mark69163/prodigy/Meetings/img/CarSensors-Art.webp

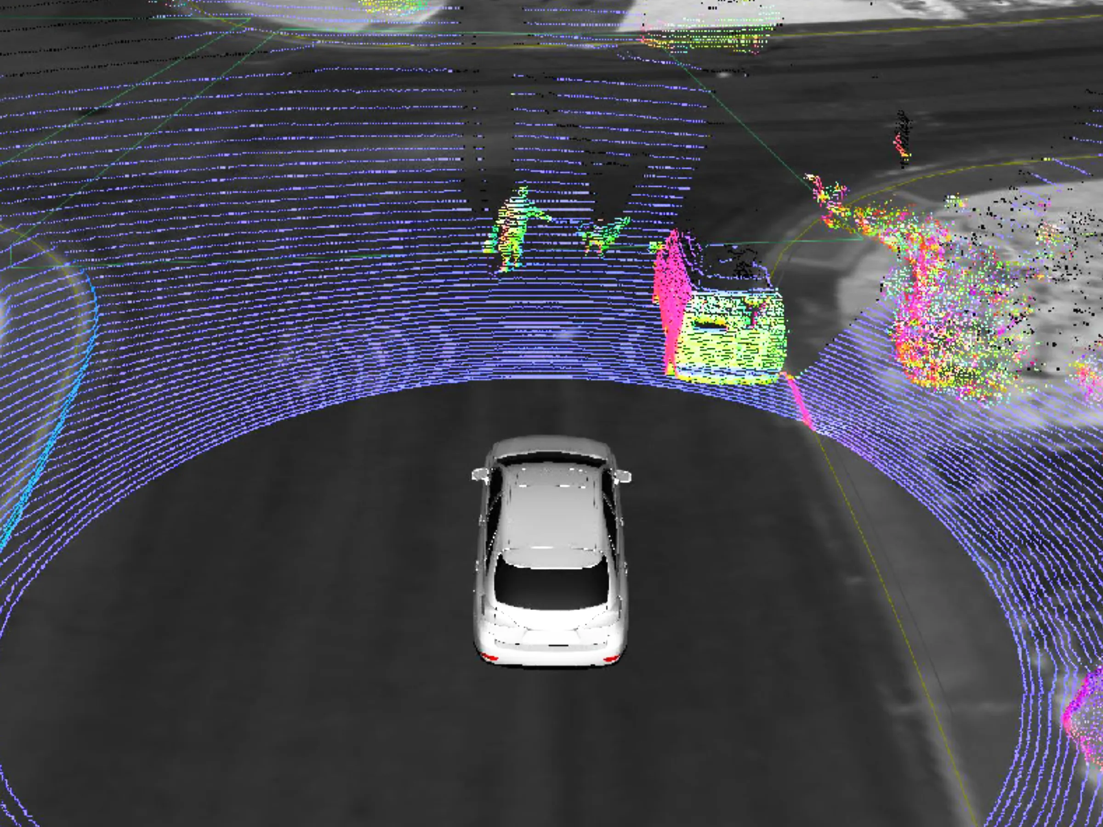
Meetings/img/CarSensors-Art.webp
