mark69163/prodigy/Meetings/img/expe_04.jpg

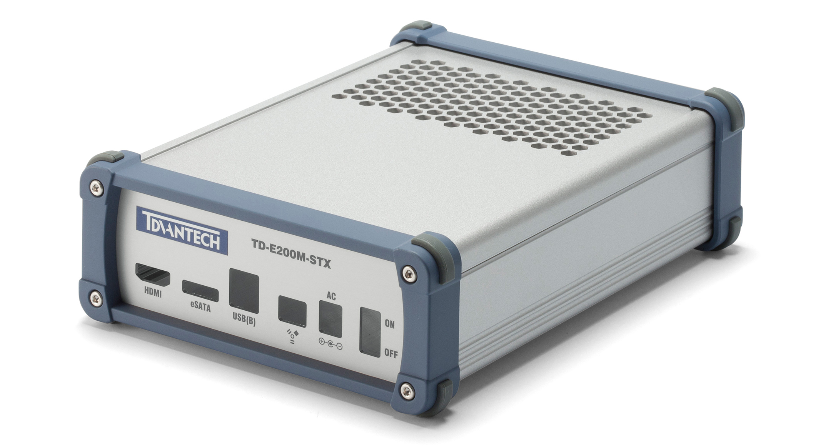
Meetings/img/expe_04.jpg
