mark69163/prodigy/Meetings/konzultacio_1.pptx

- Hardware látványterv és komponens szelekció

- PRODIGY oktatói panel
- 1. Konzultáció

Kovács Márk - Mérnökinformatikus

## 0. Agenda

1. Célkitűzés
2. Blokk diagram
3. Tervezési alapelvek
4. Komponens pozíciók
5. Időterv
6. Költségterv
7. Gyártás/rendelési info
8. Megjegyzések

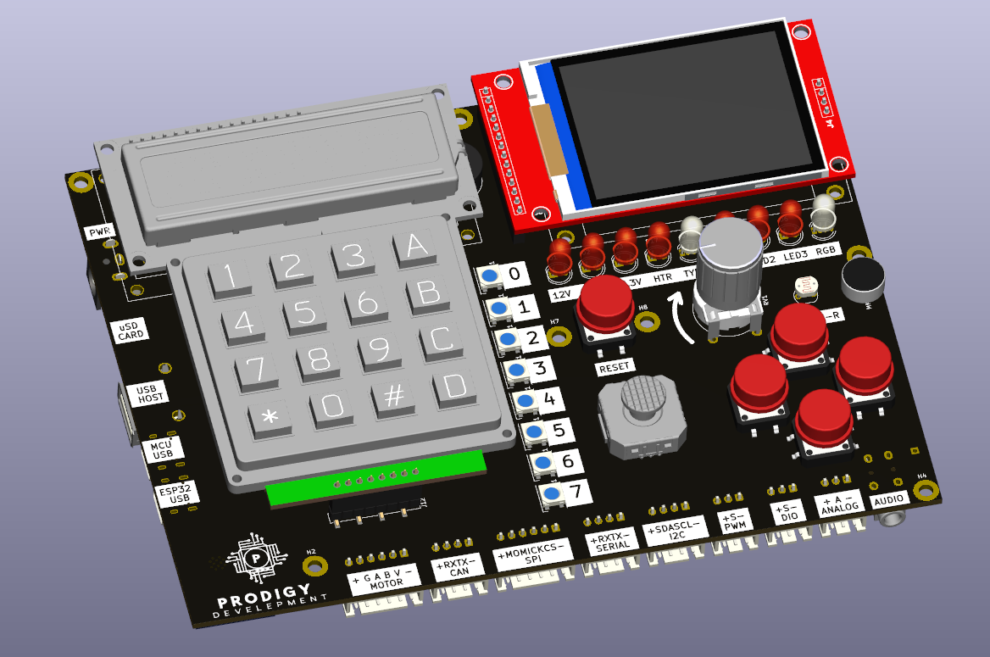
[picture p3: figure]

## 1. Célkitűzés

- Moduláris beágyazott rendszer fejlesztői platform
- Megbízhatóság, hallgató-barát kezelhetőség és biztonság
- B.sC. Szinten szükséges perifériák, interfészek, protokollok tesztelhetősége
- Új tanananyag tematika és megvalósítható projektek kidolgozása

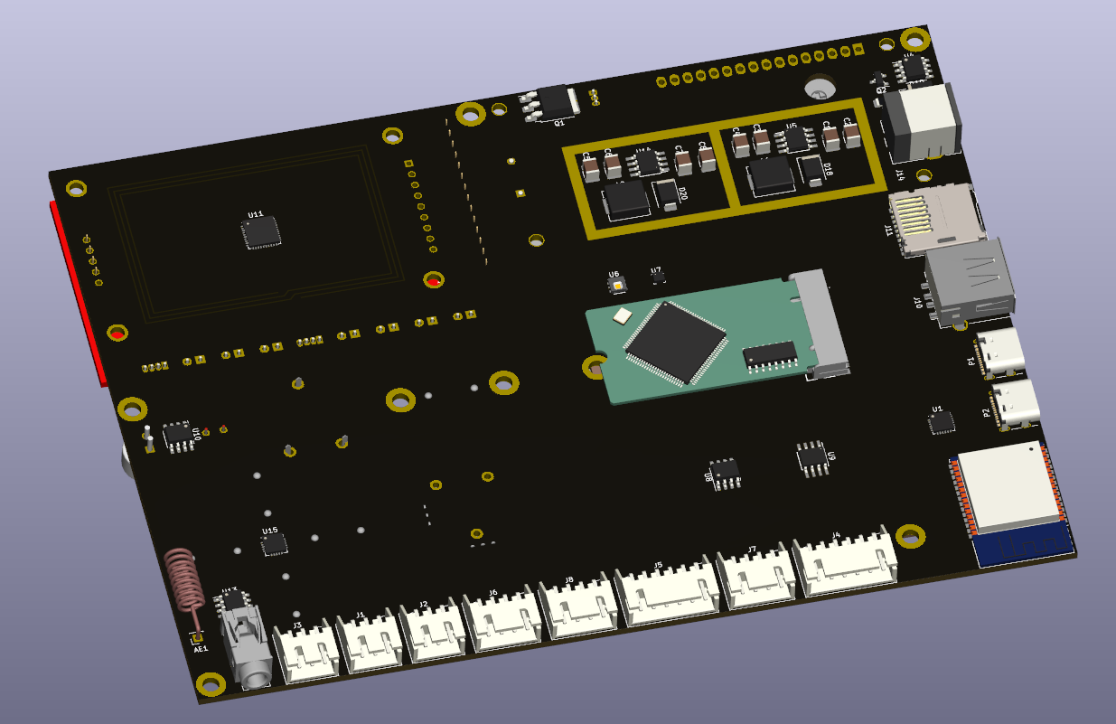
[picture p4: figure]

## 2. Blokk diagram

SPI

I²C

RADIO

TEMP.

LCD

OUTPUT

SERIAL

ESP32

USB-TTL

OUTPUT

64/52 PIN

MCU

SPECIAL

USB HOST

CAN_OUT

NEOPIXEL

MOTOR

DIGITAL

KEYPAD / BUTTON

LED

TEMP /
BUZZER

PWM / D
OUTPUT

ANALOG

POT.

LIGHT

SOUND

TEMP.
PID

OUTPUT

NFC

uSD

TFT SCREEN

ACCEL / GYRO

OUTPUT

4 PIN

2 PIN

23 PIN

5 PIN

9 PIN

9 PIN

## 4. Komponens pozíciók

BUZZER

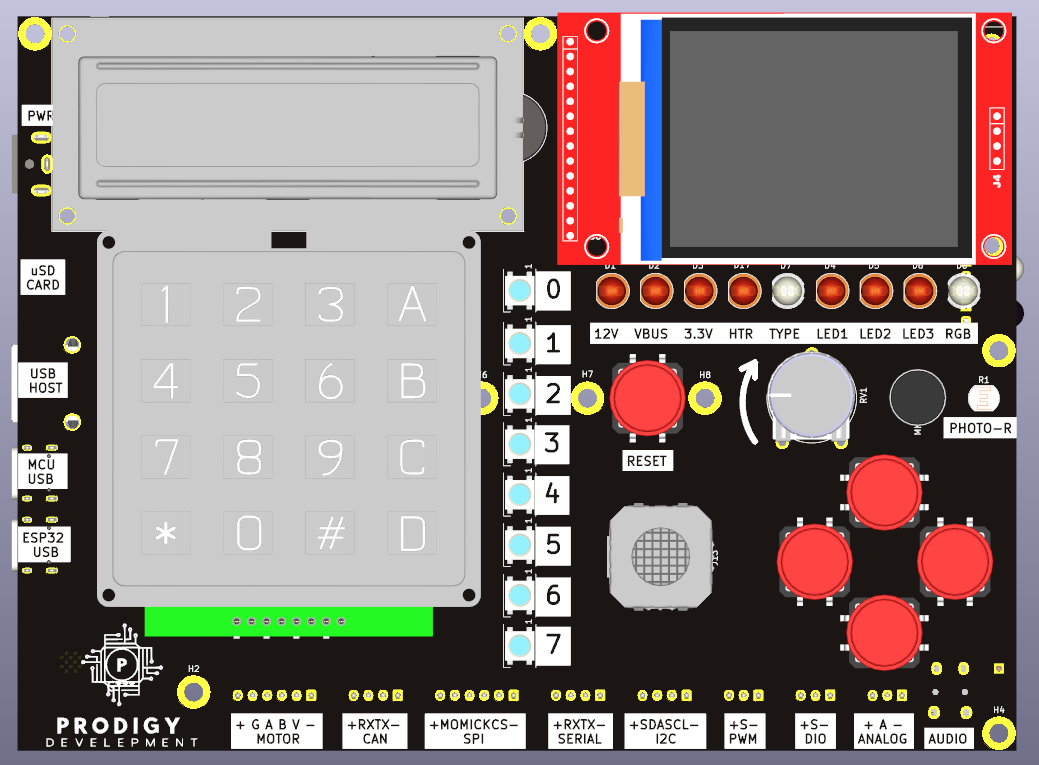
[picture p5: figure]

TFT TOUCH SCREEN

INFRARED LED

STATE / PROGRAM LEDS

MICROPHONE

I2C LCD

KEYPAD MATRIX

RESET BUTTON

POTENTIOMETER

PHOTORESISTOR

2 AXIS POT.

NEOPIXEL

GP BUTTON

## 4. Komponens pozíciók

HEATER (PWM)

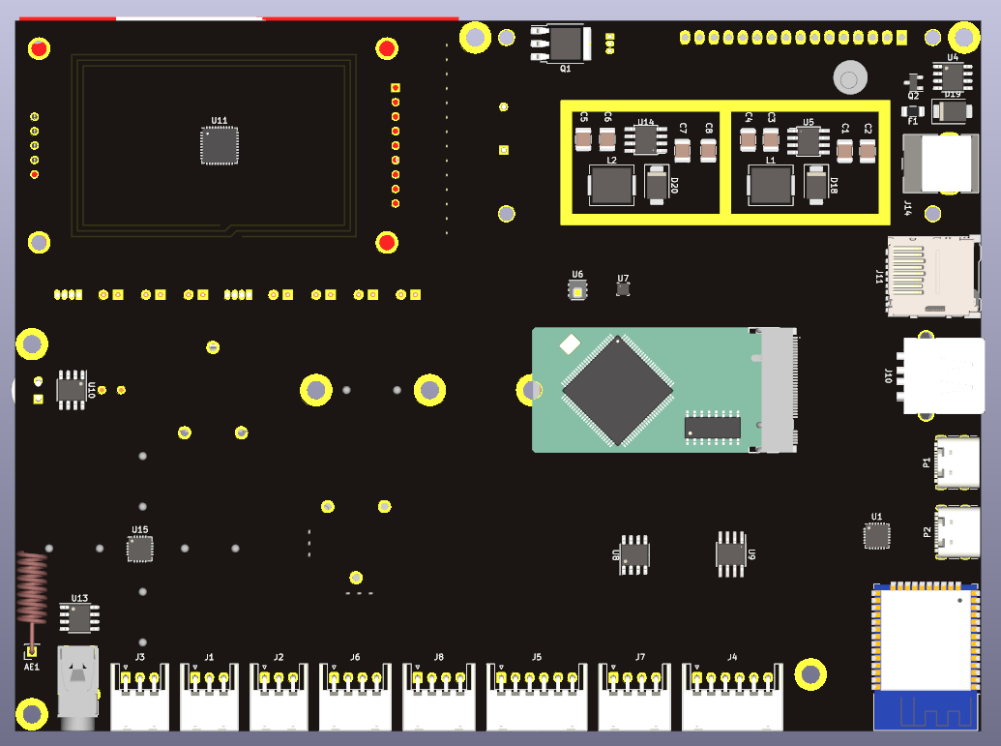
[picture p6: figure]

POWER SUPPLY

NFC

uSD CARD

ACCEL/GYRO

MCU w. BRIDGE

TEMPERATURE

UBS - HOST

AUDIO AMP.

UBS - MCU

RF-RADIO

MOTOR DRIVER

AUDIO AMP.

CAN DRIVER

ESP32
