mark69163/prodigy/Meetings/PRODIGY_Development_Platform_Concept.pdf

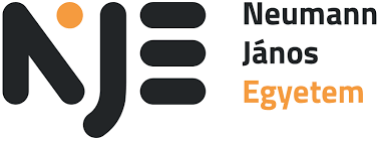
[picture p7: figure]

# A következő lépés a gyakorlat-orientált felsőoktatásban!

# PRODIGY

# - Az Univerzális Fejlesztői Platform

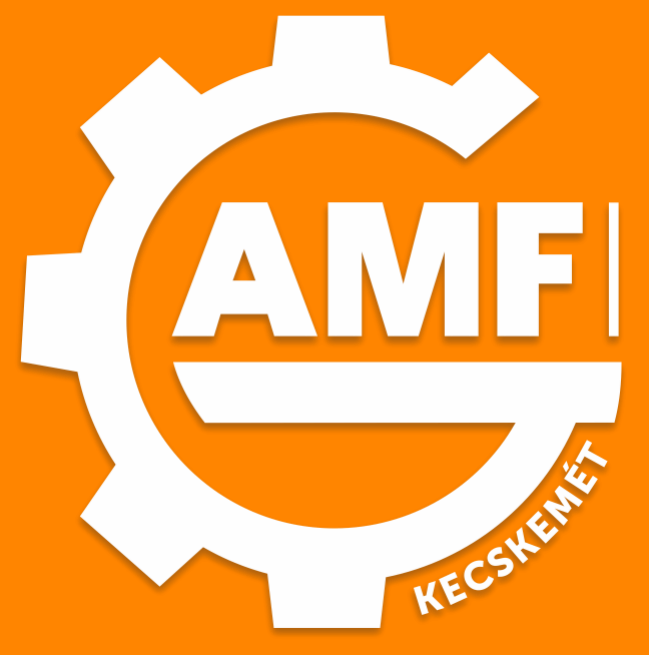
[picture p8: figure]

Kovács Márk - Mérnökinformatikus | 5/21/2024 | | 1

# Koncepció

# •Modularitás

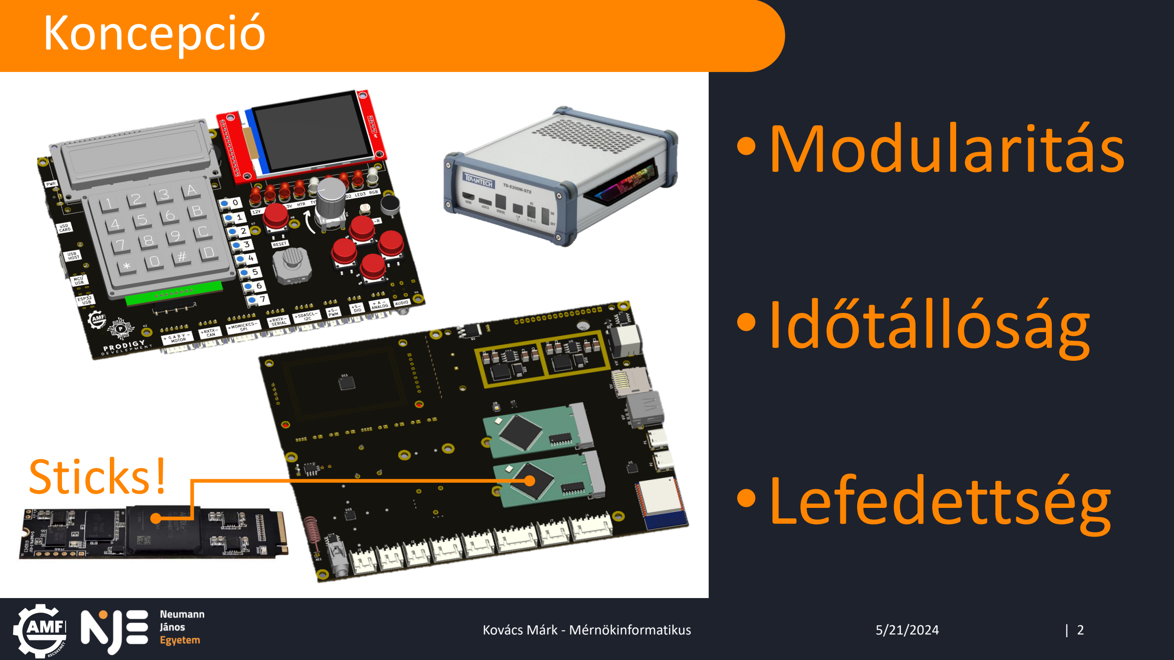
[picture p9: page 2]

# •Időtállóság

# •Lefedettség Sticks!

# Blokk diagramm

SPI | I
2C | SERIAL | SPECIAL | DIGITAL | ANALOG

## 64/64 PIN

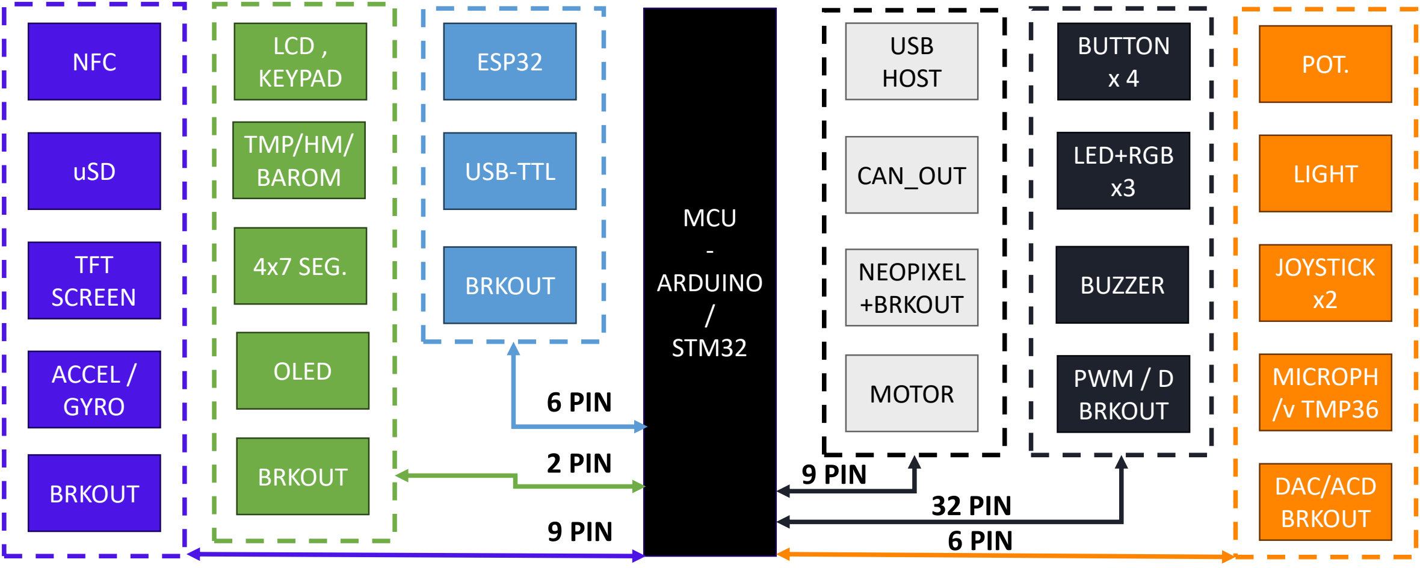
[picture p10: figure]
NFC; uSD; TFT SCREEN; BRKOUT; ACCEL / GYRO; ESP32; USB-TTL; POT.; LIGHT; JOYSTICK x2; MICROPH /v TMP36; DAC/ACD BRKOUT; BUTTON x 4; LED+RGB x3; NEOPIXEL +BRKOUT; CAN_OUT; MCU - ARDUINO / STM32; PWM / D BRKOUT; BUZZER; MOTOR; USB HOST; 9 PIN; 2 PIN; 6 PIN; 32 PIN 6 PIN; LCD , KEYPAD; OLED; TMP/HM/ BAROM; 4x7 SEG.

# Modul 0: - STM32 vagy ARDUINO

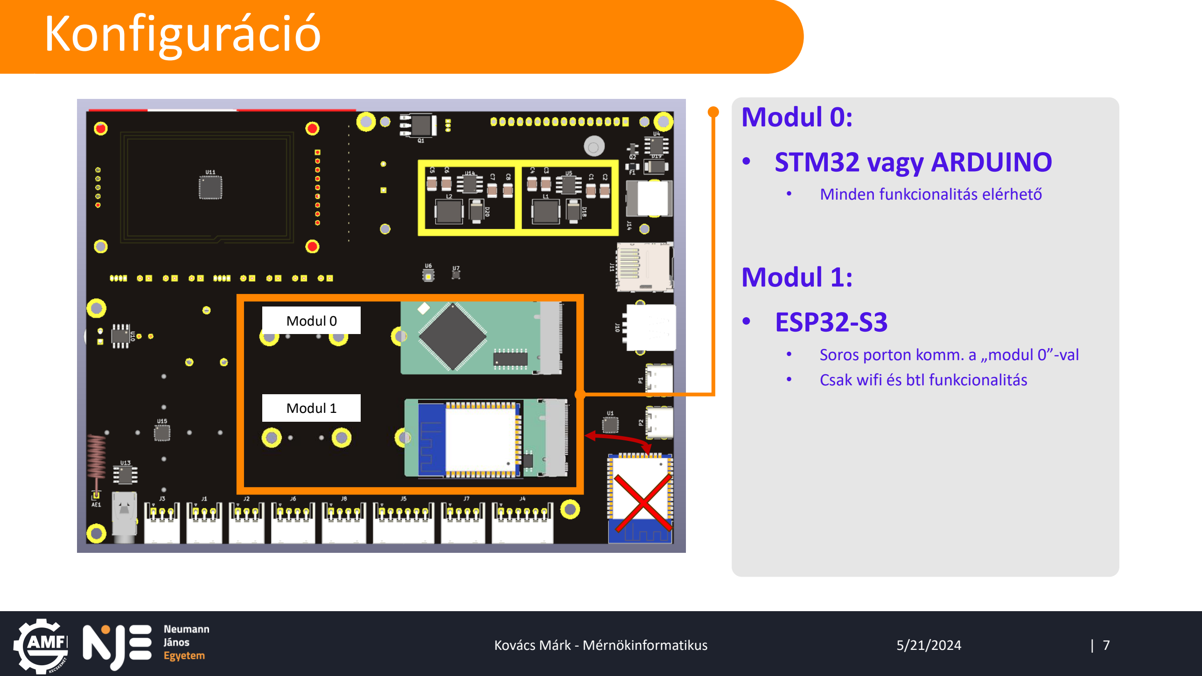
[picture p11: page 4]

- Minden funkcionalitás elérhető

# Modul 1: - ESP32-S3

- Soros porton komm. a „modul 0”-val
- Csak wifi és btl funkcionalitás

# Konfiguráció

Modul 0

Modul 1

# Komponens pozíciók

## BUZZER

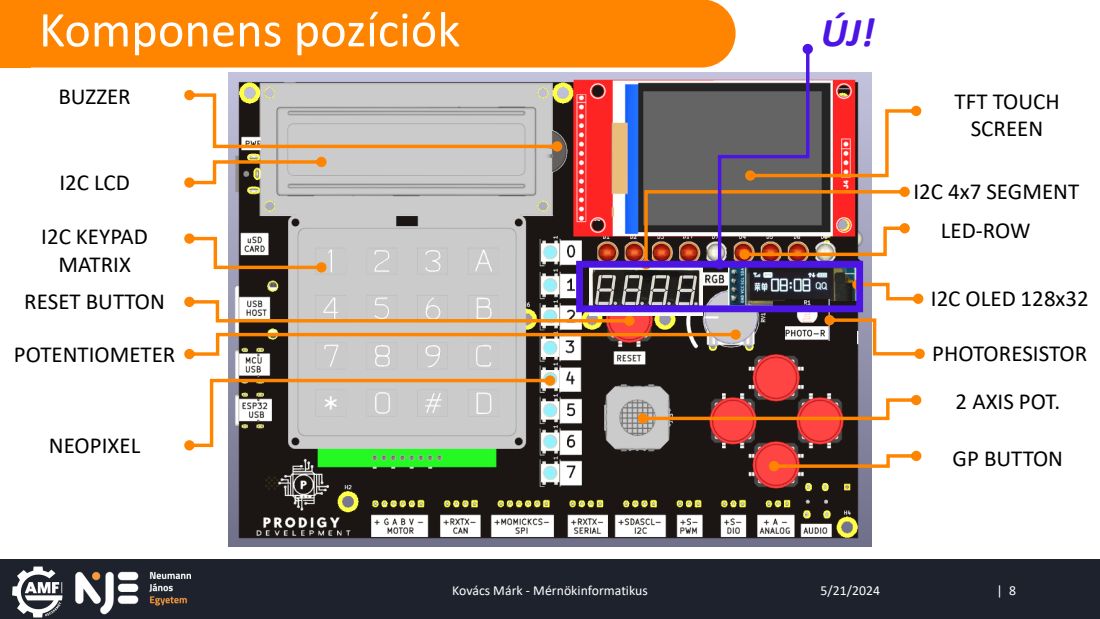
[picture p12: page 5]
I2C LCD; I2C KEYPAD MATRIX; NEOPIXEL; TFT TOUCH SCREEN; RESET BUTTON; I2C OLED 128x32; POTENTIOMETER; PHOTORESISTOR; 2 AXIS POT.; GP BUTTON; I2C 4x7 SEGMENT; LED-ROW
