mark69163/prodigy/Meetings/img/550.webp

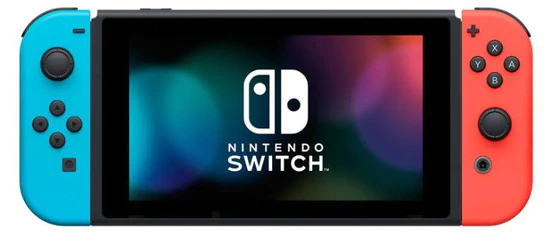
Meetings/img/550.webp
