mark69163/prodigy/Meetings/img/boston-dynamics-spot-e1634311618735.jpg

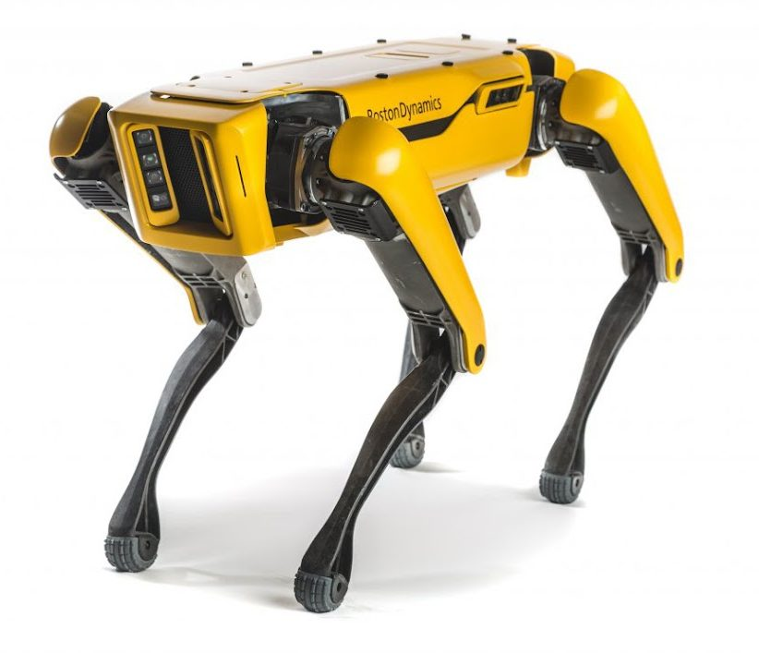
Meetings/img/boston-dynamics-spot-e1634311618735.jpg
