mark69163/prodigy/Meetings/img/breadboard_messy.webp

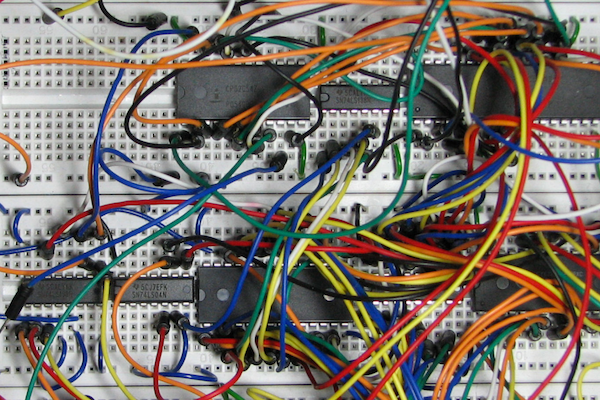
Meetings/img/breadboard_messy.webp
