mark69163/prodigy/Meetings/img/fundamental-teaching-bench-level-3-section-1__600x330.jpg

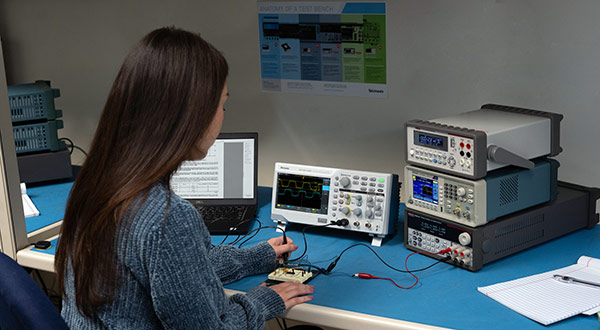
Meetings/img/fundamental-teaching-bench-level-3-section-1__600x330.jpg
