mark69163/prodigy/Meetings/img/myAVG-Jetson-Nano-robot-display-3D-depth-camera.webp

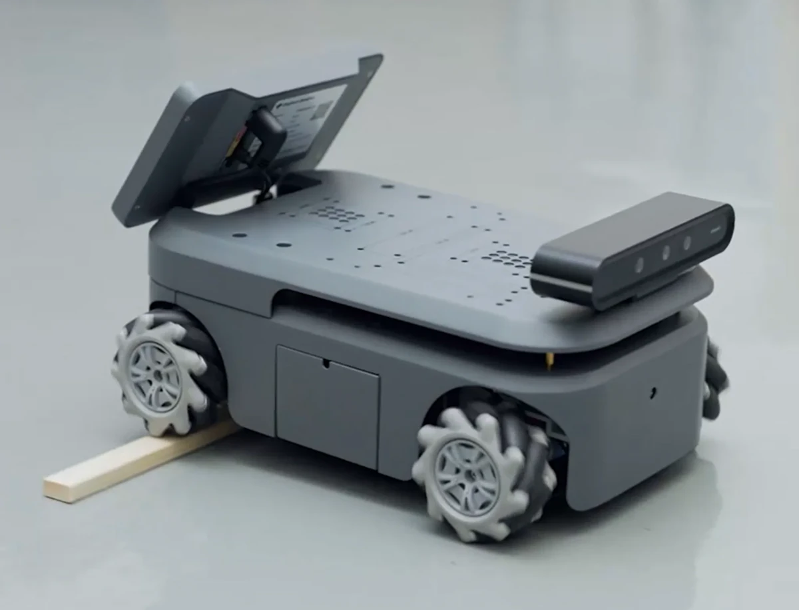
Meetings/img/myAVG-Jetson-Nano-robot-display-3D-depth-camera.webp
