mark69163/prodigy/PRODIGY-ATMEGA2560/Renderings/top-bot.png

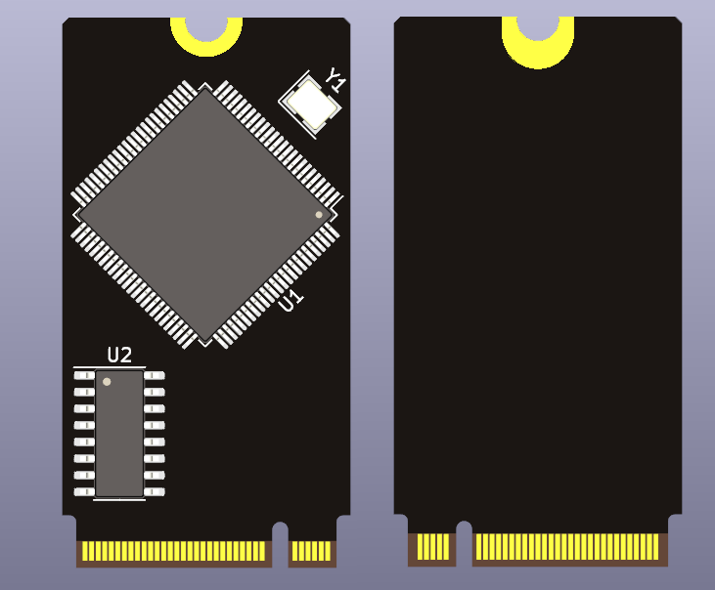
PRODIGY-ATMEGA2560/Renderings/top-bot.png
