mark69163/prodigy/PRODIGY-ESP32/Datasheets/d81e3b3904efa5ab045c113c9729518f1636dff9.png

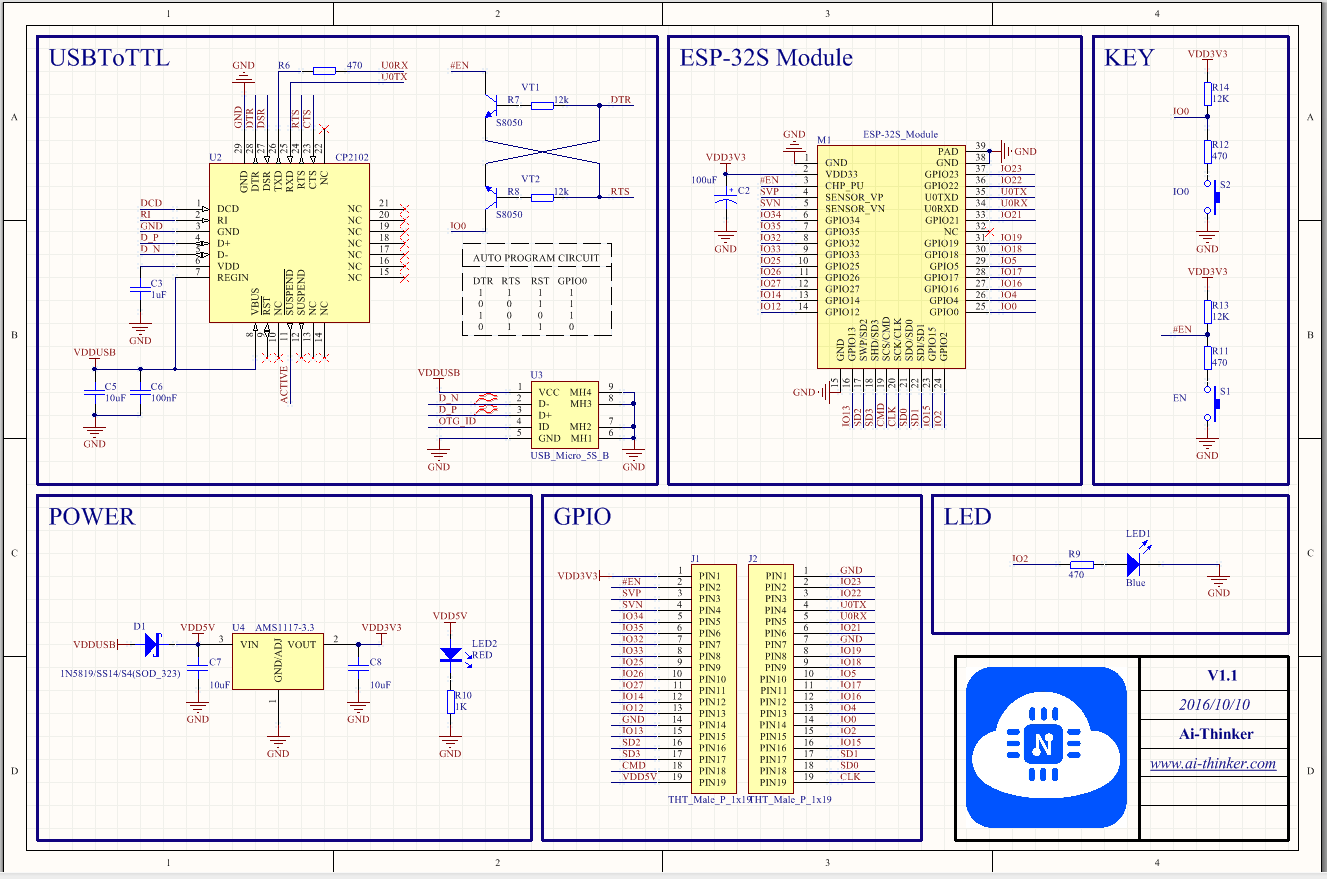
PRODIGY-ESP32/Datasheets/d81e3b3904efa5ab045c113c9729518f1636dff9.png
