mark69163/prodigy/PRODIGY-MOTHERBOARD/DATASHEETS/NFC/2-Figure2-1.png

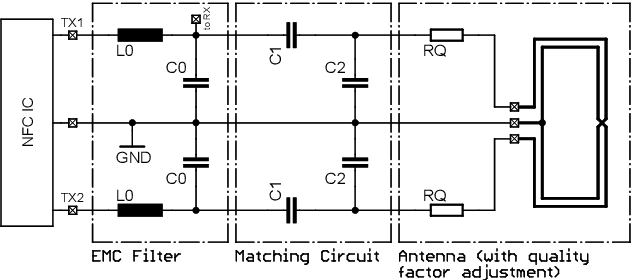
PRODIGY-MOTHERBOARD/DATASHEETS/NFC/2-Figure2-1.png
