mark69163/prodigy/PRODIGY-MOTHERBOARD/DATASHEETS/sd/sd_pinout1-300x208.png

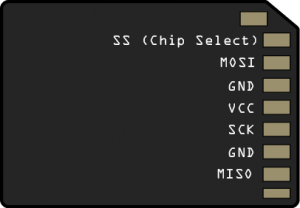
PRODIGY-MOTHERBOARD/DATASHEETS/sd/sd_pinout1-300x208.png
