mark69163/prodigy/PRODIGY-MOTHERBOARD/DATASHEETS/usb/GUID-7969514A-FFDA-4094-BF8C-E40C1A1D4E4F-low.jpg

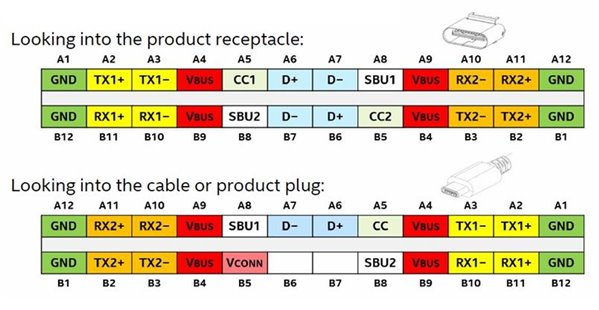
PRODIGY-MOTHERBOARD/DATASHEETS/usb/GUID-7969514A-FFDA-4094-BF8C-E40C1A1D4E4F-low.jpg
