mark69163/prodigy/PRODIGY-MOTHERBOARD/DATASHEETS/usb/NG3Em.png

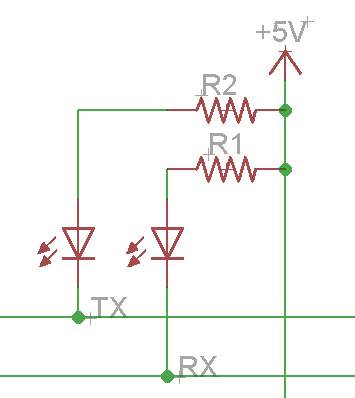
PRODIGY-MOTHERBOARD/DATASHEETS/usb/NG3Em.png
