mark69163/prodigy/PRODIGY-MOTHERBOARD/graphics/gamf.png

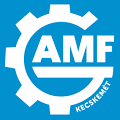
PRODIGY-MOTHERBOARD/graphics/gamf.png
