mark69163/prodigy/PRODIGY-MOTHERBOARD/RENDERINGS/bot_isometric_transparent.png

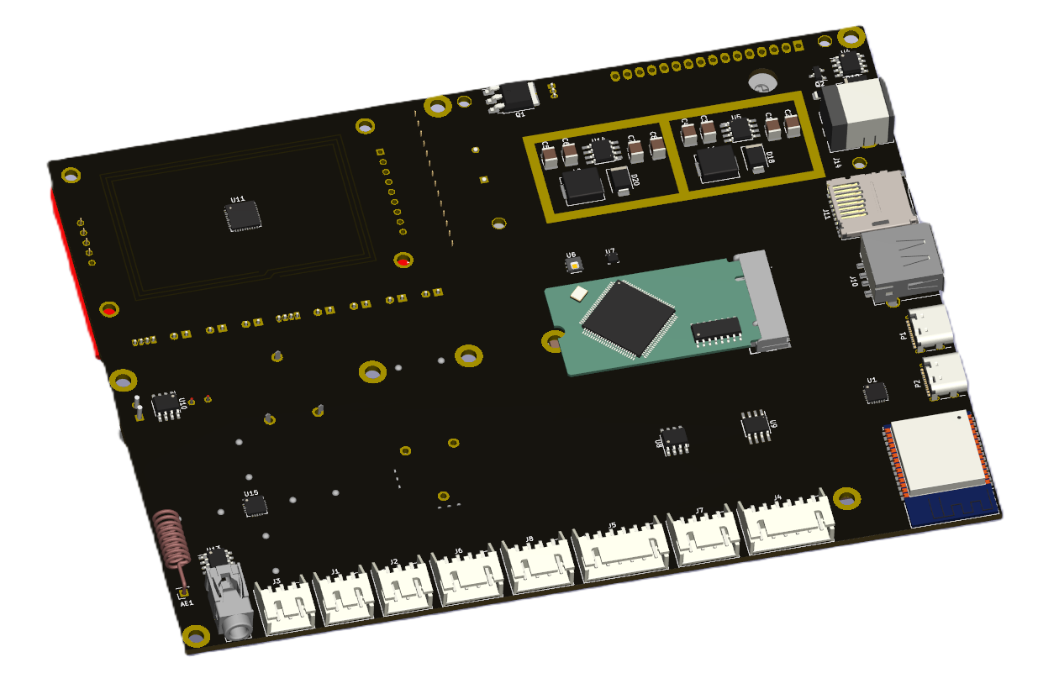
PRODIGY-MOTHERBOARD/RENDERINGS/bot_isometric_transparent.png
