mark69163/prodigy/PRODIGY-MOTHERBOARD/RENDERINGS/bot_isometric_upgrade_transparent.png

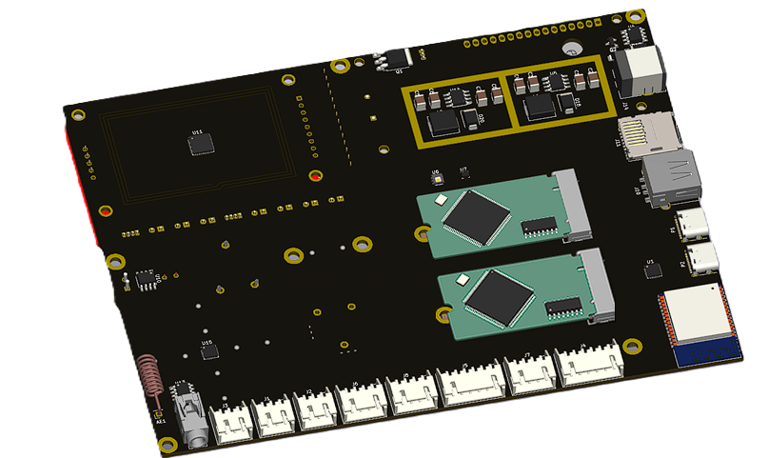
PRODIGY-MOTHERBOARD/RENDERINGS/bot_isometric_upgrade_transparent.png
