mark69163/prodigy/PRODIGY-MOTHERBOARD/RENDERINGS/Screenshot 2024-06-20 193029.png

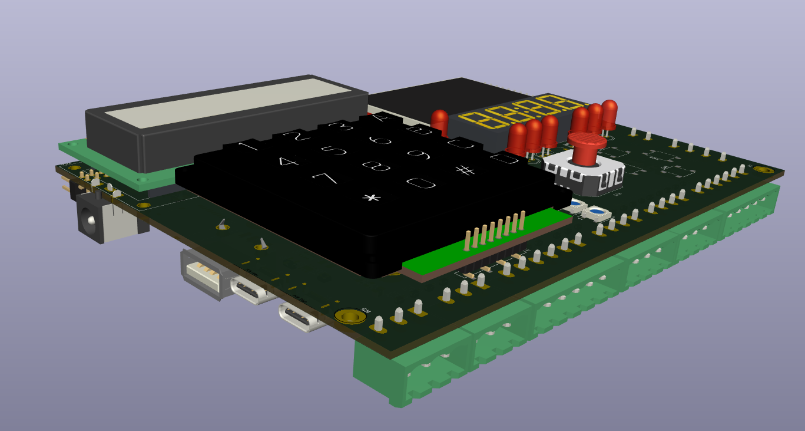
PRODIGY-MOTHERBOARD/RENDERINGS/Screenshot 2024-06-20 193029.png
