mark69163/prodigy/PRODIGY-MOTHERBOARD/RENDERINGS/Screenshot 2024-06-20 193114.png

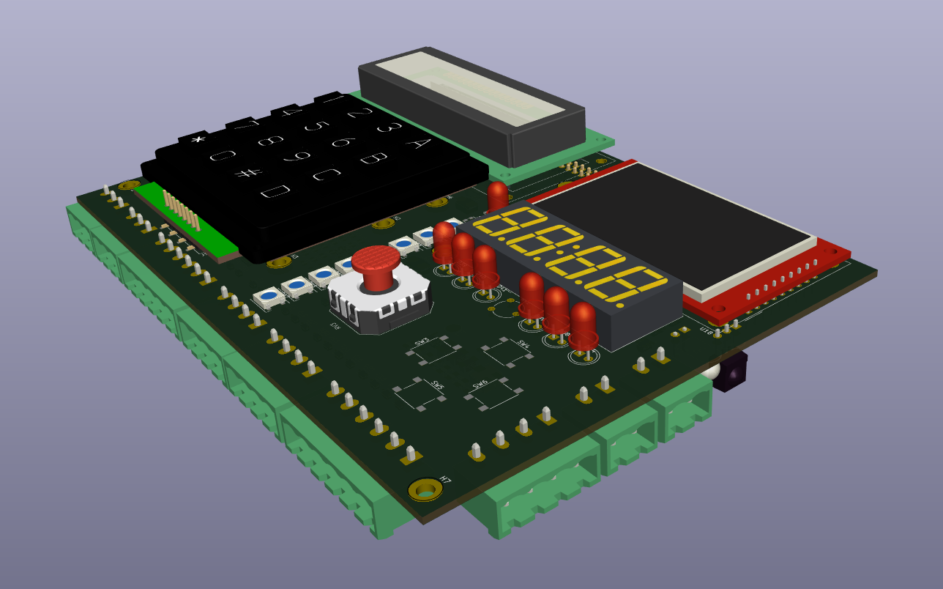
PRODIGY-MOTHERBOARD/RENDERINGS/Screenshot 2024-06-20 193114.png
