mark69163/prodigy/PRODIGY-MOTHERBOARD/RENDERINGS/Screenshot 2024-06-26 191606.png

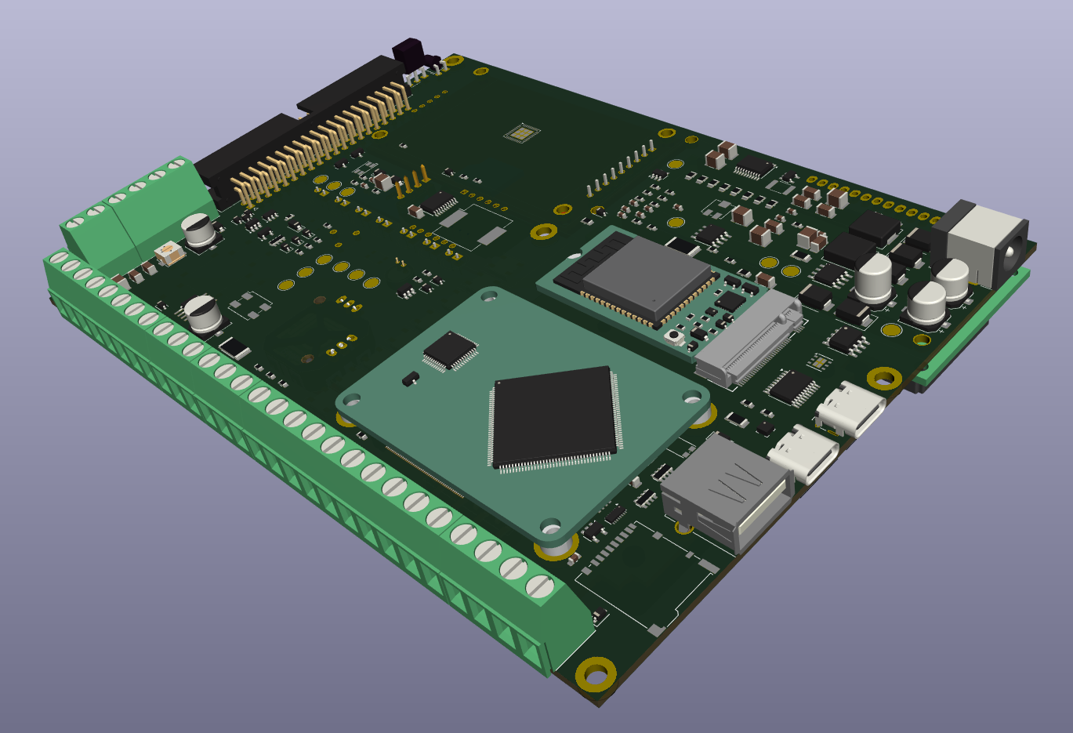
PRODIGY-MOTHERBOARD/RENDERINGS/Screenshot 2024-06-26 191606.png
