mark69163/prodigy/PRODIGY-MOTHERBOARD/RENDERINGS/Screenshot 2024-08-21 175349.png

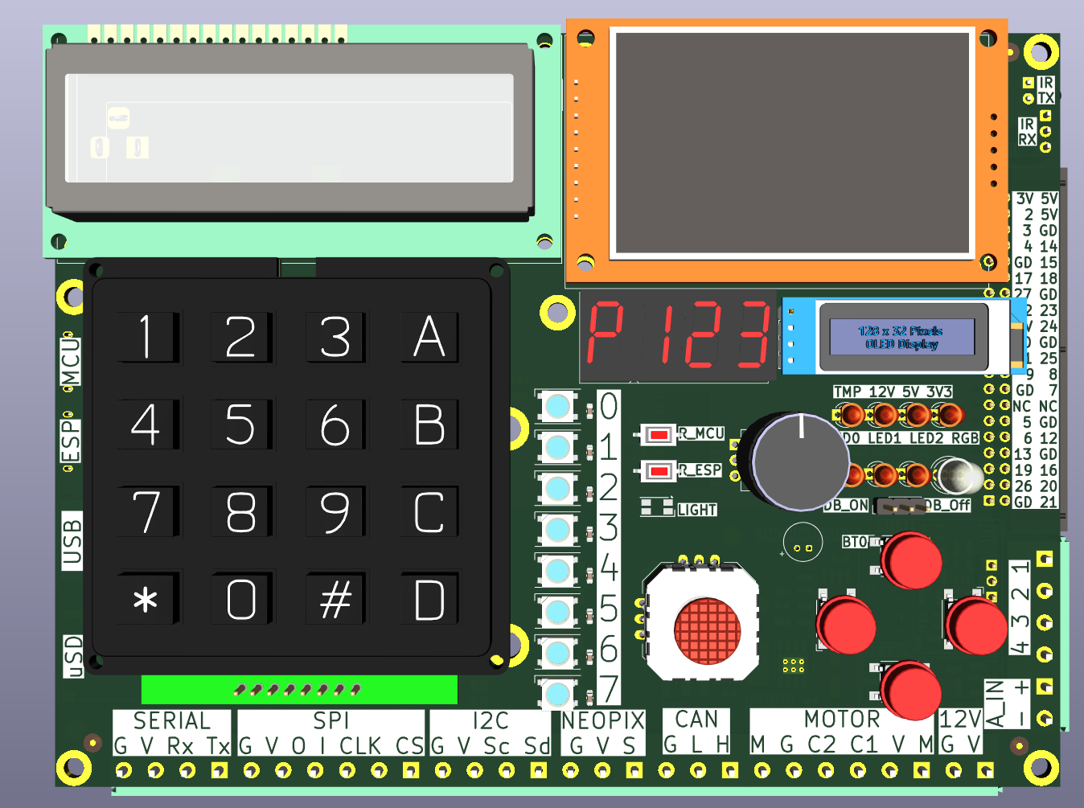
PRODIGY-MOTHERBOARD/RENDERINGS/Screenshot 2024-08-21 175349.png
