mark69163/prodigy/PRODIGY-MOTHERBOARD/RENDERINGS/Screenshot 2024-11-14 172310.png

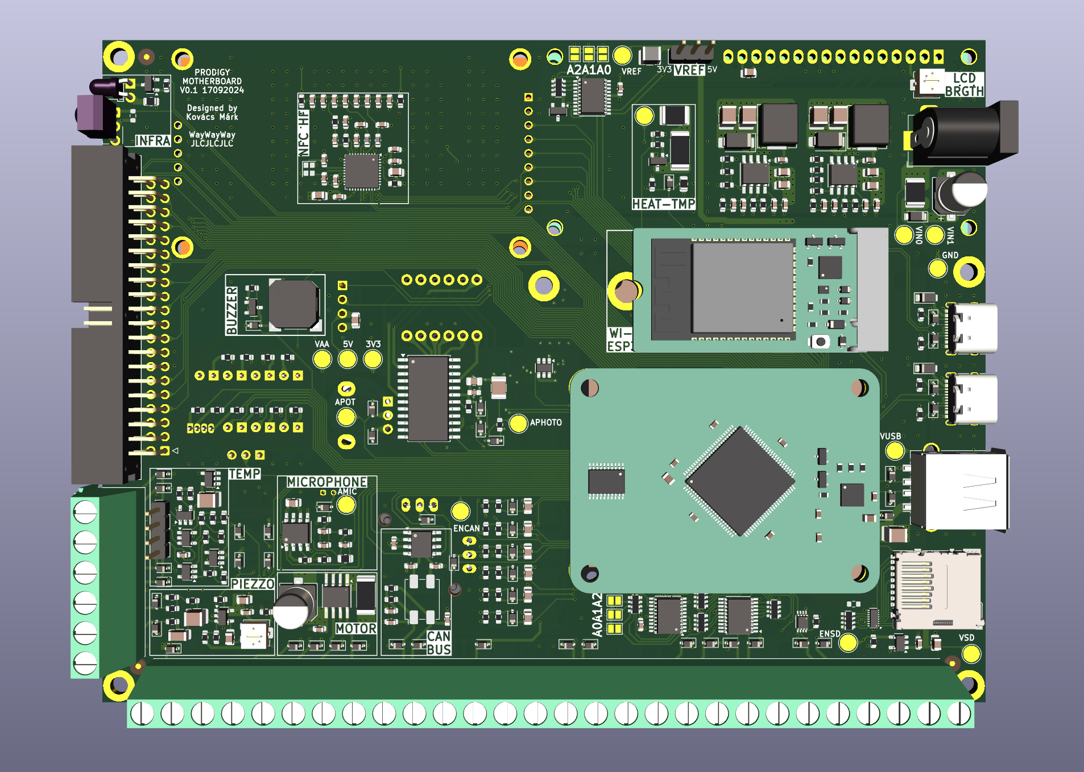
PRODIGY-MOTHERBOARD/RENDERINGS/Screenshot 2024-11-14 172310.png
