mark69163/prodigy/PRODIGY-MOTHERBOARD/RENDERINGS/Screenshot 2024-11-14 172731.png

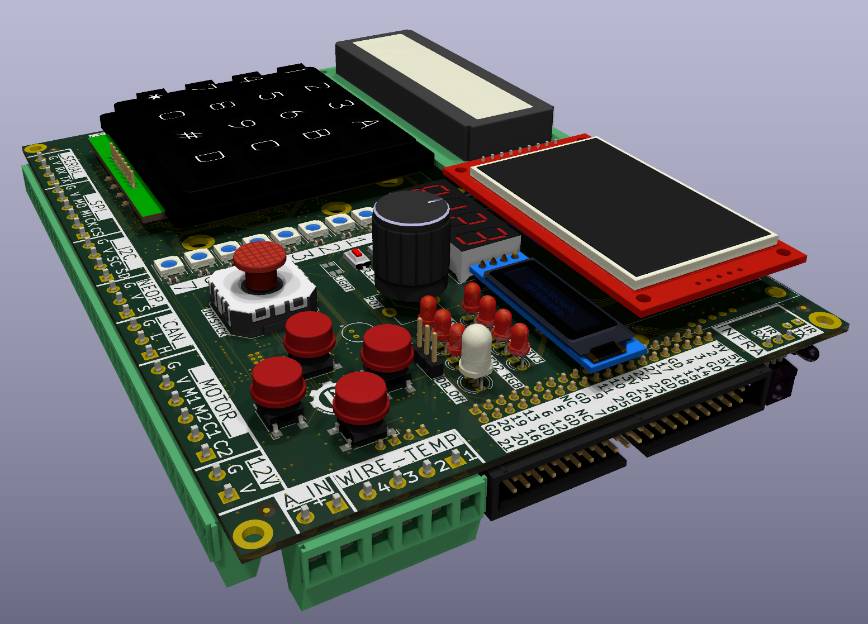
PRODIGY-MOTHERBOARD/RENDERINGS/Screenshot 2024-11-14 172731.png
