mark69163/prodigy/PRODIGY-MOTHERBOARD/RENDERINGS/Screenshot 2024-11-14 172812.png

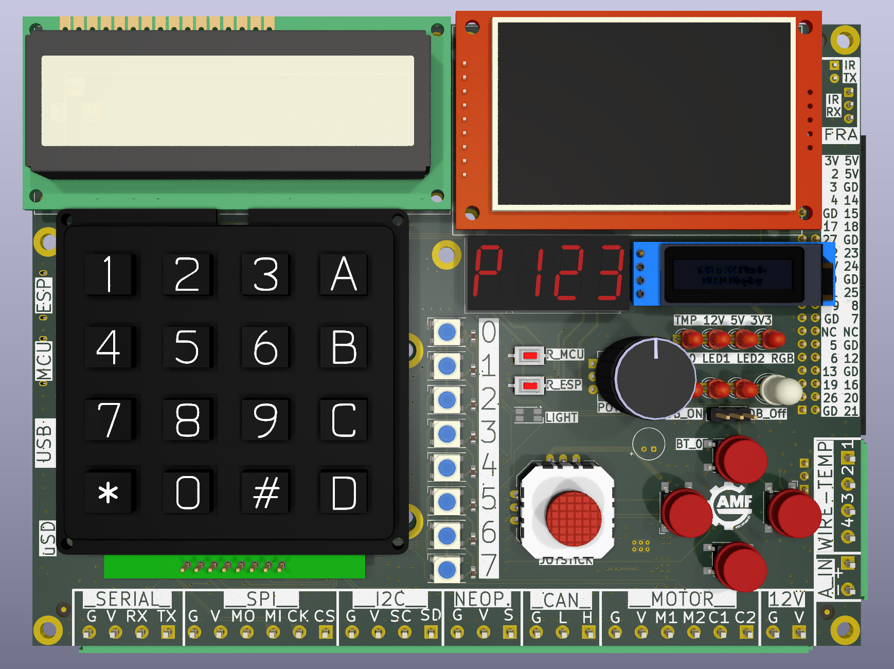
PRODIGY-MOTHERBOARD/RENDERINGS/Screenshot 2024-11-14 172812.png
