mark69163/prodigy/PRODIGY-MOTHERBOARD/RENDERINGS/top_isometric_transparent.png

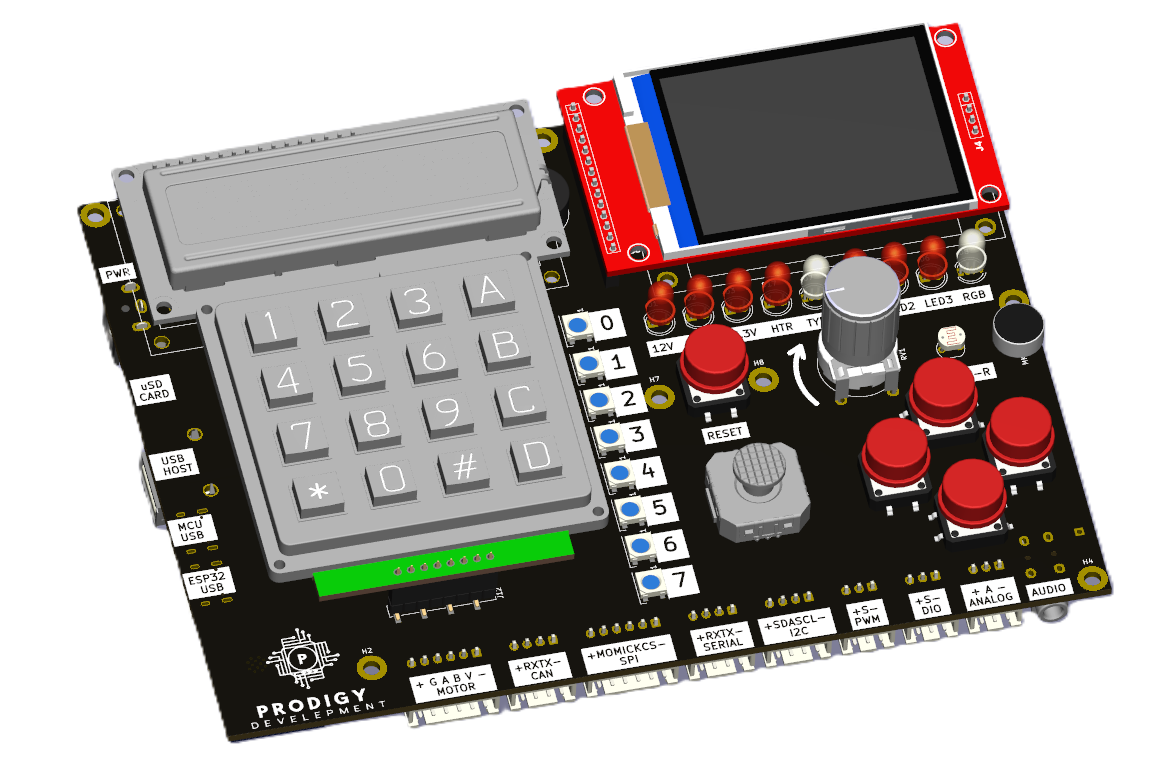
PRODIGY-MOTHERBOARD/RENDERINGS/top_isometric_transparent.png
