mark69163/prodigy/PRODIGY-STM32/Datasheets/Screenshot 2024-06-26 165652.png

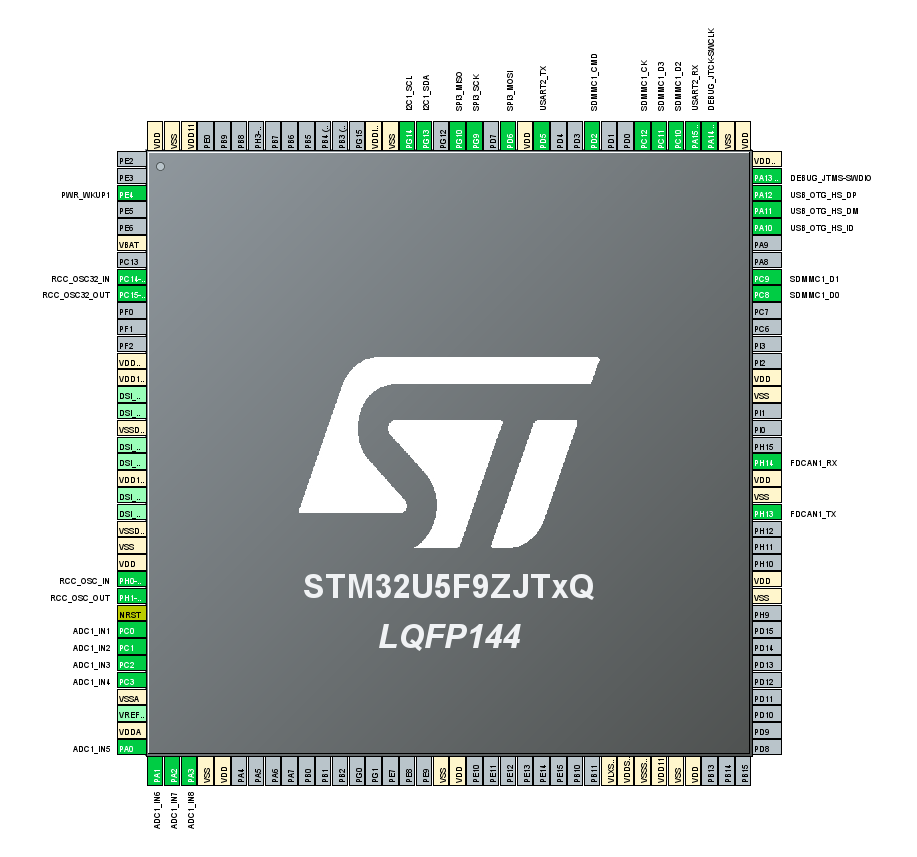
PRODIGY-STM32/Datasheets/Screenshot 2024-06-26 165652.png
