mark69163/prodigy/PRODIGY-STM32/Datasheets/st_link_v2.png

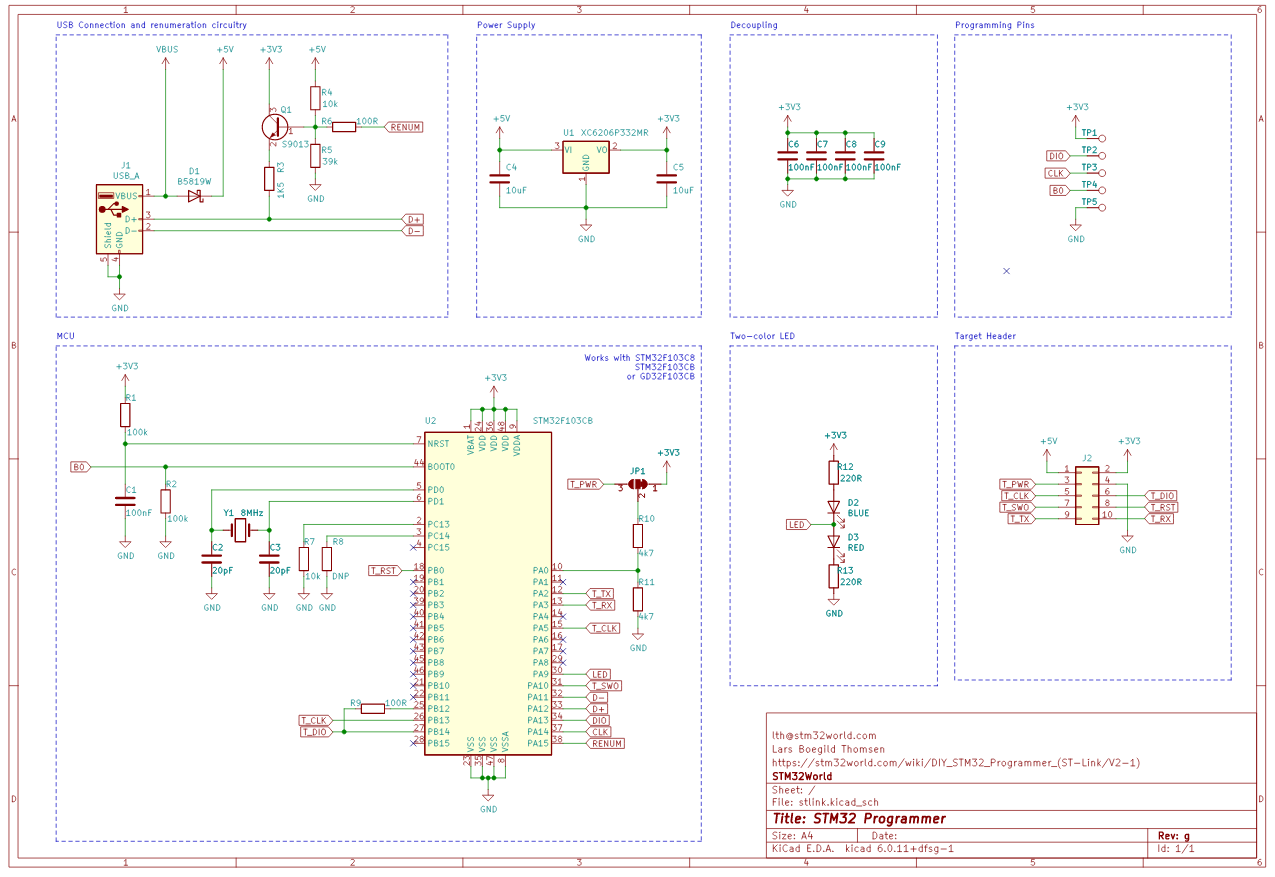
PRODIGY-STM32/Datasheets/st_link_v2.png
