mark69163/prodigy/Calculations/PRODIGY_BOM_V0.2.xlsx

Sheet: BOM
JELOLES | BESZALLITO | DARABSZAM
CL21A475KAQNNNG | TME | 24
GRM32ER61C476KE15L | TME | 16
EEEFPV101XAP | TME | 4
CL10B104KB8NNNC | TME | 106
06035C103JAT2A | TME | 4
0603B102K500CT | TME | 4
06031C472KAT2A | TME | 4
06035A470JAT2A | TME | 2
06035A390JAT2A | TME | 2
0603N101J500CT | TME | 12
CL21A106KOQNNNE | TME | 30
0603N220J500CT | TME | 8
CL10C221JB8NNNC | TME | 4
CC0603BRNPO9BN4R7 | TME | 16
CL21A226MPQNNNE | TME | 2
GCM188R71E474KA64D | TME | 4
0603N100J500CT | TME | 10
GRM31C5C1H104JA01L | TME | 2
SD05.TCT | TME | 88
1N4148WSTR-SMC | TME | 14
PMEG4030ER.115 | TME | 6
B340A-E3/61T | TME | 4
L-934LGD | TME | 8
WS2812B-V5 | TME | 16
LL-304PDD2E | TME | 2
L-934ID | TME | 6
LL-509RGBC2E-004 | TME | 2
RC1602B-BIW-ESV | TME | 2
0ZCF0200AF2C | TME | 2
0ZCG0075FF2C | TME | 2
DF40C-100DS-0.4V51 | TME | 4
ZL231-40KG | TME | 2
FC68148 | TME | 2
123A-58B00 | TME | 2
DG308-2.54-02P | TME | 18
M20-8770842 | TME | 2
ZL262-4SG | TME | 2
DM3BT-DSF-PEJS/C | TME | 2
ZL211-40KG | TME | 2
JUMPER-H/R | TME | 2
JUMPER-H/B | TME | 4
NLCV32T-101K-EF | TME | 2
HPI0630-6R8 | TME | 4
ACM7060-701-2PL-TL | TME | 2
MLF1608DR56JT | TME | 4
BC850B-DIO | TME | 16
BSS316NH6327XTSA1 | TME | 2
KPS-3227SP1C | TME | 2
WR06X1002FTL | TME | 76
AC0603FR-075K1L | TME | 8
ERJ3EKF3303V | TME | 4
ERJ3EKF6802V | TME | 6
ERJ3EKF3302V | TME | 4
AR0603-50K-0.1% | TME | 2
AC0603FR-072K2L | TME | 2
RC0603JR-071K | TME | 38
ERJ3EKF6800V | TME | 2
ERJ3EKF2200V | TME | 2
ERA3AEB59R0V | TME | 4
SWR2512-2R-5% | TME | 2
ERJ3EKF2203V | TME | 10
CRCW06034K70FKTABC | TME | 14
ERA3AEB272V | TME | 2
WF06P-3R3-5% | TME | 4
SMD0603-100R | TME | 10
AR0805-39R-0.1% | TME | 2
CRCW251222R0FKTHBC | TME | 2
ERJ3GEYJ473V | TME | 2
ERA6AEB105V | TME | 2
WR06X1501FTL | TME | 4
ERA3AEB332V | TME | 2
DR1206-10K-4/8 | TME | 10
3314J-1-103E | TME | 2
R9011-1-1K | TME | 2
3314J-1-202E | TME | 2
KMR231GLFS | TME | 6
B3FS-1050 | TME | 8
NTCS0805E3103JHT | TME | 2
TPS54331DR | TME | 4
TJA1051T/E.118 | TME | 2
DRV8870DDAR | TME | 2
PCA9306DCTR | TME | 4
SN74LVC1T45DBVR | TME | 4
PCF8574TS/3.118 | TME | 4
TXS0108EPWR | TME | 4
MAX7219CWG+ | TME | 2
FYQ-3641AUHR-21 | TME | 2
TSOP4836 | TME | 2
NE5532ADR | TME | 2
MCP6021RT-E/OT | TME | 2
XRCGB27M120F3M00R0 | TME | 2
SMD0603-0R | TME | 8
ESP32S3-WRM1-16R8 | TME | 2
FT231XQ-R | TME | 4
DF40C-100DP-04V-51 | TME | 8
ATMEGA2560V-8AU | TME | 2
8.00M-CFPX104 | TME | 6
32.768K-CFPX217 | TME | 2
M24C32-WMN6TP | TME | 2
STM32F407VGT6 | TME | 2
STM32F103C8T6 | TME | 2
AP2112K-3.3TRG1 | TME | 2
CRCW0603100KJNTABC | TME | 4
0603N2R7C500CT | TME | 4
CL21B225KOFNNNE | TME | 4
OF-SMD2012B | TME | 2
E2412W2E | TME | 2
OF-SMD2012R | TME | 2
490-CMT-9504-87SMTTR | MOUSER | 2
523-GSB1C411111DS1HR | MOUSER | 4
649-87583-0010RHLF | MOUSER | 2
497-MO093803-1 | MOUSER | 2
485-2765 | MOUSER | 2
835-RT9742AGJ5F | MOUSER | 4
595-HDC1080DMBR | MOUSER | 2
511-LIS2DH12TR | MOUSER | 2
771-PN5321A3HNC10 | MOUSER | 2
926-LMP2011MFX/NOPB | MOUSER | 8
926-LM4125IM525NOPB | MOUSER | 2
771-IP4252CZ168TTL1 | MOUSER | 2
595-S3USB221AQRSERQ1 | MOUSER | 2

Sheet: KELLEKEK
JELOLES | BESZALLITO | DARABSZAM | MEGJEGYZES | LINK
12V68RPM | ALIEXPRESS | 2 | single shaft / axis | link (https://www.aliexpress.com/item/1005005127362108.html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)
0.91 Inch OLED Module | ALIEXPRESS | 2 | WHITE | link (https://www.aliexpress.com/item/32798439084.html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)
320X240 ILI9341 | ALIEXPRESS | 2 | 2.2 inch SPI LCD | link (https://www.aliexpress.com/item/1005006092135856.html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)
4*4 Matrix Switch | ALIEXPRESS | 2 | 4x4 | link (https://www.aliexpress.com/item/4000873237364.html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)
