mark69163/prodigy/Calculations/PRODIGY_v0_BOM.xlsx

Sheet: v2
Megnevezés | db | Összes db | Leírás | Egységár (nettó) | Nettó összár | LINK | db: | 40 | sum | 1122878 Ft
LCD1602 + I2C | 1 | 40 |  | 800 Ft | 32000 Ft | https://www.aliexpress.com/item/32763867041.html?curPageLogUid=mEYzrvCAzbyJ
2.4" SPI TFT LCD touch screen ILI9488 | 1 | 40 |  | 2300 Ft | 92000 Ft | https://www.aliexpress.com/item/33015586094.html?scm_id=1007.40000.327270.0&scm-url=1007.40000.327270.0
4*4 Matrix Switch Keyboard Keypad Array Module ABS Plastic Keys | 1 | 40 | 4x4 | 900 Ft | 36000 Ft | https://www.aliexpress.com/item/1005002804089482.html?curPageLogUid=u6p1vElqdttM
ESP32 S3 wroom 1 N16R2 | 1 | 40 | 3-WROOM-1-N16R8 | 1400 Ft | 56000 Ft | https://www.aliexpress.com/item/1005004815894336.html?curPageLogUid=gnOhPkFfR4eW
HDC1080DMBR | 1 | 40 |  | 235 Ft | 9400 Ft | HDC1080DMBR | Texas Instruments | Temperature And Humidity Sensor | JLCPCB (https://jlcpcb.com/partdetail/TexasInstruments-HDC1080DMBR/C82227)
SR PASSIVES NTCC-10K | 1 | 40 | NTC termisztor; 10kΩ; THT | 75 Ft | 3000 Ft
TOKEN PGM5516-MP | 1 | 40 | Fotoellenállás; 90mW; 5÷10kΩ; 540nm; | 163 Ft | 6520 Ft
12x12mm SPST Tactile Switch | 5 | 200 | TS-1003ST-26 | 18.11 Ft | 3622 Ft | https://jlcpcb.com/partdetail/Xunpu-TS_1003ST26/C455234
5mm green led | 3 | 120 |  | 25.4 Ft | 3048 Ft
5mm red led | 3 | 120 |  | 25 Ft | 3000 Ft | L-53ID KINGBRIGHT ELECTRONIC - LED | 5mm; piros; 12,5÷80mcd; 60°; Front: domború; 2÷2,5V | TME Hungary Kft. - Elektronikai alkatrészek (https://www.tme.eu/hu/details/l-53id/led-tht-kerek-diodak/kingbright-electronic/)
MEGA 2560 PRO Embed CH340G/ATMEGA2560-16AU Chip with male pinheaders Compatible for Arduino Mega2560 for arduino | 1 | 40 | CH340 vagy 16u2???? | 5000 Ft | 200000 Ft
DM3BT-DSF-PEJS | 1 | 40 | microSD | 571 Ft | 22840 Ft | DM3BT-DSF-PEJS | HRS(Hirose) | SD Card Connectors | JLCPCB (https://jlcpcb.com/partdetail/hrs_hirose-DM3BT_DSFPEJS/C597972)
Poti trimmer 100k | 1 | 40 |  | 80.2 Ft | 3208 Ft | PT15NV02104A2020S PIHER - Potenciométer: beépíthető | egyfordulatú,fekvő; 100kΩ; 250mW; ±20%; PT15NV-100K | TME Hungary Kft. - Elektronikai alkatrészek (https://www.tme.eu/hu/details/pt15nv-100k/egyfordulatu-tht-trimmerek/piher/pt15nv02104a2020s/)
poti tengely | 1 | 40 |  | 138 Ft | 5520 Ft | 5214 PIHER - Gombok | szabályzó henger; fekete; Ø6x19mm; PT15N; B: 9mm; PT15GW-19 | TME Hungary Kft. - Elektronikai alkatrészek (https://www.tme.eu/hu/details/pt15gw-19/trimmer-gombok/piher/5214/)
FM Receiver Module Silicon SI4702 Chip | 1 | 40 |  | 1000 Ft | 40000 Ft | SI4702-C19-GMR | SILICON LABS | RF Transceiver ICs | JLCPCB (https://jlcpcb.com/partdetail/SiliconLabs-SI4702_C19GMR/C2155666)
PN532 Near Field Communication Reader Module | 1 | 40 |  | 2400 Ft | 96000 Ft | PN5321A3HN/C106,55 | NXP Semicon | RF Chips | JLCPCB (https://jlcpcb.com/partdetail/NxpSemicon-PN5321A3HN_C10655/C28925)
Egyéb alkatrészek | 1 | 40 | ???? | 1000 Ft | 40000 Ft
PCB (4 layer, enig) | 1 | 40 |  | 1000 Ft | 40000 Ft
NeoPixel | 8 | 320 |  | 20 Ft | 6400 Ft | WS2812B-B/T | Worldsemi | Light Emitting Diodes (LED) | JLCPCB (https://jlcpcb.com/partdetail/Worldsemi-WS2812B_BT/C2761795)
CAN IC - SN65HVD232DR | 1 | 40 | CAN IC: interfész; transceiver; 1Mbps; 3÷3,6VDC; SO8; -40÷85°C | 245 Ft | 9800 Ft | SN65HVD232DR | Texas Instruments | CAN ICs | JLCPCB (https://jlcpcb.com/partdetail/TexasInstruments-SN65HVD232DR/C30530)
ESPE E2412W2E-2155 | 1 | 40 | Tápegység: impulzusos; dugós; 12VDC; 2A; 24W; Dugvilla: EU; 87% | 2300 Ft | 92000 Ft
LUMBERG 1503 03 | 1 | 40 |  | 66 Ft | 2640 Ft | JLCPCB SMT Parts Library & Component Sourcing (https://jlcpcb.com/parts/componentSearch?searchTxt=stereo%20jack%203.5)
motor driver DRV8220DSGR | 1 | 40 |  | 210 Ft | 8400 Ft | DRV8220DSGR | Texas Instruments | Motor Driver ICs | JLCPCB (https://jlcpcb.com/partdetail/TexasInstruments-DRV8220DSGR/C3681269)
Gyorsulásmérő LIS2DH12TR | 1 | 40 |  | 105 Ft | 4200 Ft | LIS2DH12TR | STMicroelectronics | Attitude Sensor/Gyroscope | JLCPCB (https://jlcpcb.com/partdetail/Stmicroelectronics-LIS2DH12TR/C110926)
M.2 csati | 1 | 40 |  | 115 Ft | 4600 Ft | APCI0107-P001A | Lian Xin Technology | Card Edge Connectors | JLCPCB (https://jlcpcb.com/partdetail/Lian_XinTechnology-APCI0107P001A/C7498140)
passzivok | 1 | 40 |  | 5000 Ft | 200000 Ft
kimeneti csatlakozok: jst S3B-EH | 8 | 320 |  | 100 Ft | 32000 Ft | S3B-EH(LF)(SN) | JST | Wire To Board / Wire To Wire Connector | JLCPCB (https://jlcpcb.com/partdetail/Jst-S3B_EH_LF_SN/C263754)
usb c | 2 | 80 |  | 35 Ft | 2800 Ft | USB Connectors | Connectors | JLCPCB Assembly Parts Library (https://jlcpcb.com/parts/2nd/Connectors/USB_Connectors_3859?searchTxt=usb%20c%20)
usb a | 1 | 40 |  | 26 Ft | 1040 Ft | 10.0 QCHTZB6.3-BD | SHOU HAN | USB Connectors | JLCPCB (https://jlcpcb.com/partdetail/ShouHan-10_0_QCHTZB6_3BD/C2681561)
esp32 usb-ttl ic CP2102 | 1 | 40 |  | 520 Ft | 20800 Ft | CP2102-GMR | SILICON LABS | USB ICs | JLCPCB (https://jlcpcb.com/partdetail/SiliconLabs-CP2102GMR/C6568)
mcu lin. volt. reg. ams1117 | 1 | 40 |  | 35 Ft | 1400 Ft | AMS1117-3.3 | Advanced Monolithic Systems | Linear Voltage Regulators (LDO) | JLCPCB (https://jlcpcb.com/partdetail/Advanced_MonolithicSystems-AMS1117_33/C6186)
dc-dc step-down converter ST1S14PHR | 1 | 40 |  | 263 Ft | 10520 Ft | DC-DC Converters | Power Supply Chip | JLCPCB Assembly Parts Library (https://jlcpcb.com/parts/2nd/Power_Supply_Chip/DC-DC_Converters_154)
dc power jack | 1 | 40 |  | 230 Ft | 9200 Ft | PJ-202AH CUI Devices | Mouser Europa (https://eu.mouser.com/ProductDetail/CUI-Devices/PJ-202AH?qs=WyjlAZoYn52pjAZoaa7Syg%3D%3D)
pcb rocker switch | 1 | 40 |  | 600 Ft | 24000 Ft | R1966ABLKBLKGR E-SWITCH - ROCKER | SPST; poz: 2; ON-OFF; 15A/125VAC; fekete; -30÷65°C; 1000MΩ | TME Hungary Kft. - Elektronikai alkatrészek (https://www.tme.eu/hu/details/r1966ablkblkgr/rocker-kapcsolok/e-switch/)
smd olvado biztositek 2A | 1 | 40 |  | 23 Ft | 920 Ft | 0466002.NRHF | Littelfuse | Fuses | JLCPCB (https://jlcpcb.com/partdetail/Littelfuse-0466002NRHF/C3105)

Sheet: Overview
Production | SUM/PCS
PCB | €9.50 | Total production / unit: | €111.50 | proto:
THT | €13.00
SMD | €76.00 |  | 45000 Ft
EXTRA | €13.00 |  | 1 Motherboard | 1 Motherboard
 |  |  | 1 ESP32 Card | 1 ESP32 Card
 |  |  | 1 STM32 Board | 1 STM32 Board | x5 = | 225000 Ft
 |  |  | 1 ATMEGA Board | 1 ATMEGA Board
 |  |  | 1 Geared dc Motor w encoder | 1 Geared dc Motor w encoder
 |  |  | 1 power adaptor | 1 power adaptor
 |  |  | 1784000 Ft

Sheet: PCB
PCB | Layers | size | color | extra | stage | QTY | Price | Price/Pcs | Source | Comment
Motherboard | 4 | 130x170 | black | ENIG | prototype | 5 | €40.00 | €8.00 | JLCPCB | Cheap and fast
Motherboard | 4 | 130x170 | matte-black | ENIG finish, impedance controlled traces | production | 40 | €152.00 | €3.80 | JLCPCB | High quality
ESP32 | 4 | 22x42 | green | ENIG finish, Edge connector, | prototype | 5 | €16.00 | €3.20 | JLCPCB | m.2 card connector
ESP32 | 4 | 22x42 | matte-black | ENIG finish, Edge connector, 30deg | production | 40 | €112.00 | €2.80 | JLCPCB | Many options for edge connector
STM32 | 4 | 55x40 | green |  | prototype | 5 | €7.00 | €1.40 | JLCPCB
STM32 | 4 | 55x40 | black | ENIG | production | 50 | €72.00 | €1.44 | JLCPCB
ATMEGA | 4 | 55x40 | green |  | prototype | 5 | €7.00 | €1.40 | JLCPCB
ATMEGA | 4 | 55x40 | black | ENIG | production | 50 | €72.00 | €1.44 | JLCPCB

Sheet: THT
name | stage | QTY | Price | Price/Pcs | Source | Comment
LCD1602 + I2C |  | 40 | 32000 Ft | 800 Ft
2.4" SPI TFT LCD touch screen ILI9488 |  | 40 | 92000 Ft | 2300 Ft
4*4 Matrix Switch Keyboard Keypad Array Module ABS Plastic Keys |  | 40 | 36000 Ft | 900 Ft
5mm green led |  | 120 | 3048 Ft | 25.4 Ft
5mm red led |  | 120 | 3000 Ft | 25 Ft
5mm RGB |  | 80 | 7040 Ft | 88 Ft
Poti trimmer 100k |  | 40 | 3208 Ft | 80.2 Ft
poti tengely |  | 40 | 5520 Ft | 138 Ft
LUMBERG 1503 03 |  | 40 | 2640 Ft | 66 Ft
m2 smt mounting standoff 2mm height M3 |  | 120 | 19560 Ft | 163 Ft
kimeneti csatlakozok: jst S3B-EH |  | 320 | 32000 Ft | 100 Ft
dc power jack |  | 40 | 9200 Ft | 230 Ft

Sheet: SMD
Name | stage | QTY | Price | Price/Pcs | Source | Comment
ESP32 S3 wroom 1 N16R2 | 1 | 40 | 56000 Ft | 1400 Ft
HDC1080DMBR | 1 | 40 | 9400 Ft | 235 Ft
TOKEN PGM5516-MP | 1 | 40 | 6520 Ft | 163 Ft
12x12mm SPST Tactile Switch | 5 | 200 | 3622 Ft | 18.11 Ft
FM Receiver Module Silicon SI4702 Chip | 1 | 40 | 40000 Ft | 1000 Ft
PN532 Near Field Communication Reader Module | 1 | 40 | 96000 Ft | 2400 Ft
NeoPixel | 8 | 320 | 6400 Ft | 20 Ft
CAN IC - SN65HVD232DR | 1 | 40 | 9800 Ft | 245 Ft
motor driver DRV8870ddar | 1 | 40 | 4720 Ft | 118 Ft
Gyorsulásmérő LIS2DH12TR | 1 | 40 | 4200 Ft | 105 Ft
M.2 csati | 1 | 40 | 4600 Ft | 115 Ft
passzivok | 1 | 40 | 200000 Ft | 5000 Ft
usb c | 2 | 80 | 2800 Ft | 35 Ft
usb a | 1 | 40 | 1040 Ft | 26 Ft
dc-dc step-down converter ST1S14PHR vagy TPS40322RHBR | 1 | 40 | 10520 Ft | 263 Ft
smd olvado biztositek 2A | 1 | 40 | 920 Ft | 23 Ft
LM358D opamp tapegyseg switch | 1 | 40 | 920 Ft | 23 Ft
betap kondi 100uF electrolit | 1 | 40 | 1520 Ft | 38 Ft
stm32 dsicovery |  | 40 | 400000 Ft | 10000 Ft
ATMEGA2560 |  | 40 | 400000 Ft | 10000 Ft

Sheet: EXTRAS
Name | stage | QTY | Price | Price/Pcs | Source | Comment
motor with encoder 90deg shaft 12V68RPM |  | 40 |  | 3028 Ft | 121120 Ft
ESPE E2412W2E-2155 |  | 40 | Tápegység: impulzusos; dugós; 12VDC; 2A; 24W; Dugvilla: EU; 87% | 2300 Ft | 92000 Ft

Sheet: accessories
Megnevezés | db | Összes db | Leírás | Egységár (nettó) | Nettó összár | Honnan | LINK | db | 40
motor with encoder 90deg shaft 12V68RPM | 1 | 40 |  | 3028 Ft | 121120 Ft | Aliexpress | https://www.aliexpress.com/item/1005005127362108.html?curPageLogUid=HUAbHG26qmqc | sum | 213120
ESPE E2412W2E-2155 | 1 | 40 | Tápegység: impulzusos; dugós; 12VDC; 2A; 24W; Dugvilla: EU; 87% | 2300 Ft | 92000 Ft | TME | https://www.tme.eu/hu/details/e2412w2e/dugvillas-tapegysegek/espe/e2412w2e-2155/

Sheet: motherboard
Megnevezés | db | Összes db | Leírás | Egységár (nettó) | Nettó összár | Honnan | LINK | db | 40
LCD1602 + I2C | 1 | 40 |  | 800 Ft | 32000 Ft | Aliexpress | https://www.aliexpress.com/item/32763867041.html?curPageLogUid=mEYzrvCAzbyJ | sum: | 789238 Ft
2.4" SPI TFT LCD touch screen ILI9488 | 1 | 40 |  | 2300 Ft | 92000 Ft | Aliexpress | https://www.aliexpress.com/item/33015586094.html?scm_id=1007.40000.327270.0&scm-url=1007.40000.327270.0
4*4 Matrix Switch Keyboard Keypad Array Module ABS Plastic Keys | 1 | 40 | 4x4 | 900 Ft | 36000 Ft | Aliexpress | https://www.aliexpress.com/item/1005002804089482.html?curPageLogUid=u6p1vElqdttM
ESP32 S3 wroom 1 N16R2 | 1 | 40 | 3-WROOM-1-N16R8 | 1400 Ft | 56000 Ft | Aliexpress | https://www.aliexpress.com/item/1005004815894336.html?curPageLogUid=gnOhPkFfR4eW
HDC1080DMBR | 1 | 40 |  | 235 Ft | 9400 Ft | JLC | HDC1080DMBR | Texas Instruments | Temperature And Humidity Sensor | JLCPCB (https://jlcpcb.com/partdetail/TexasInstruments-HDC1080DMBR/C82227)
TOKEN PGM5516-MP | 1 | 40 | Fotoellenállás; 90mW; 5÷10kΩ; 540nm; | 163 Ft | 6520 Ft | TME | PGM5516-MP Token - Fotoellenállás | 90mW; 5÷10kΩ; 540nm; THT; 100VDC; ØLED: 5,5mm | TME Hungary Kft. - Elektronikai alkatrészek (https://www.tme.eu/hu/details/pgm5516-mp/fotoellenallasok/token/)
12x12mm SPST Tactile Switch | 5 | 200 | TS-1003ST-26 | 18.11 Ft | 3622 Ft | JLC | https://jlcpcb.com/partdetail/Xunpu-TS_1003ST26/C455234
5mm green led | 3 | 120 |  | 25.4 Ft | 3048 Ft | TME | L-53GD KINGBRIGHT ELECTRONIC - LED | 5mm; zöld; 5÷32mcd; 60°; Front: domború; 2,2÷2,5V; kiv.száma: 2 | TME Hungary Kft. - Elektronikai alkatrészek (https://www.tme.eu/hu/details/l-53gd/led-tht-kerek-diodak/kingbright-electronic/)
5mm red led | 3 | 120 |  | 25 Ft | 3000 Ft | TME | L-53ID KINGBRIGHT ELECTRONIC - LED | 5mm; piros; 12,5÷80mcd; 60°; Front: domború; 2÷2,5V | TME Hungary Kft. - Elektronikai alkatrészek (https://www.tme.eu/hu/details/l-53id/led-tht-kerek-diodak/kingbright-electronic/)
5mm RGB | 2 | 80 |  | 88 Ft | 7040 Ft | TME | LL-509RGBC2E-004 LUCKYLIGHT - LED | 5mm; RGB; 25°; Front: domború; 1,6÷2,6/2,8÷3,8/2,8÷3,8V | TME Hungary Kft. - Elektronikai alkatrészek (https://www.tme.eu/hu/details/ll-509rgbc2e-004/led-tht-kerek-diodak/luckylight/)
DM3BT-DSF-PEJS | 1 | 40 | microSD | 571 Ft | 22840 Ft | JLC | DM3BT-DSF-PEJS | HRS(Hirose) | SD Card Connectors | JLCPCB (https://jlcpcb.com/partdetail/hrs_hirose-DM3BT_DSFPEJS/C597972)
Poti trimmer 100k | 1 | 40 |  | 80.2 Ft | 3208 Ft | TME | PT15NV02104A2020S PIHER - Potenciométer: beépíthető | egyfordulatú,fekvő; 100kΩ; 250mW; ±20%; PT15NV-100K | TME Hungary Kft. - Elektronikai alkatrészek (https://www.tme.eu/hu/details/pt15nv-100k/egyfordulatu-tht-trimmerek/piher/pt15nv02104a2020s/)
poti tengely | 1 | 40 |  | 138 Ft | 5520 Ft | TME | 5214 PIHER - Gombok | szabályzó henger; fekete; Ø6x19mm; PT15N; B: 9mm; PT15GW-19 | TME Hungary Kft. - Elektronikai alkatrészek (https://www.tme.eu/hu/details/pt15gw-19/trimmer-gombok/piher/5214/)
FM Receiver Module Silicon SI4702 Chip | 1 | 40 |  | 1000 Ft | 40000 Ft | JLC | SI4702-C19-GMR | SILICON LABS | RF Transceiver ICs | JLCPCB (https://jlcpcb.com/partdetail/SiliconLabs-SI4702_C19GMR/C2155666)
PN532 Near Field Communication Reader Module | 1 | 40 |  | 2400 Ft | 96000 Ft | JLC | PN5321A3HN/C106,55 | NXP Semicon | RF Chips | JLCPCB (https://jlcpcb.com/partdetail/NxpSemicon-PN5321A3HN_C10655/C28925)
PCB (4 layer, enig) | 1 | 40 |  | 1000 Ft | 40000 Ft | JLC
NeoPixel | 8 | 320 |  | 20 Ft | 6400 Ft | JLC | WS2812B-B/T | Worldsemi | Light Emitting Diodes (LED) | JLCPCB (https://jlcpcb.com/partdetail/Worldsemi-WS2812B_BT/C2761795)
CAN IC - SN65HVD232DR | 1 | 40 | CAN IC: interfész; transceiver; 1Mbps; 3÷3,6VDC; SO8; -40÷85°C | 245 Ft | 9800 Ft | JLC | SN65HVD232DR | Texas Instruments | CAN ICs | JLCPCB (https://jlcpcb.com/partdetail/TexasInstruments-SN65HVD232DR/C30530)
LUMBERG 1503 03 | 1 | 40 |  | 66 Ft | 2640 Ft | JLC | JLCPCB SMT Parts Library & Component Sourcing (https://jlcpcb.com/parts/componentSearch?searchTxt=stereo%20jack%203.5)
motor driver DRV8870ddar | 1 | 40 |  | 118 Ft | 4720 Ft | JLC | https://jlcpcb.com/partdetail/TexasInstruments-DRV8870DDAR/C86590
Gyorsulásmérő LIS2DH12TR | 1 | 40 |  | 105 Ft | 4200 Ft | JLC | LIS2DH12TR | STMicroelectronics | Attitude Sensor/Gyroscope | JLCPCB (https://jlcpcb.com/partdetail/Stmicroelectronics-LIS2DH12TR/C110926)
M.2 csati | 1 | 40 |  | 115 Ft | 4600 Ft | JLC | APCI0107-P001A | Lian Xin Technology | Card Edge Connectors | JLCPCB (https://jlcpcb.com/partdetail/Lian_XinTechnology-APCI0107P001A/C7498140)
m2 smt mounting standoff 2mm height M3 | 3 | 120 |  | 163 Ft | 19560 Ft | MOUSER | https://hu.mouser.com/ProductDetail/Keystone-Electronics/24881?qs=u16ybLDytRZRpz%252BqY%2FJM%2FA%3D%3D
passzivok | 1 | 40 |  | 5000 Ft | 200000 Ft | JLC
kimeneti csatlakozok: jst S3B-EH | 8 | 320 |  | 100 Ft | 32000 Ft | JLC | S3B-EH(LF)(SN) | JST | Wire To Board / Wire To Wire Connector | JLCPCB (https://jlcpcb.com/partdetail/Jst-S3B_EH_LF_SN/C263754)
usb c | 2 | 80 |  | 35 Ft | 2800 Ft | JLC | USB Connectors | Connectors | JLCPCB Assembly Parts Library (https://jlcpcb.com/parts/2nd/Connectors/USB_Connectors_3859?searchTxt=usb%20c%20)
usb a | 1 | 40 |  | 26 Ft | 1040 Ft | JLC | 10.0 QCHTZB6.3-BD | SHOU HAN | USB Connectors | JLCPCB (https://jlcpcb.com/partdetail/ShouHan-10_0_QCHTZB6_3BD/C2681561)
esp32 usb-ttl ic CP2102 | 1 | 40 |  | 520 Ft | 20800 Ft | JLC | CP2102-GMR | SILICON LABS | USB ICs | JLCPCB (https://jlcpcb.com/partdetail/SiliconLabs-CP2102GMR/C6568)
mcu lin. volt. reg. ams1117 | 1 | 40 |  | 35 Ft | 1400 Ft | JLC | AMS1117-3.3 | Advanced Monolithic Systems | Linear Voltage Regulators (LDO) | JLCPCB (https://jlcpcb.com/partdetail/Advanced_MonolithicSystems-AMS1117_33/C6186)
dc-dc step-down converter ST1S14PHR vagy TPS40322RHBR | 1 | 40 |  | 263 Ft | 10520 Ft | JLC | https://jlcpcb.com/partdetail/TexasInstruments-TPS54331DR/C9865
dc power jack | 1 | 40 |  | 230 Ft | 9200 Ft | MOUSER | PJ-202AH CUI Devices | Mouser Europa (https://eu.mouser.com/ProductDetail/CUI-Devices/PJ-202AH?qs=WyjlAZoYn52pjAZoaa7Syg%3D%3D)
smd olvado biztositek 2A | 1 | 40 |  | 23 Ft | 920 Ft | JLC | 0466002.NRHF | Littelfuse | Fuses | JLCPCB (https://jlcpcb.com/partdetail/Littelfuse-0466002NRHF/C3105)
LM358D opamp tapegyseg switch | 1 | 40 |  | 23 Ft | 920 Ft | JLC | LM358DT | STMicroelectronics | Operational Amplifier | JLCPCB (https://jlcpcb.com/partdetail/Stmicroelectronics-LM358DT/C9418)
betap kondi 100uF electrolit | 1 | 40 |  | 38 Ft | 1520 Ft | JLC | https://jlcpcb.com/partdetail/Rubycon-25TZV100M63X8/C88837
power load switch |  |  |  |  |  |  | https://jlcpcb.com/partdetail/TexasInstruments-TPS22810DBVR/C205990
