mark69163/prodigy/PRODIGY-ESP32/3D/PRODIGY-ESP32.step

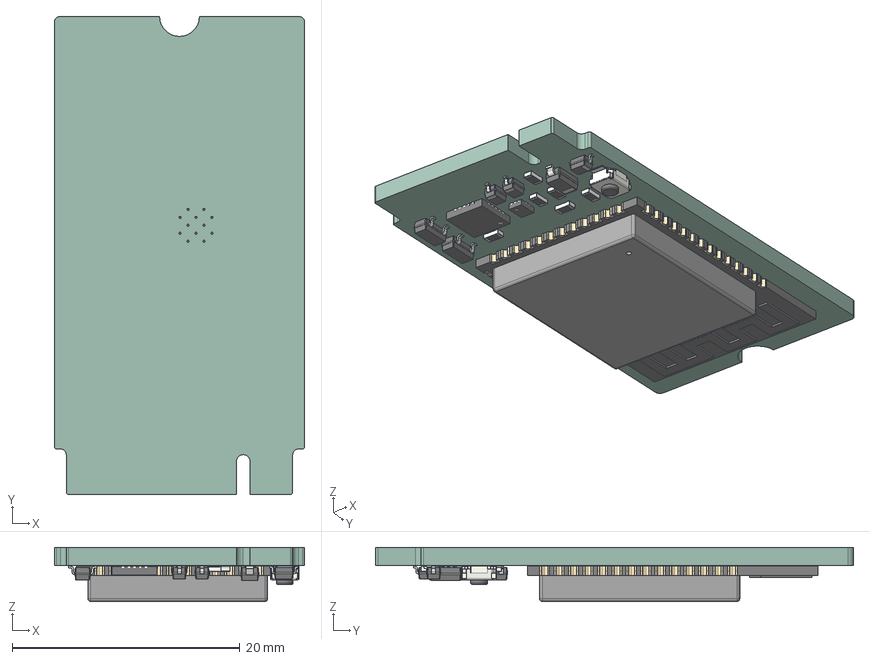
[picture p49: CAD file, 2024-06-25]
PRODIGY-ESP32/3D/PRODIGY-ESP32.step
22.0 x 42.0 x 4.75 mm
SOT_23 x 2
R_0603_1608Metric x 6
ESP32-S3-WROOM-1
SW_SPST_B3U-1000P-B
D_SOD_323 x 3
D_SOD_123
UQFN-10_1.4x1.8mm_Pitch0.4mm
QFN-20-1EP_4x4mm_Pitch0.5mm
PRODIGY-ESP32_PCB
