mark69163/prodigy/PRODIGY-MOTHERBOARD/3D/DF40C-100DP.stp

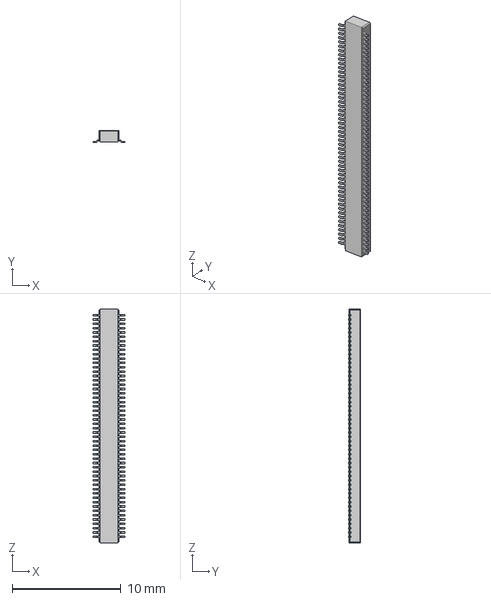
[picture p50: CAD file, 2024-07-06]
PRODIGY-MOTHERBOARD/3D/DF40C-100DP.stp
2.97 x 1.14 x 21.5 mm
