mark69163/prodigy/PRODIGY-MOTHERBOARD/3D/7 segment1.STEP

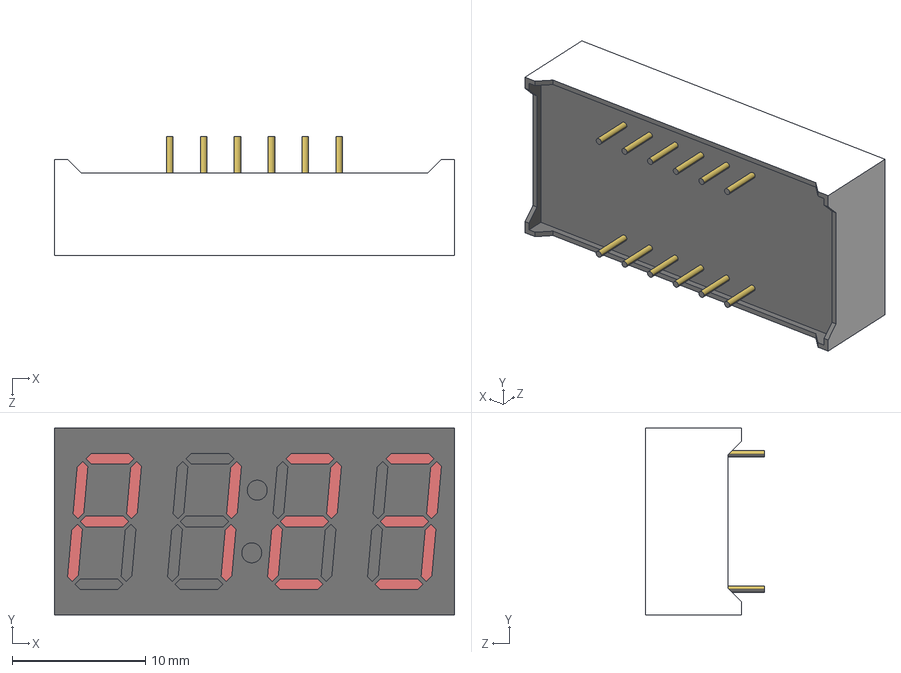
[picture p51: CAD file, 2024-06-22]
PRODIGY-MOTHERBOARD/3D/7 segment1.STEP
30.0 x 14.0 x 8.93 mm
