mark69163/prodigy/PRODIGY-MOTHERBOARD/3D/CMA-4544.step

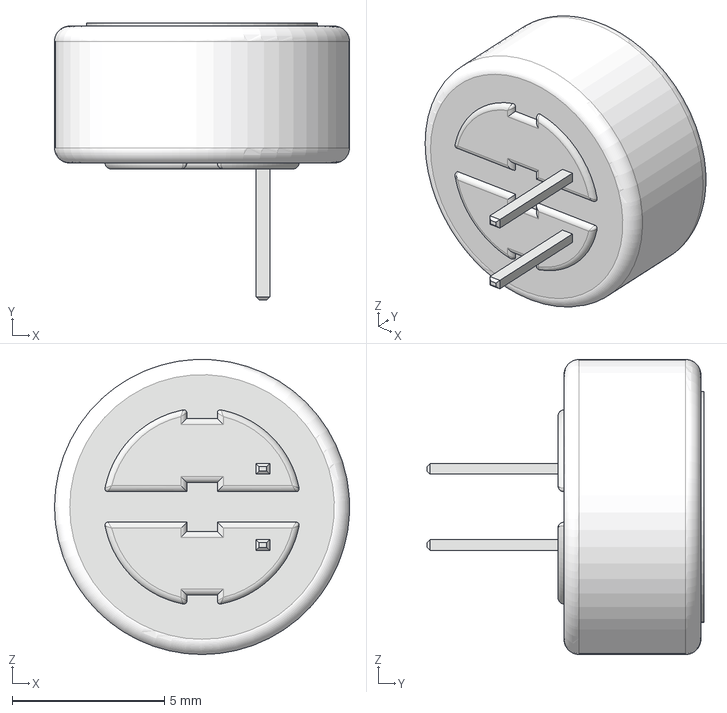
[picture p52: CAD file, 2024-05-29]
PRODIGY-MOTHERBOARD/3D/CMA-4544.step
9.70 x 9.10 x 9.70 mm
