mark69163/prodigy/PRODIGY-MOTHERBOARD/3D/SW_PUSH_SMD-12mm.STEP

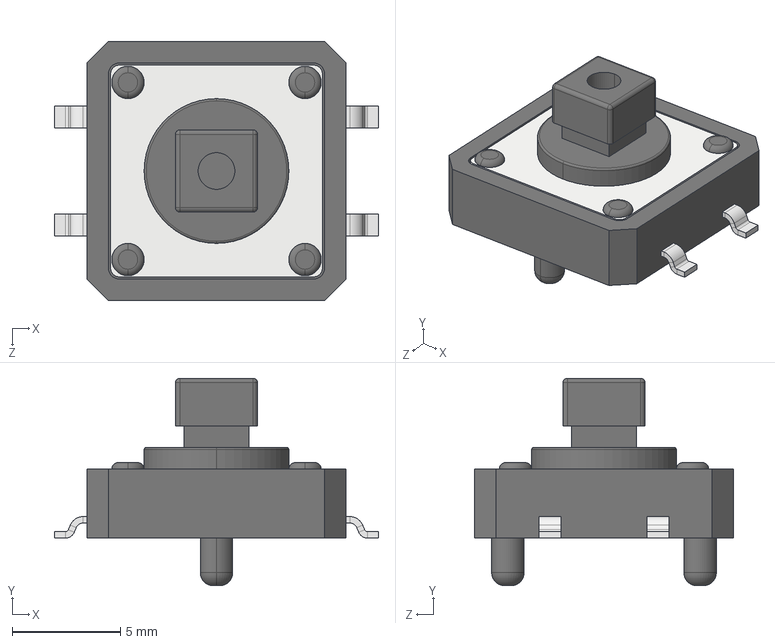
[picture p53: CAD file, 2024-05-20]
PRODIGY-MOTHERBOARD/3D/SW_PUSH_SMD-12mm.STEP
15.0 x 9.60 x 12.0 mm
