mark69163/prodigy/PRODIGY-MOTHERBOARD/3D/12mm Push Button Cap.STEP

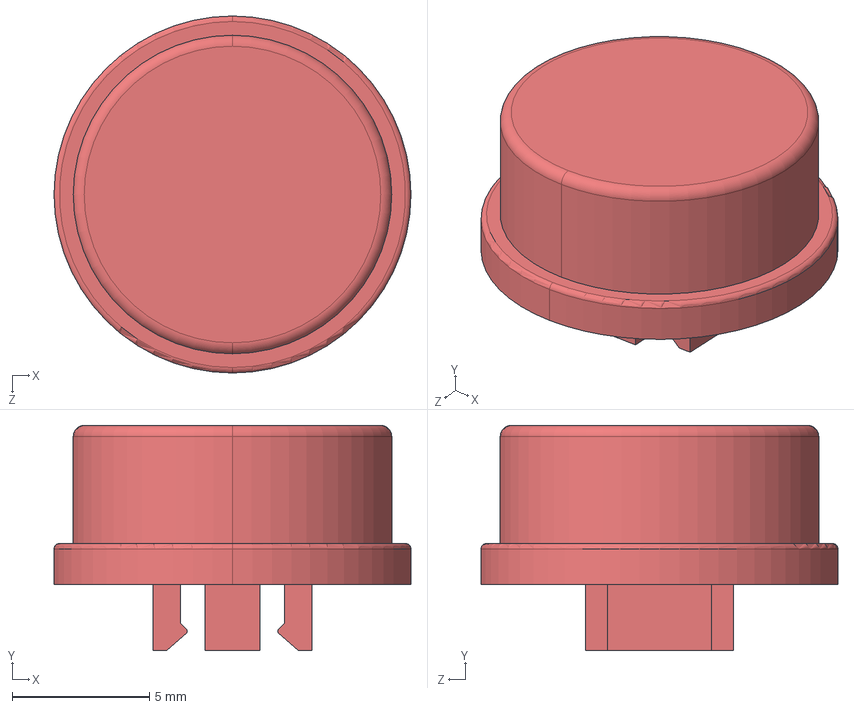
[picture p54: CAD file, 2024-05-20]
PRODIGY-MOTHERBOARD/3D/12mm Push Button Cap.STEP
13.0 x 8.20 x 13.0 mm
