mark69163/prodigy/PRODIGY-MOTHERBOARD/3D/Potentiometer knob_A15x17-PK-AB-K-I.stp

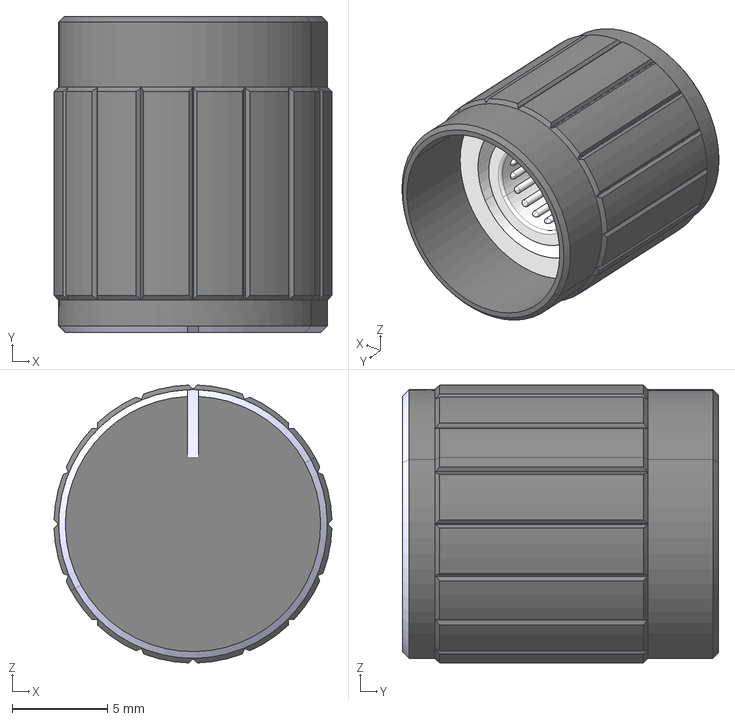
[picture p55: CAD file, 2024-05-20]
PRODIGY-MOTHERBOARD/3D/Potentiometer knob_A15x17-PK-AB-K-I.stp
14.6 x 16.6 x 14.6 mm
