mark69163/prodigy/PRODIGY-MOTHERBOARD/3D/Trimmer_Piher_PT-15.step

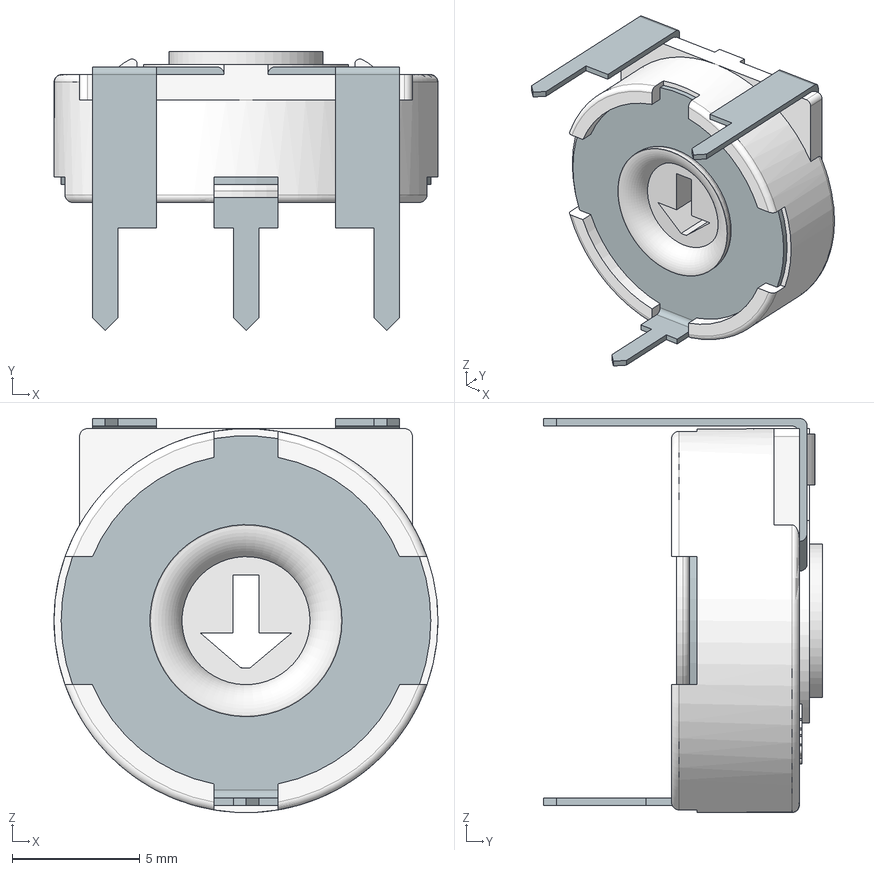
[picture p56: CAD file, 2024-05-20]
PRODIGY-MOTHERBOARD/3D/Trimmer_Piher_PT-15.step
15.0 x 10.9 x 15.4 mm
Corps_PT-15
Axe
Broche 1
