mark69163/prodigy/PRODIGY-MOTHERBOARD/3D/2 Axis Thumbstick v3.step

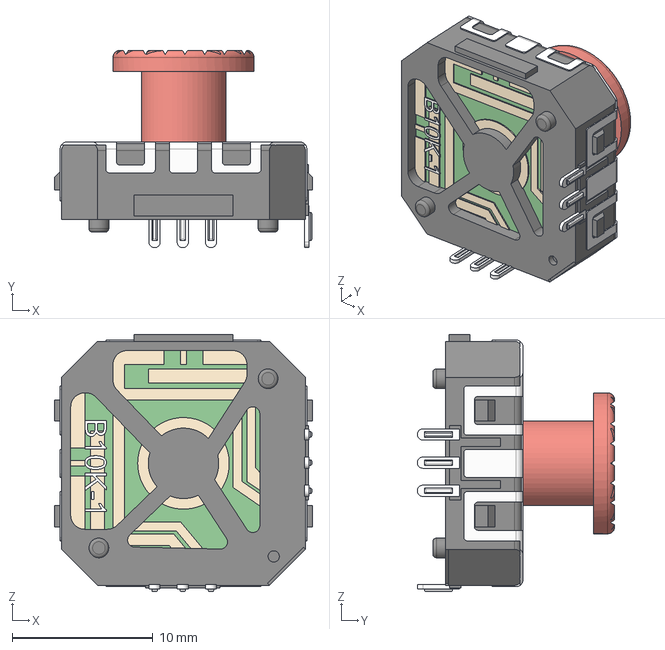
[picture p57: CAD file, 2024-05-20]
PRODIGY-MOTHERBOARD/3D/2 Axis Thumbstick v3.step
18.3 x 14.0 x 18.2 mm
