mark69163/prodigy/PRODIGY-MOTHERBOARD/3D/SW868-TH13.STEP

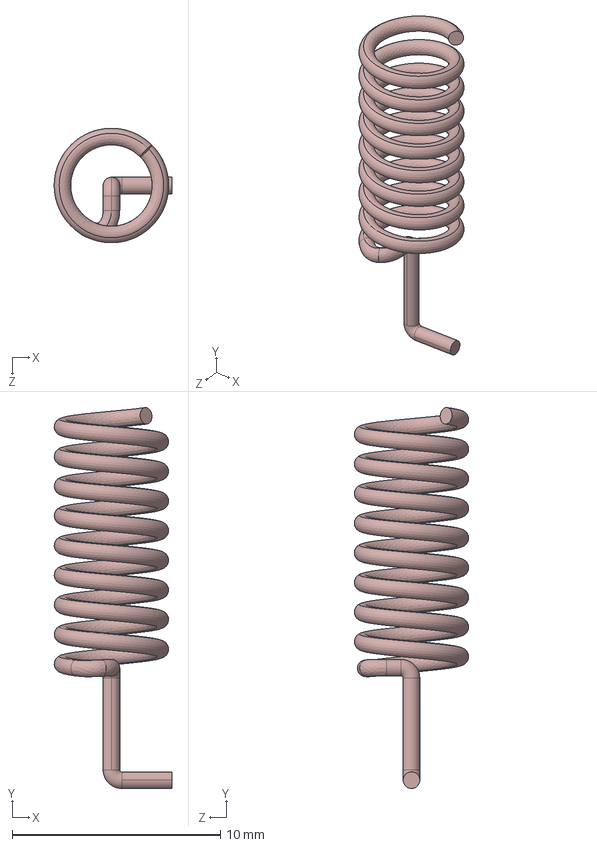
[picture p58: CAD file, 2024-05-20]
PRODIGY-MOTHERBOARD/3D/SW868-TH13.STEP
5.65 x 18.3 x 5.50 mm
