mark69163/prodigy/PRODIGY-MOTHERBOARD/3D/Thumb-Button.step

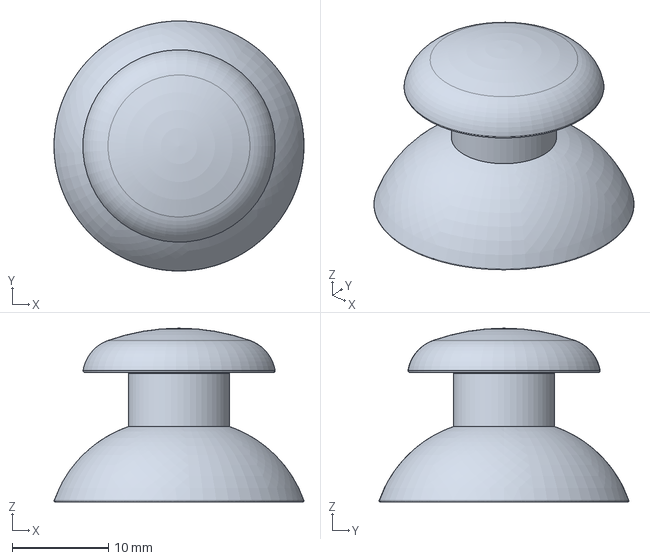
[picture p59: CAD file, 2024-05-20]
PRODIGY-MOTHERBOARD/3D/Thumb-Button.step
25.9 x 25.9 x 18.0 mm
