mark69163/prodigy/PRODIGY-MOTHERBOARD/3D/1-2199230-4.stp

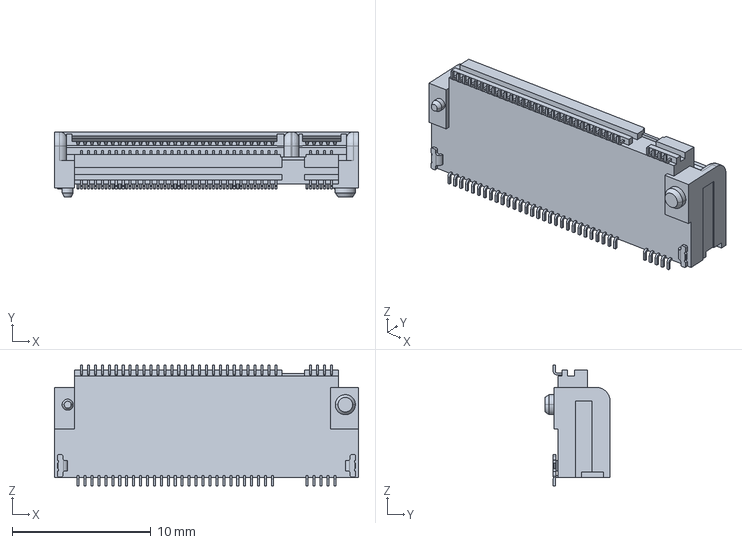
[picture p60: CAD file, 2024-05-20]
PRODIGY-MOTHERBOARD/3D/1-2199230-4.stp
21.9 x 4.70 x 8.70 mm
