mark69163/prodigy/PRODIGY-MOTHERBOARD/3D/Audio Jack 3.5mm, female, stereo.STEP

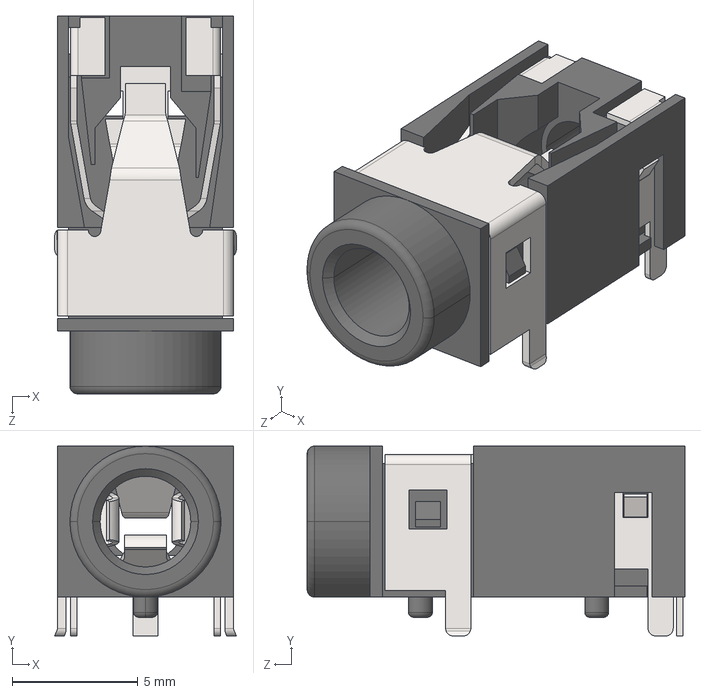
[picture p61: CAD file, 2024-05-20]
PRODIGY-MOTHERBOARD/3D/Audio Jack 3.5mm, female, stereo.STEP
7.23 x 7.54 x 15.0 mm
