mark69163/prodigy/PRODIGY-MOTHERBOARD/3D/HDC1080.STEP

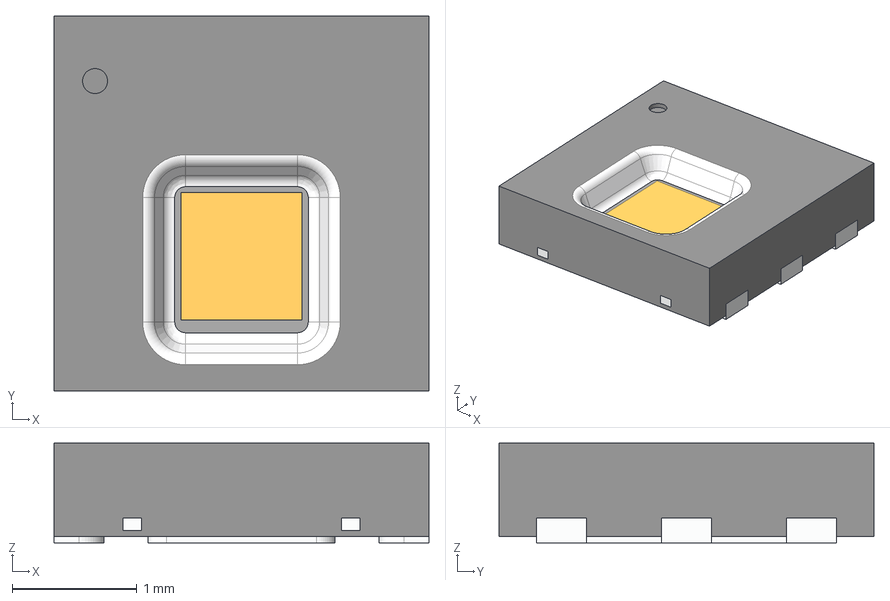
[picture p62: CAD file, 2024-05-20]
PRODIGY-MOTHERBOARD/3D/HDC1080.STEP
3.00 x 3.00 x 0.8 mm
BODY-SON_118_1
FRAME-DMB0006A_77_1_1
FRAME-DMB0006A_77_2_1
FRAME-DMB0006A_77_3_1
FRAME-DMB0006A_77_4_1
FRAME-DMB0006A_77_5_1
FRAME-DMB0006A_77_6_1
FRAME-DMB0006A_77_7_1
DIE_1_1
