mark69163/prodigy/PRODIGY-MOTHERBOARD/3D/WA-SMST-9774020951.stp

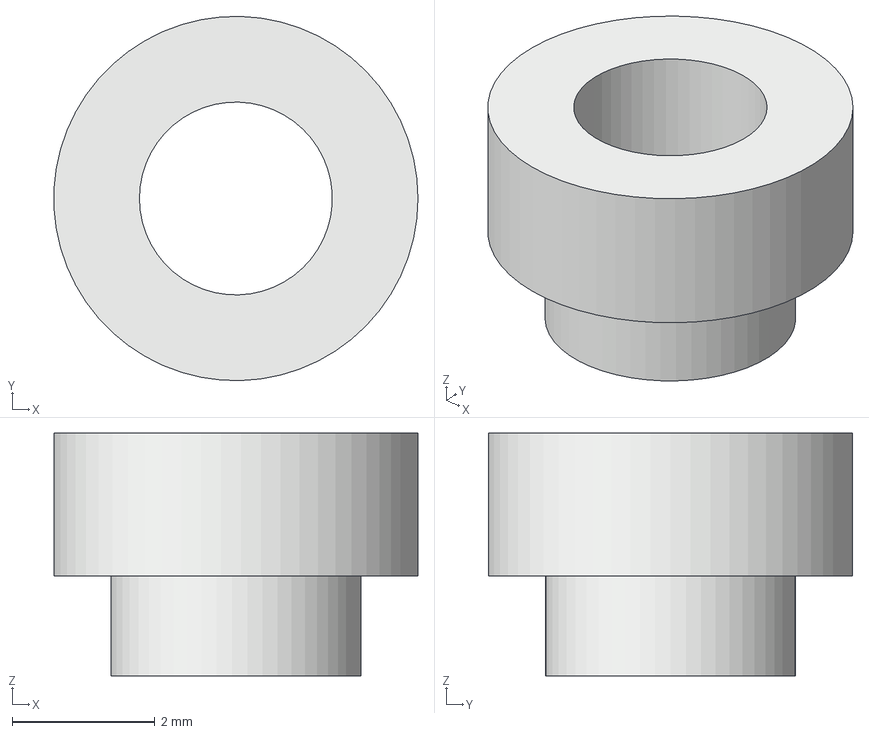
[picture p63: CAD file, 2024-05-20]
PRODIGY-MOTHERBOARD/3D/WA-SMST-9774020951.stp
5.10 x 5.10 x 3.40 mm
