mark69163/prodigy/PRODIGY-MOTHERBOARD/3D/A8L-21-13N1-2 v11.step

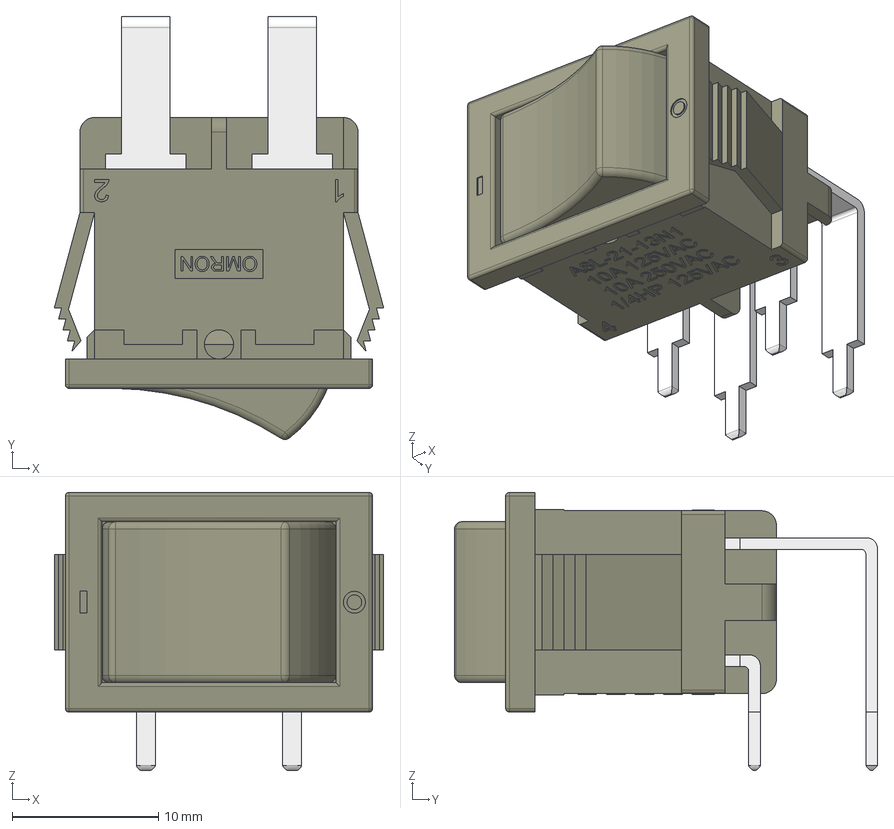
[picture p64: CAD file, 2024-05-20]
PRODIGY-MOTHERBOARD/3D/A8L-21-13N1-2 v11.step
22.5 x 28.9 x 19.0 mm
Rocker
Pins
Pivot
