mark69163/prodigy/PRODIGY-MOTHERBOARD/3D/2D-Analog-Thumb-Joystick.step

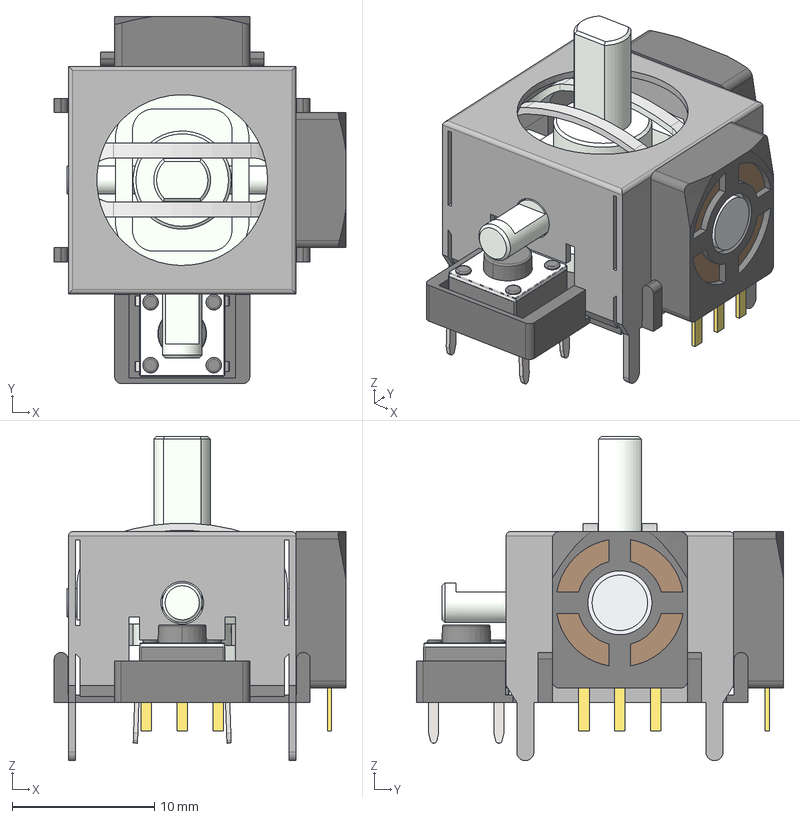
[picture p65: CAD file, 2024-05-20]
PRODIGY-MOTHERBOARD/3D/2D-Analog-Thumb-Joystick.step
20.5 x 25.8 x 22.8 mm
Baseplate
Case001
Rotator-Unit
Potentiometer_01
Potentiometer_02
Tactile-Switch
