mark69163/prodigy/PRODIGY-MOTHERBOARD/3D/microElectrelet.step

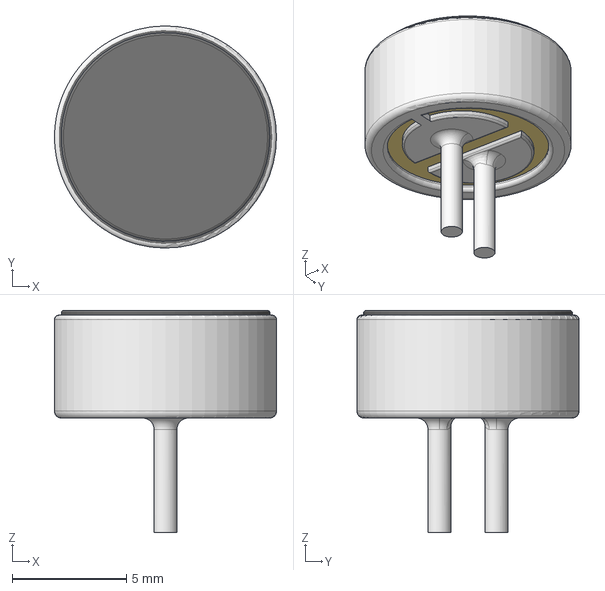
[picture p66: CAD file, 2024-05-20]
PRODIGY-MOTHERBOARD/3D/microElectrelet.step
9.70 x 9.70 x 9.70 mm
