mark69163/prodigy/PRODIGY-MOTHERBOARD/motherboard_schematic_v0.2.pdf

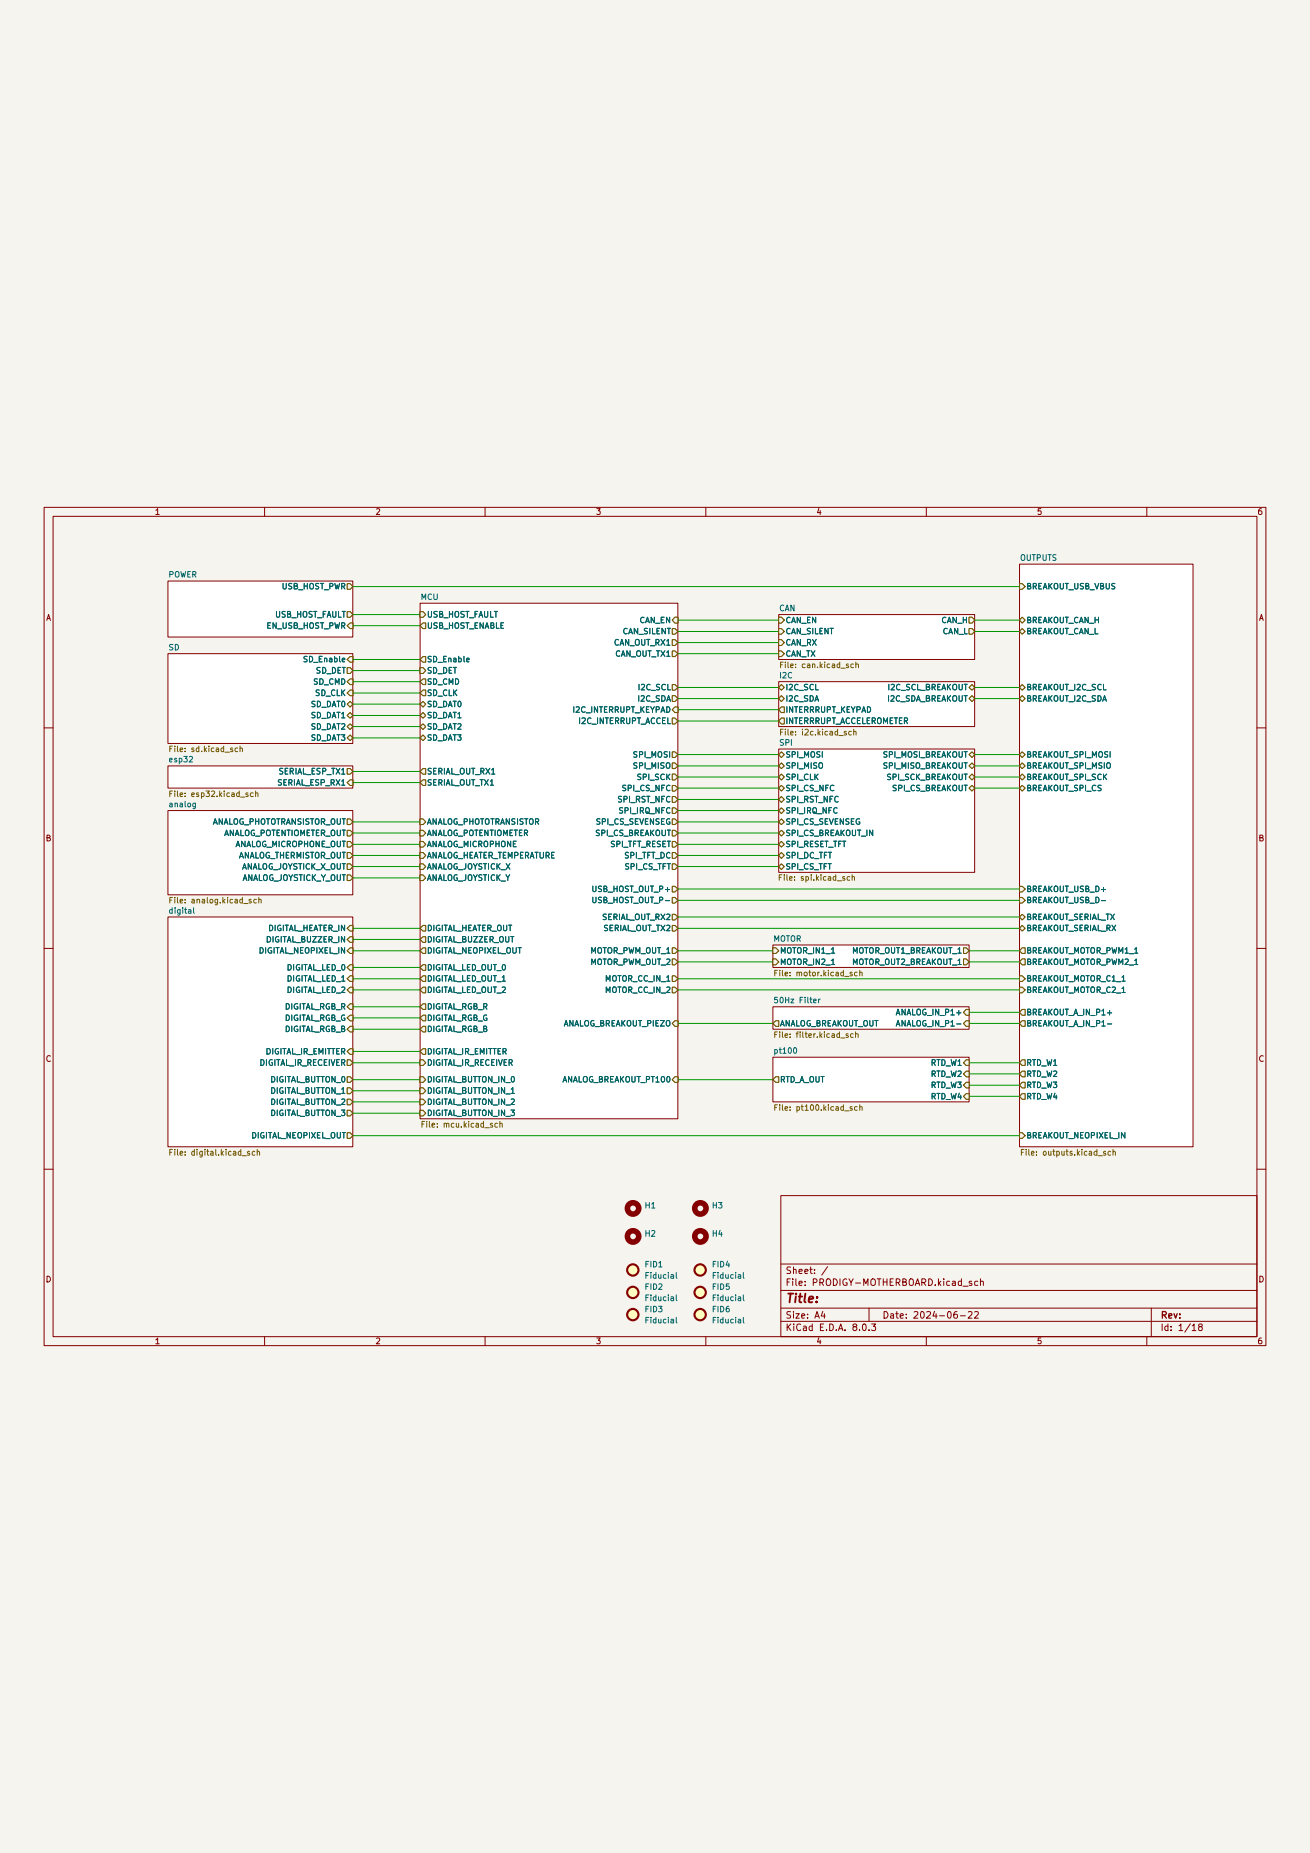
[picture p67: page 1]

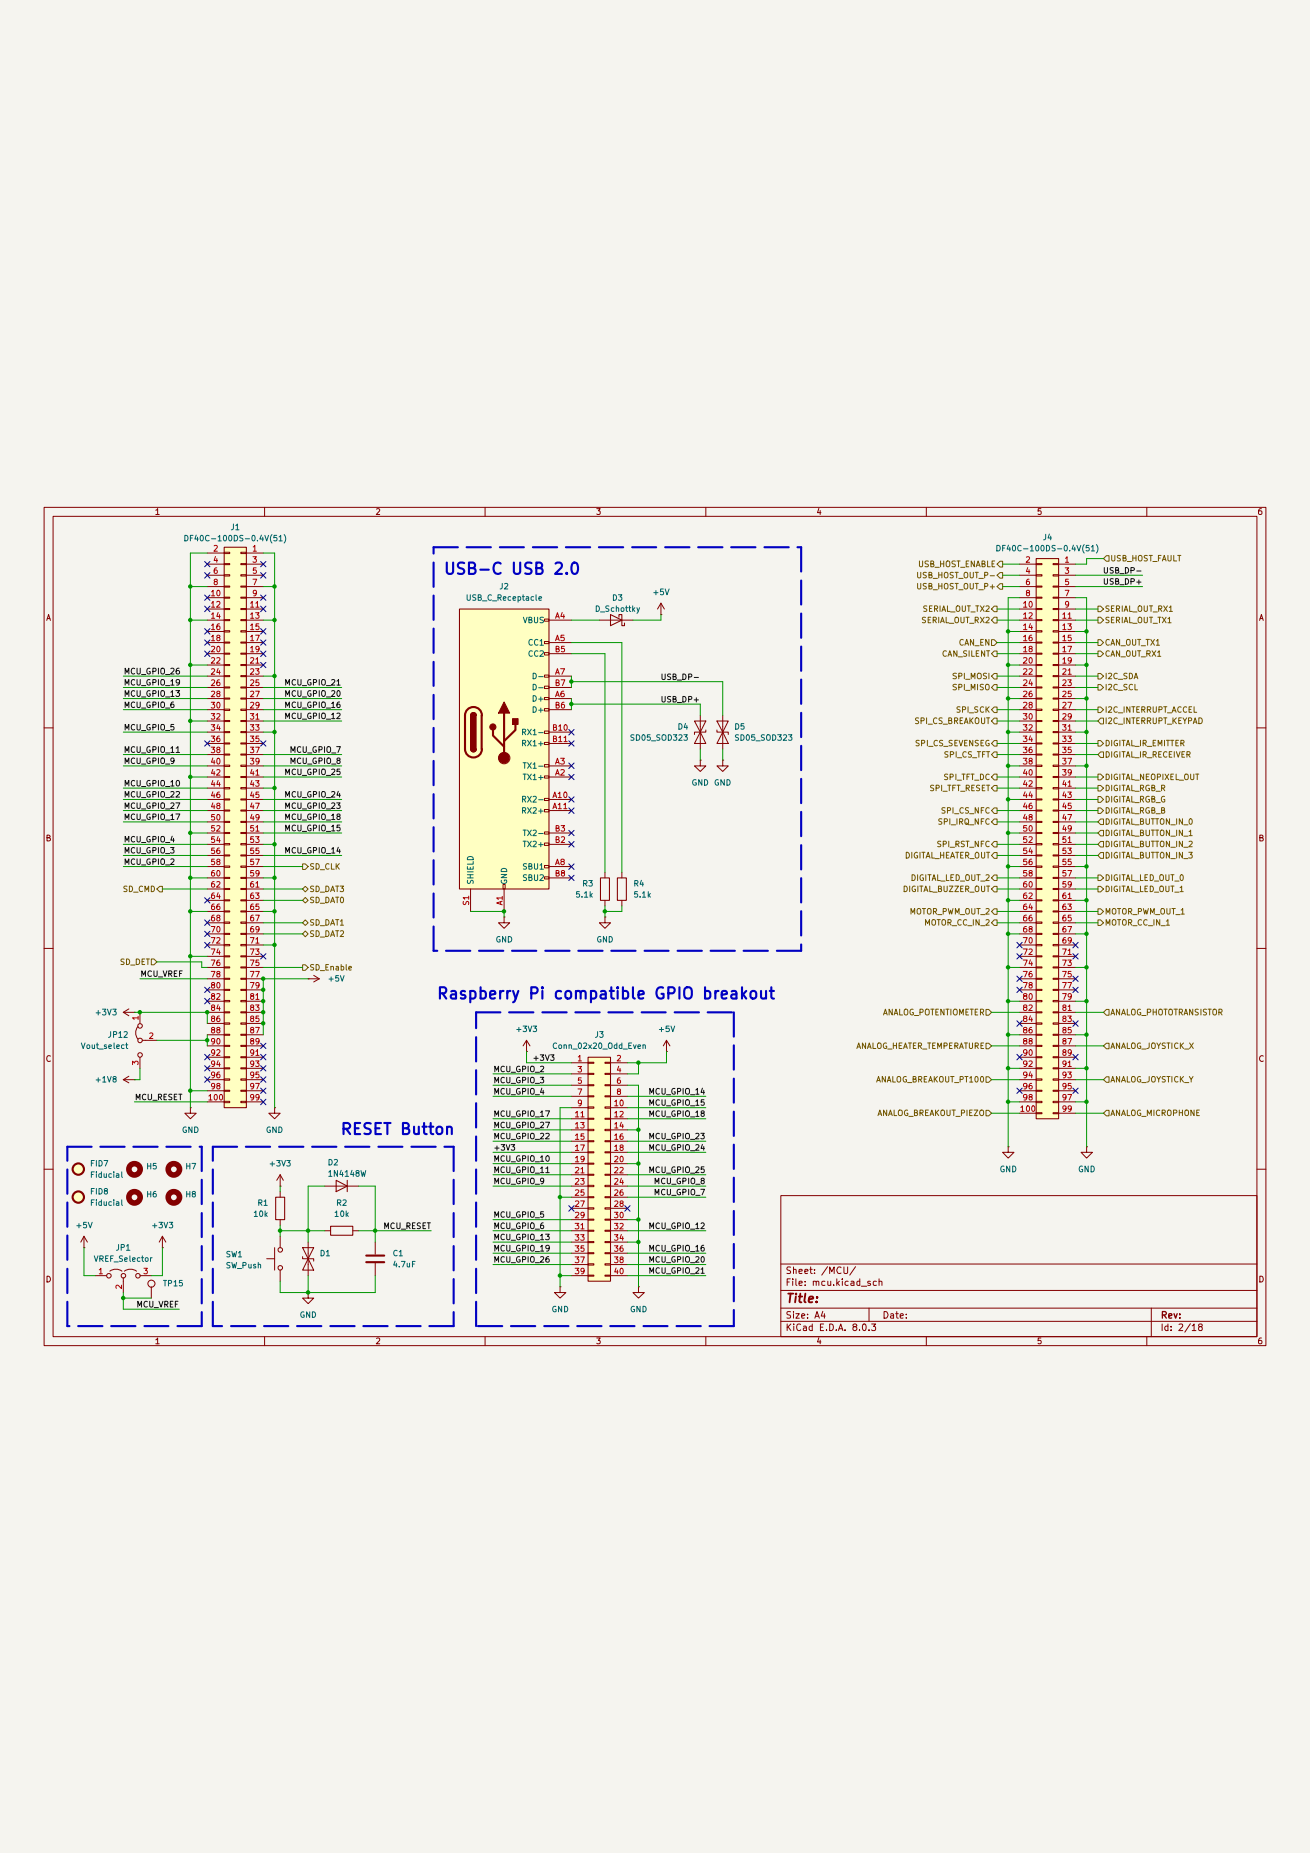
[picture p68: page 2]

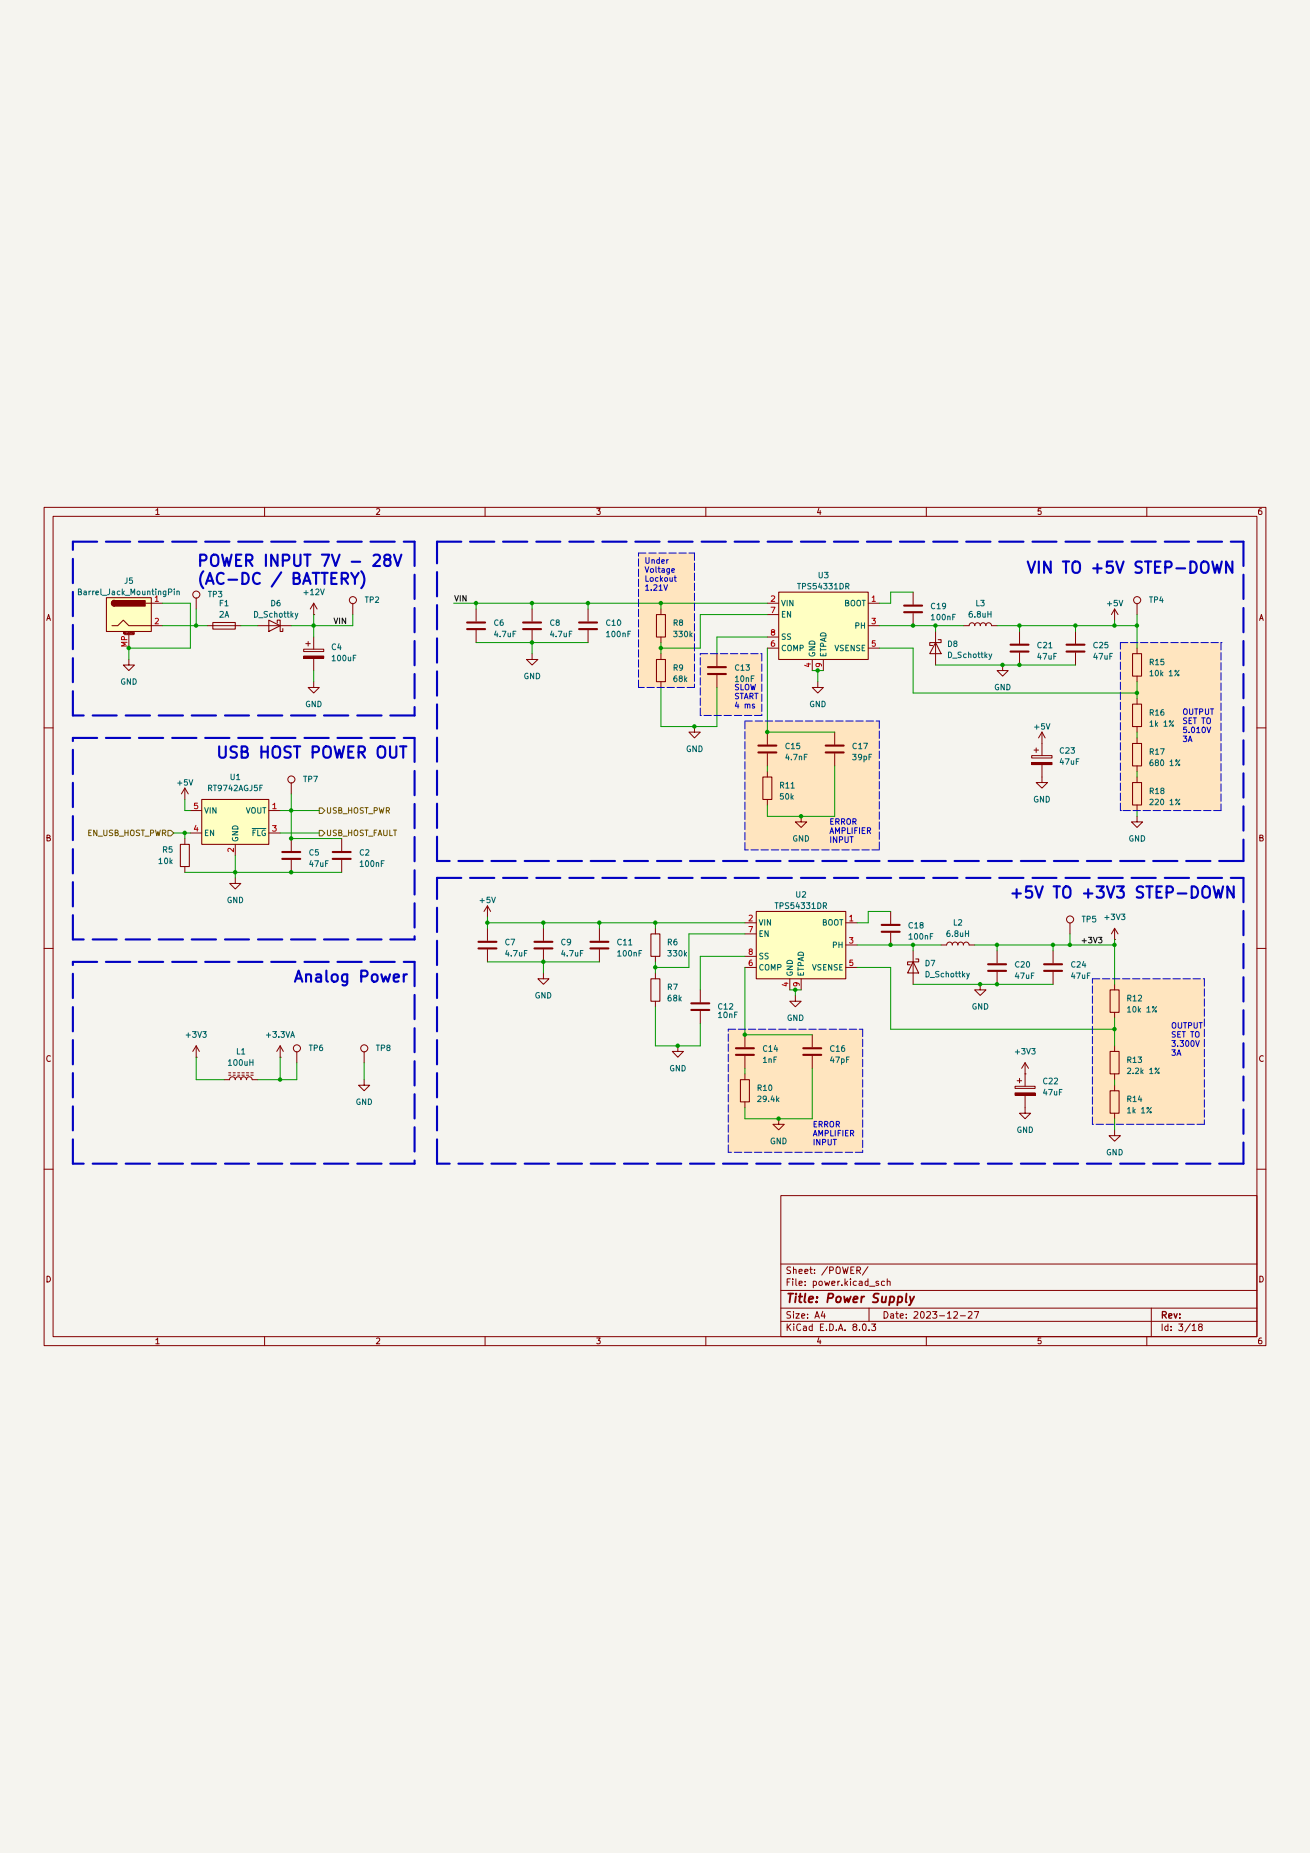
[picture p69: page 3]

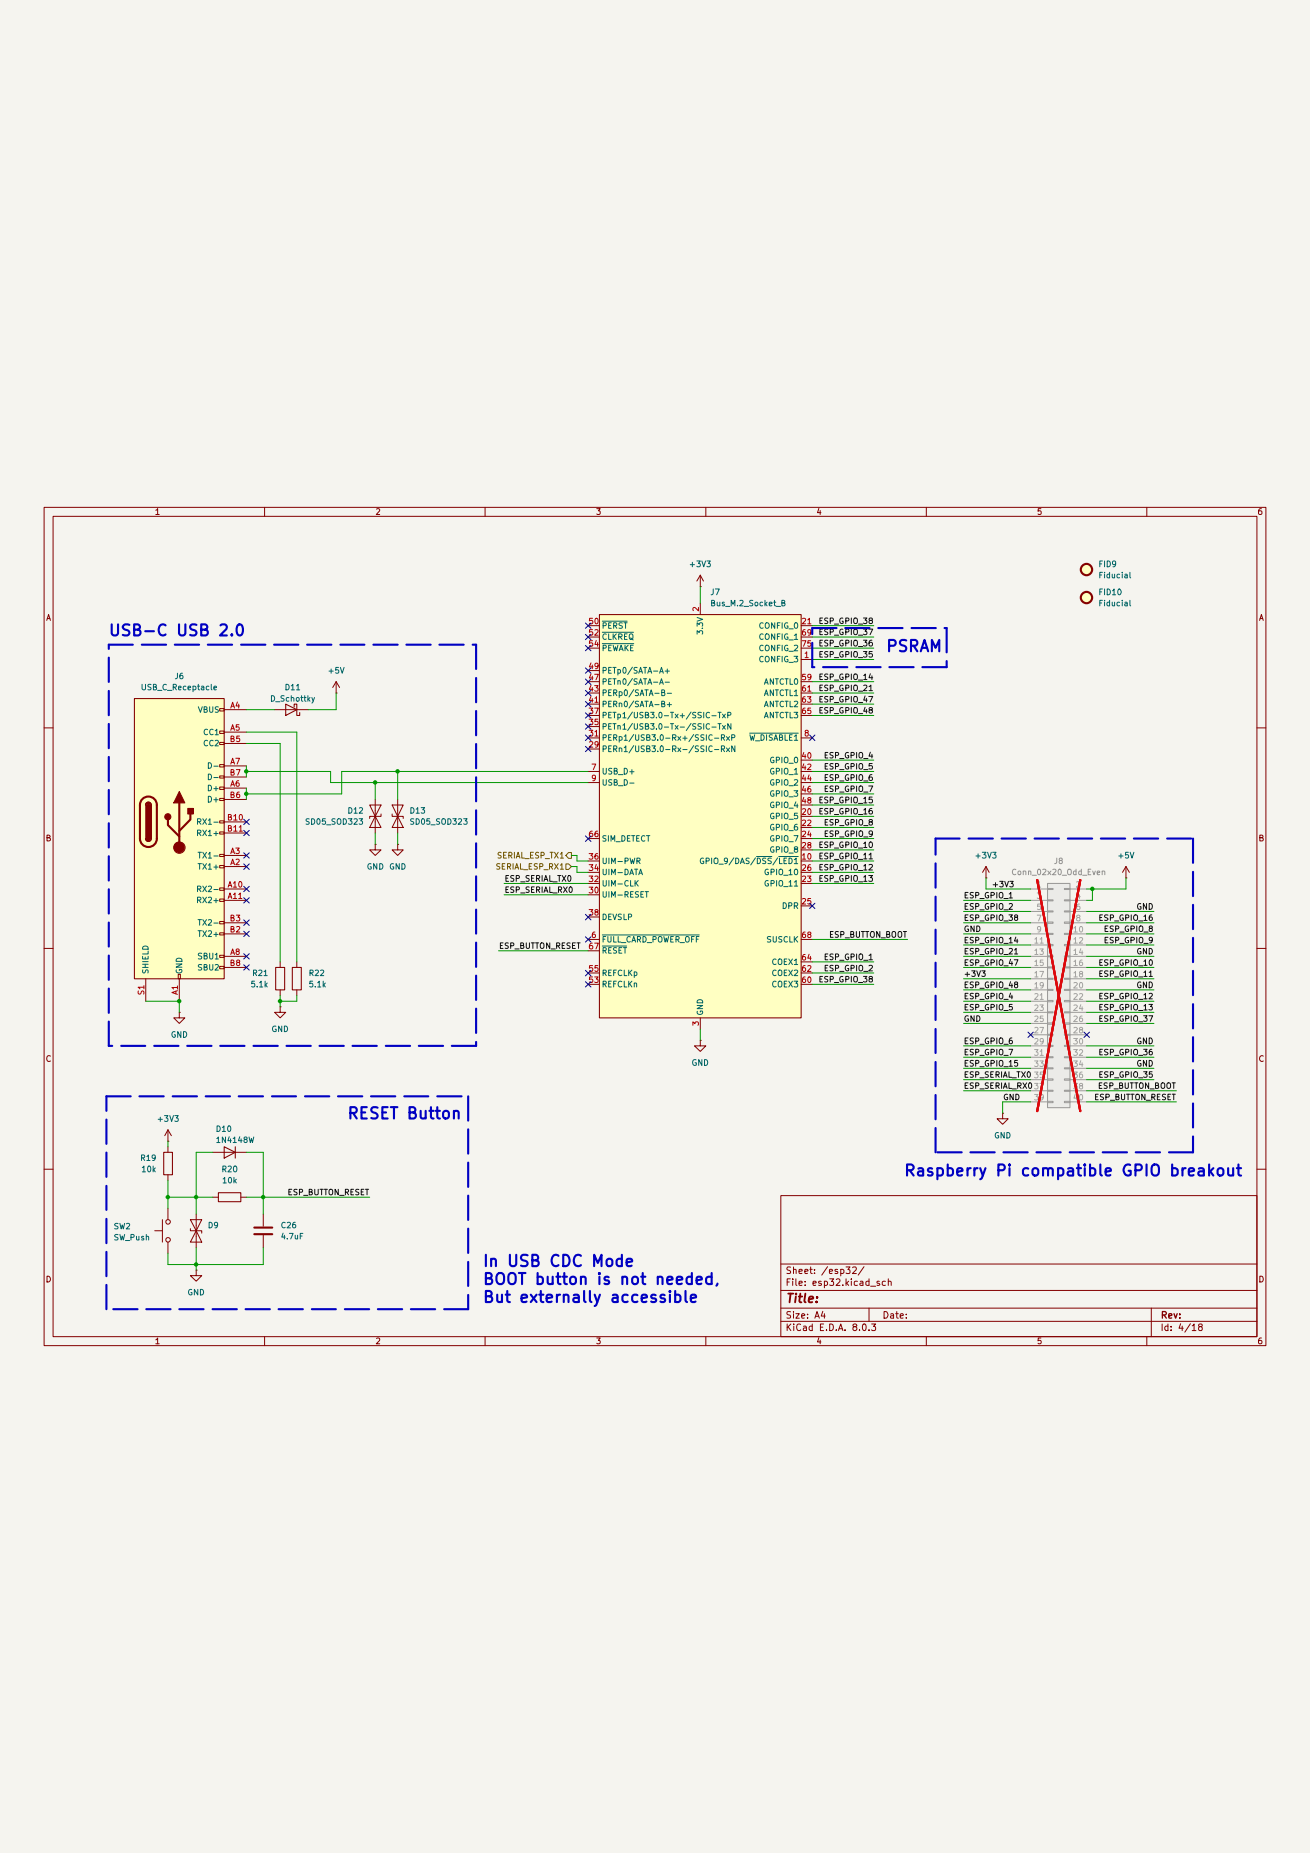
[picture p70: page 4]

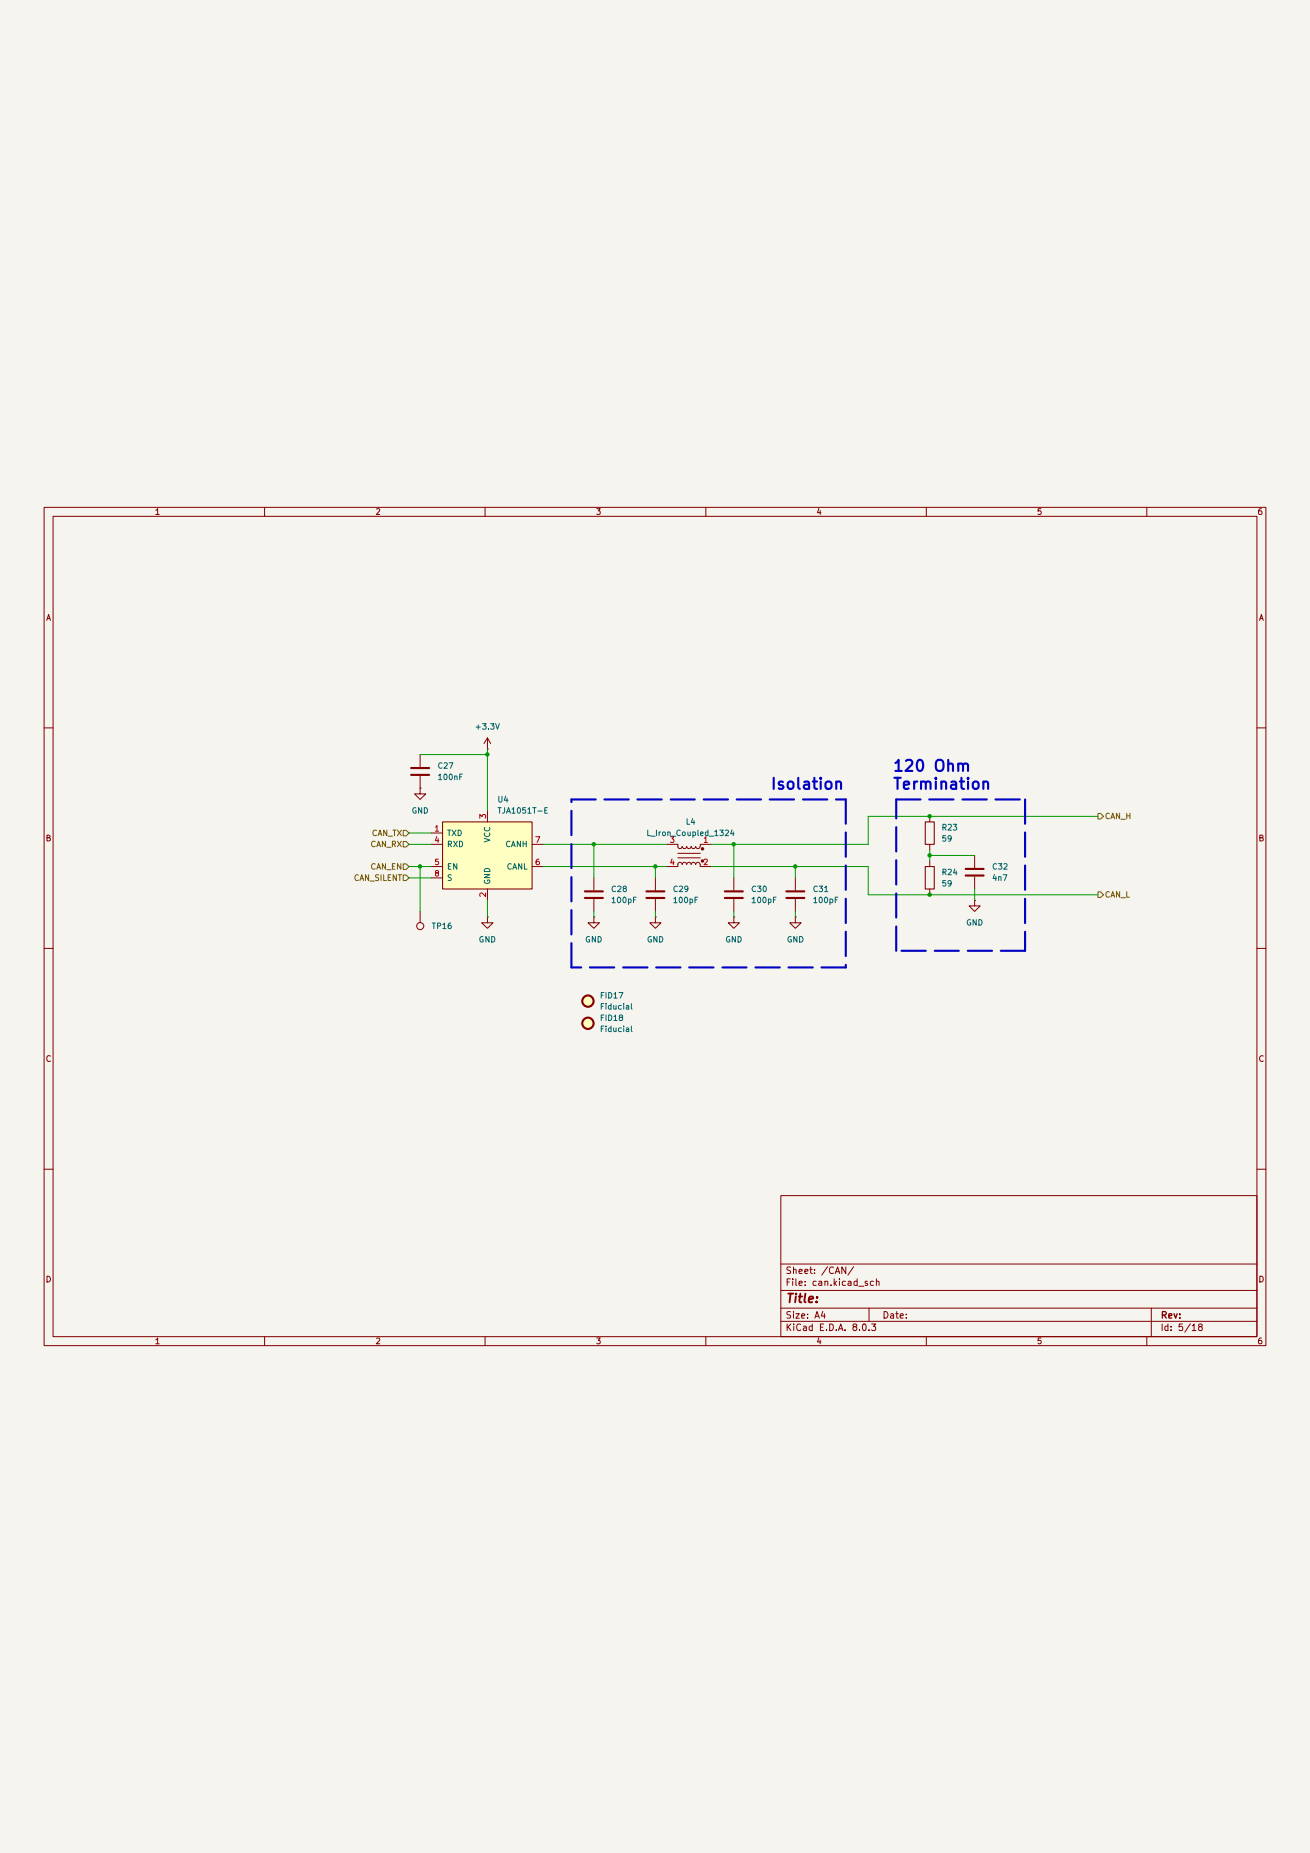
[picture p71: page 5]

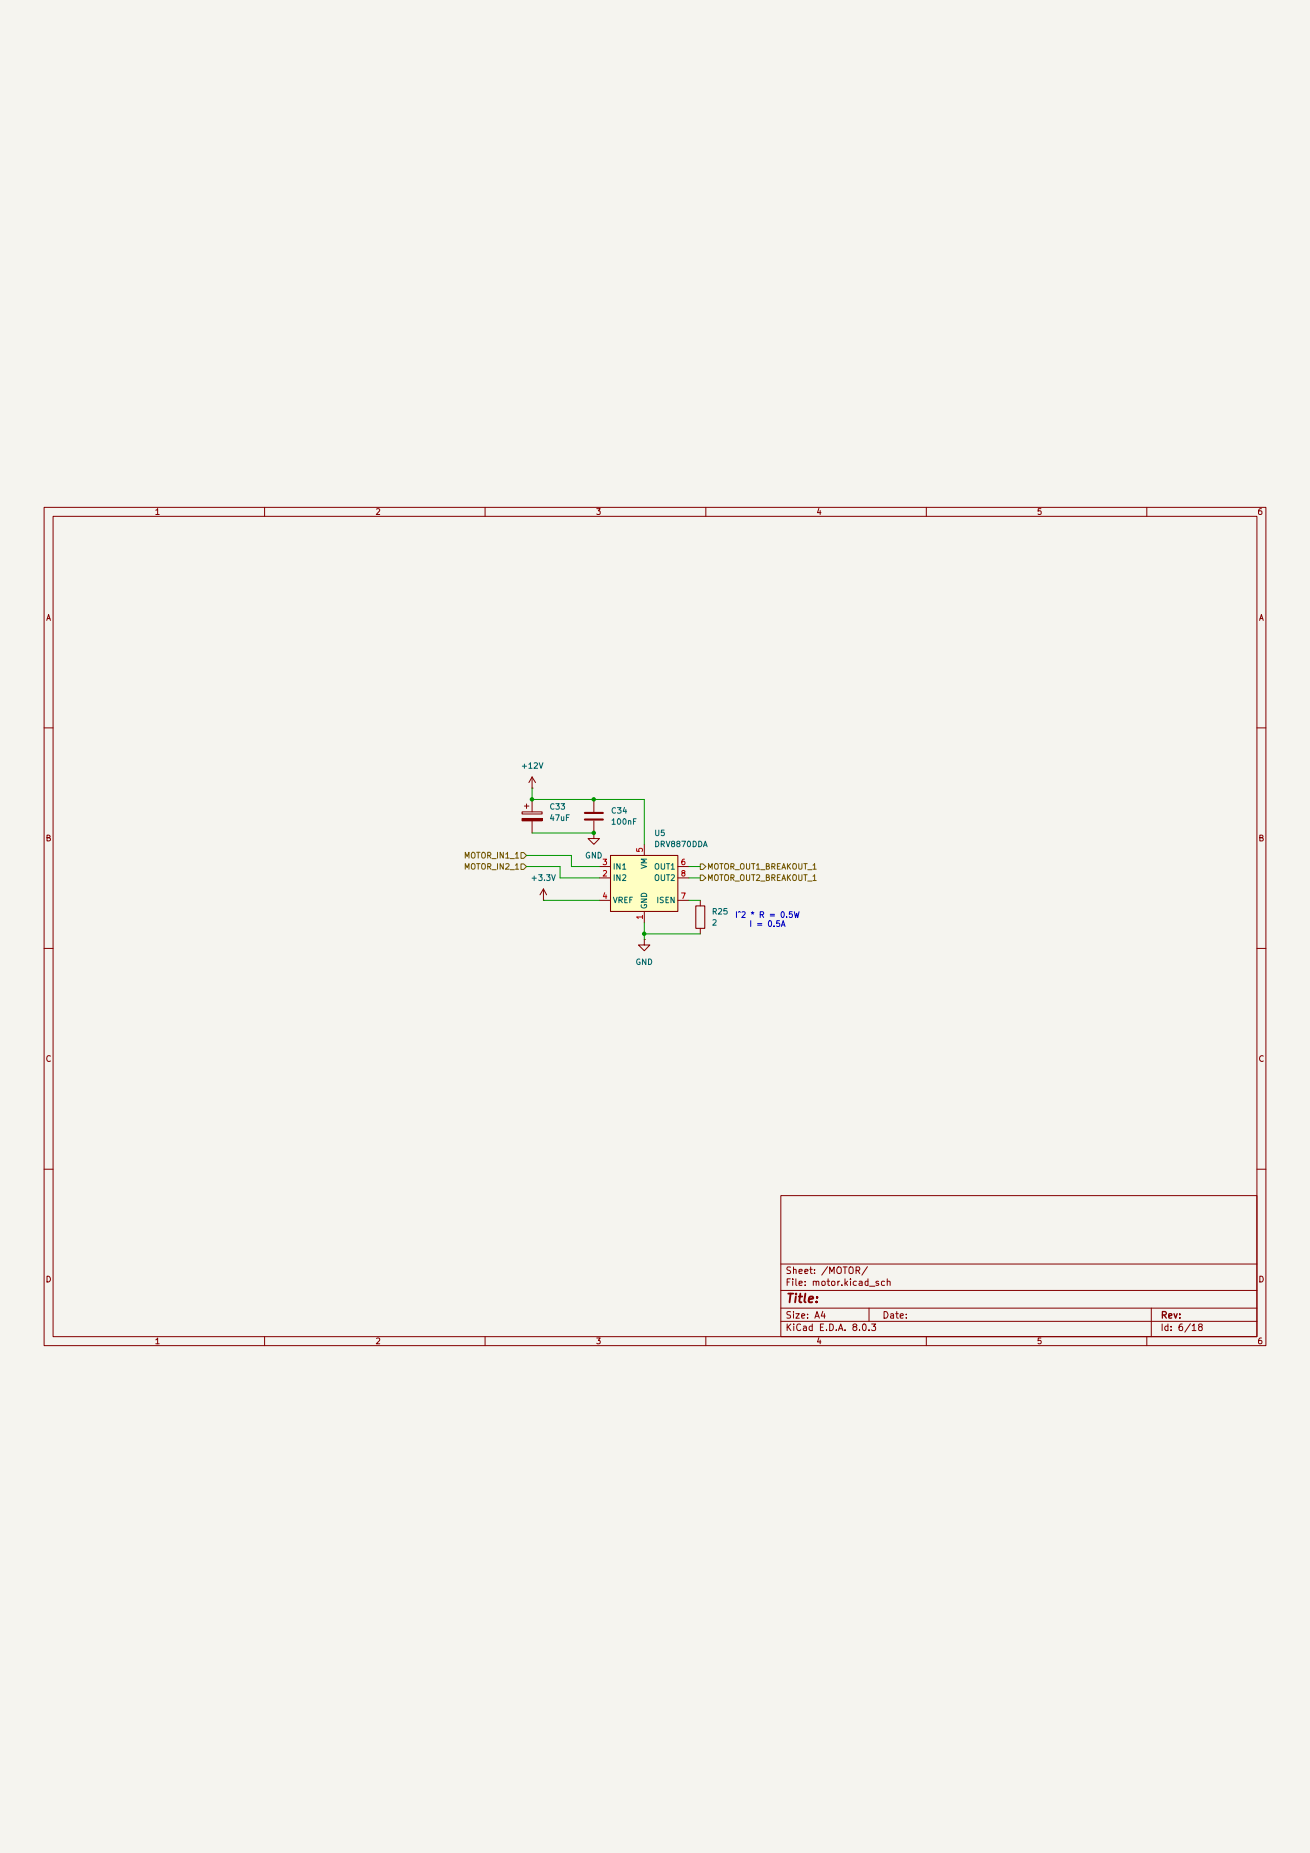
[picture p72: page 6]

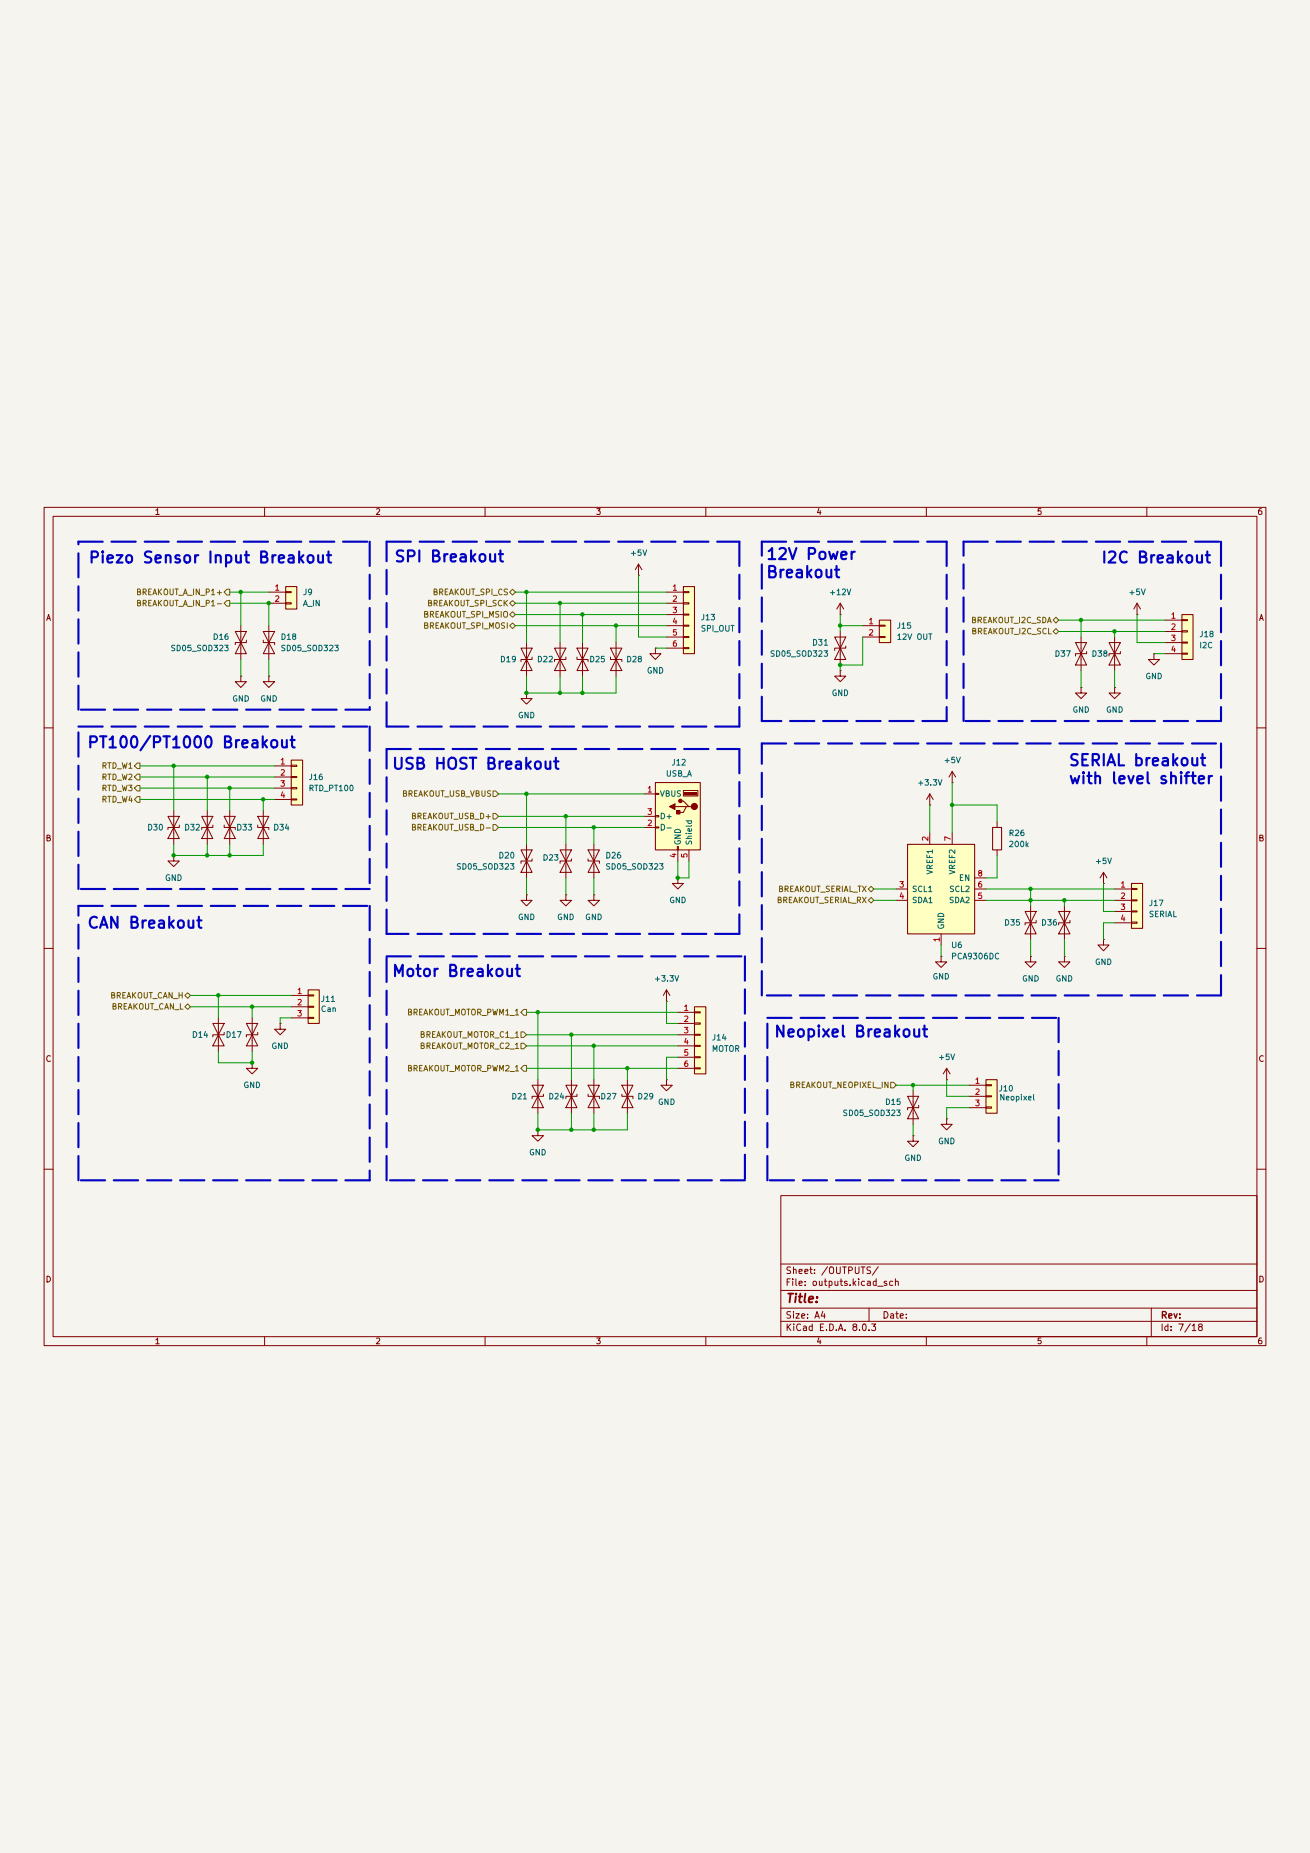
[picture p73: page 7]

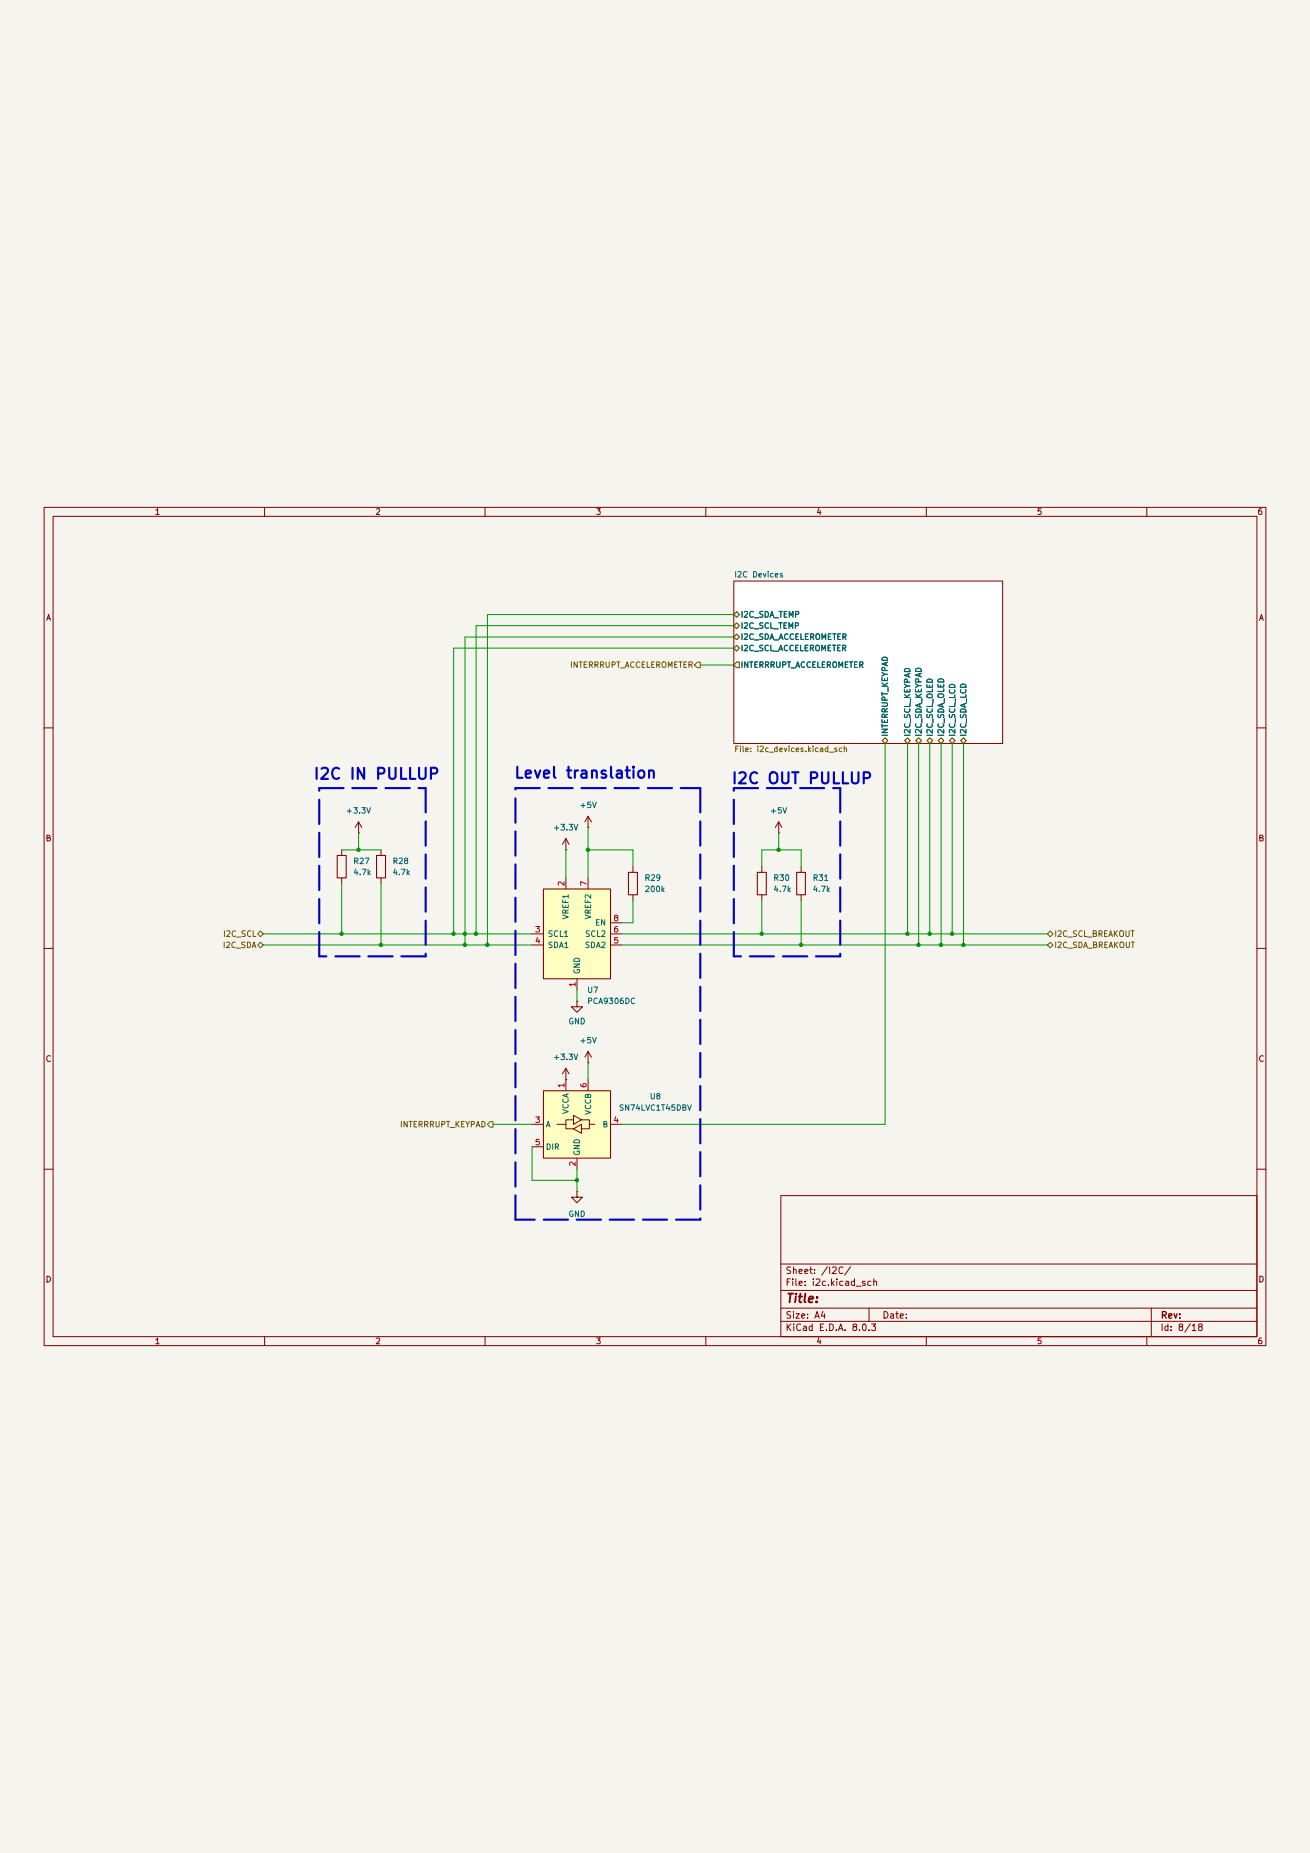
[picture p74: page 8]

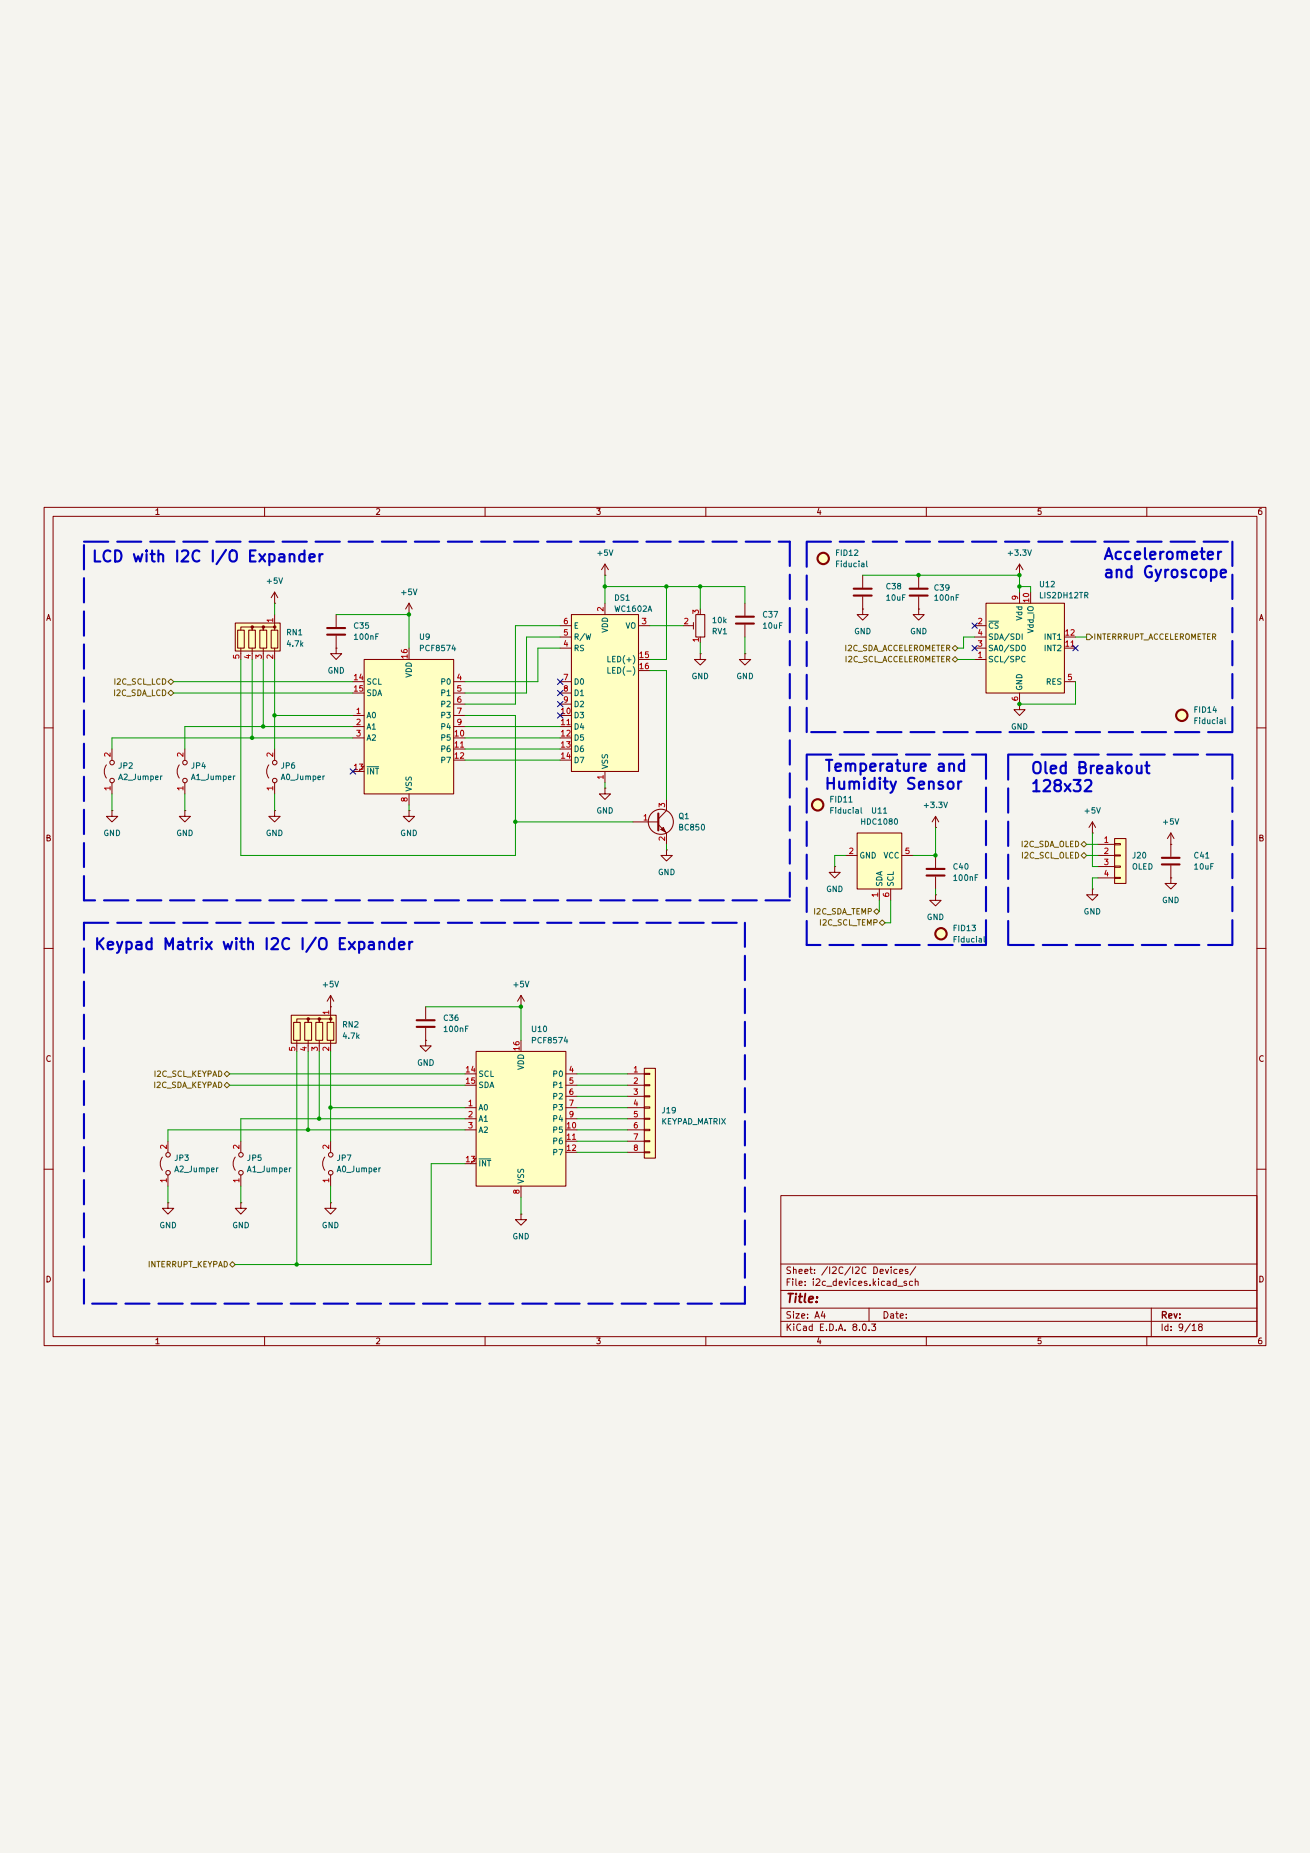
[picture p75: page 9]

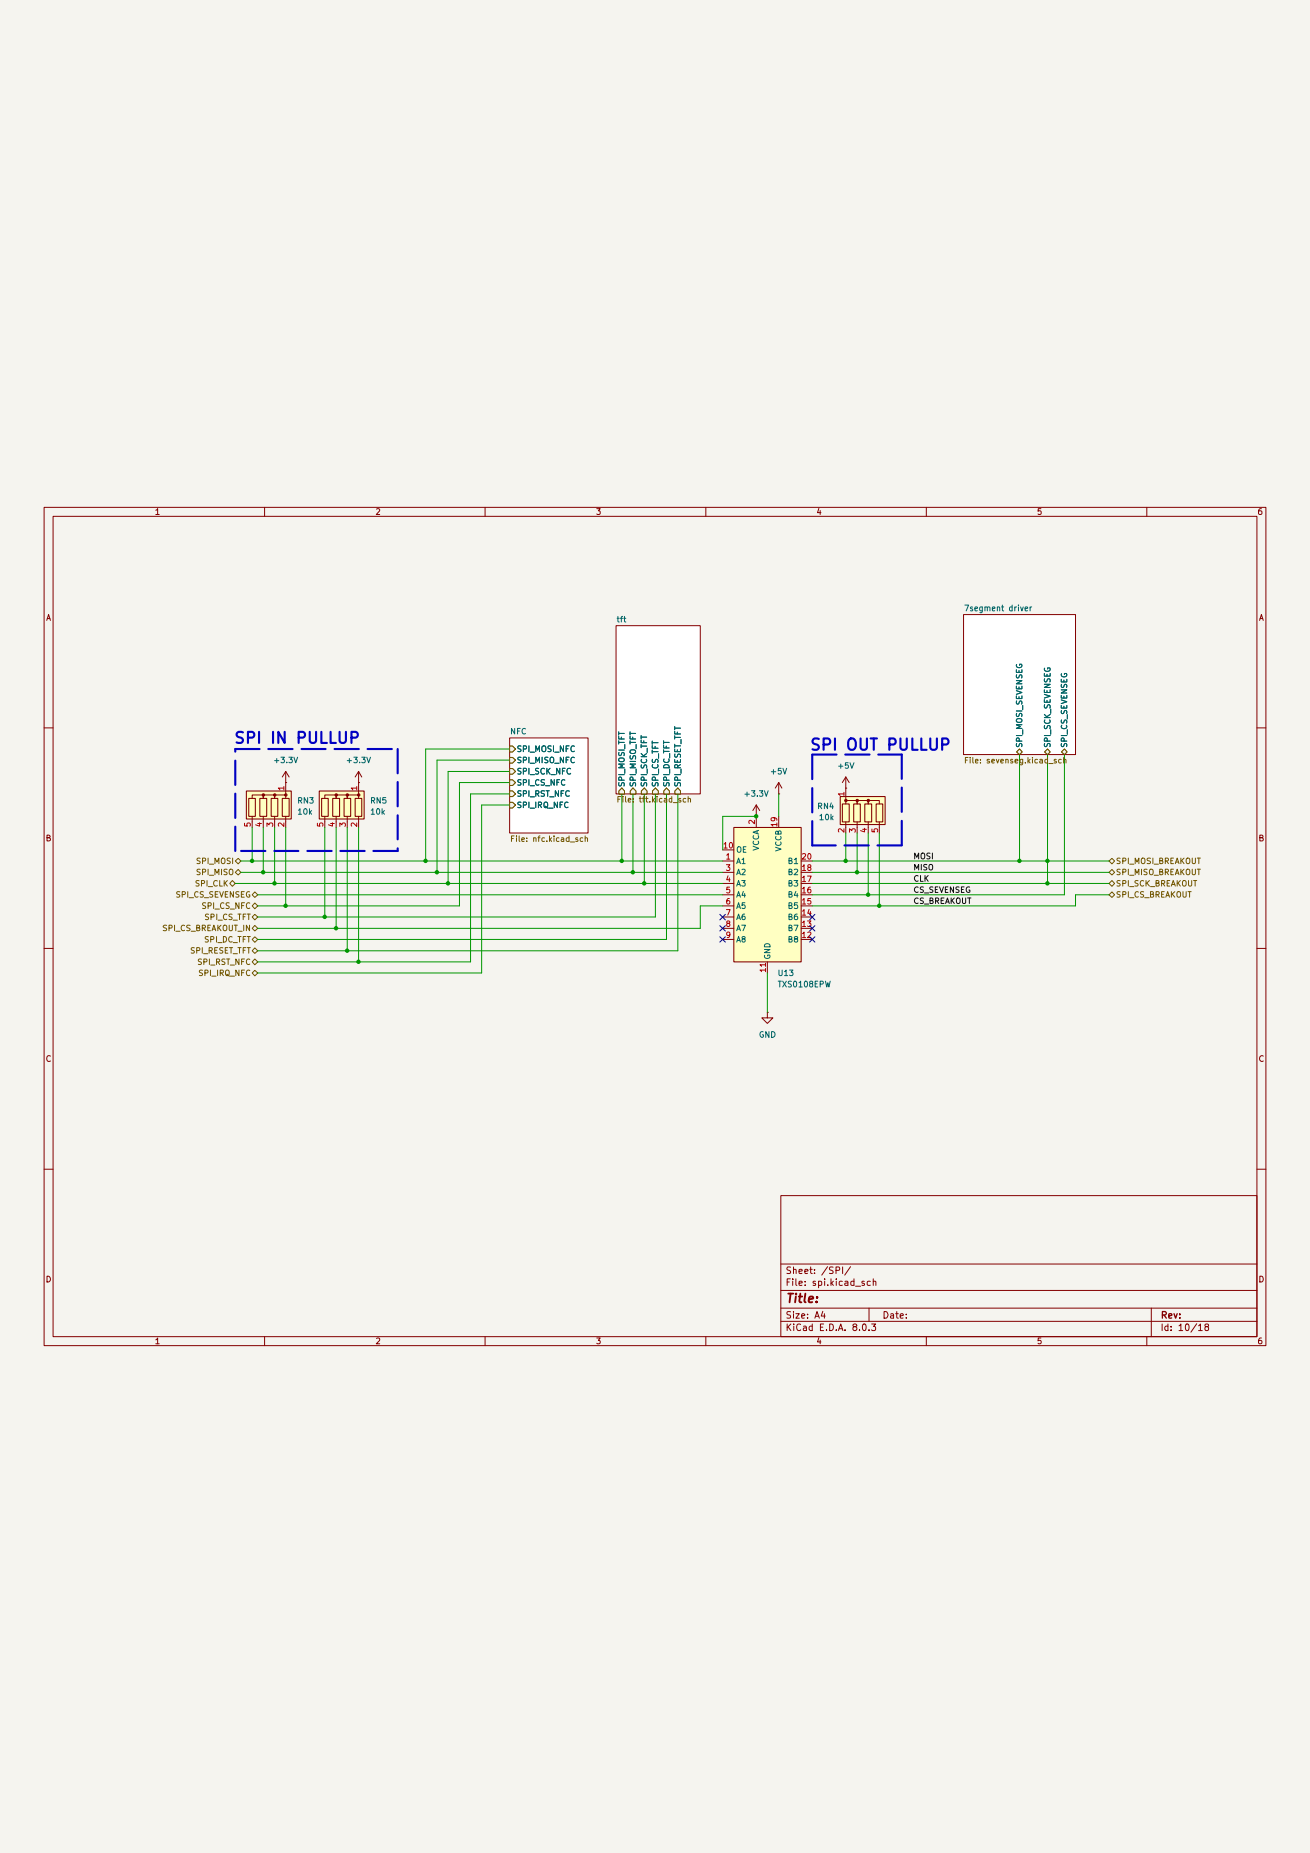
[picture p76: page 10]

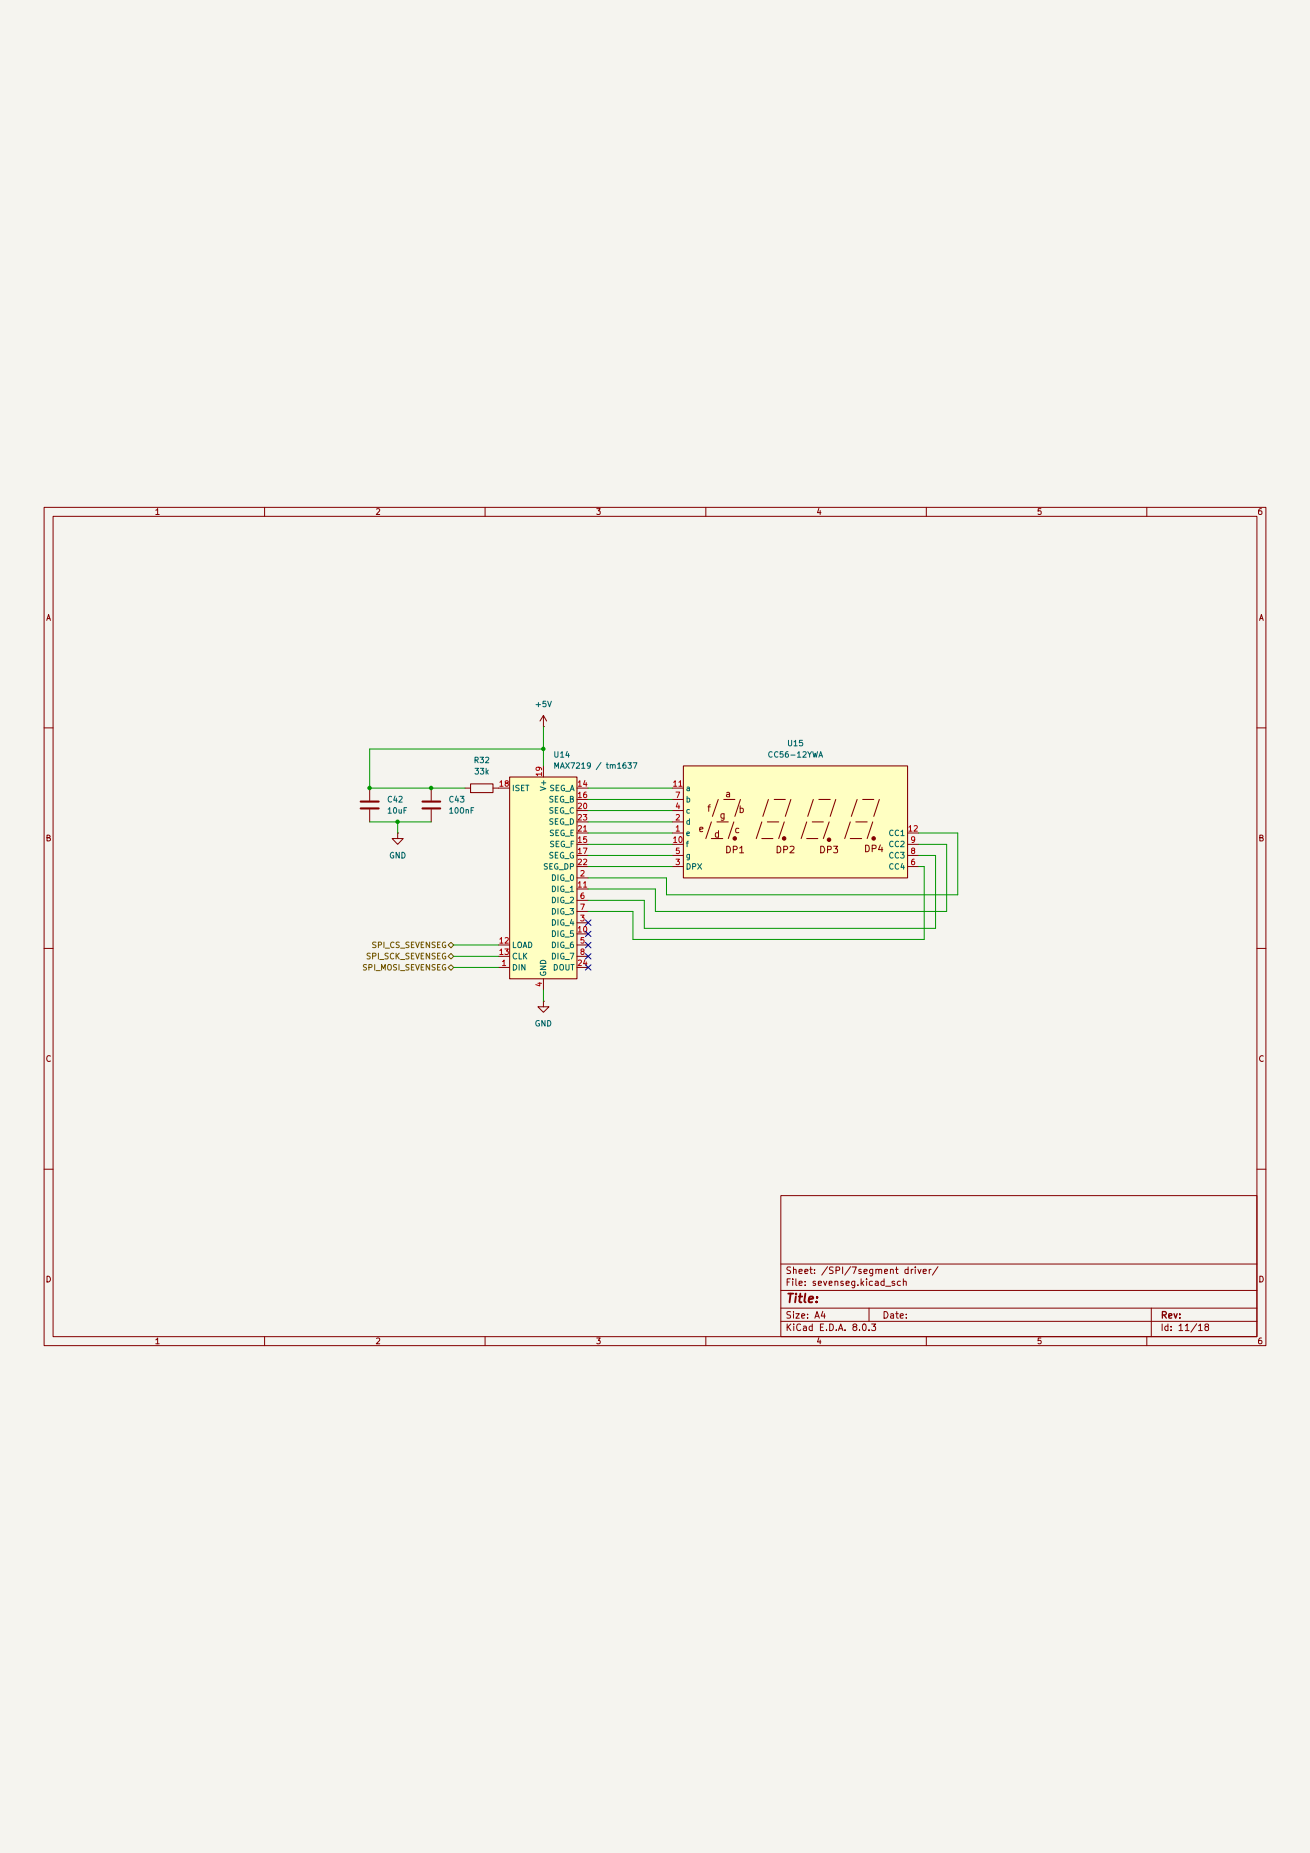
[picture p77: page 11]

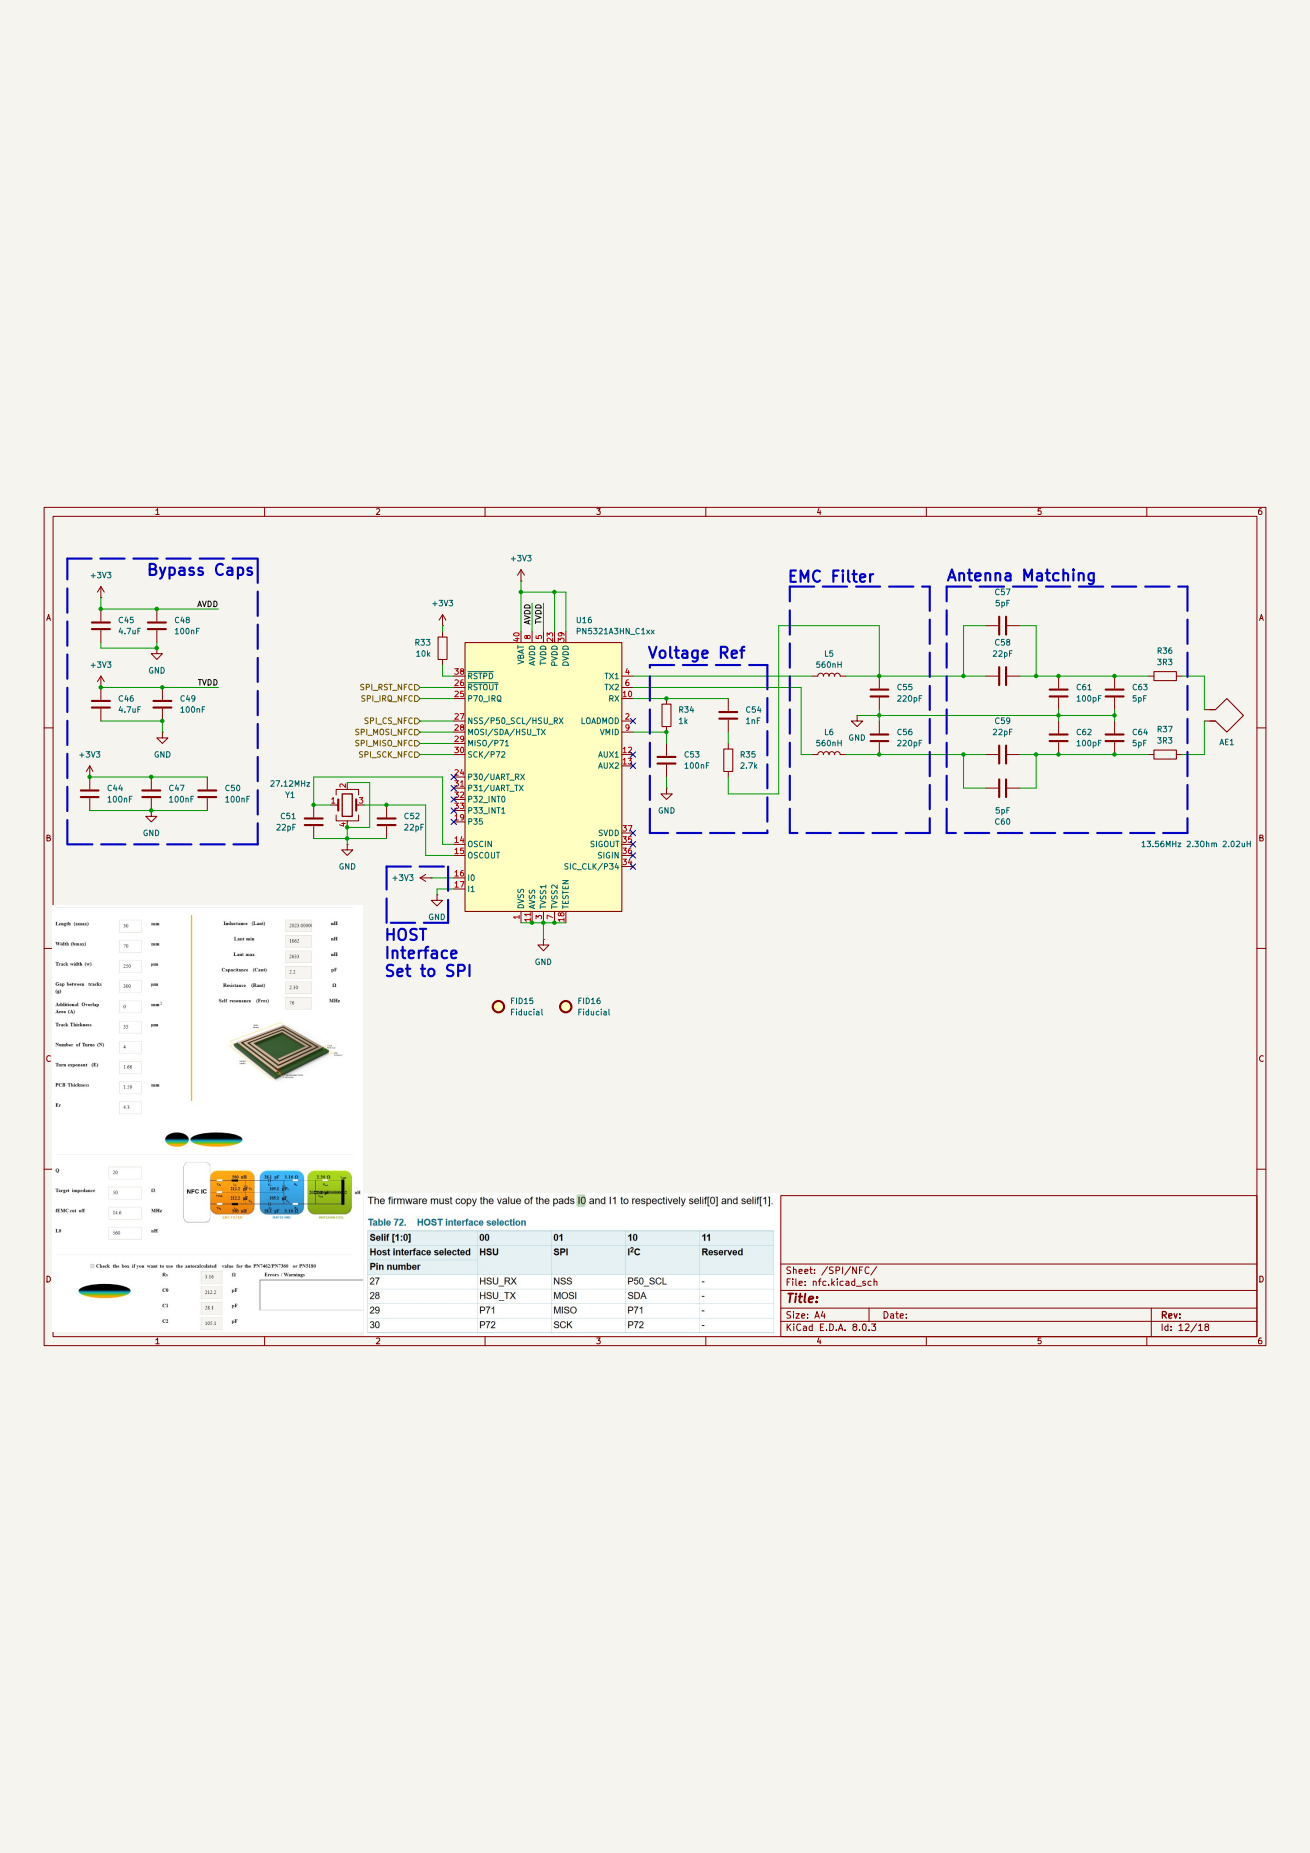
[picture p78: page 12]

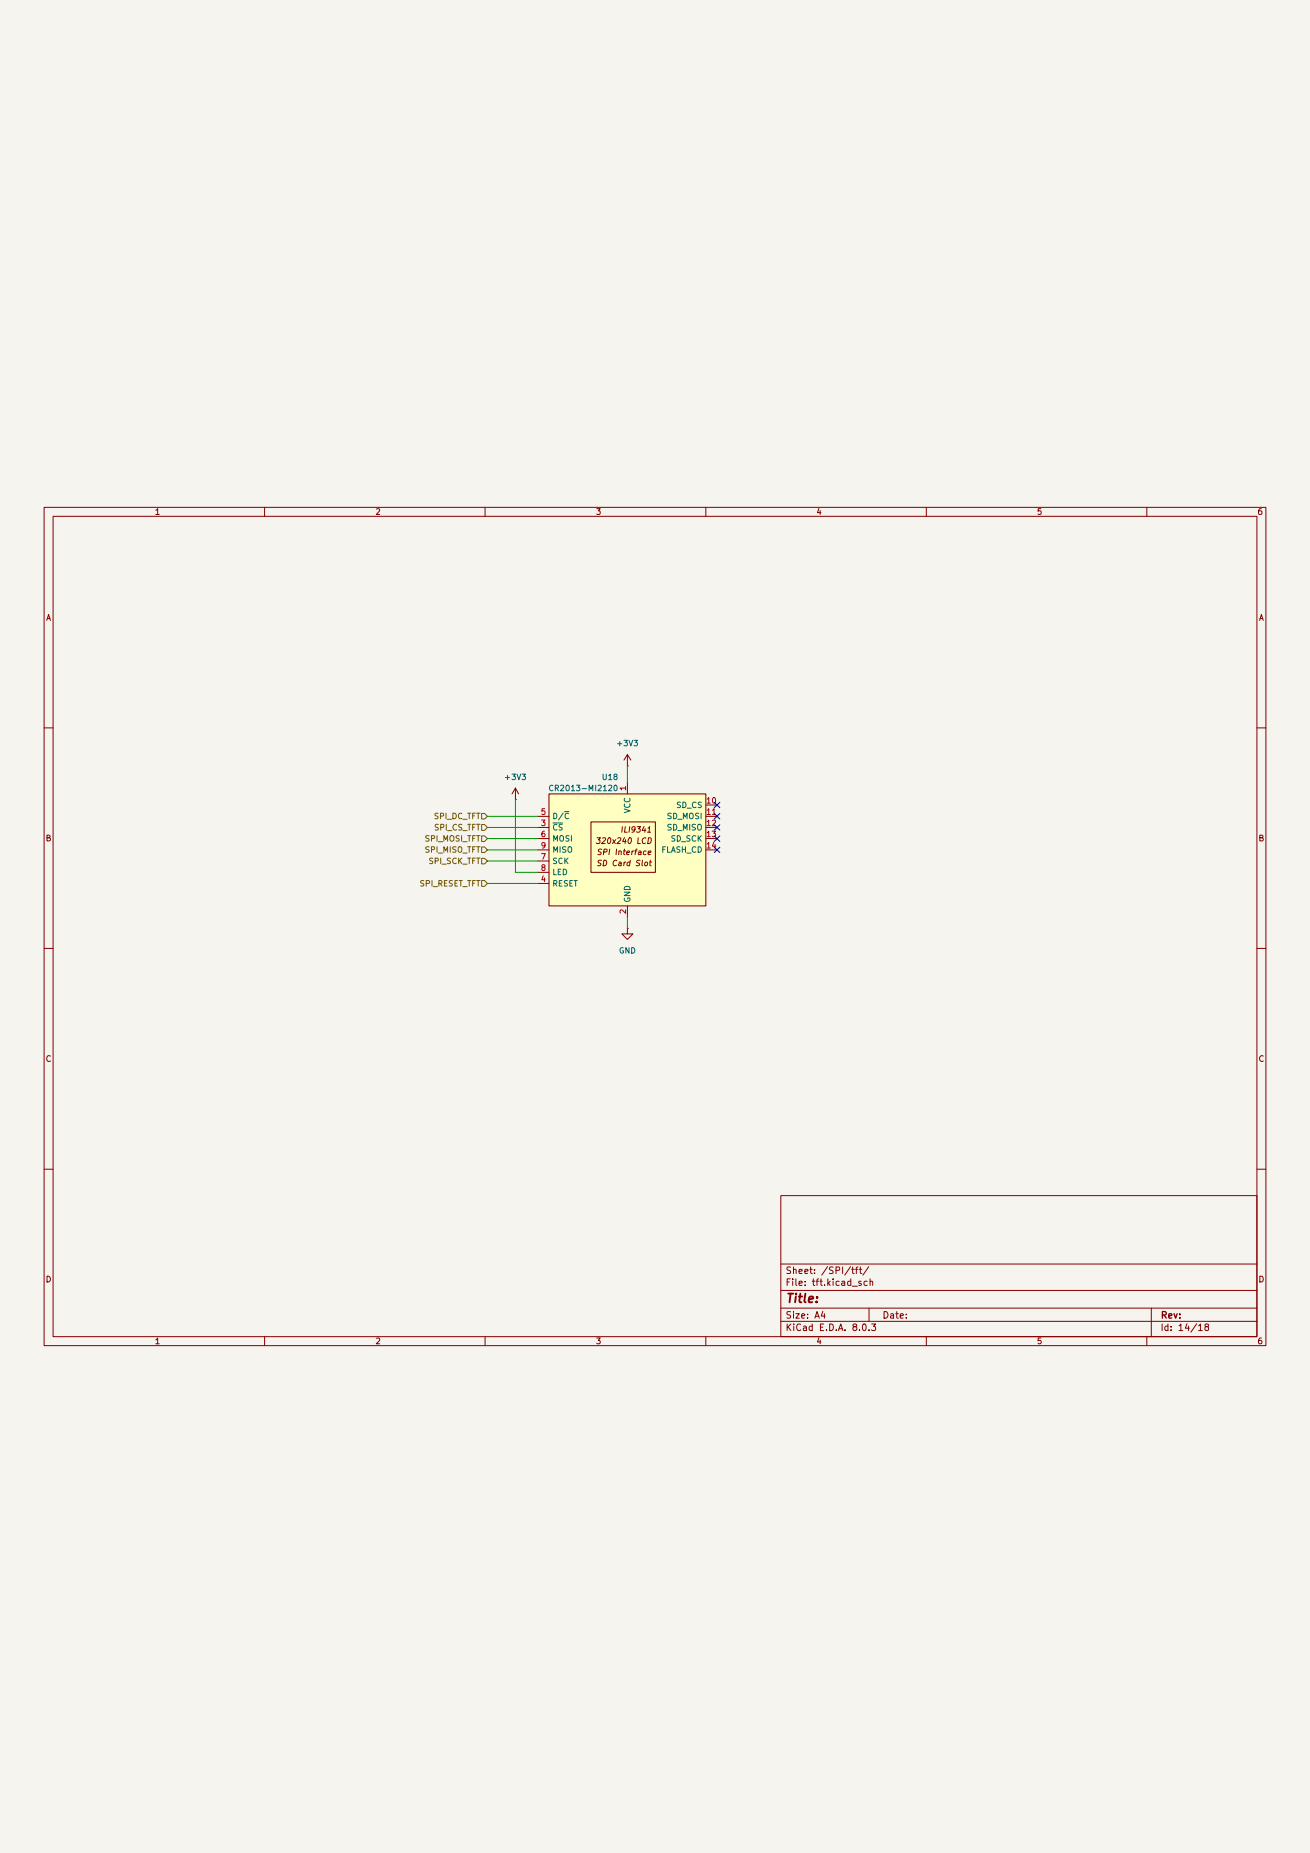
[picture p79: page 13]

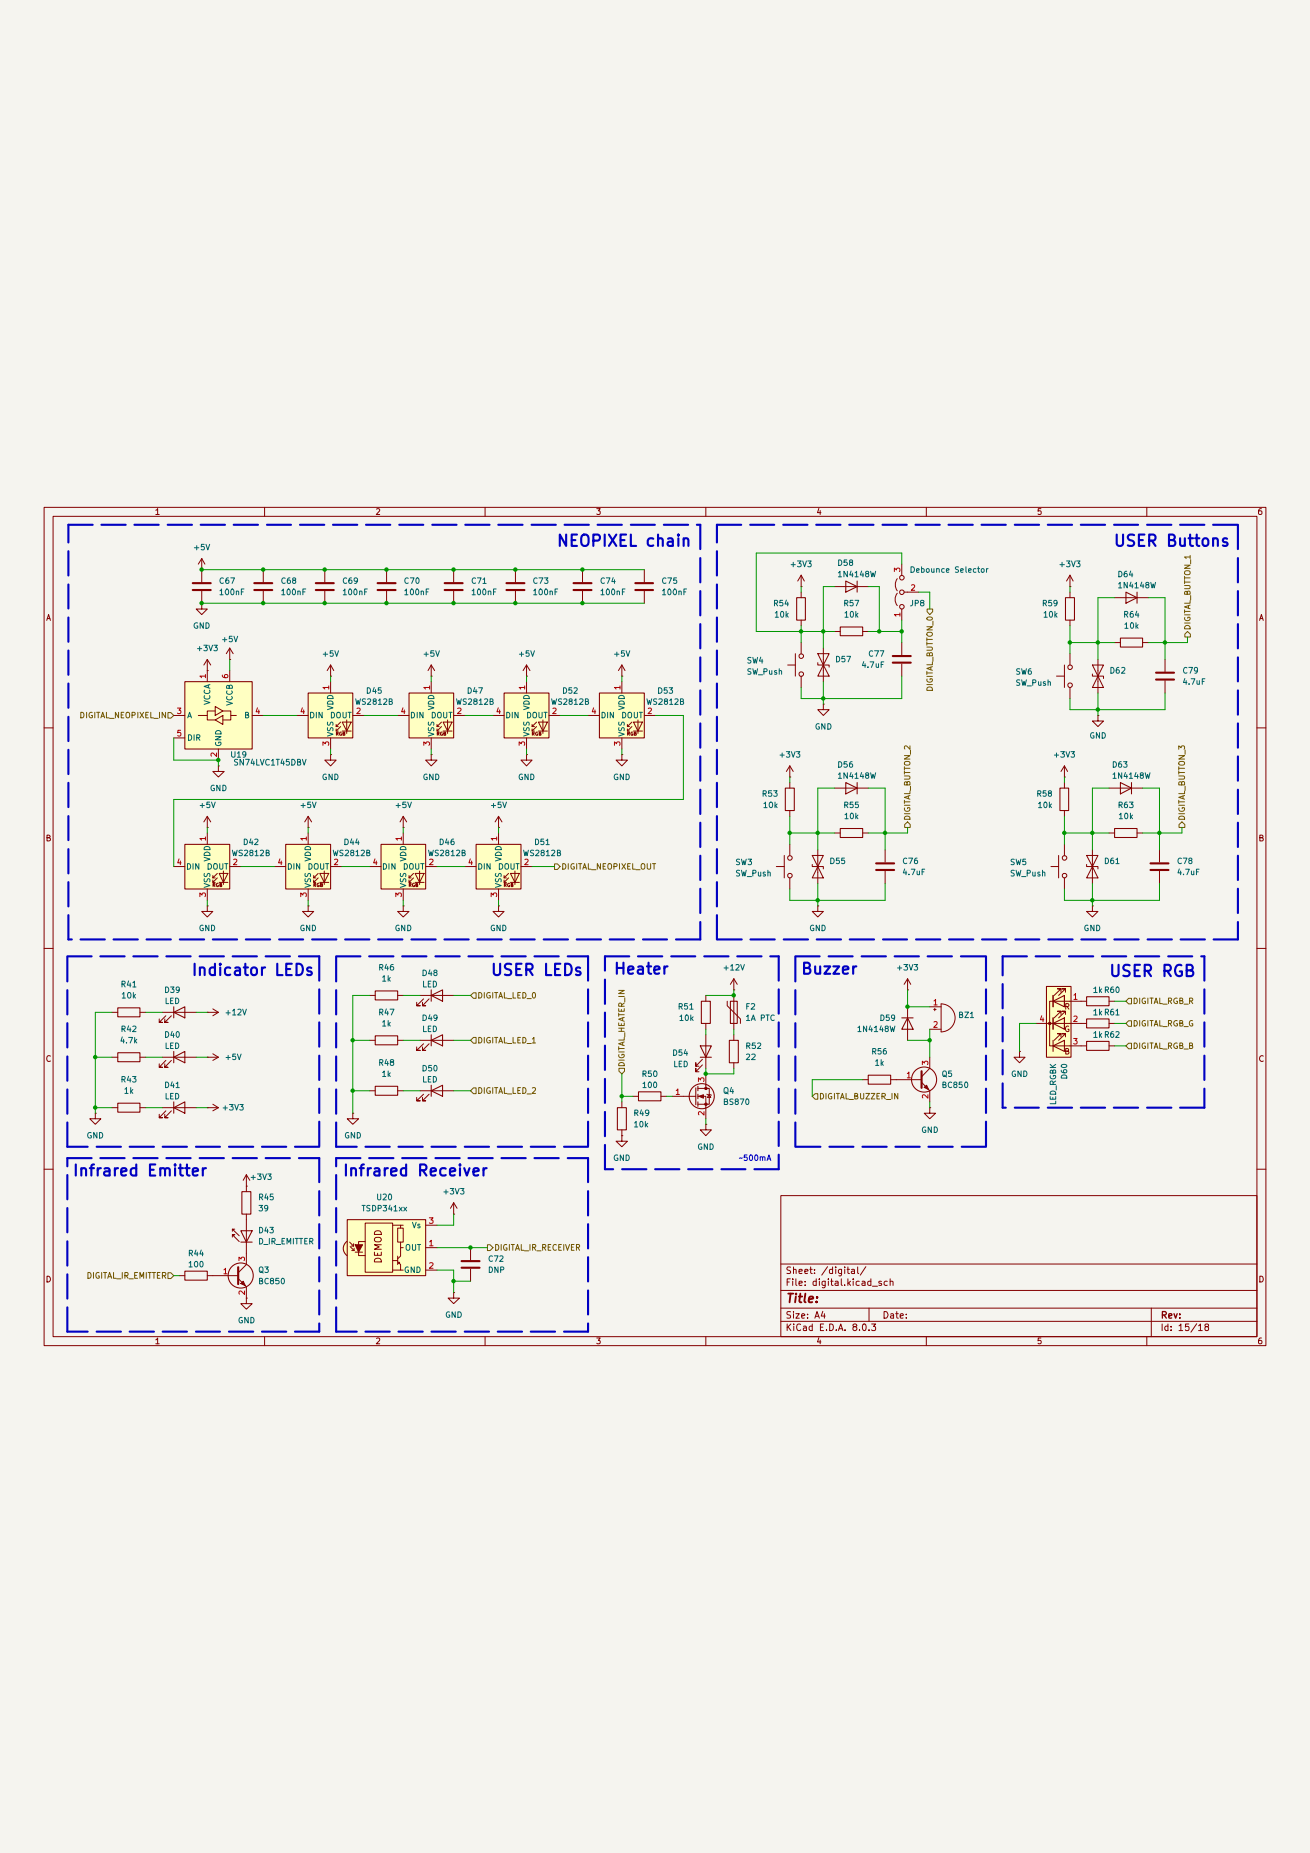
[picture p80: page 14]

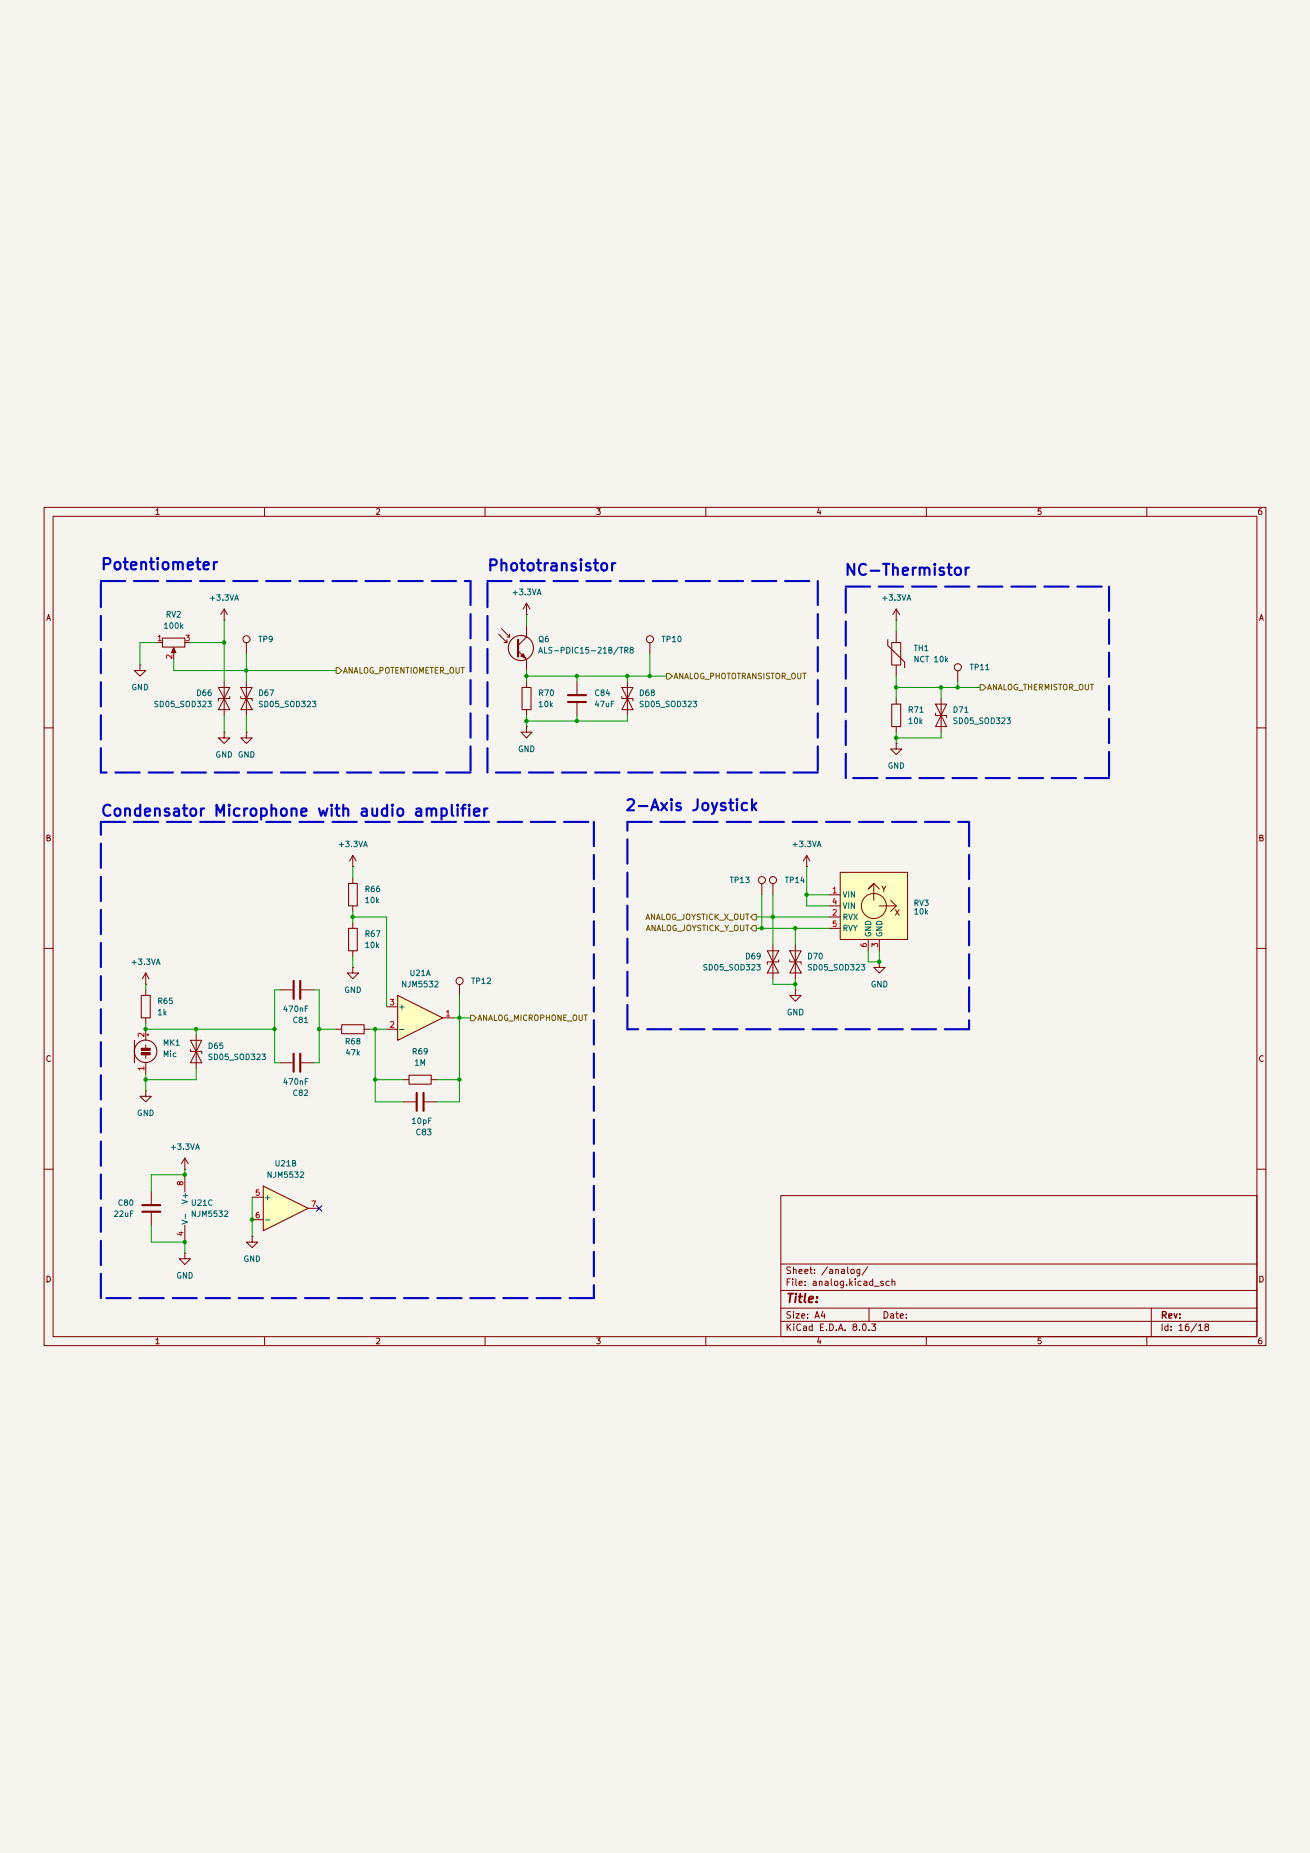
[picture p81: page 15]

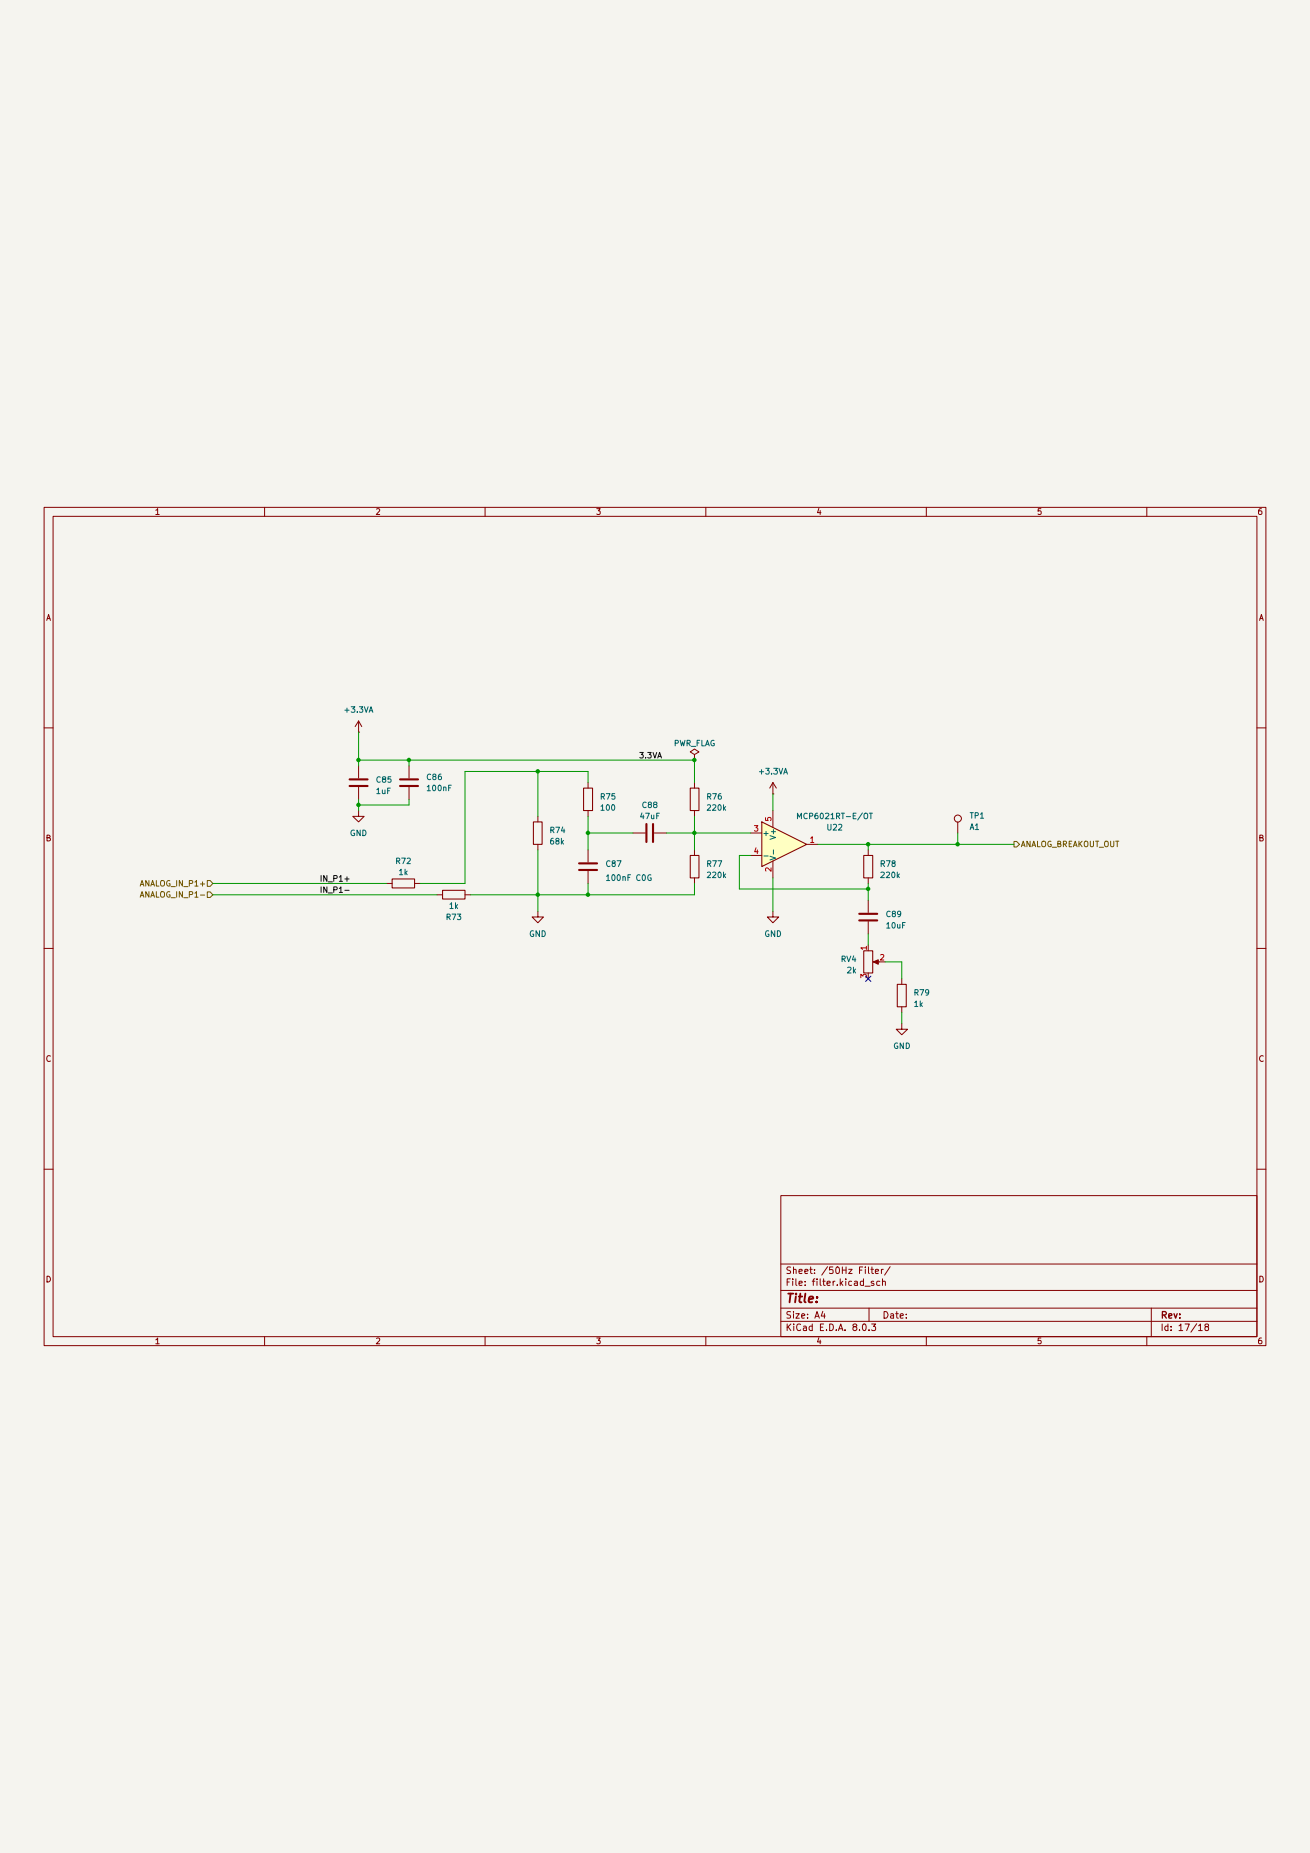
[picture p82: page 16]

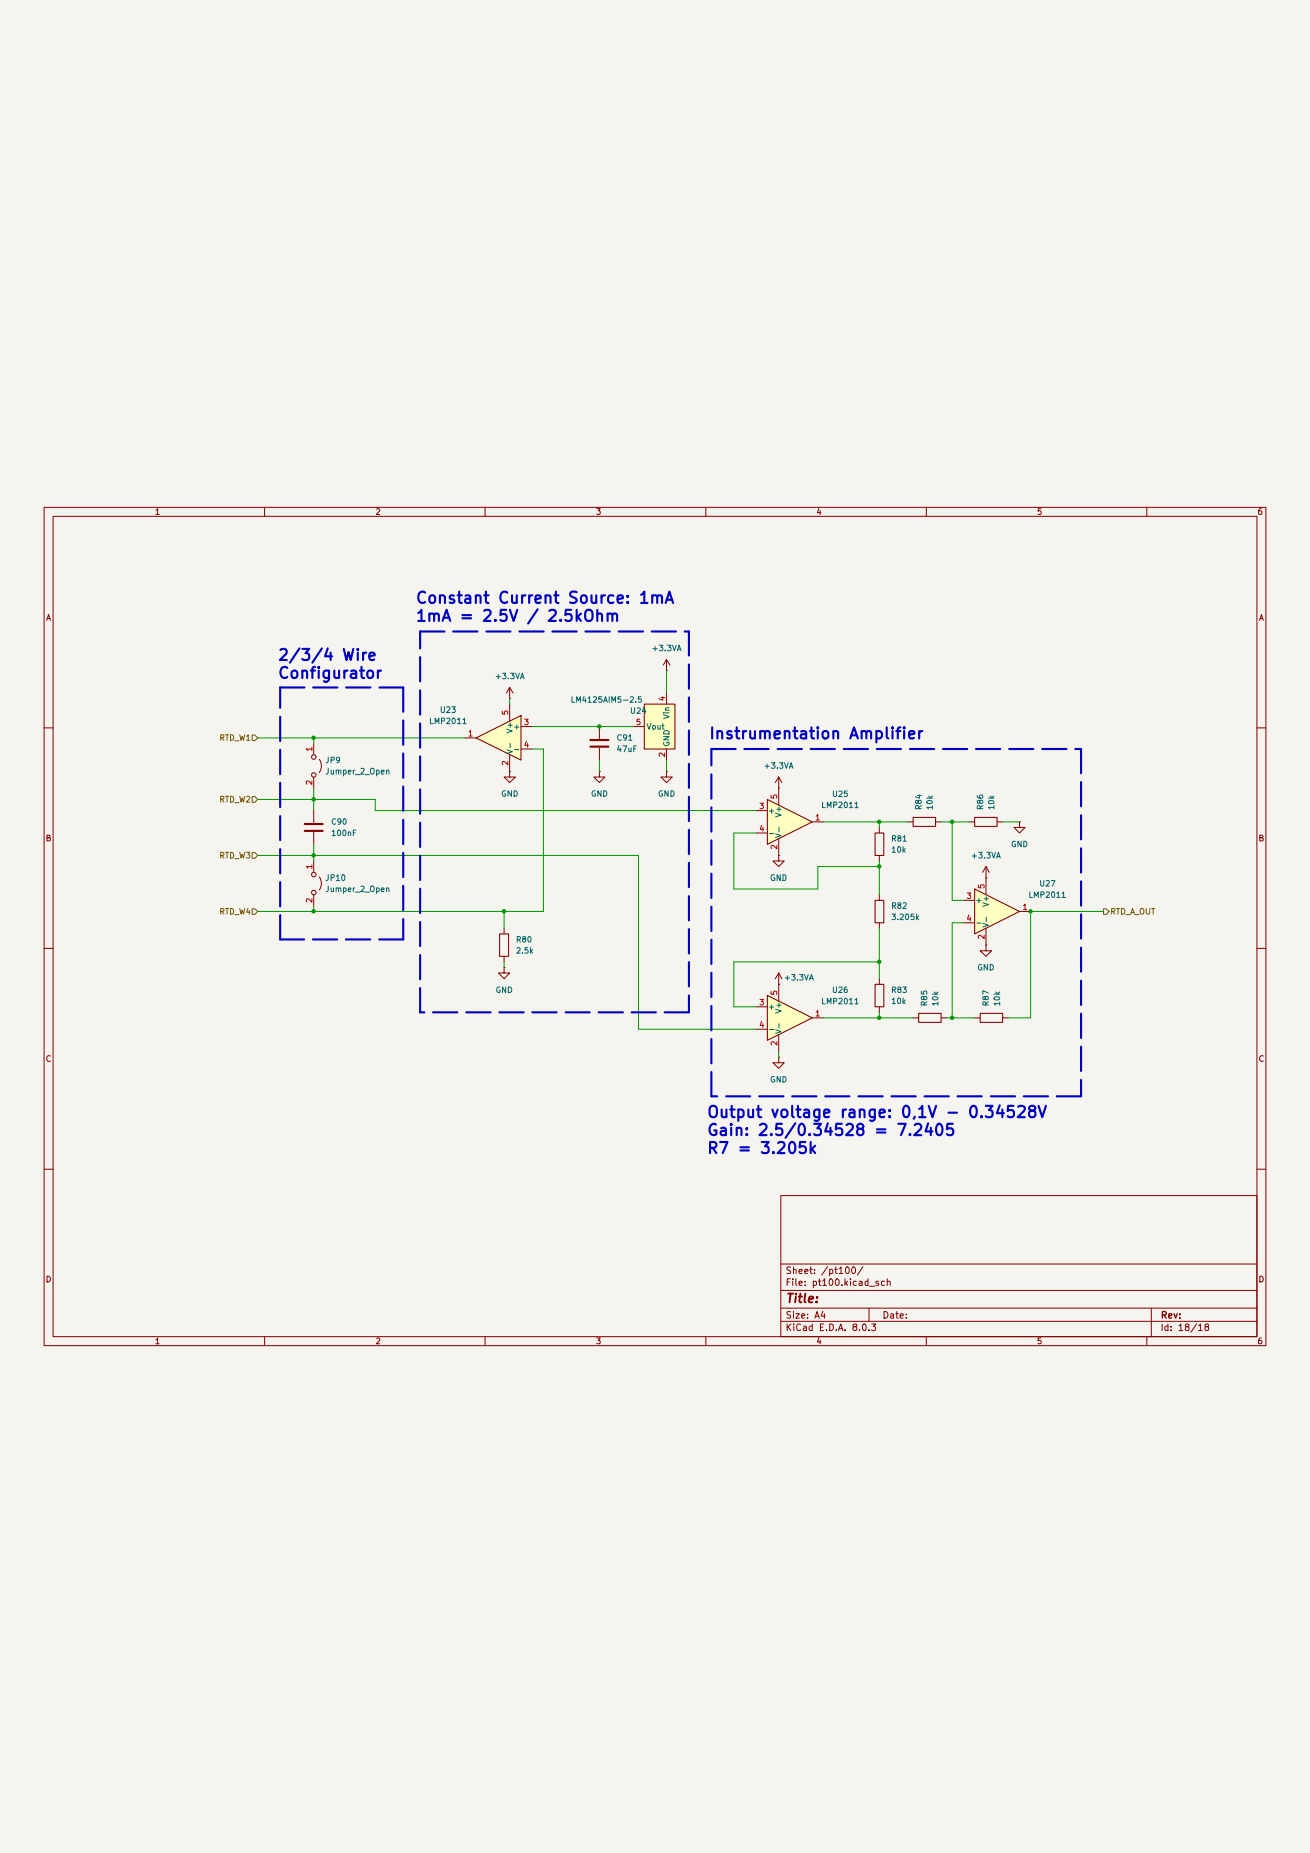
[picture p83: page 17]

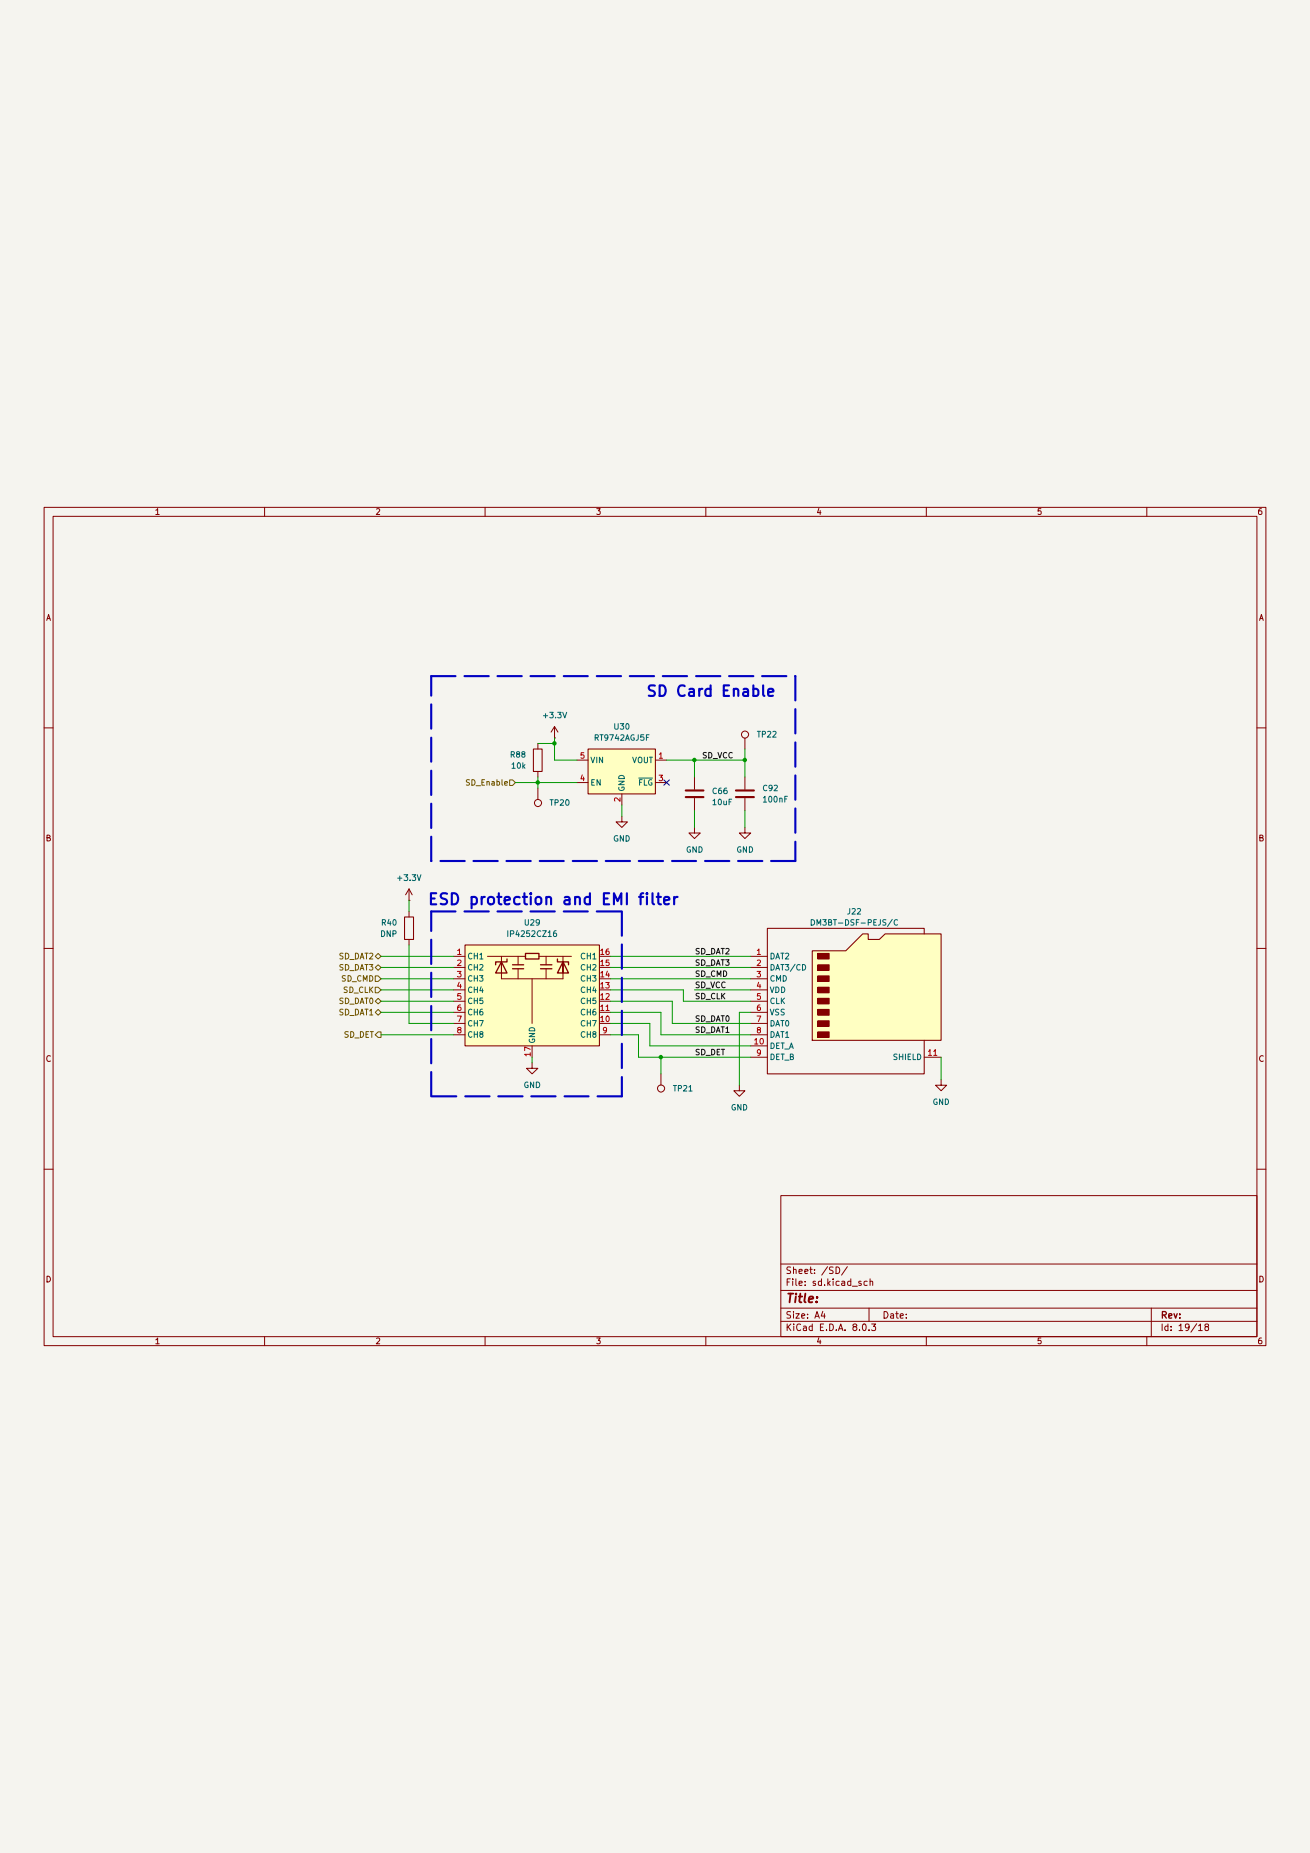
[picture p84: page 18]
