mark69163/prodigy/PRODIGY-MOTHERBOARD/Archive/motherboard_schematic.pdf

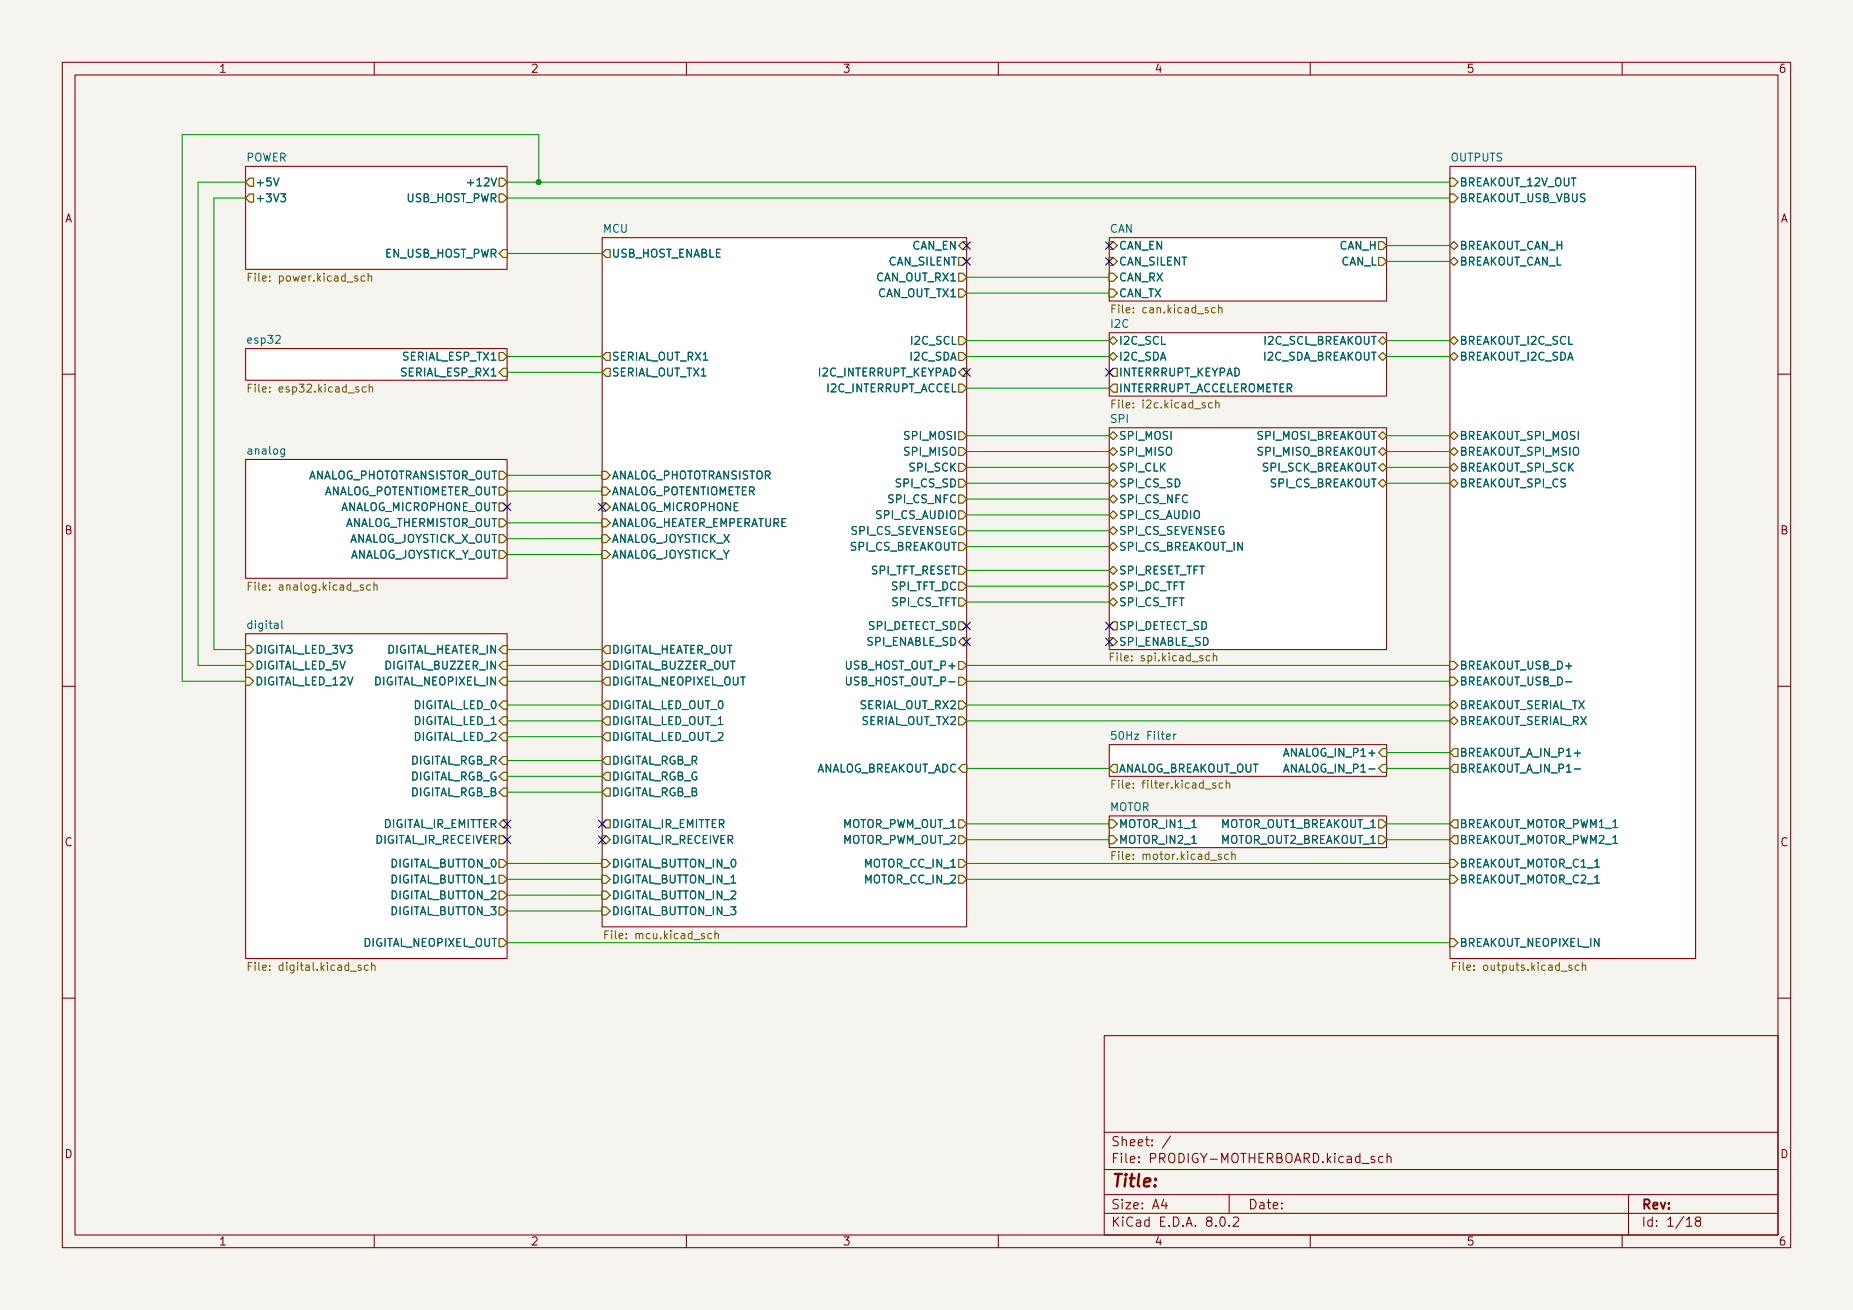
[picture p85: page 1]

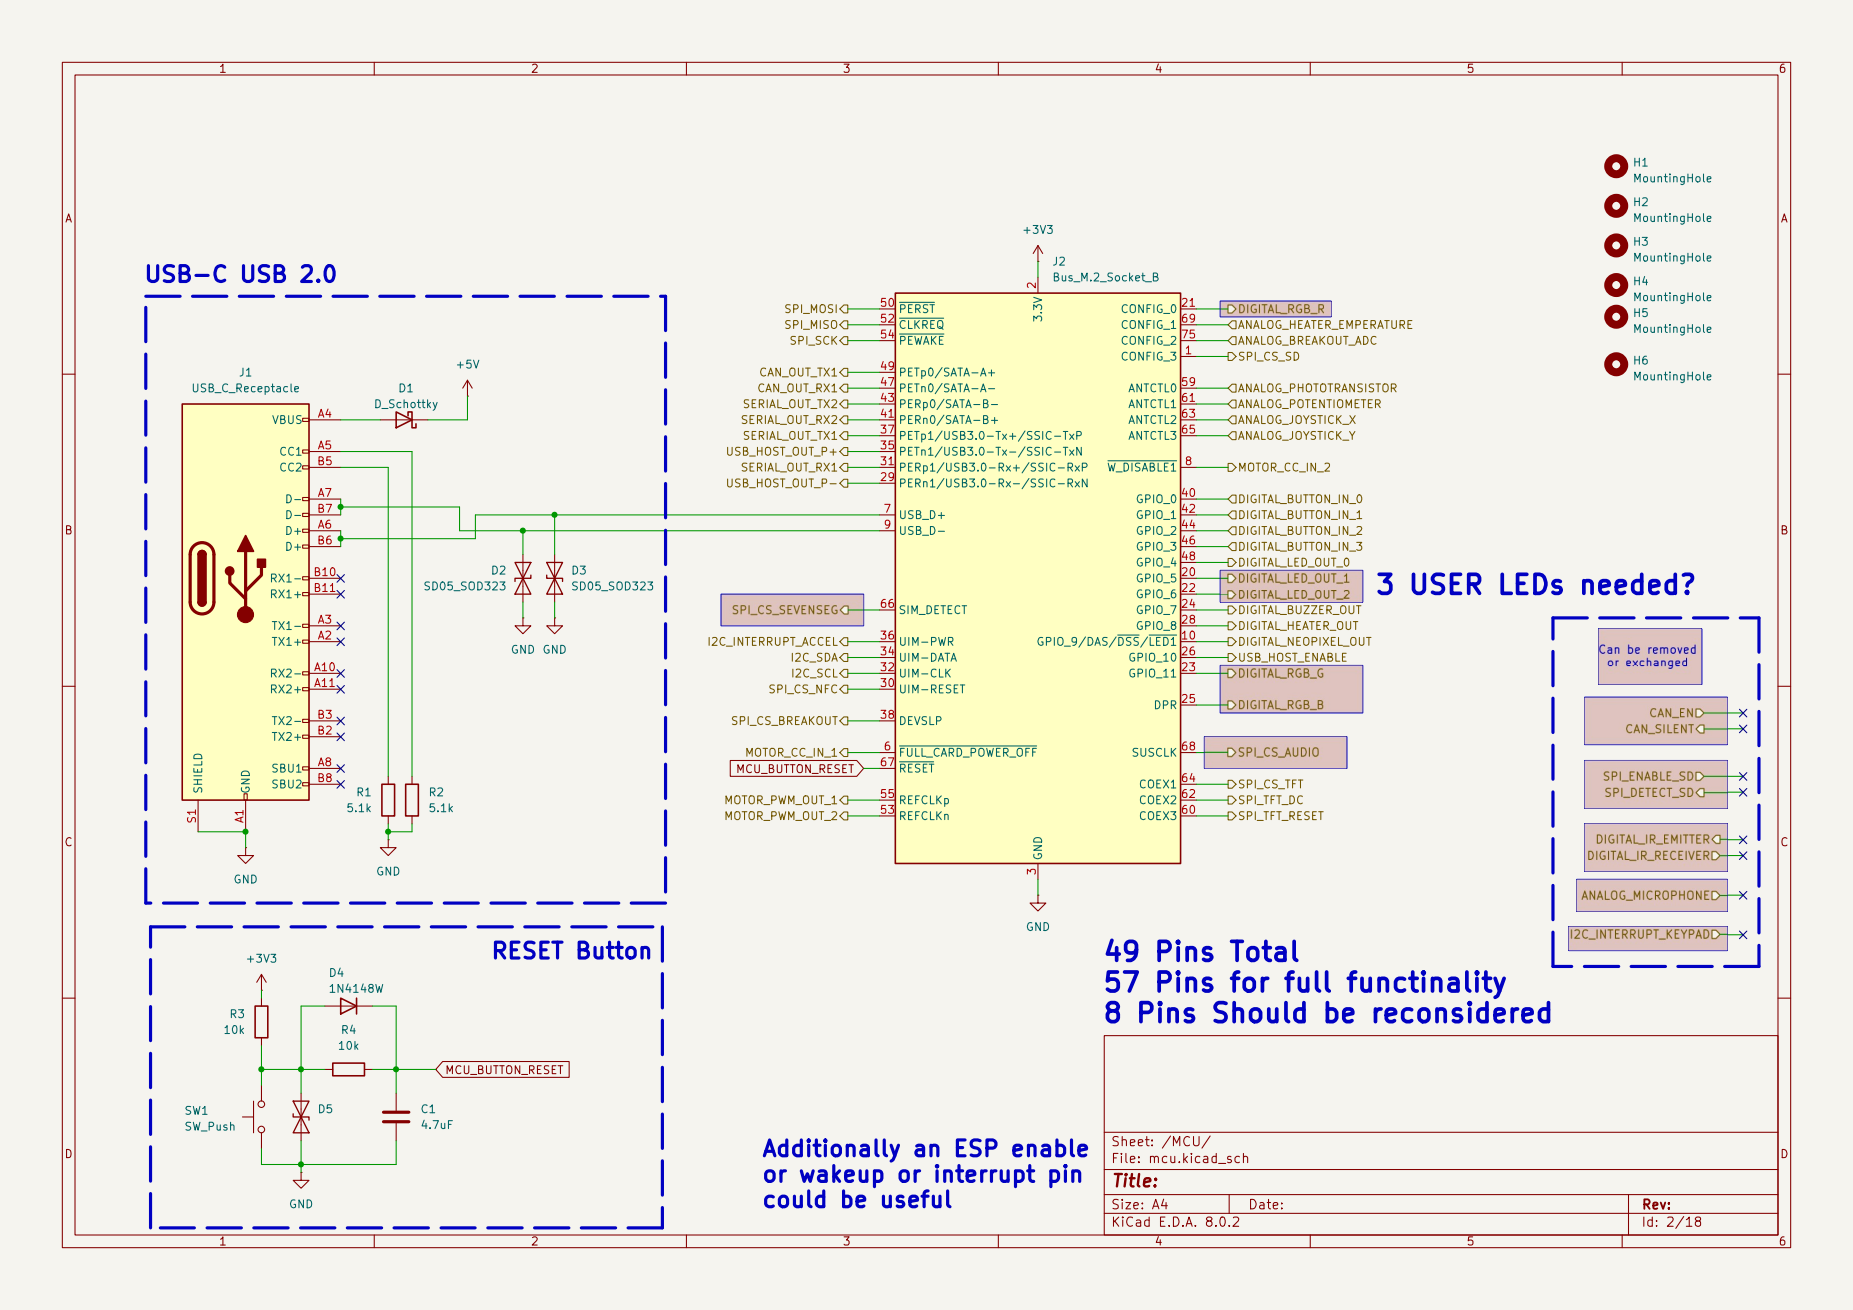
[picture p86: page 2]

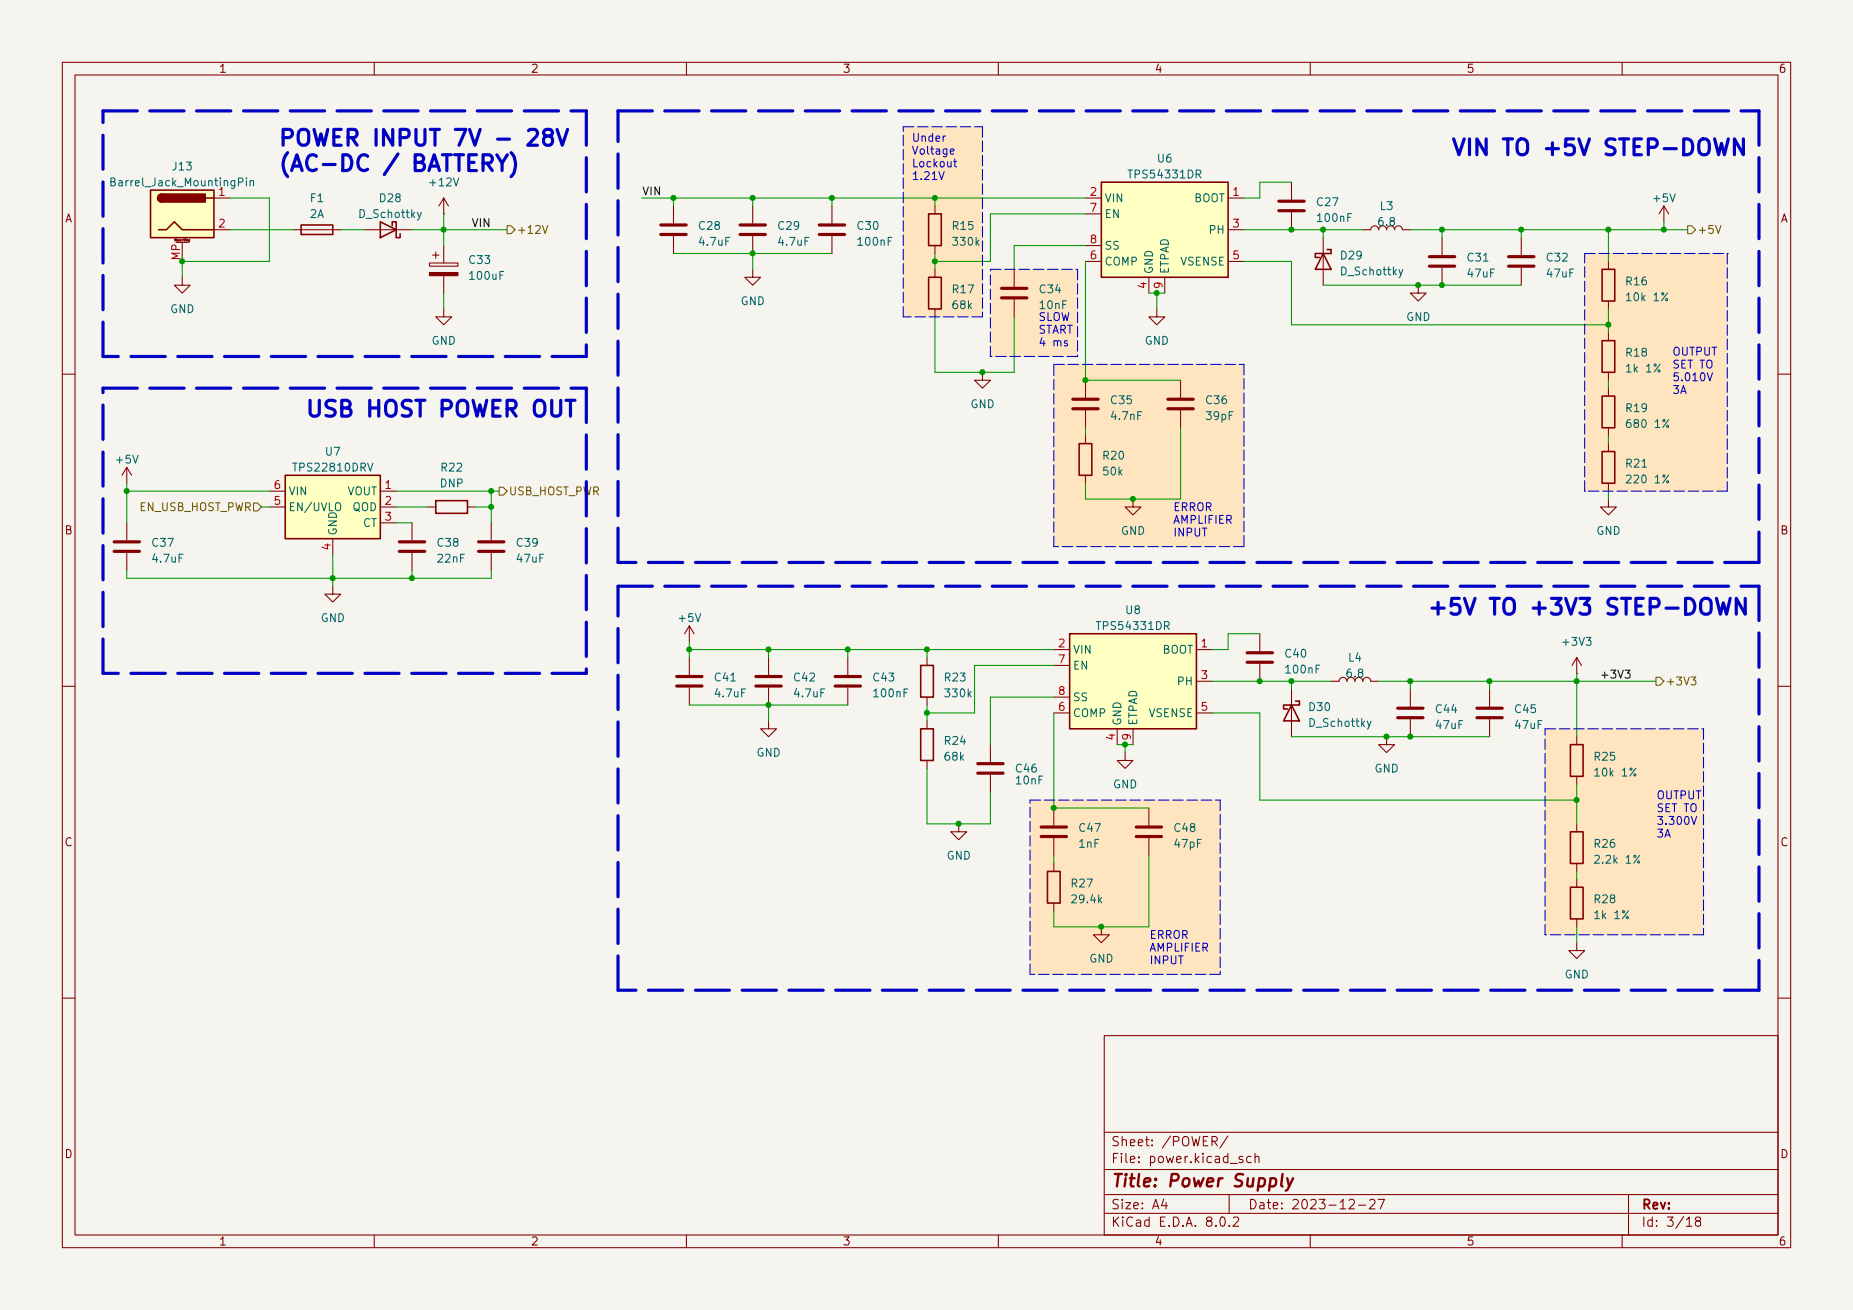
[picture p87: page 3]

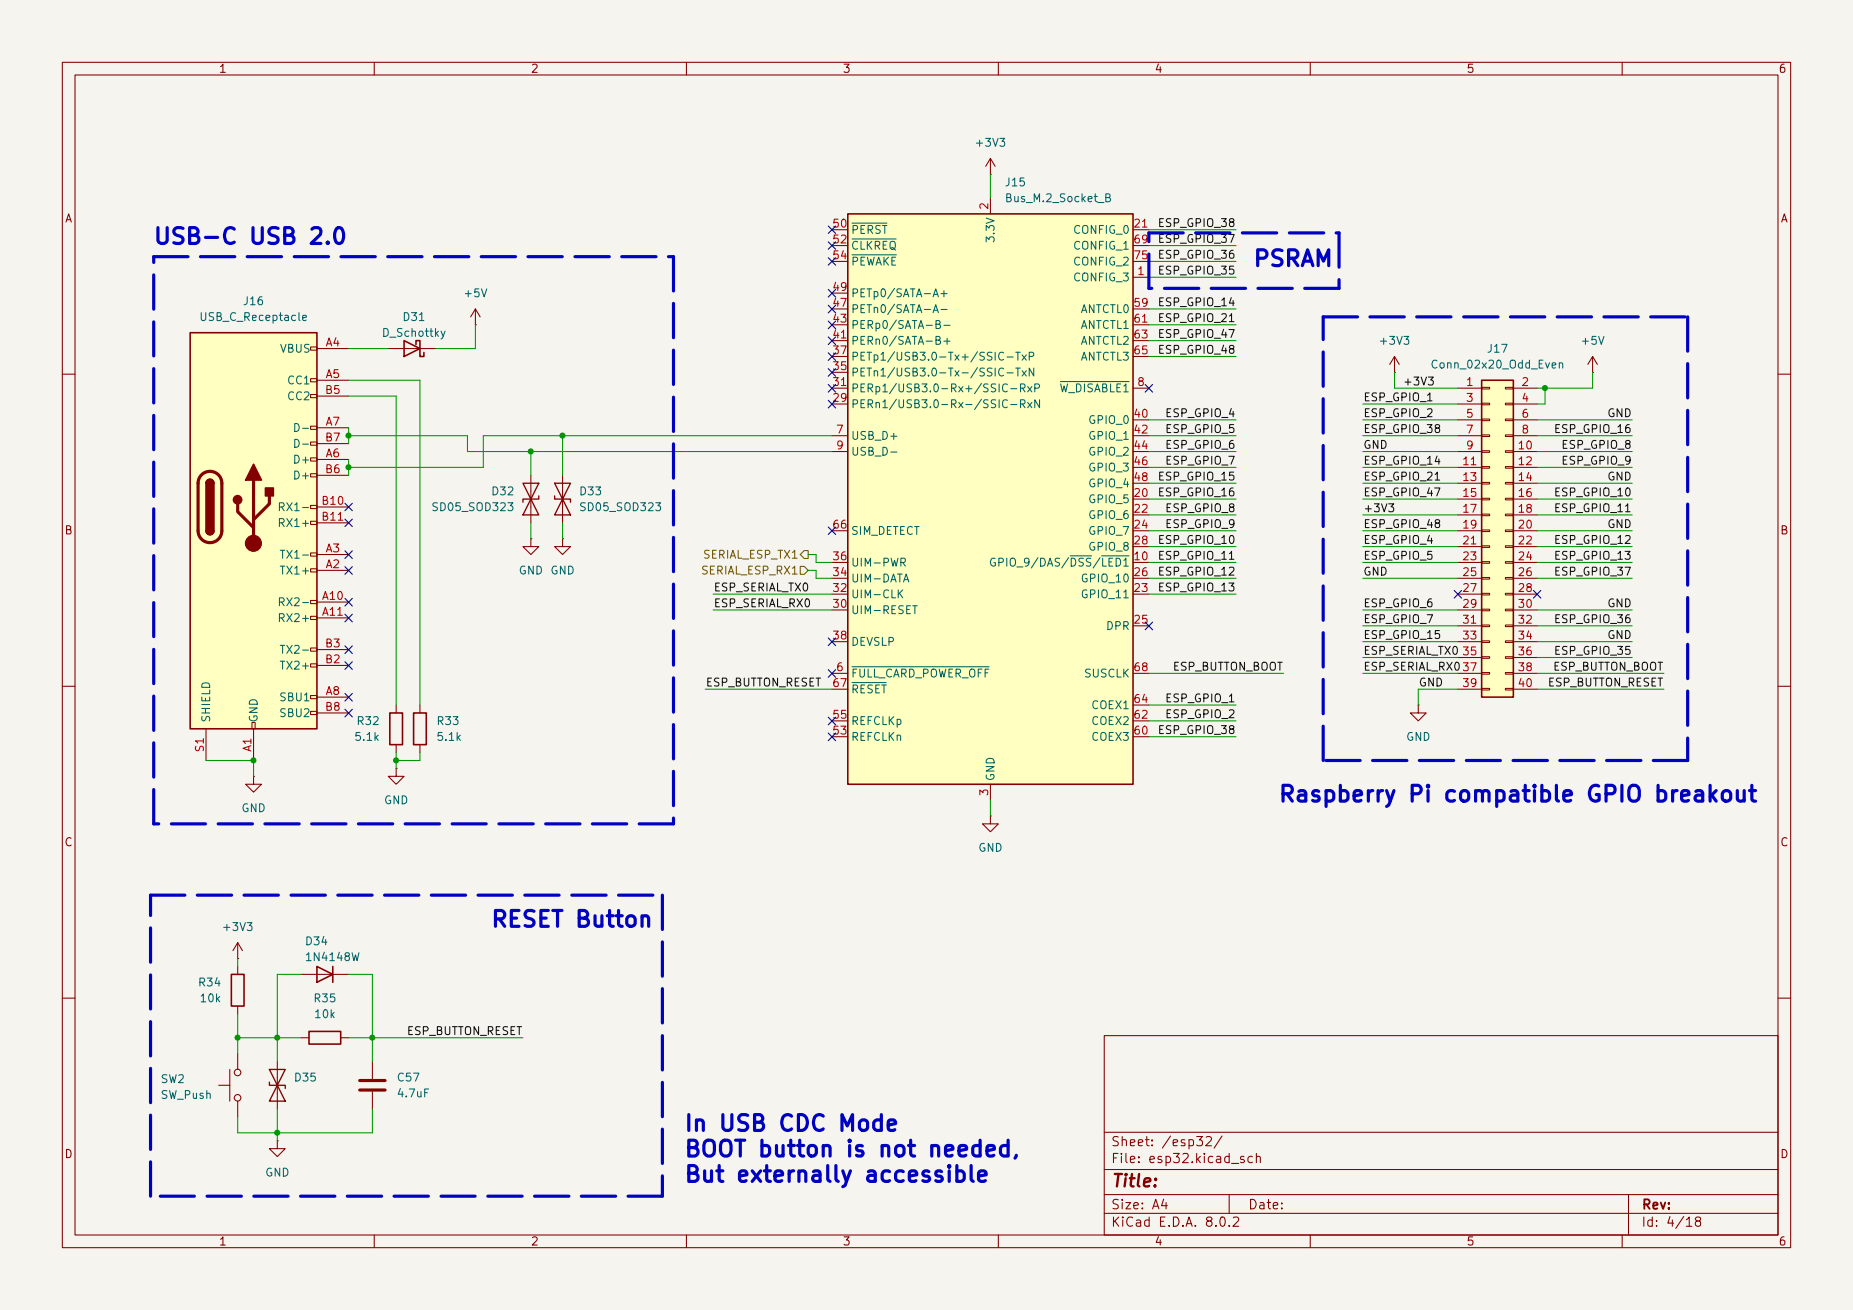
[picture p88: page 4]

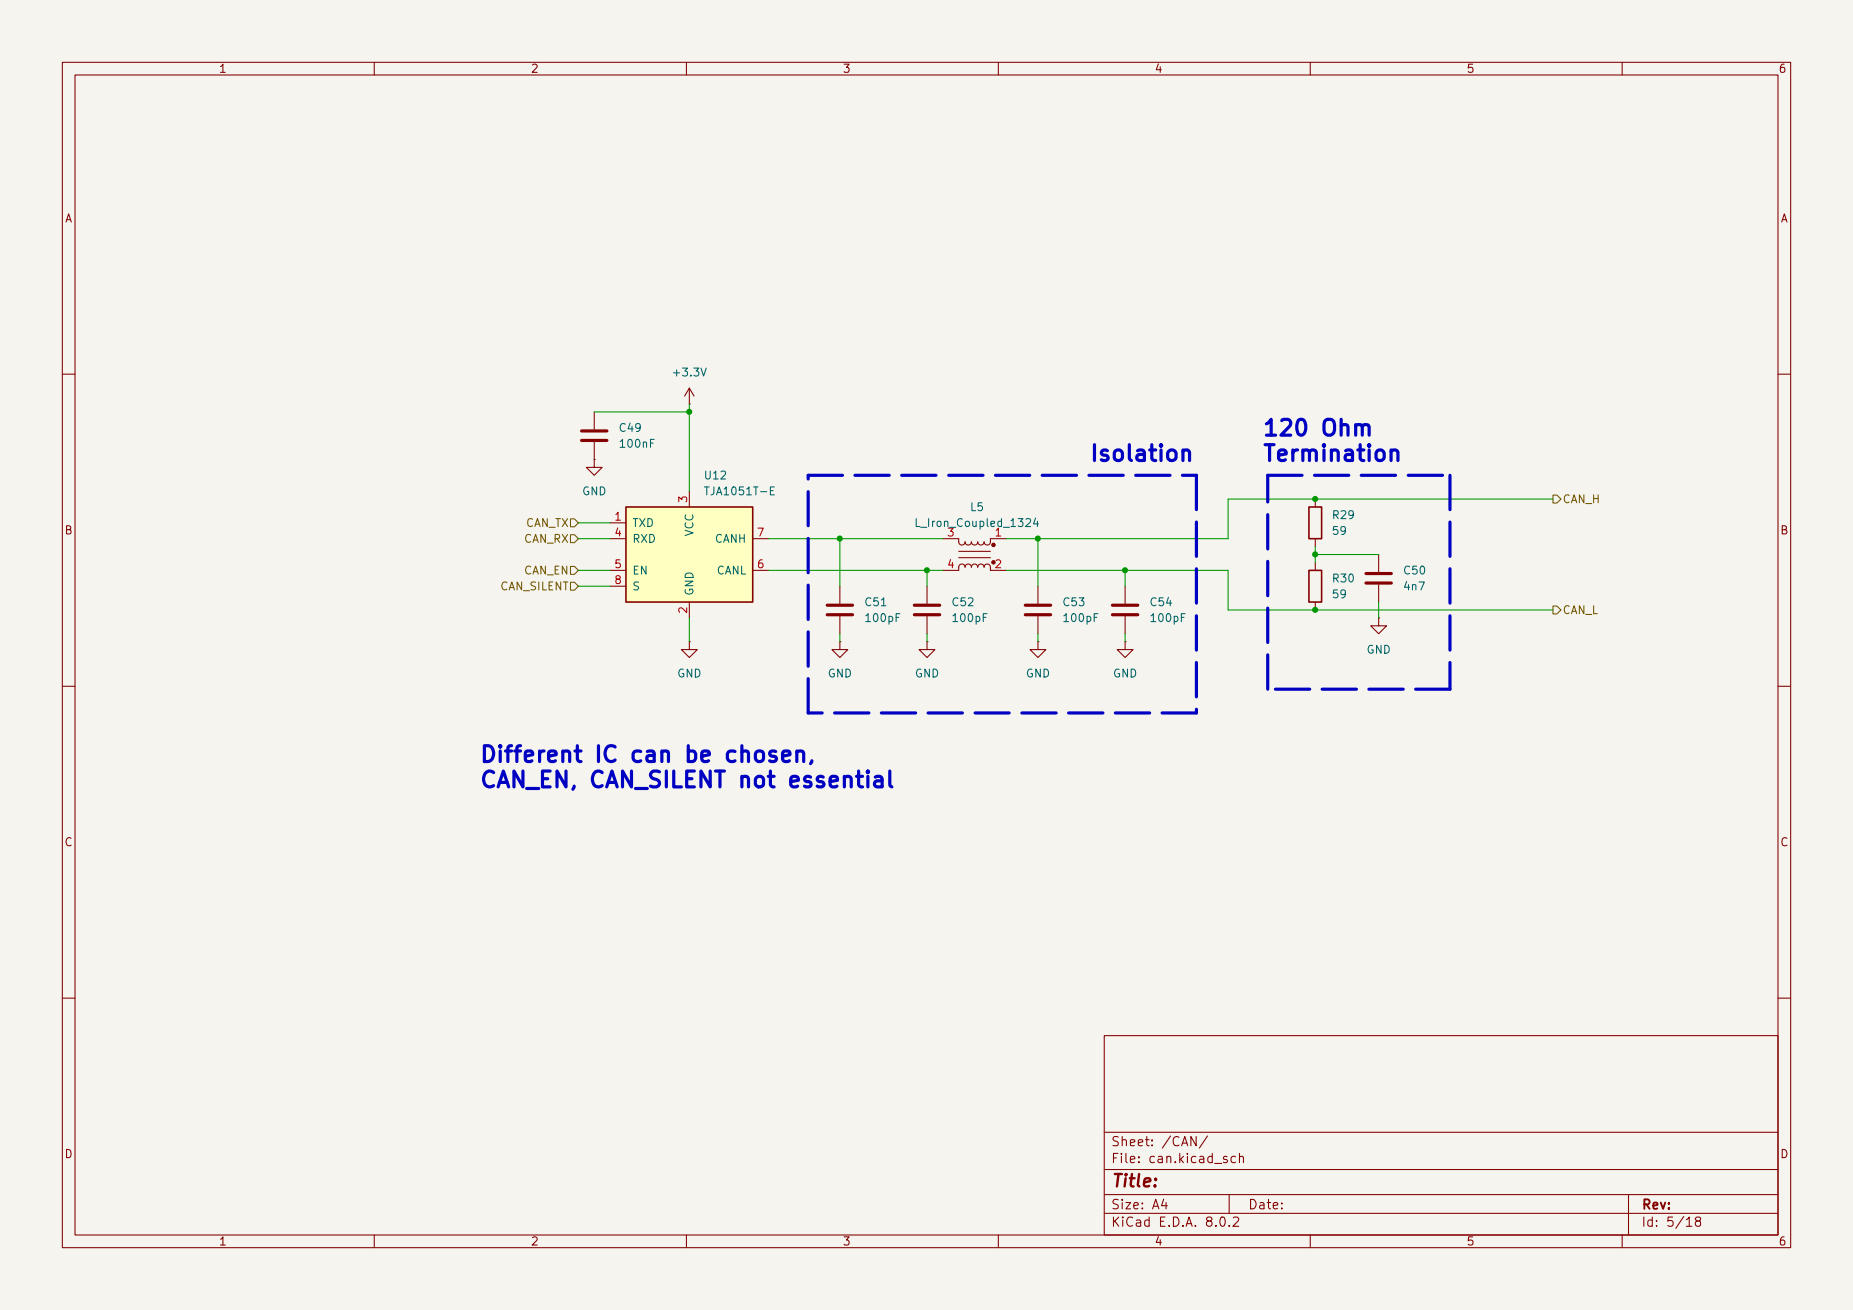
[picture p89: page 5]

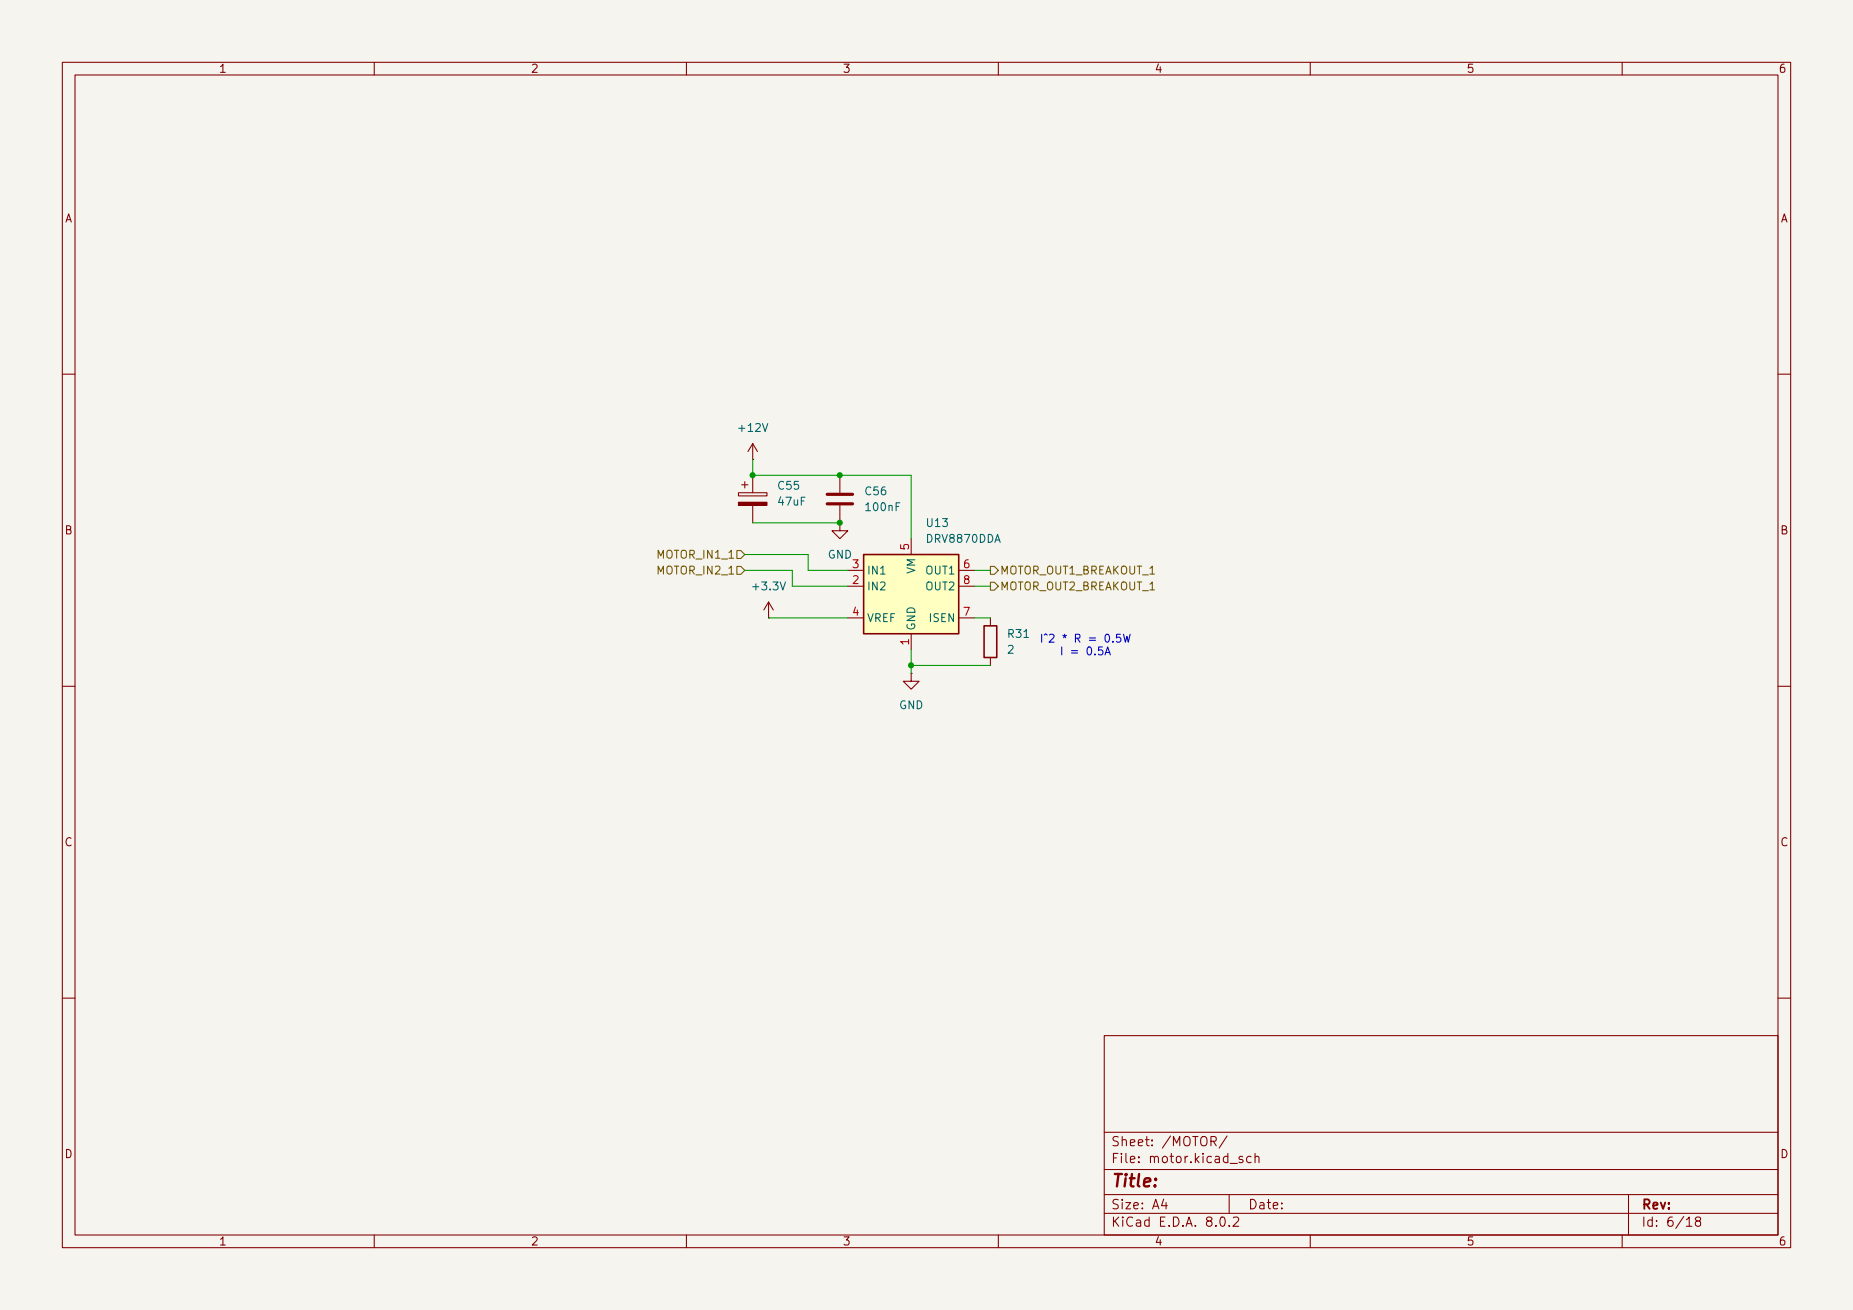
[picture p90: page 6]

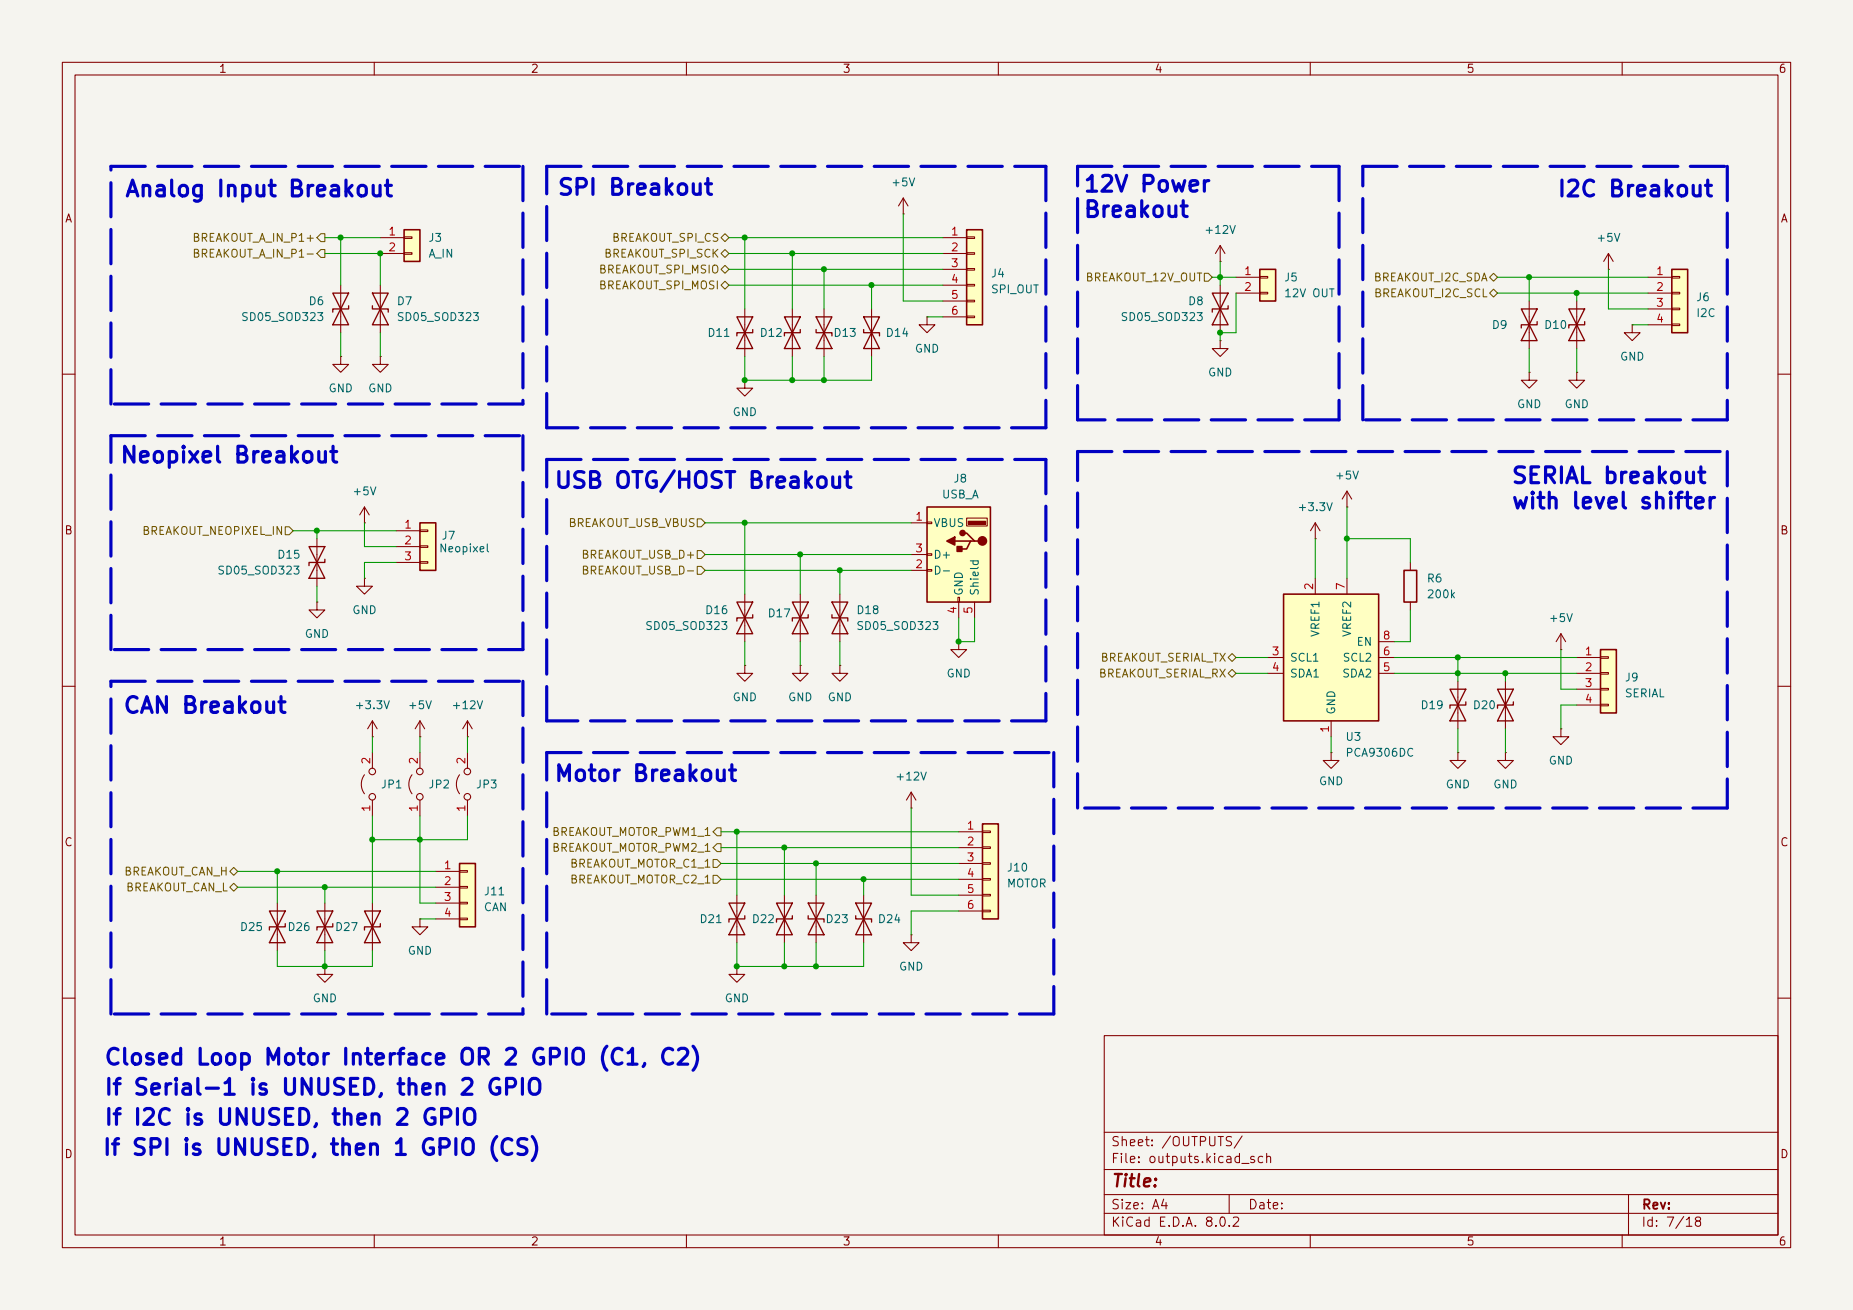
[picture p91: page 7]

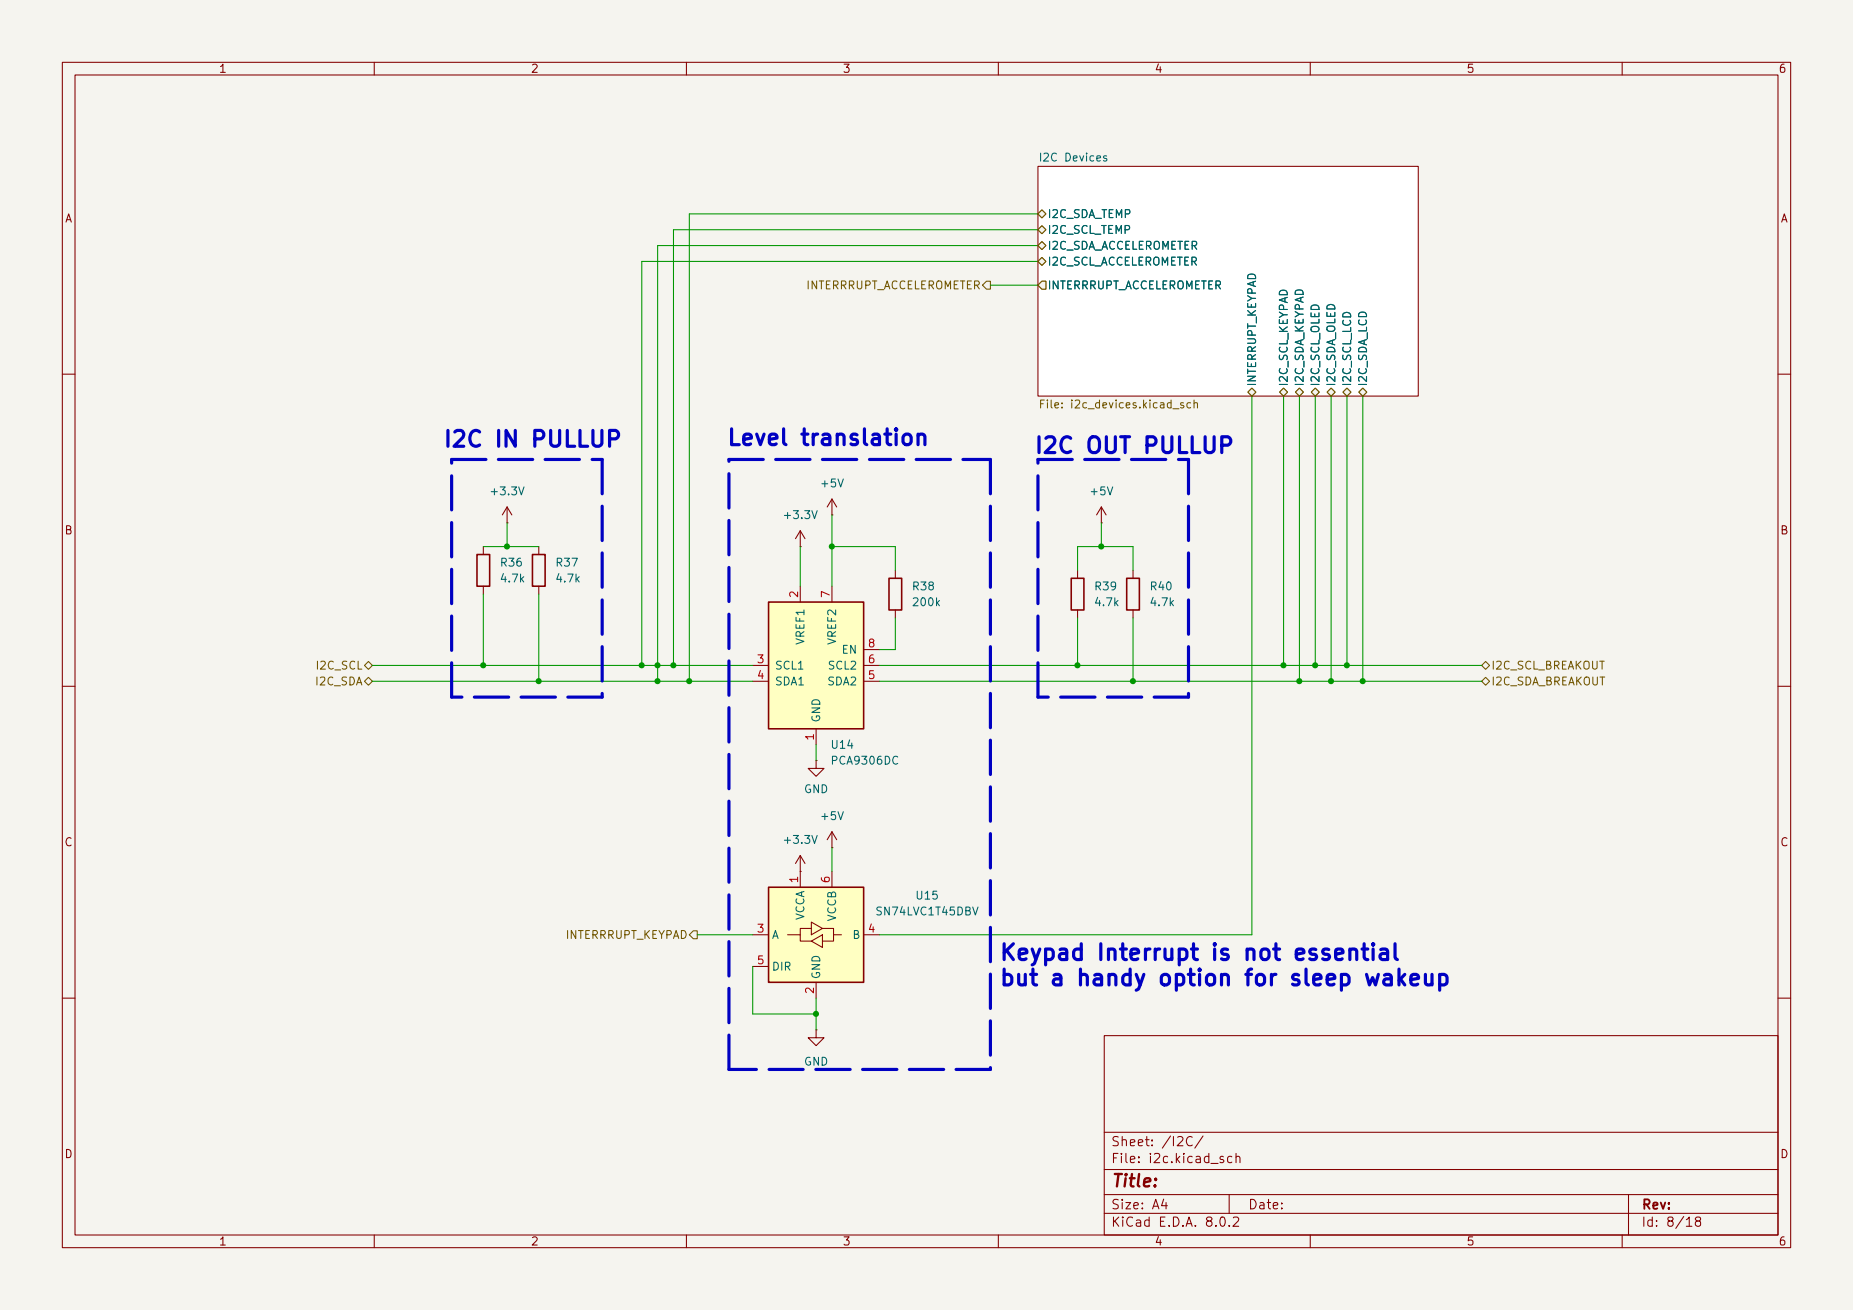
[picture p92: page 8]

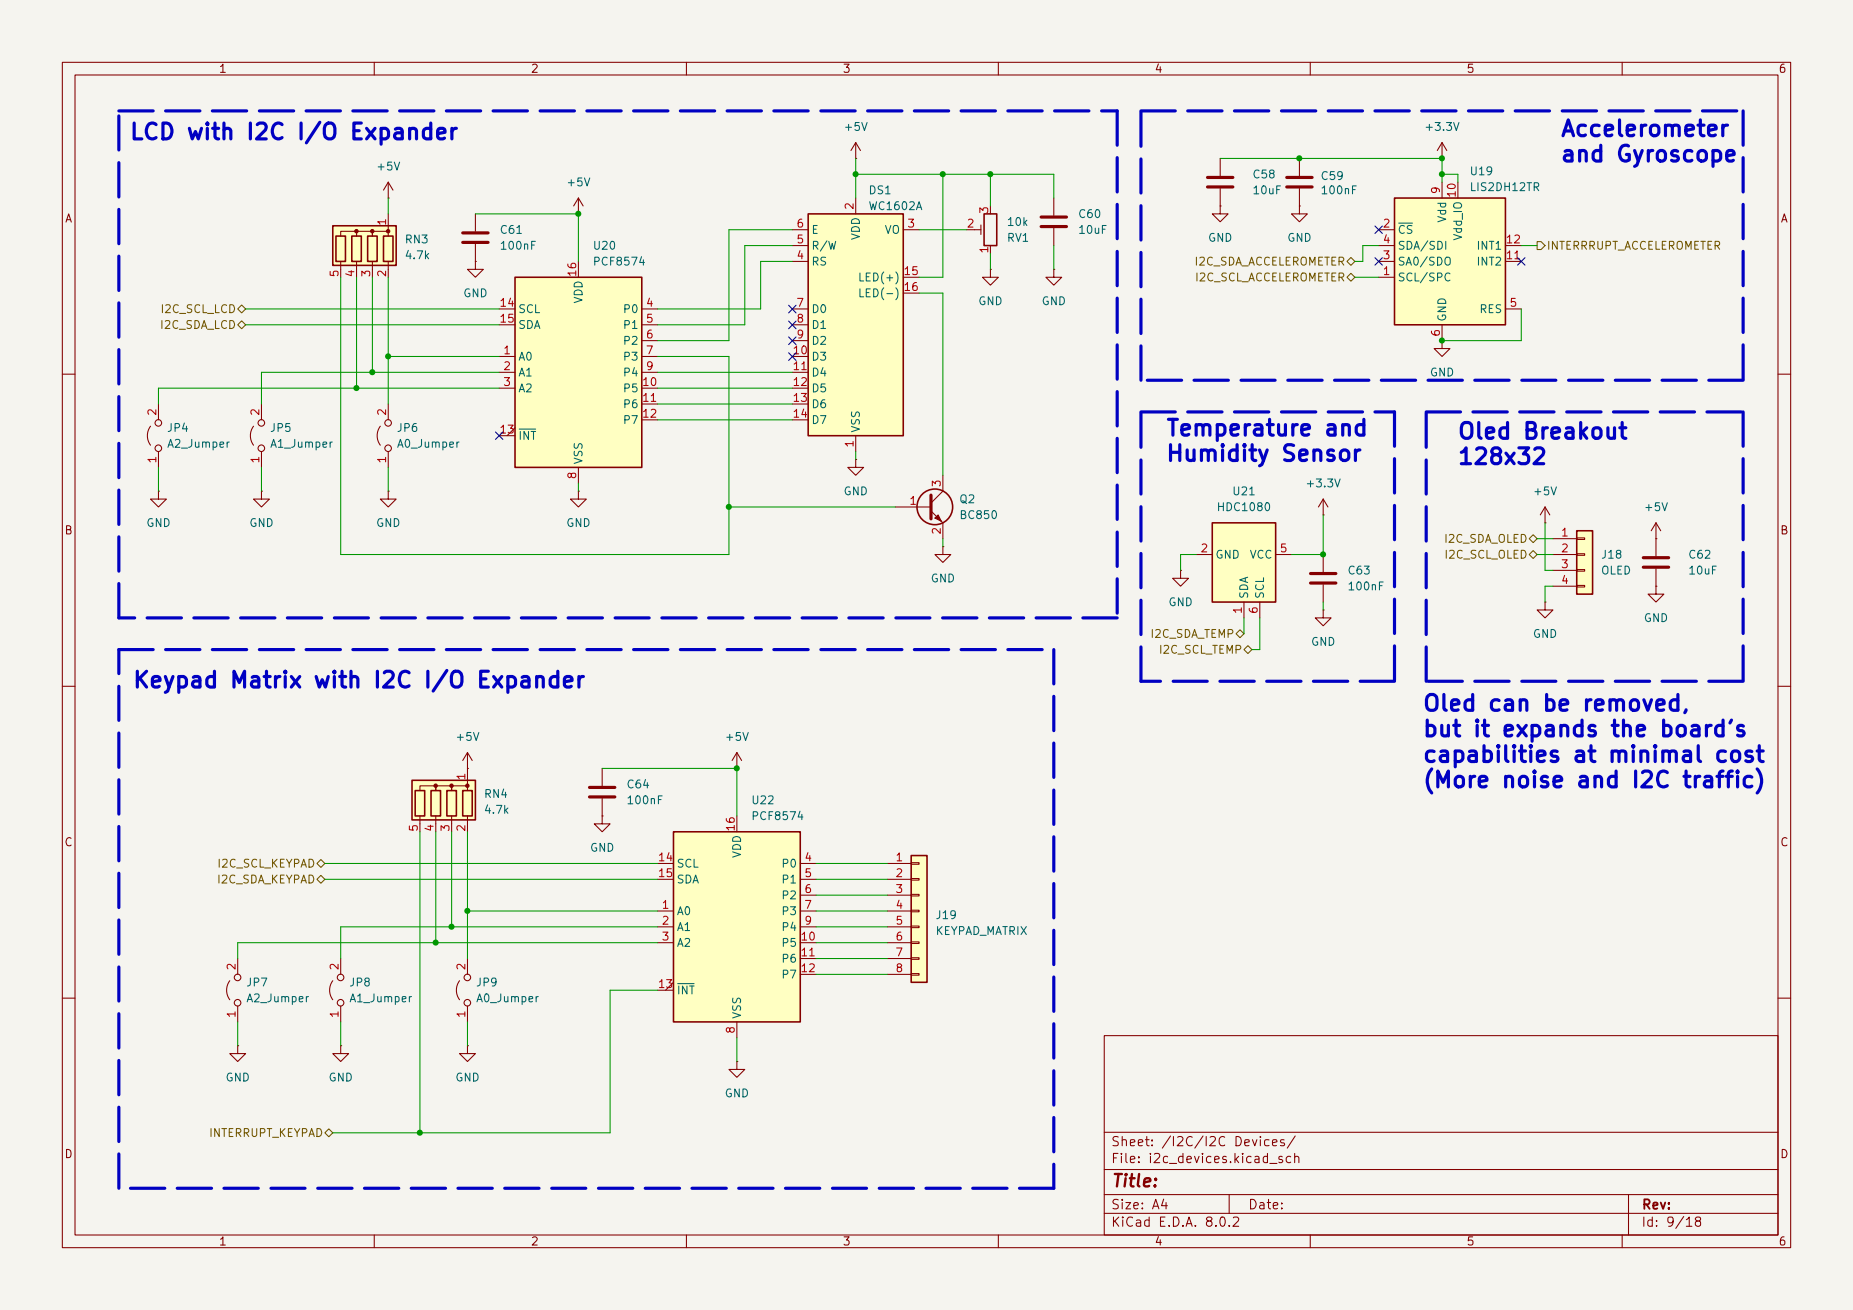
[picture p93: page 9]

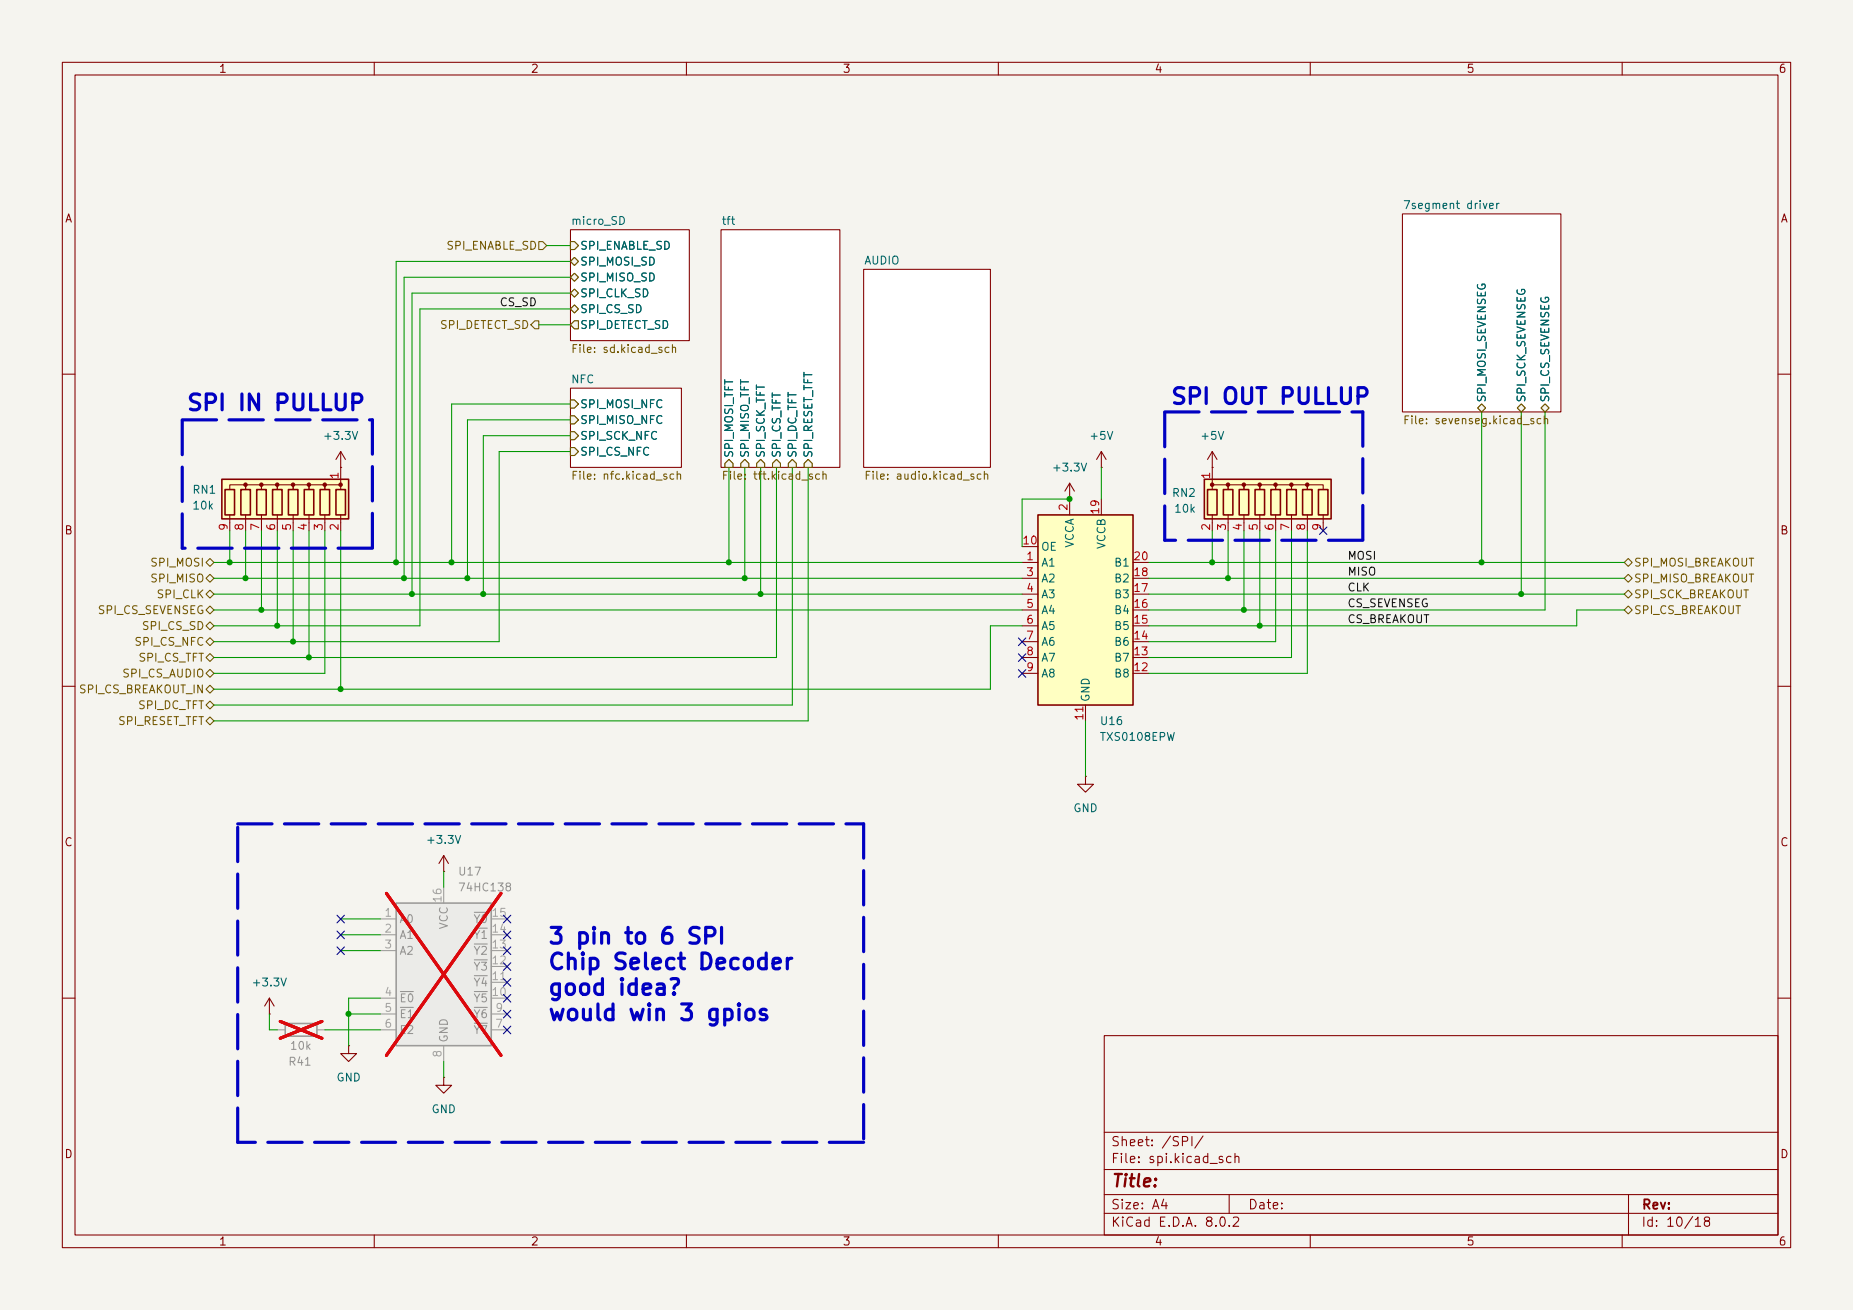
[picture p94: page 10]

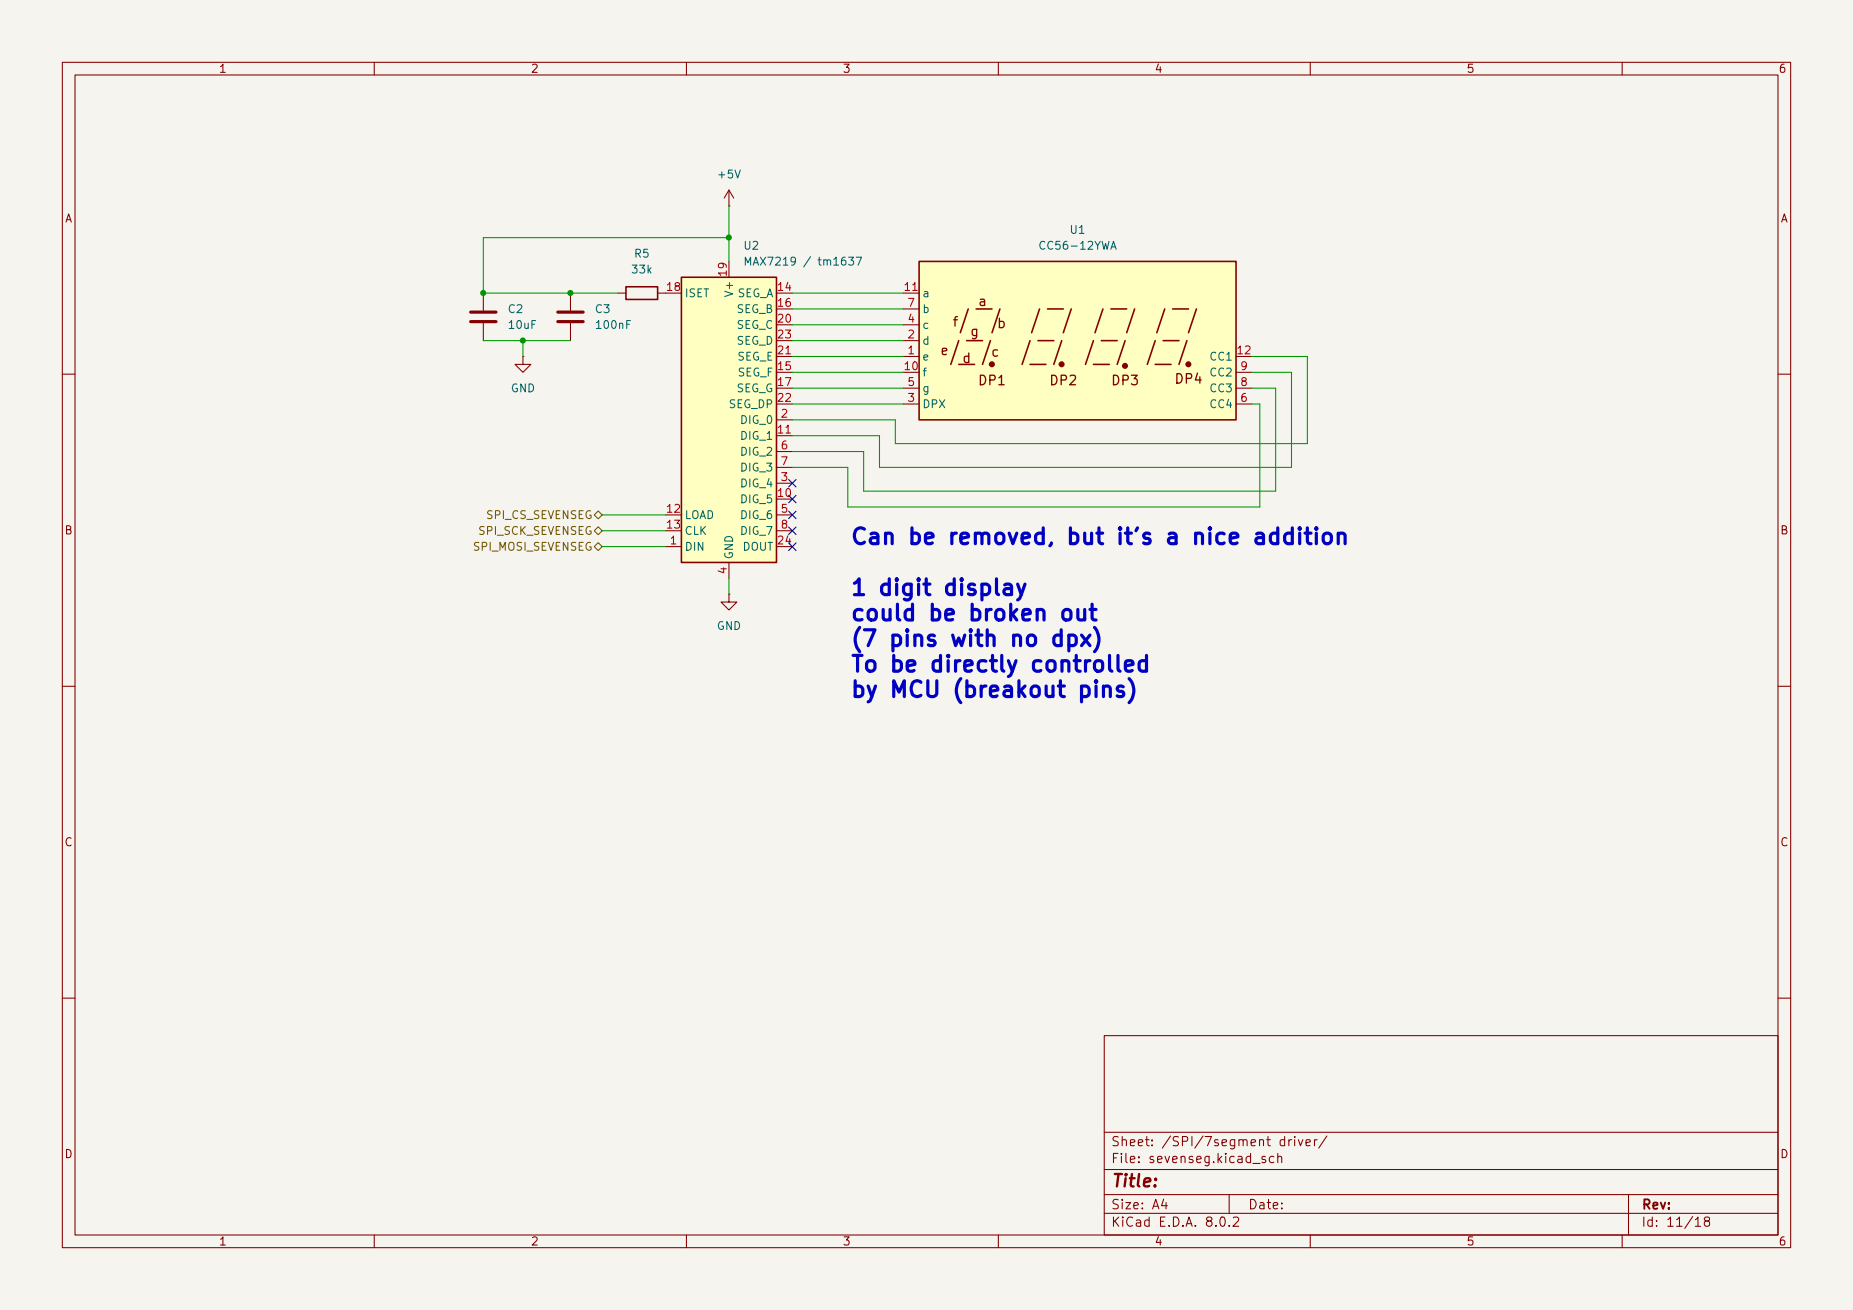
[picture p95: page 11]

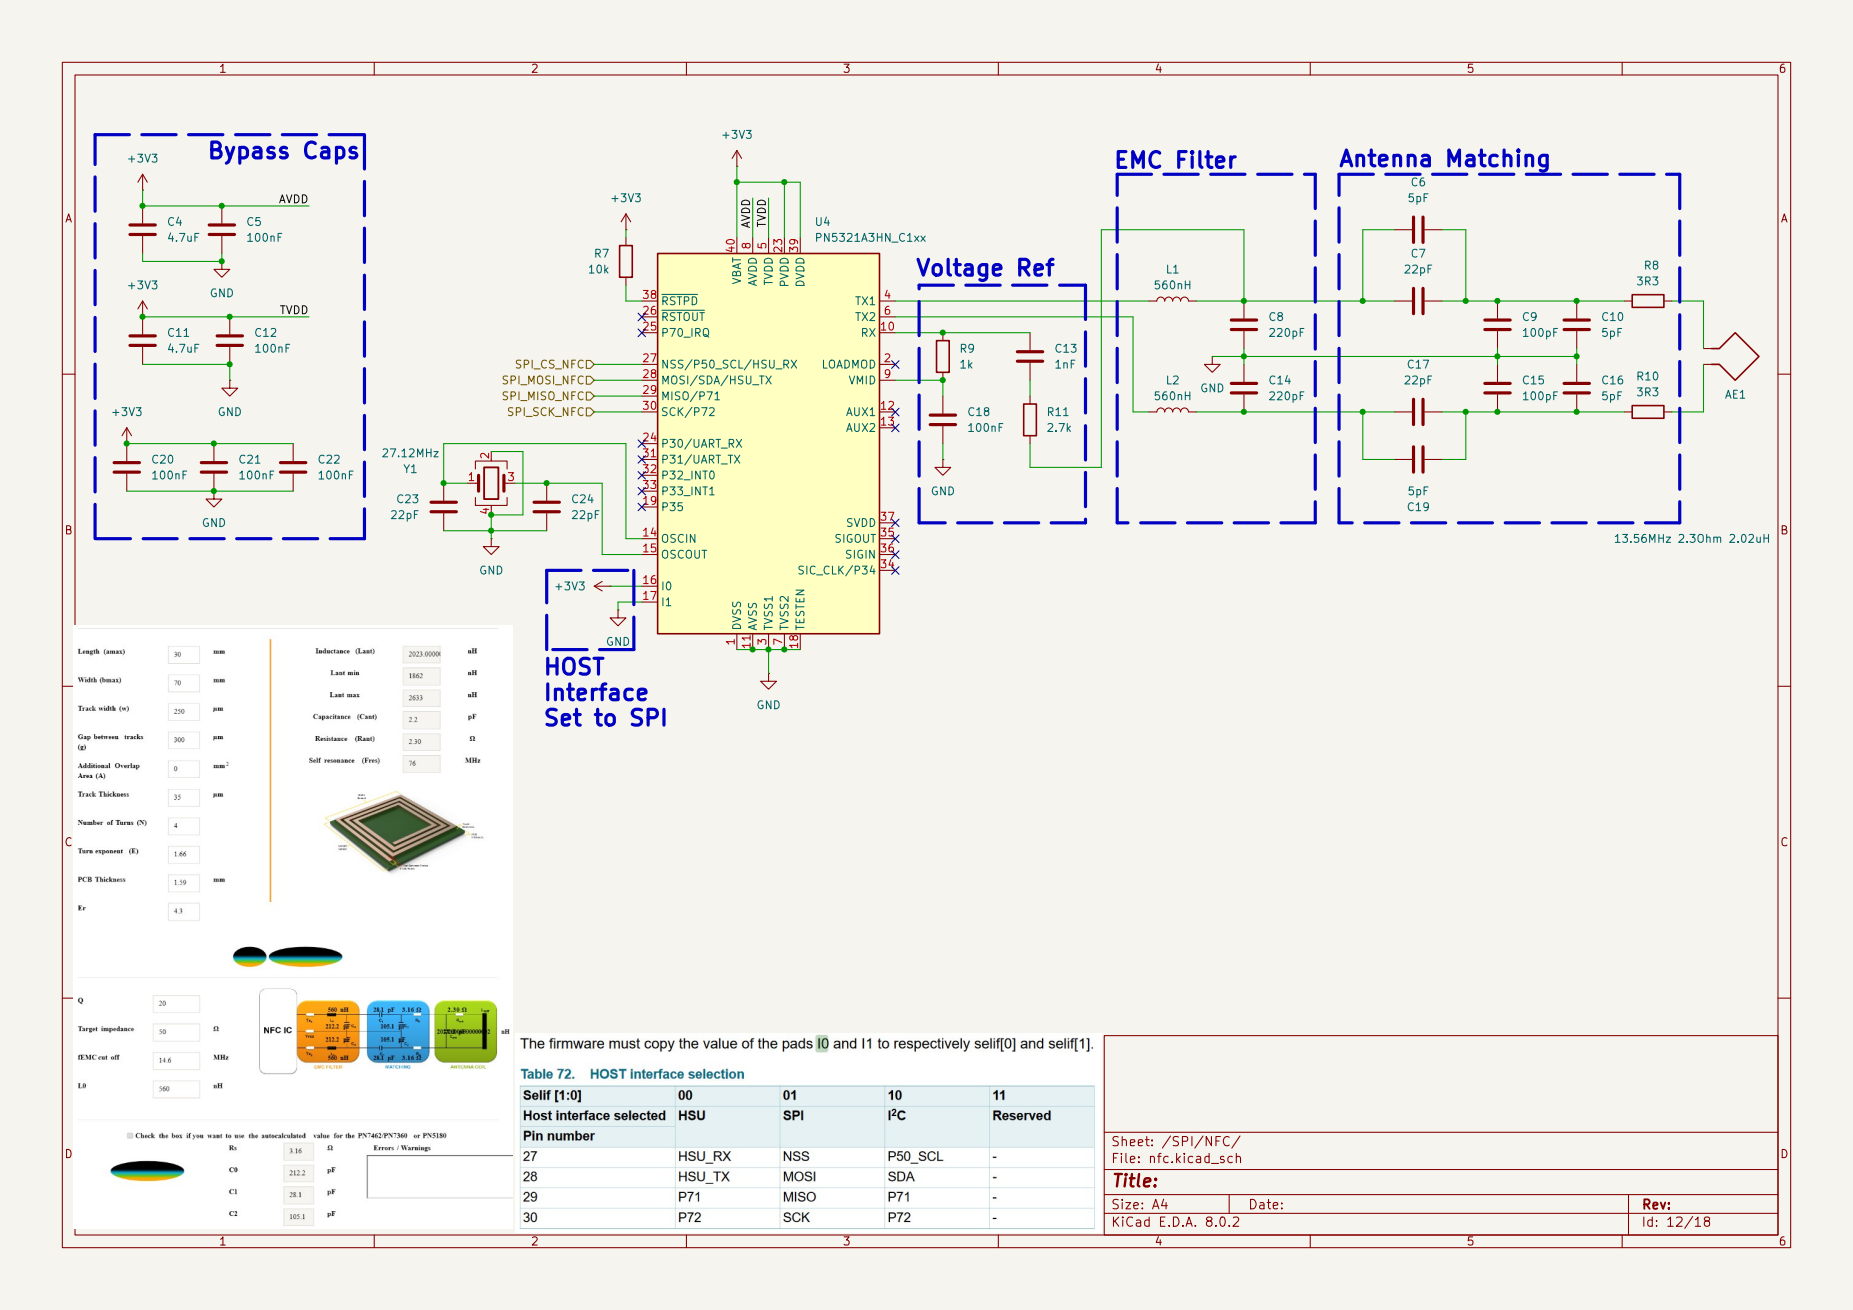
[picture p96: page 12]

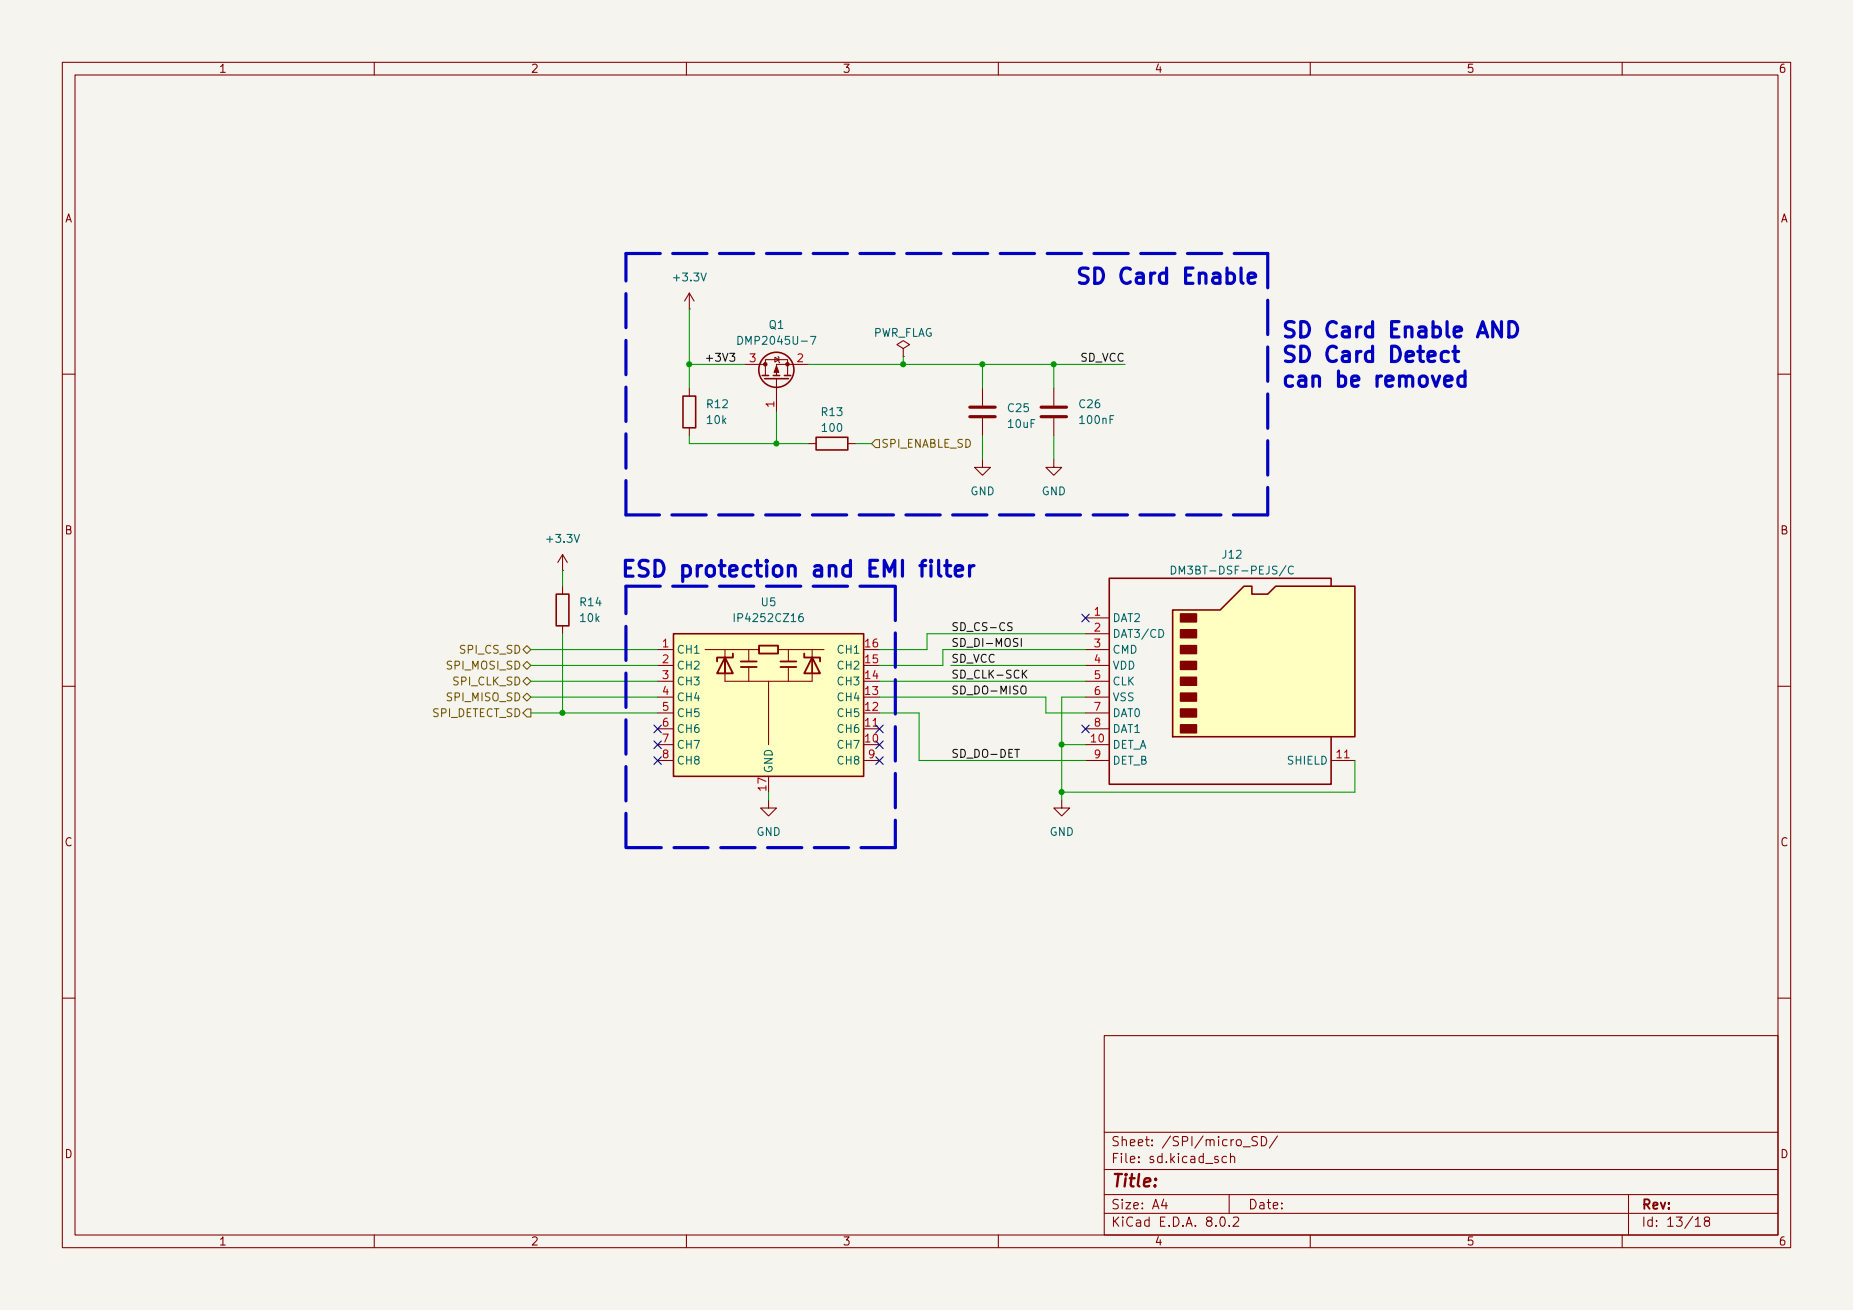
[picture p97: page 13]

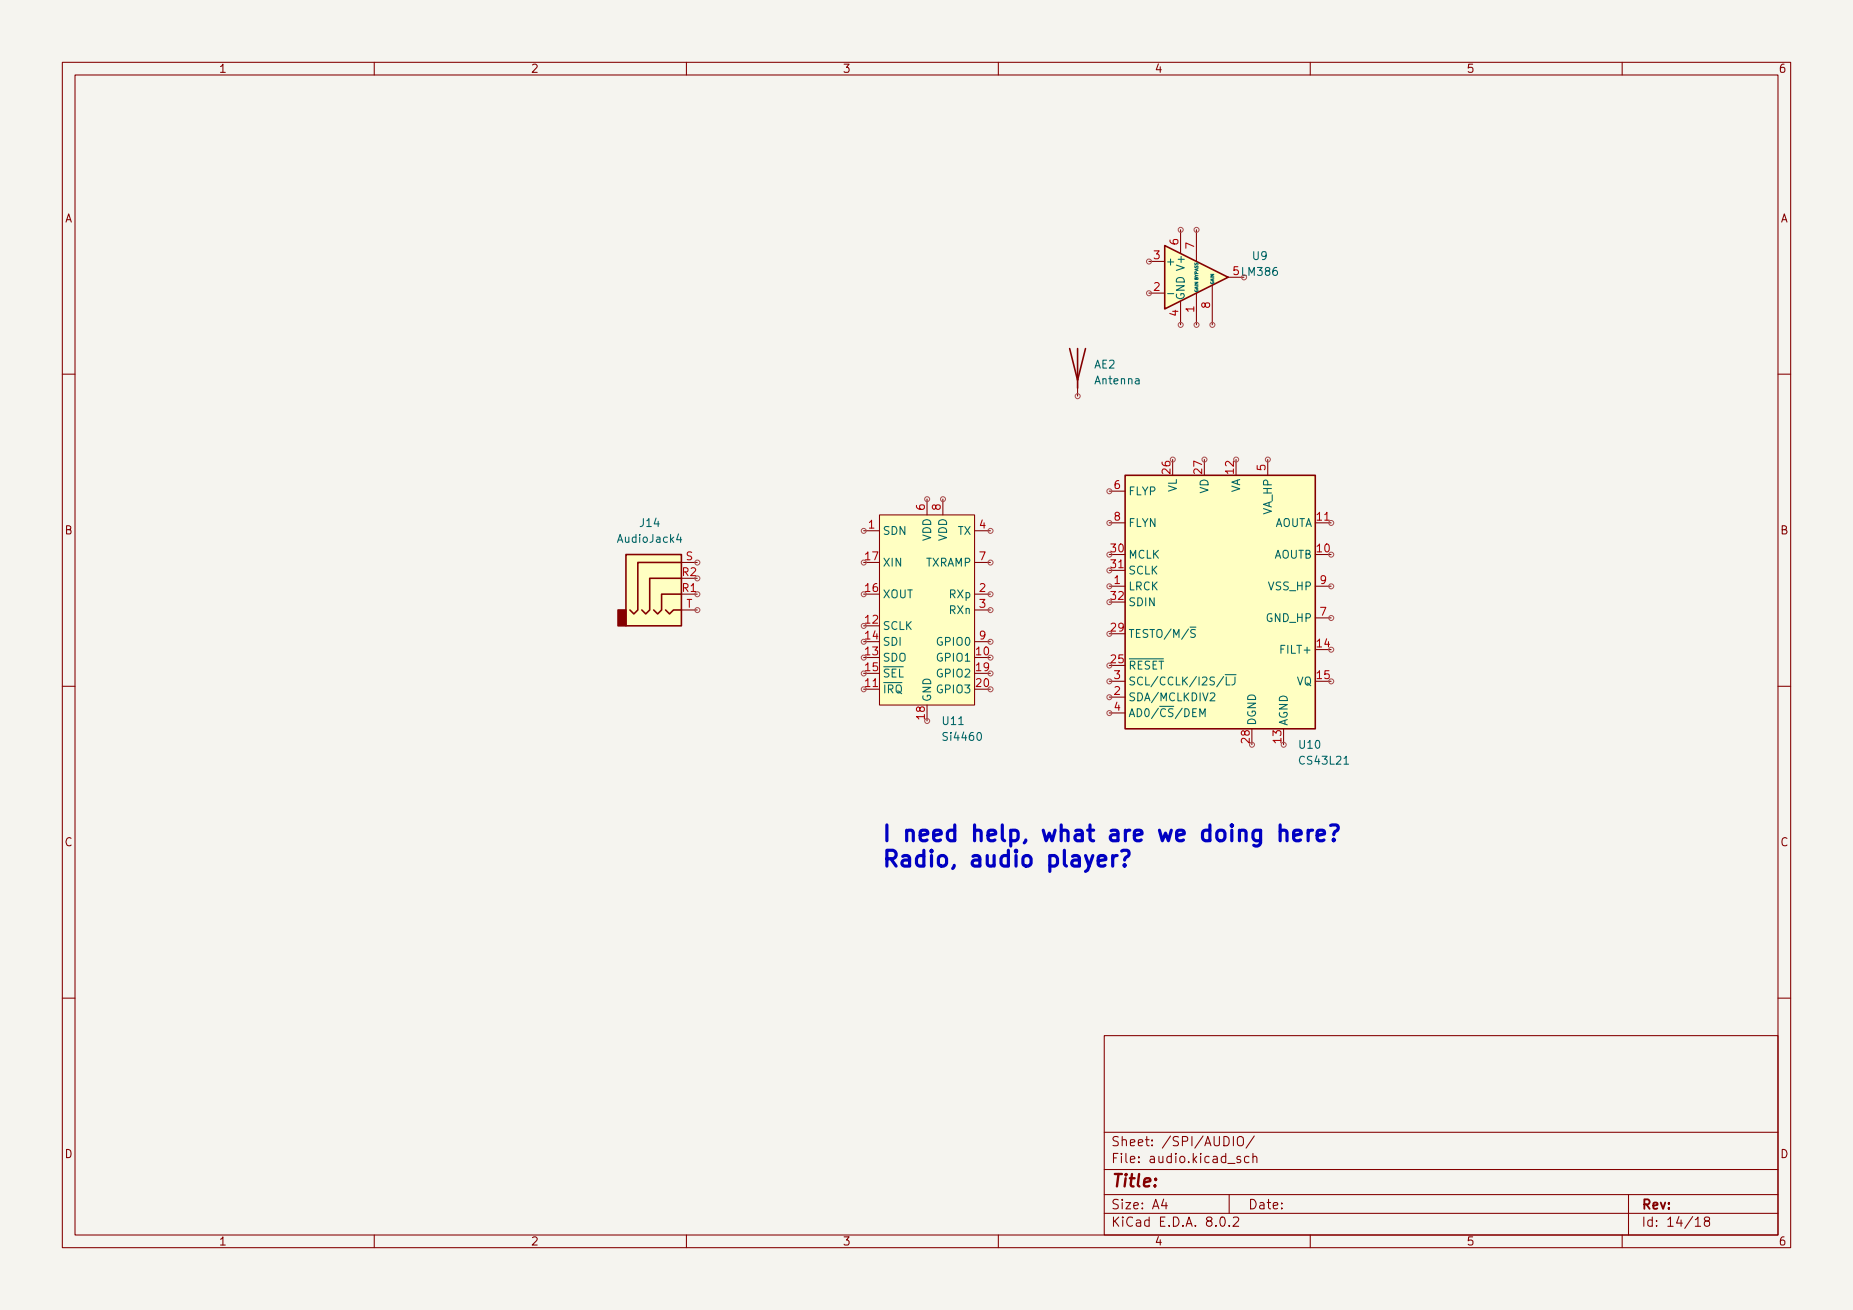
[picture p98: page 14]

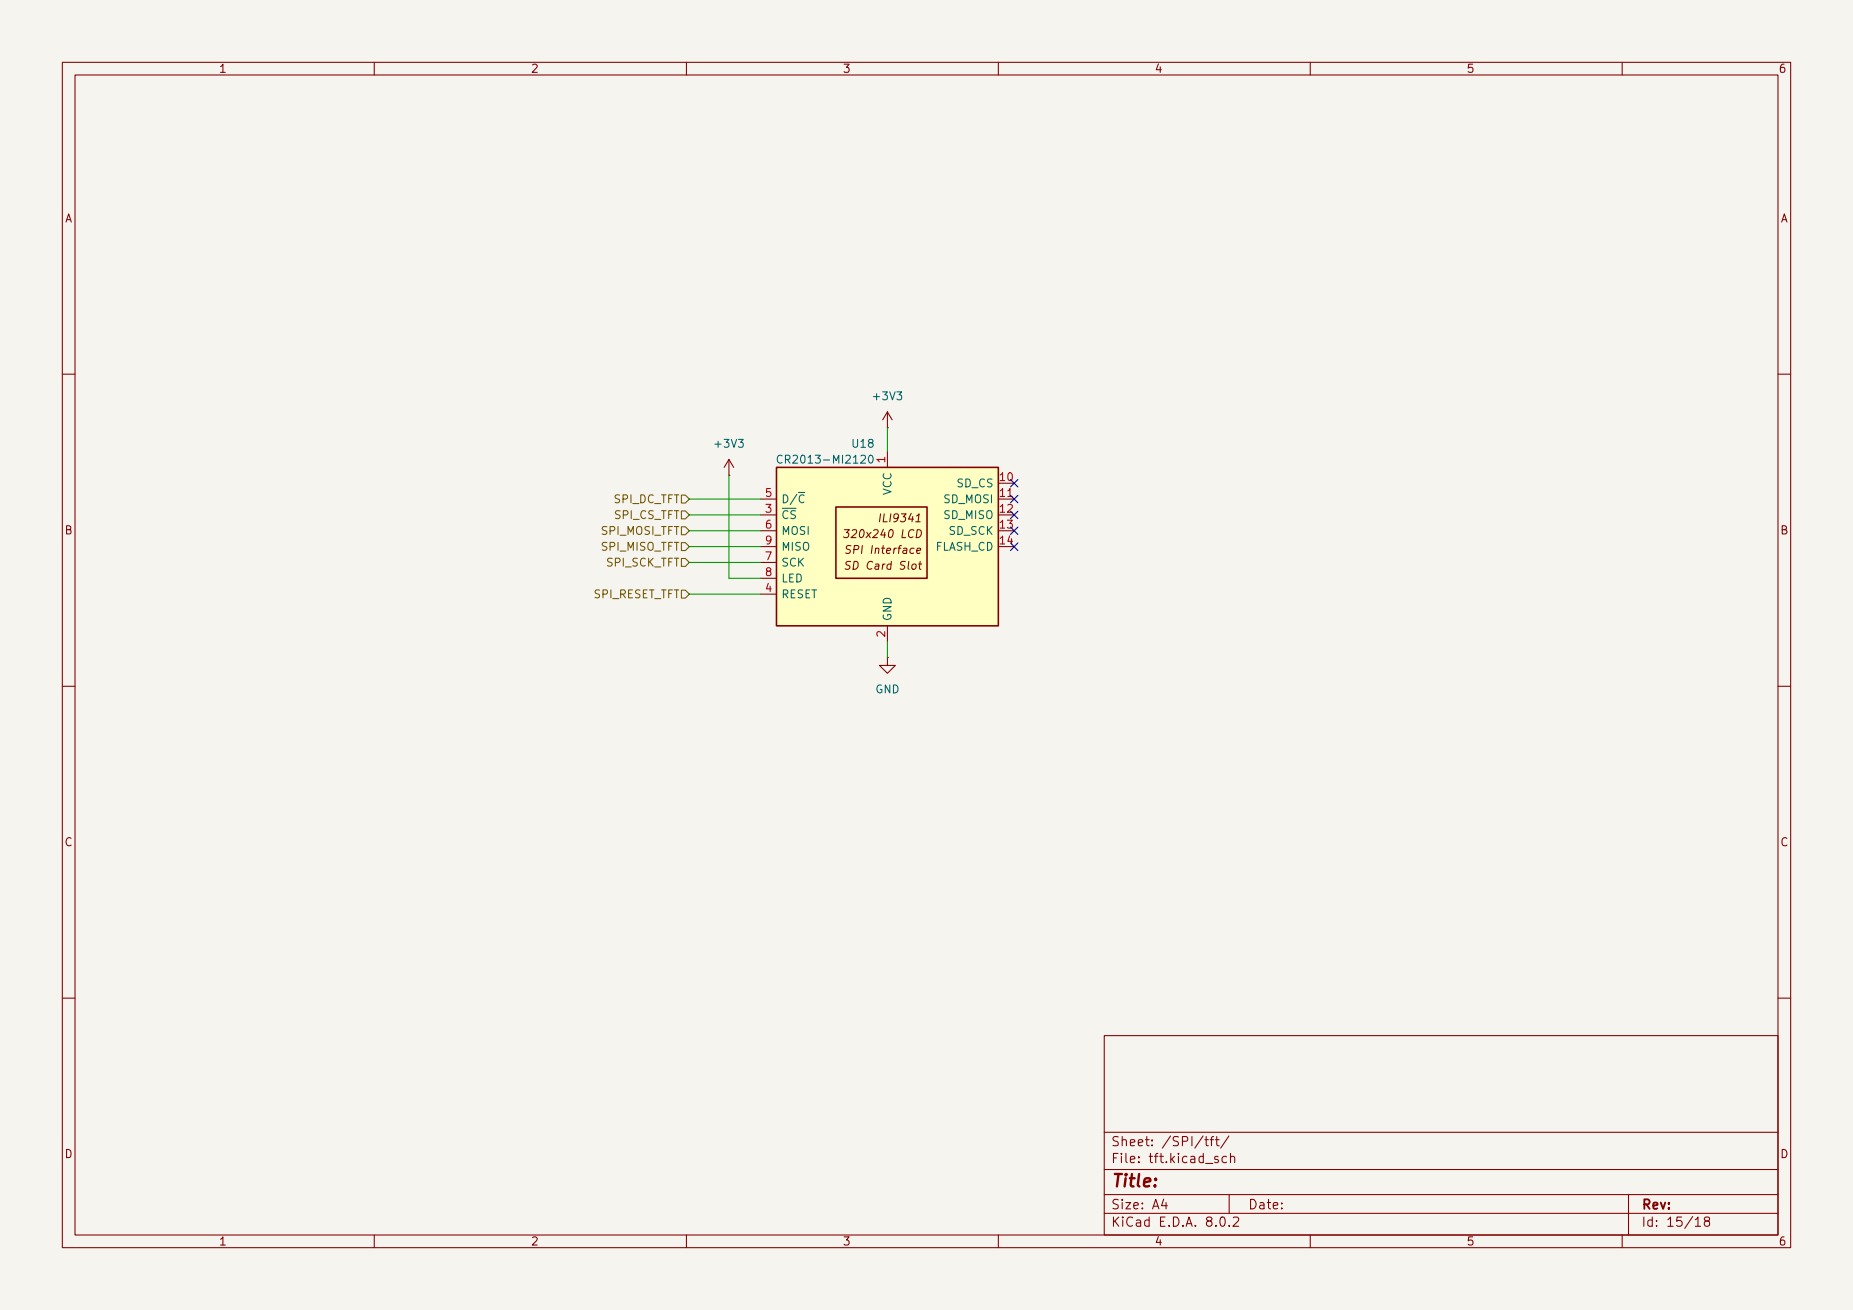
[picture p99: page 15]

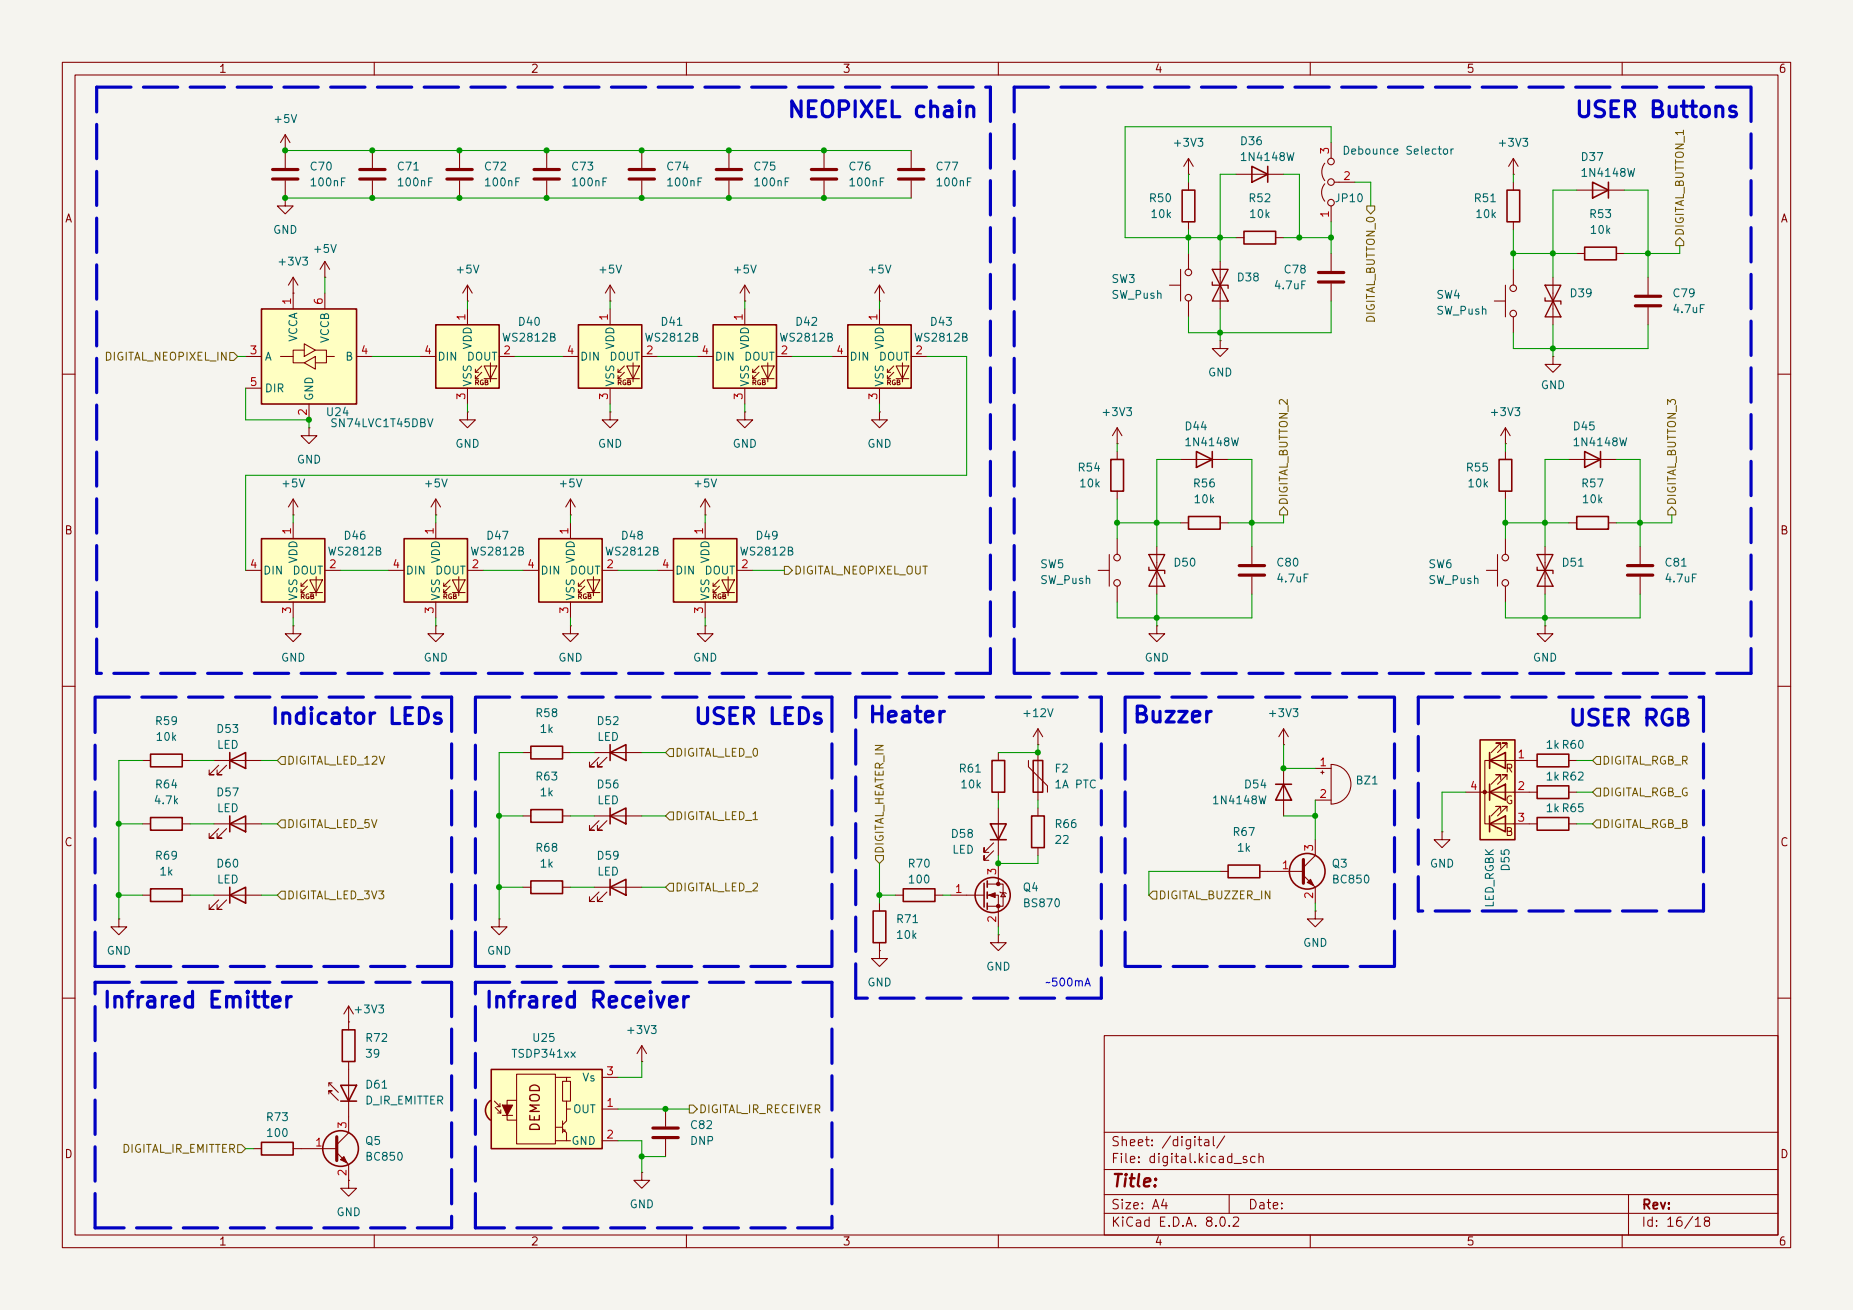
[picture p100: page 16]

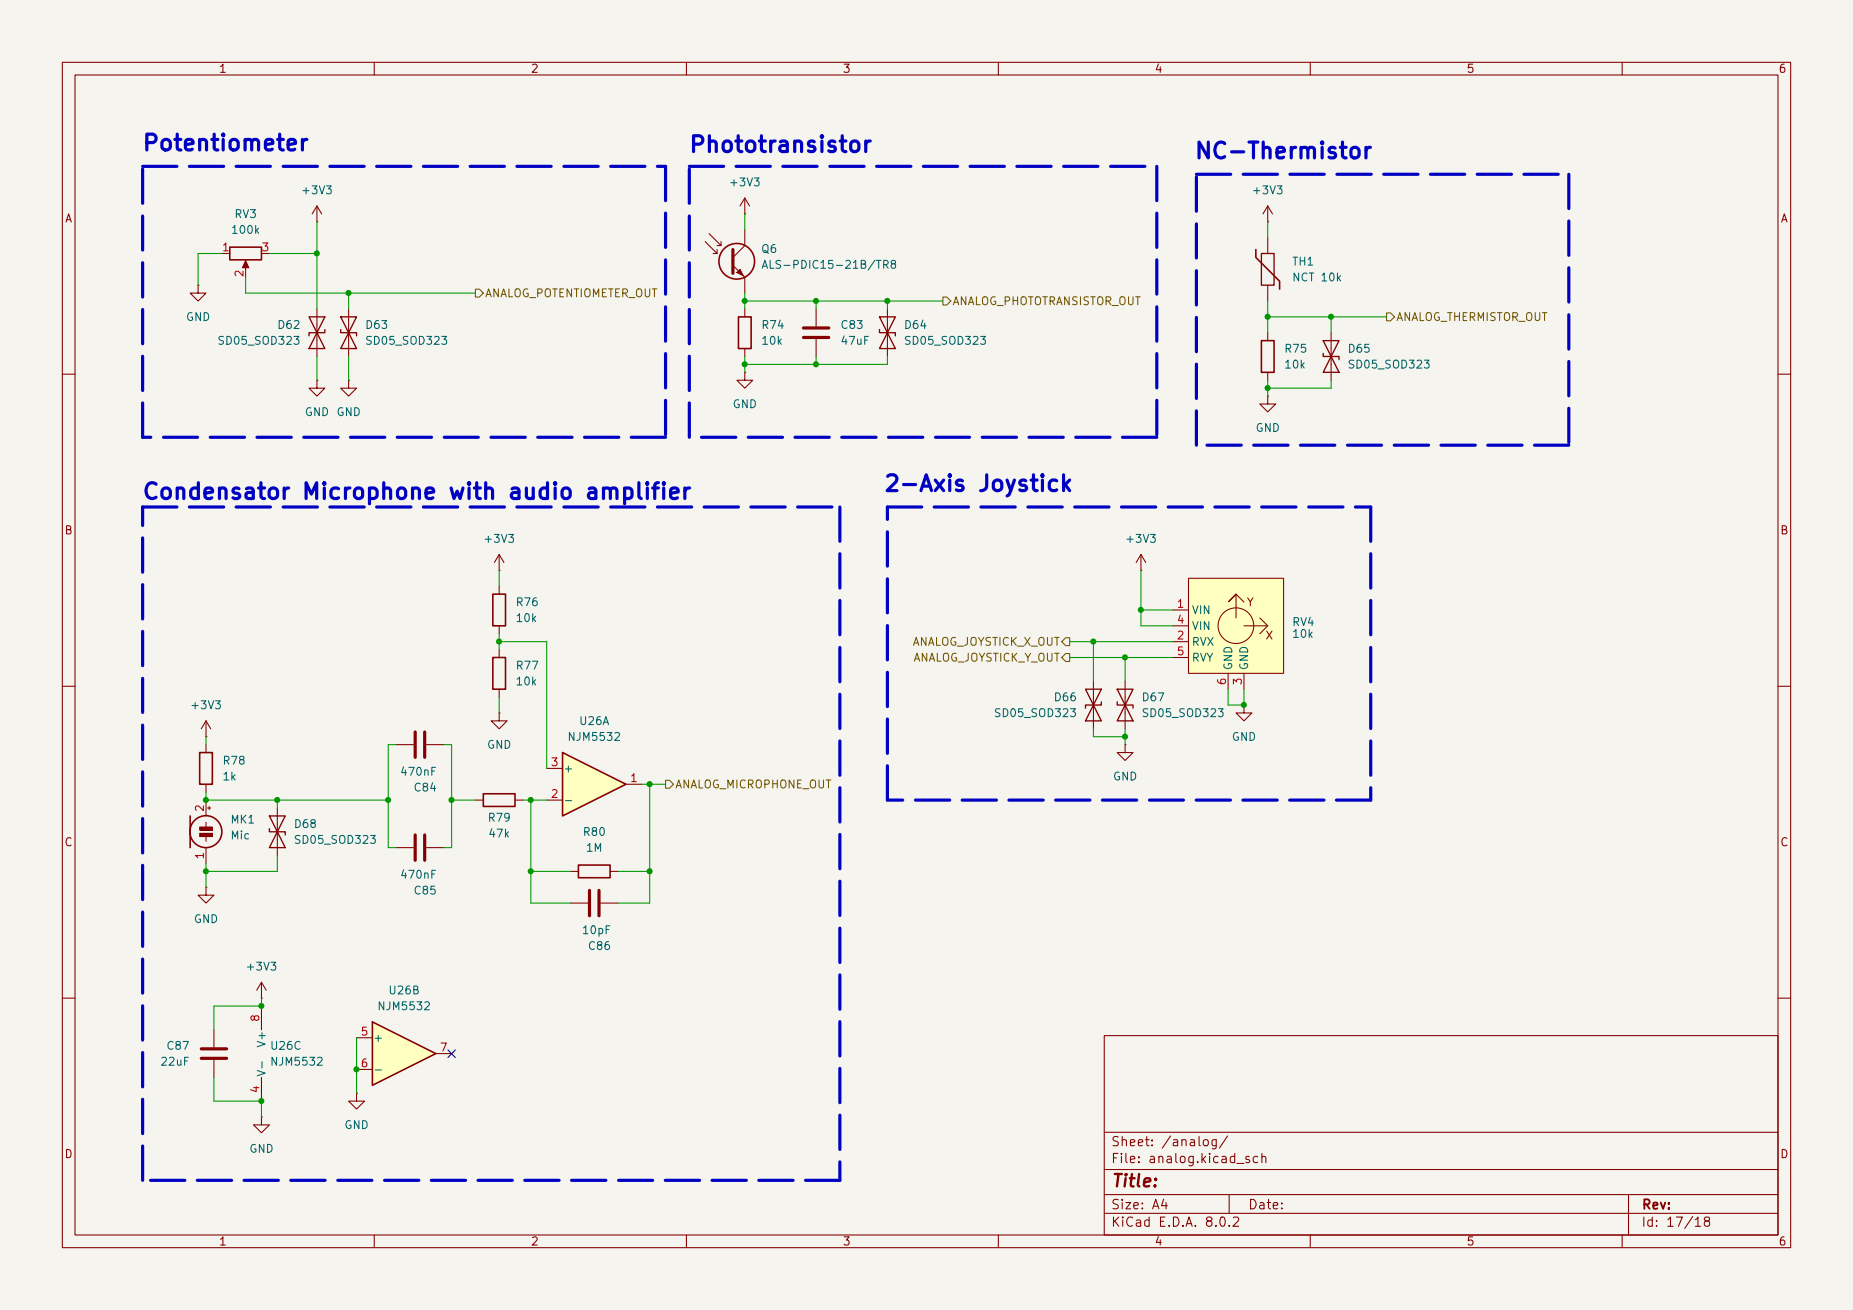
[picture p101: page 17]

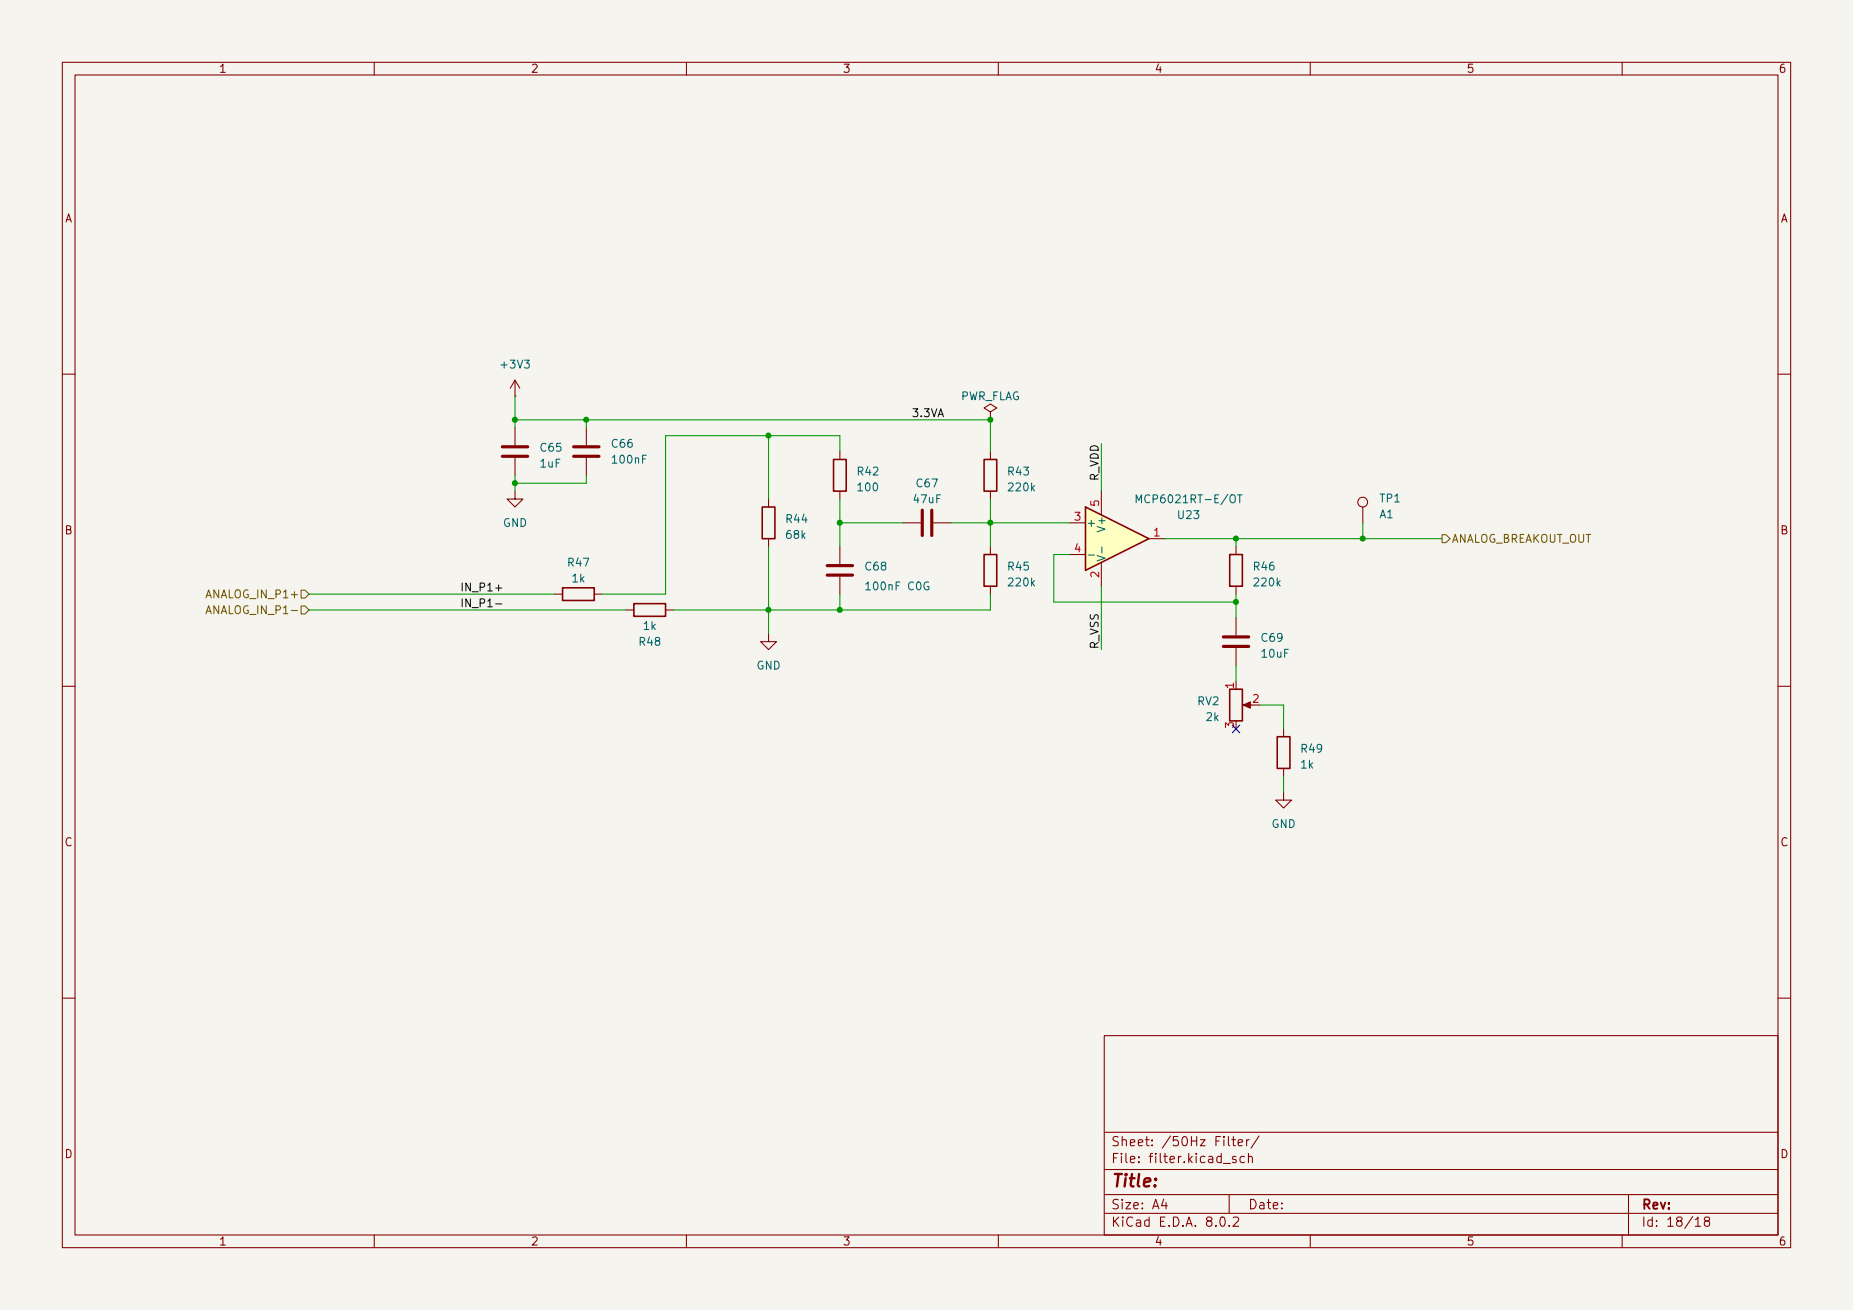
[picture p102: page 18]
