mark69163/prodigy/PRODIGY-STM32/PRODIGY-STM32/PRODIGY-STM32.kicad_pcb

## KiCad design PRODIGY-STM32/PRODIGY-STM32/PRODIGY-STM32.kicad_pcb (2024-10-14)

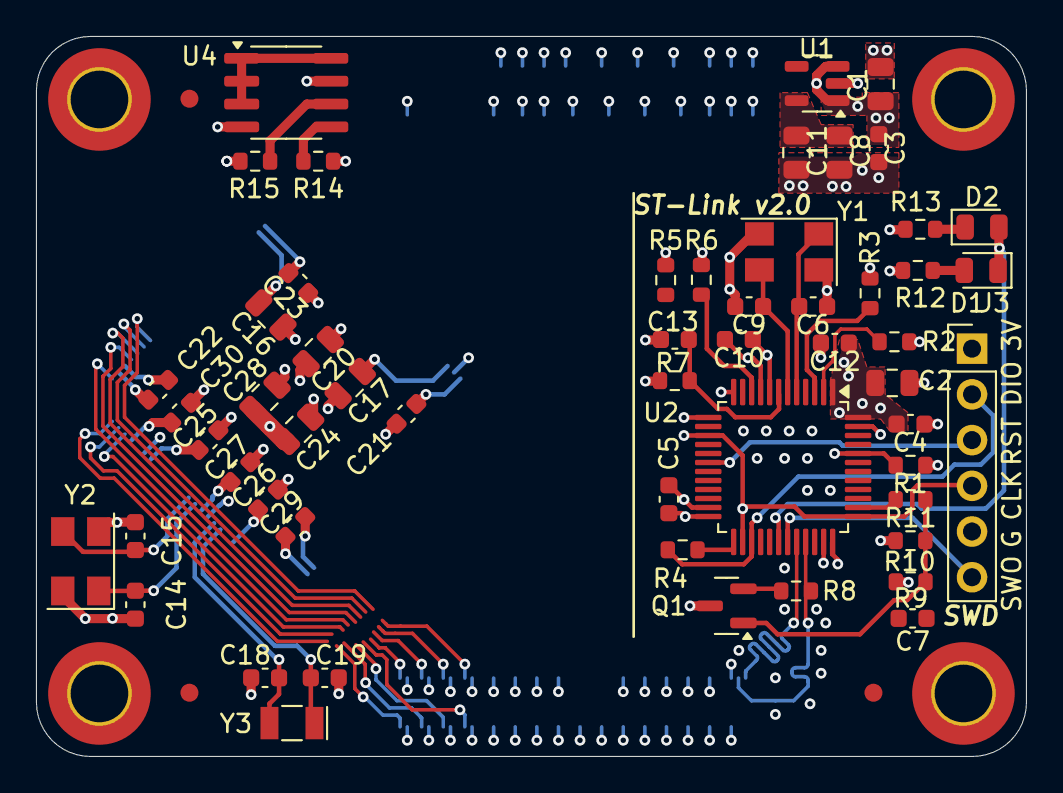
[picture p121: board PRODIGY-STM32.kicad_pcb from above]

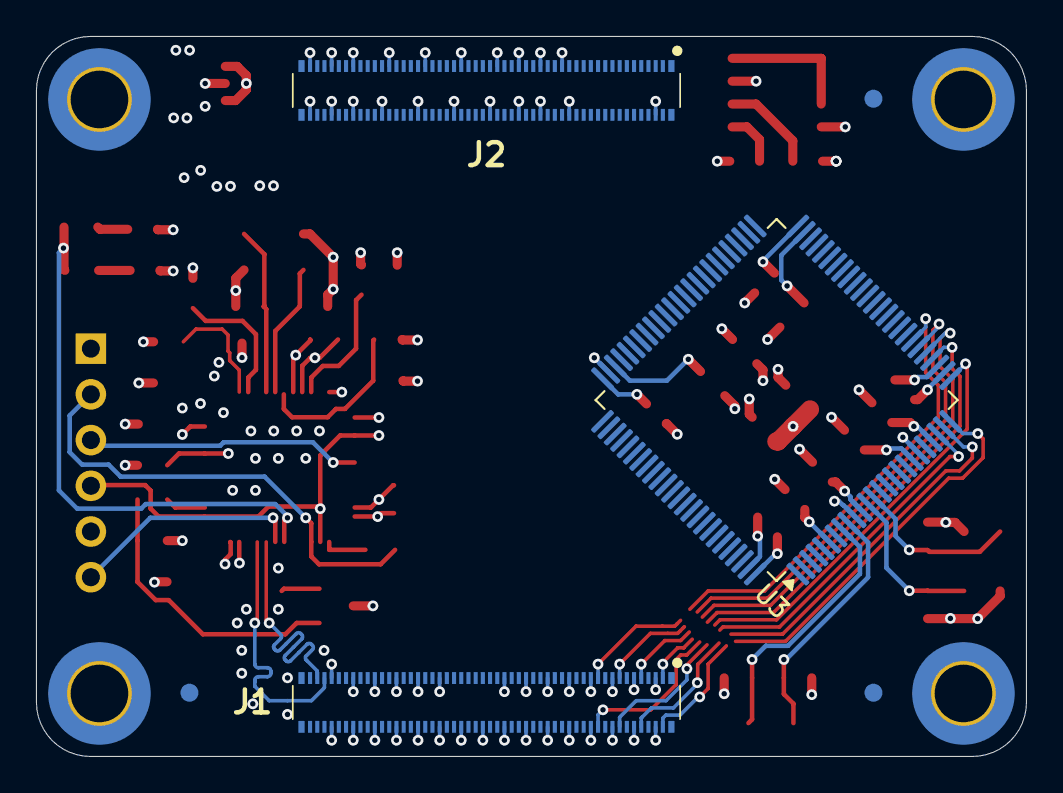
[picture p122: board PRODIGY-STM32.kicad_pcb from below]

Board: 4 copper layers, 55.0 x 40.0 mm, 68 parts (6 on the bottom side), 106 nets.

Parts:
C1, C2, C8, C11, C20, C24, C28: 10uF; C_0805_2012Metric
C3, C4, C5, C7, C10, C12, C13, C21, C22, C23, C25, C26, C27, C29, C30: 100nF; C_0603_1608Metric
C6, C9: 10pF; C_0603_1608Metric
C14, C15: 4.7pF; C_0603_1608Metric
C16, C17: 2.2uF; C_0805_2012Metric
C18, C19: 2.7pF; C_0603_1608Metric
D1, D2: LED; LED_0805_2012Metric
FID1, FID2, FID3, FID4, FID5, FID6: Fiducial; Fiducial_1mm_Mask3mm
H1, H2, H3, H4: MountingHole; MountingHole_3.2mm_M3_ISO7380_Pad_TopBottom
J1, J2: DF40C-100DP-04V-51; DF40C100DP04V51
J3: Conn_ARM_SWD_TagConnect_TC2030; PinHeader_1x06_P2.54mm_Vertical
Q1: BC850; SOT-23
R1, R7: 100k; R_0603_1608Metric
R2, R9, R10: 10k; R_0603_1608Metric
R3, R14, R15: DNP; R_0603_1608Metric
R4, R11: 100; R_0603_1608Metric
R5, R6: 4k7; R_0603_1608Metric
R8: 1k5; R_0603_1608Metric
R12, R13: 1k; R_0603_1608Metric
U1: AP2112K-3.3; SOT-23-5
U2: STM32F103C8Tx; LQFP-48_7x7mm_P0.5mm
U3: STM32F407VGTx; LQFP-100_14x14mm_P0.5mm
U4: M24C32-WMN6TP; SOIC-8_3.9x4.9mm_P1.27mm
Y1, Y2: 8MHz; Crystal_SMD_5032-4Pin_5.0x3.2mm
Y3: 32.768kHz; Crystal_SMD_MicroCrystal_CC7V-T1A-2Pin_3.2x1.5mm

Connections:
+3V3: C20.1, C21.1, C22.1, C23.1, C24.1, C25.1, C26.1, C27.1, C28.1, C29.1, C30.1, J2.12, J2.14, J2.16, J2.18, R14.1, R15.1, U3.6 (VBAT), U3.11 (VDD), U3.19 (VDD), U3.22 (VDDA), U3.28 (VDD), U3.50 (VDD), U3.75 (VDD), U3.100 (VDD), U4.1 (E0), U4.2 (E1), U4.3 (E2), U4.8 (VCC)
+5V: C1.1, C3.1, J2.13, J2.15, J2.17, J2.19, J2.21, J2.23, U1.1 (VIN), U1.3 (EN)
/Connector-1/ANALOG_BREAKOUT_PIEZO: J1.2, U3.31 (PA6)
/Connector-1/ANALOG_BREAKOUT_PT100: J1.8, U3.32 (PA7)
/Connector-1/ANALOG_HEATER_TEMPERATURE: J1.14, U3.30 (PA5)
/Connector-1/ANALOG_JOYSTICK_X: J1.13, U3.25 (PA2)
/Connector-1/ANALOG_JOYSTICK_Y: J1.7, U3.26 (PA3)
/Connector-1/ANALOG_MICROPHONE: J1.1, U3.29 (PA4)
/Connector-1/ANALOG_PHOTOTRANSISTOR: J1.19, U3.24 (PA1)
/Connector-1/ANALOG_POTENTIOMETER: J1.20, U3.23 (PA0)
/Connector-1/CAN_EN: J1.86, U3.84 (PD3)
/Connector-1/CAN_OUT_RX1: J1.83, U3.81 (PD0)
/Connector-1/CAN_OUT_TX1: J1.85, U3.82 (PD1)
/Connector-1/CAN_SILENT: J1.84, U3.85 (PD4)
/Connector-1/DIGITAL_BUTTON_IN_0: J1.53, U3.57 (PD10)
/Connector-1/DIGITAL_BUTTON_IN_1: J1.51, U3.58 (PD11)
/Connector-1/DIGITAL_BUTTON_IN_2: J1.49, U3.59 (PD12)
/Connector-1/DIGITAL_BUTTON_IN_3: J1.47, U3.60 (PD13)
/Connector-1/DIGITAL_BUZZER_OUT: J1.42, U3.36 (PB1)
/Connector-1/DIGITAL_HEATER_OUT: J1.48, U3.37 (PB2)
/Connector-1/DIGITAL_IR_EMITTER: J1.67, U3.33 (PC4)
/Connector-1/DIGITAL_IR_RECEIVER: J1.65, U3.34 (PC5)
/Connector-1/DIGITAL_LED_OUT_0: J1.43, U3.88 (PD7)
/Connector-1/DIGITAL_LED_OUT_1: J1.41, U3.61 (PD14)
/Connector-1/DIGITAL_LED_OUT_2: J1.44, U3.62 (PD15)
/Connector-1/DIGITAL_NEOPIXEL_OUT: J1.61, U3.35 (PB0)
/Connector-1/DIGITAL_RGB_B: J1.55, U3.4 (PE5)
/Connector-1/DIGITAL_RGB_G: J1.57, U3.3 (PE4)
/Connector-1/DIGITAL_RGB_R: J1.59, U3.5 (PE6)
/Connector-1/I2C_INTERRUPT_ACCEL: J1.73, U3.91 (PB5)
/Connector-1/I2C_INTERRUPT_KEYPAD: J1.71, U3.95 (PB8)
/Connector-1/MOTOR_CC_IN_1: J1.35, U3.97 (PE0)
/Connector-1/MOTOR_CC_IN_2: J1.36, U3.98 (PE1)
/Connector-1/MOTOR_PWM_OUT_1: J1.37, U3.1 (PE2)
/Connector-1/MOTOR_PWM_OUT_2: J1.38, U3.2 (PE3)
/Connector-1/SERIAL_OUT_RX1: J1.91, U3.68 (PA9)
/Connector-1/SERIAL_OUT_RX2: J1.90, U3.87 (PD6)
/Connector-1/SERIAL_OUT_TX1: J1.89, U3.69 (PA10)
/Connector-1/SERIAL_OUT_TX2: J1.92, U3.86 (PD5)
/Connector-1/SPI_CS_BREAKOUT: J1.72, U3.96 (PB9)
/Connector-1/SPI_CS_NFC: J1.56, U3.54 (PB15)
/Connector-1/SPI_CS_SEVENSEG: J1.68, U3.48 (PB11)
/Connector-1/SPI_CS_TFT: J1.66, U3.51 (PB12)
/Connector-1/SPI_IRQ_NFC: J1.54, U3.15 (PC0)
/Connector-1/SPI_MISO: J1.78, U3.17 (PC2)
/Connector-1/SPI_MOSI: J1.80, U3.18 (PC3)
/Connector-1/SPI_RST_NFC: J1.50, U3.16 (PC1)
/Connector-1/SPI_SCK: J1.74, U3.47 (PB10)
/Connector-1/SPI_TFT_DC: J1.62, U3.52 (PB13)
/Connector-1/SPI_TFT_RESET: J1.60, U3.53 (PB14)
/Connector-1/USB_DP-: J1.97, U2.32 (PA11)
/Connector-1/USB_HOST_ENABLE: J1.100, U3.77 (PA15)
/Connector-1/USB_HOST_FAULT: J1.99, U3.67 (PA8)
/Connector-1/USB_HOST_OUT_P+: J1.96, U3.71 (PA12)
/Connector-1/USB_HOST_OUT_P-: J1.98, U3.70 (PA11)
/Connector-2/MCU_GPIO_6: J2.72, U3.7 (PC13)
/Connector-2/MCU_GPIO_7: J2.63, U3.38 (PE7)
/Connector-2/MCU_GPIO_8: J2.61, U3.39 (PE8)
/Connector-2/MCU_GPIO_9: J2.62, U3.40 (PE9)
/Connector-2/MCU_GPIO_10: J2.58, U3.41 (PE10)
/Connector-2/MCU_GPIO_11: J2.64, U3.42 (PE11)
/Connector-2/MCU_GPIO_12: J2.69, U3.43 (PE12)
/Connector-2/MCU_GPIO_13: J2.74, U3.44 (PE13)
/Connector-2/MCU_GPIO_14: J2.45, U3.45 (PE14)
/Connector-2/MCU_GPIO_15: J2.49, U3.46 (PE15)
/Connector-2/MCU_RESET: J2.2, U3.14 (NRST)
/Connector-2/MCU_VREF: J2.24, U3.21 (VREF+)
/Connector-2/SD_CLK: J2.43, U3.80 (PC12)
/Connector-2/SD_CMD: J2.40, U3.83 (PD2)
/Connector-2/SD_DAT0: J2.37, U3.65 (PC8)
/Connector-2/SD_DAT1: J2.33, U3.66 (PC9)
/Connector-2/SD_DAT2: J2.31, U3.78 (PC10)
/Connector-2/SD_DAT3: J2.39, U3.79 (PC11)
/Connector-2/SD_DET: J2.26, U3.63 (PC6)
/Connector-2/SD_Enable: J2.25, U3.64 (PC7)
/mcu/BOOT: R1.1, U2.44 (BOOT0), U3.94 (BOOT0)
/mcu/SCL: J1.77, R15.2, U3.92 (PB6), U4.6 (SCL)
/mcu/SDA: J1.79, R14.2, U3.93 (PB7), U4.5 (SDA)
/mcu/T_RX: U2.13 (PA3), U3.56 (PD9)
/mcu/T_TX: U2.12 (PA2), U3.55 (PD8)
/st-link-v2/+3V3_STLINK: C2.1, C4.1, C5.1, C7.1, C8.1, C10.1, C11.1, C12.1, J3.1 (VCC), Q1.3 (C), R5.1, R7.1, R9.1, R12.1, U1.5 (VOUT), U2.1 (VBAT), U2.9 (VDDA), U2.24 (VDD), U2.36 (VDD), U2.48 (VDD)
/st-link-v2/CLK: J3.4 (SWCLK), U2.15 (PA5), U2.26 (PB13), U2.37 (PA14), U3.76 (PA14)
/st-link-v2/LED: D1.1 (K), D2.2 (A), U2.30 (PA9)
/st-link-v2/RENUM: R11.2, U2.38 (PA15)
/st-link-v2/RESET: C13.1, R7.2, U2.7 (NRST)
/st-link-v2/T_DIO: J3.2 (SWDIO), R4.1, U2.27 (PB14), U3.72 (PA13)
/st-link-v2/T_RST: J3.3 (~RESET), U2.18 (PB0), U3.90 (PB4)
/st-link-v2/T_SWO: J3.6 (SWO), U2.31 (PA10), U3.89 (PB3)
/st-link-v2/USB_D+: J1.95, R8.2, U2.33 (PA12)
GND: C1.2, C2.2, C3.2, C4.2, C5.2, C6.2, C7.2, C8.2, C9.2, C10.2, C11.2, C12.2, C13.2, C14.2, C15.2, C16.2, C17.2, C18.2, C19.2, C20.2, C21.2, C22.2, C23.2, C24.2, C25.2, C26.2, C27.2, C28.2, C29.2, C30.2, J1.3, J1.4, J1.9, J1.10, J1.15, J1.16, J1.21, J1.22, J1.27, J1.28, J1.33, J1.34, J1.39, J1.40, J1.45, J1.46, J1.52, J1.58, J1.63, J1.64, J1.69, J1.70, J1.75, J1.76, J1.81, J1.82, J1.87, J1.88, J1.93, J1.94, J2.4, J2.28, J2.29, J2.35, J2.36, J2.41, J2.42, J2.47, J2.50, J2.57, J2.60, J2.67, J2.70, J2.77, J2.80, J2.87, J2.88, J2.93, J2.94, J2.99, J2.100, J3.5 (GND), R1.2, R2.2, R3.2, R6.2, R10.2, R13.2, U1.2 (GND), U2.8 (VSSA), U2.23 (VSS), U2.35 (VSS), U2.47 (VSS), U3.10 (VSS), U3.20 (VSSA), U3.27 (VSS), U3.74 (VSS), U3.99 (VSS), U4.4 (VSS), U4.7 (~WC), Y1.2, Y1.4, Y2.2, Y2.4
unnamed: D1.2 (A), R12.2
unnamed: D2.1 (K), R13.1
unnamed: Q1.1 (B), R9.2, R10.1, R11.1
unnamed: Q1.2 (E), R8.1
unnamed: R5.2, R6.1, U2.10 (PA0)
unnamed: R4.2, U2.25 (PB12)
unnamed: R2.1, U2.2 (PC13)
unnamed: R3.1, U2.3 (PC14)
unnamed: C6.1, U2.5 (PD0), Y1.1
unnamed: C9.1, U2.6 (PD1), Y1.3
unnamed: C19.1, U3.8 (PC14), Y3.1
unnamed: C18.1, U3.9 (PC15), Y3.2
unnamed: C14.1, U3.12 (PH0), Y2.1
unnamed: C15.1, U3.13 (PH1), Y2.3
unnamed: C16.1, U3.49 (VCAP_1)
unnamed: C17.1, U3.73 (VCAP_2)
