mark69163/prodigy/PRODIGY-ATMEGA2560/PRODIGY-ATMEGA2560.kicad_pcb

## KiCad design PRODIGY-ATMEGA2560/PRODIGY-ATMEGA2560.kicad_pcb (2024-09-30)

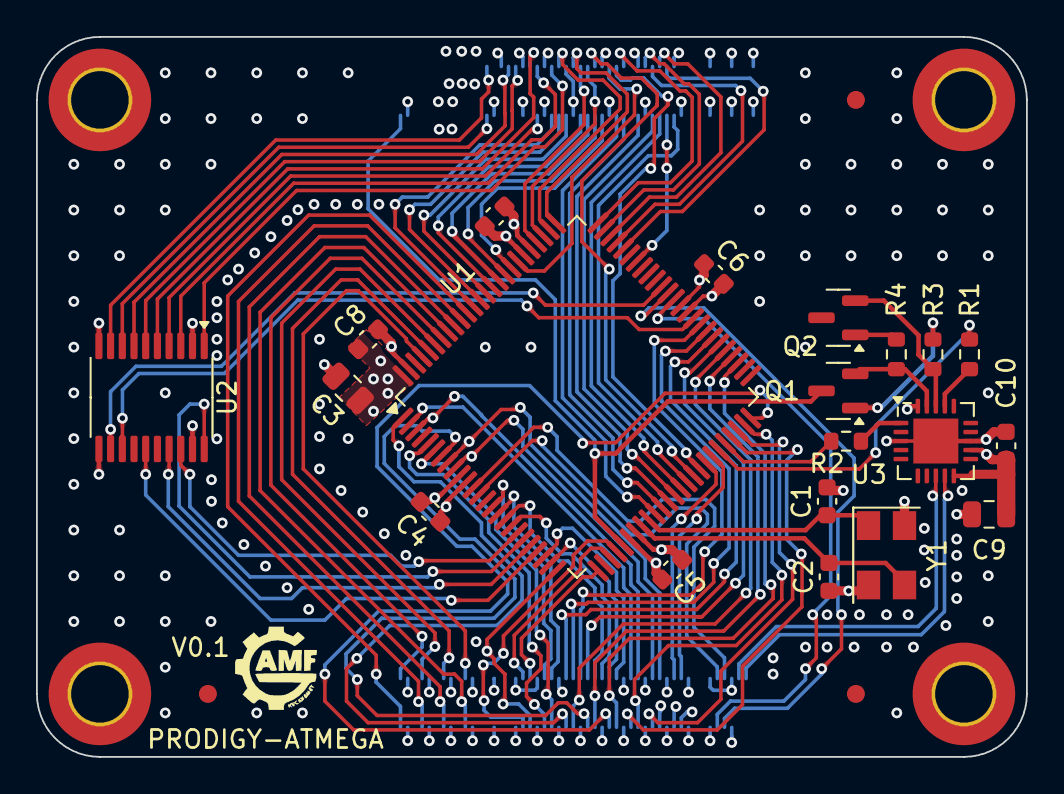
[picture p123: board PRODIGY-ATMEGA2560.kicad_pcb from above]

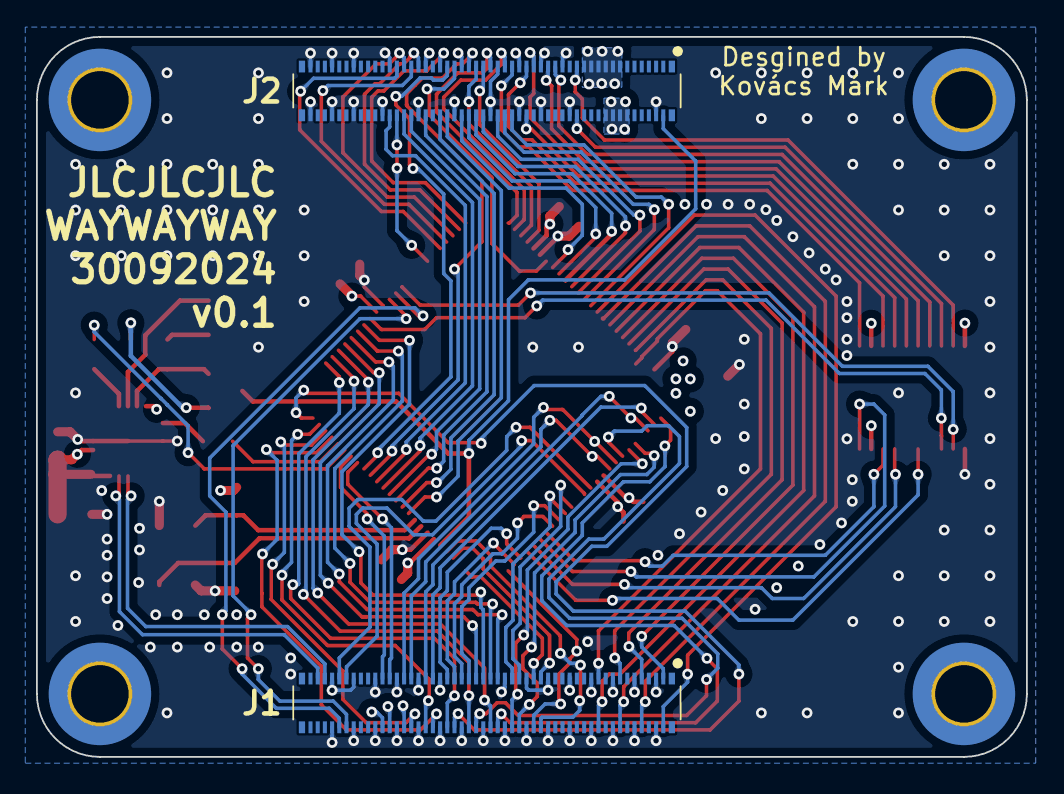
[picture p124: board PRODIGY-ATMEGA2560.kicad_pcb from below]

Board: 4 copper layers, 55.0 x 40.0 mm, 29 parts (2 on the bottom side), 99 nets.

Parts:
C1, C2: 4.7pF; C_0603_1608Metric
C3, C9: 10uF; C_0805_2012Metric
C4, C5, C6, C7, C8, C10: 100nF; C_0603_1608Metric
FID1, FID2, FID3: Fiducial; Fiducial_1mm_Mask3mm
H1, H2, H3, H4: MountingHole; MountingHole_3.2mm_M3_ISO7380_Pad_TopBottom
J1, J2: DF40C-100DP-04V-51; DF40C100DP04V51
Q1, Q2: BC850; SOT-23
R1, R2: 0R; R_0603_1608Metric
R3, R4: 10k; R_0603_1608Metric
U1: ATmega2560-8A; TQFP-100_14x14mm_P0.5mm
U2: TXS0108EPW; TSSOP-20_4.4x6.5mm_P0.65mm
U3: FT231XQ; QFN-20-1EP_4x4mm_P0.5mm_EP2.5x2.5mm
Y1: 8MHz; Crystal_SMD_5032-4Pin_5.0x3.2mm

Connections:
+3V3: J2.12, J2.14, J2.16, J2.18, U2.2 (VCCA), U2.10 (OE)
+5V: C3.1, C4.1, C5.1, C6.1, C7.1, C8.1, C9.1, C10.1, J2.13, J2.15, J2.17, J2.19, J2.21, J2.23, U1.10 (VCC), U1.31 (VCC), U1.61 (VCC), U1.80 (VCC), U1.100 (AVCC), U2.19 (VCCB), U3.10 (3V3OUT), U3.12 (VCC), U3.20 (VCCIO)
/atmega2560/ANALOG_BREAKOUT_PIEZO: J1.2, U1.90 (PF7)
/atmega2560/ANALOG_BREAKOUT_PT100: J1.8, U1.91 (PF6)
/atmega2560/ANALOG_HEATER_TEMPERATURE: J1.14, U1.92 (PF5)
/atmega2560/ANALOG_JOYSTICK_X: J1.13, U1.96 (PF1)
/atmega2560/ANALOG_JOYSTICK_Y: J1.7, U1.95 (PF2)
/atmega2560/ANALOG_MICROPHONE: J1.1, U1.94 (PF3)
/atmega2560/ANALOG_PHOTOTRANSISTOR: J1.19, U1.97 (PF0)
/atmega2560/ANALOG_POTENTIOMETER: J1.20, U1.93 (PF4)
/atmega2560/DIGITAL_BUTTON_IN_0: J1.53, U1.56 (PC3)
/atmega2560/DIGITAL_BUTTON_IN_1: J1.51, U1.59 (PC6)
/atmega2560/DIGITAL_BUTTON_IN_2: J1.49, U1.58 (PC5)
/atmega2560/DIGITAL_BUTTON_IN_3: J1.47, U1.57 (PC4)
/atmega2560/DIGITAL_BUZZER_OUT: J1.42, U1.5 (PE3)
/atmega2560/DIGITAL_HEATER_OUT: J1.48, U1.1 (PG5)
/atmega2560/DIGITAL_IR_EMITTER: J1.67, U1.3 (PE1)
/atmega2560/DIGITAL_IR_RECEIVER: J1.65, U1.2 (PE0)
/atmega2560/DIGITAL_LED_OUT_0: J1.43, U1.16 (PH4)
/atmega2560/DIGITAL_LED_OUT_1: J1.41, U1.15 (PH3)
/atmega2560/DIGITAL_LED_OUT_2: J1.44, U1.6 (PE4)
/atmega2560/DIGITAL_NEOPIXEL_OUT: J1.61, U1.23 (PB4)
/atmega2560/DIGITAL_RGB_B: J1.55, U1.17 (PH5)
/atmega2560/DIGITAL_RGB_G: J1.57, U1.18 (PH6)
/atmega2560/DIGITAL_RGB_R: J1.59, U1.24 (PB5)
/atmega2560/I2C_INTERRUPT_ACCEL: J1.73, U1.8 (PE6)
/atmega2560/I2C_INTERRUPT_KEYPAD: J1.71, U1.9 (PE7)
/atmega2560/I2C_SCL: J1.77, U1.43 (PD0)
/atmega2560/I2C_SDA: J1.79, U1.44 (PD1)
/atmega2560/MCU_GPIO_2: J2.44, U1.89 (PK0)
/atmega2560/MCU_GPIO_3: J2.46, U1.88 (PK1)
/atmega2560/MCU_GPIO_4: J2.48, U1.87 (PK2)
/atmega2560/MCU_GPIO_5: J2.68, U1.37 (PL2)
/atmega2560/MCU_GPIO_6: J2.72, U1.38 (PL3)
/atmega2560/MCU_GPIO_7: J2.63, U1.75 (PA3)
/atmega2560/MCU_GPIO_8: J2.61, U1.42 (PL7)
/atmega2560/MCU_GPIO_9: J2.62, U1.35 (PL0)
/atmega2560/MCU_GPIO_10: J2.58, U1.83 (PK6)
/atmega2560/MCU_GPIO_11: J2.64, U1.36 (PL1)
/atmega2560/MCU_GPIO_12: J2.69, U1.74 (PA4)
/atmega2560/MCU_GPIO_13: J2.74, U1.39 (PL4)
/atmega2560/MCU_GPIO_14: J2.45, U1.77 (PA1)
/atmega2560/MCU_GPIO_15: J2.49, U1.76 (PA2)
/atmega2560/MCU_GPIO_16: J2.71, U1.72 (PA6)
/atmega2560/MCU_GPIO_17: J2.52, U1.86 (PK3)
/atmega2560/MCU_GPIO_18: J2.51, U1.79 (PJ7)
/atmega2560/MCU_GPIO_19: J2.76, U1.69 (PJ6)
/atmega2560/MCU_GPIO_20: J2.73, U1.73 (PA5)
/atmega2560/MCU_GPIO_21: J2.75, U1.71 (PA7)
/atmega2560/MCU_GPIO_22: J2.56, U1.84 (PK5)
/atmega2560/MCU_GPIO_23: J2.53, U1.78 (PA0)
/atmega2560/MCU_GPIO_24: J2.55, U1.41 (PL6)
/atmega2560/MCU_GPIO_25: J2.59, U1.82 (PK7)
/atmega2560/MCU_GPIO_26: J2.78, U1.40 (PL5)
/atmega2560/MCU_GPIO_27: J2.54, U1.85 (PK4)
/atmega2560/MCU_RESET: J2.2, Q1.3 (C), U1.30 (~RESET)
/atmega2560/MISO: J1.78, U1.22 (PB3), U2.15 (B5)
/atmega2560/MOSI: J1.80, U1.21 (PB2), U2.17 (B3)
/atmega2560/MOTOR_CC_IN_1: J1.35, U1.28 (PG3)
/atmega2560/MOTOR_CC_IN_2: J1.36, U1.29 (PG4)
/atmega2560/MOTOR_PWM_OUT_1: J1.37, U1.26 (PB7)
/atmega2560/MOTOR_PWM_OUT_2: J1.38, U1.25 (PB6)
/atmega2560/SCK: J1.74, U1.20 (PB1), U2.20 (B1)
/atmega2560/SD_CLK: J2.43, U2.1 (A1)
/atmega2560/SD_CMD: J2.40, U2.4 (A3)
/atmega2560/SD_CS: U1.19 (PB0), U2.18 (B2)
/atmega2560/SD_DAT0: J2.33, U2.6 (A5)
/atmega2560/SD_DAT1: J2.37, U2.5 (A4)
/atmega2560/SD_DAT2: J2.31, U2.7 (A6)
/atmega2560/SD_DAT3: J2.39, U2.3 (A2)
/atmega2560/SD_DET: J2.26, U2.8 (A7)
/atmega2560/SD_DET_5V: U1.60 (PC7), U2.13 (B7)
/atmega2560/SD_EN: U1.65 (PJ2), U2.12 (B8)
/atmega2560/SD_Enable: J2.25, U2.9 (A8)
/atmega2560/SERIAL_OUT_RX1: J1.91, U1.12 (PH0)
/atmega2560/SERIAL_OUT_RX2: J1.90, U1.63 (PJ0)
/atmega2560/SERIAL_OUT_TX1: J1.89, U1.13 (PH1)
/atmega2560/SERIAL_OUT_TX2: J1.92, U1.64 (PJ1)
/atmega2560/SPI_CS_BREAKOUT: J1.72, U1.48 (PD5)
/atmega2560/SPI_CS_NFC: J1.56, U1.54 (PC1)
/atmega2560/SPI_CS_SEVENSEG: J1.68, U1.49 (PD6)
/atmega2560/SPI_CS_TFT: J1.66, U1.47 (PD4)
/atmega2560/SPI_IRQ_NFC: J1.54, U1.7 (PE5)
/atmega2560/SPI_RST_NFC: J1.50, U1.55 (PC2)
/atmega2560/SPI_TFT_DC: J1.62, U1.53 (PC0)
/atmega2560/SPI_TFT_RESET: J1.60, U1.50 (PD7)
/atmega2560/USB_RX: R1.2, U1.45 (PD2)
/atmega2560/USB_TX: R2.2, U1.46 (PD3)
/connectorLeft/USB+: J1.95, U3.8 (USBDP)
/connectorLeft/USB-: J1.97, U3.9 (USBDM)
/usbBridge/DTR: Q2.2 (E), R3.1, U3.18 (~DTR)
/usbBridge/RTS: Q1.2 (E), R4.1, U3.19 (~RTS)
GND: C1.2, C2.2, C3.2, C4.2, C5.2, C6.2, C7.2, C8.2, C9.2, C10.2, J1.3, J1.4, J1.9, J1.10, J1.15, J1.16, J1.21, J1.22, J1.27, J1.28, J1.33, J1.34, J1.39, J1.40, J1.45, J1.46, J1.52, J1.58, J1.63, J1.64, J1.69, J1.70, J1.75, J1.76, J1.81, J1.82, J1.87, J1.88, J1.93, J1.94, J2.4, J2.28, J2.29, J2.35, J2.36, J2.41, J2.42, J2.47, J2.50, J2.57, J2.60, J2.67, J2.70, J2.77, J2.80, J2.87, J2.88, J2.93, J2.94, J2.99, J2.100, U1.11 (GND), U1.32 (GND), U1.62 (GND), U1.81 (GND), U1.99 (GND), U2.11 (GND), U3.3 (GND), U3.13 (GND), U3.21 (GND), Y1.2, Y1.4
unnamed: Q1.1 (B), R3.2
unnamed: Q2.1 (B), R4.2
unnamed: C1.1, U1.34 (XTAL1), Y1.1
unnamed: C2.1, U1.33 (XTAL2), Y1.3
unnamed: R2.1, U3.1 (RXD)
unnamed: R1.1, U3.17 (TXD)
