mark69163/prodigy/PRODIGY-MOTHERBOARD/PRODIGY-MOTHERBOARD.kicad_pcb

## KiCad design PRODIGY-MOTHERBOARD/PRODIGY-MOTHERBOARD.kicad_pcb (2024-09-15)

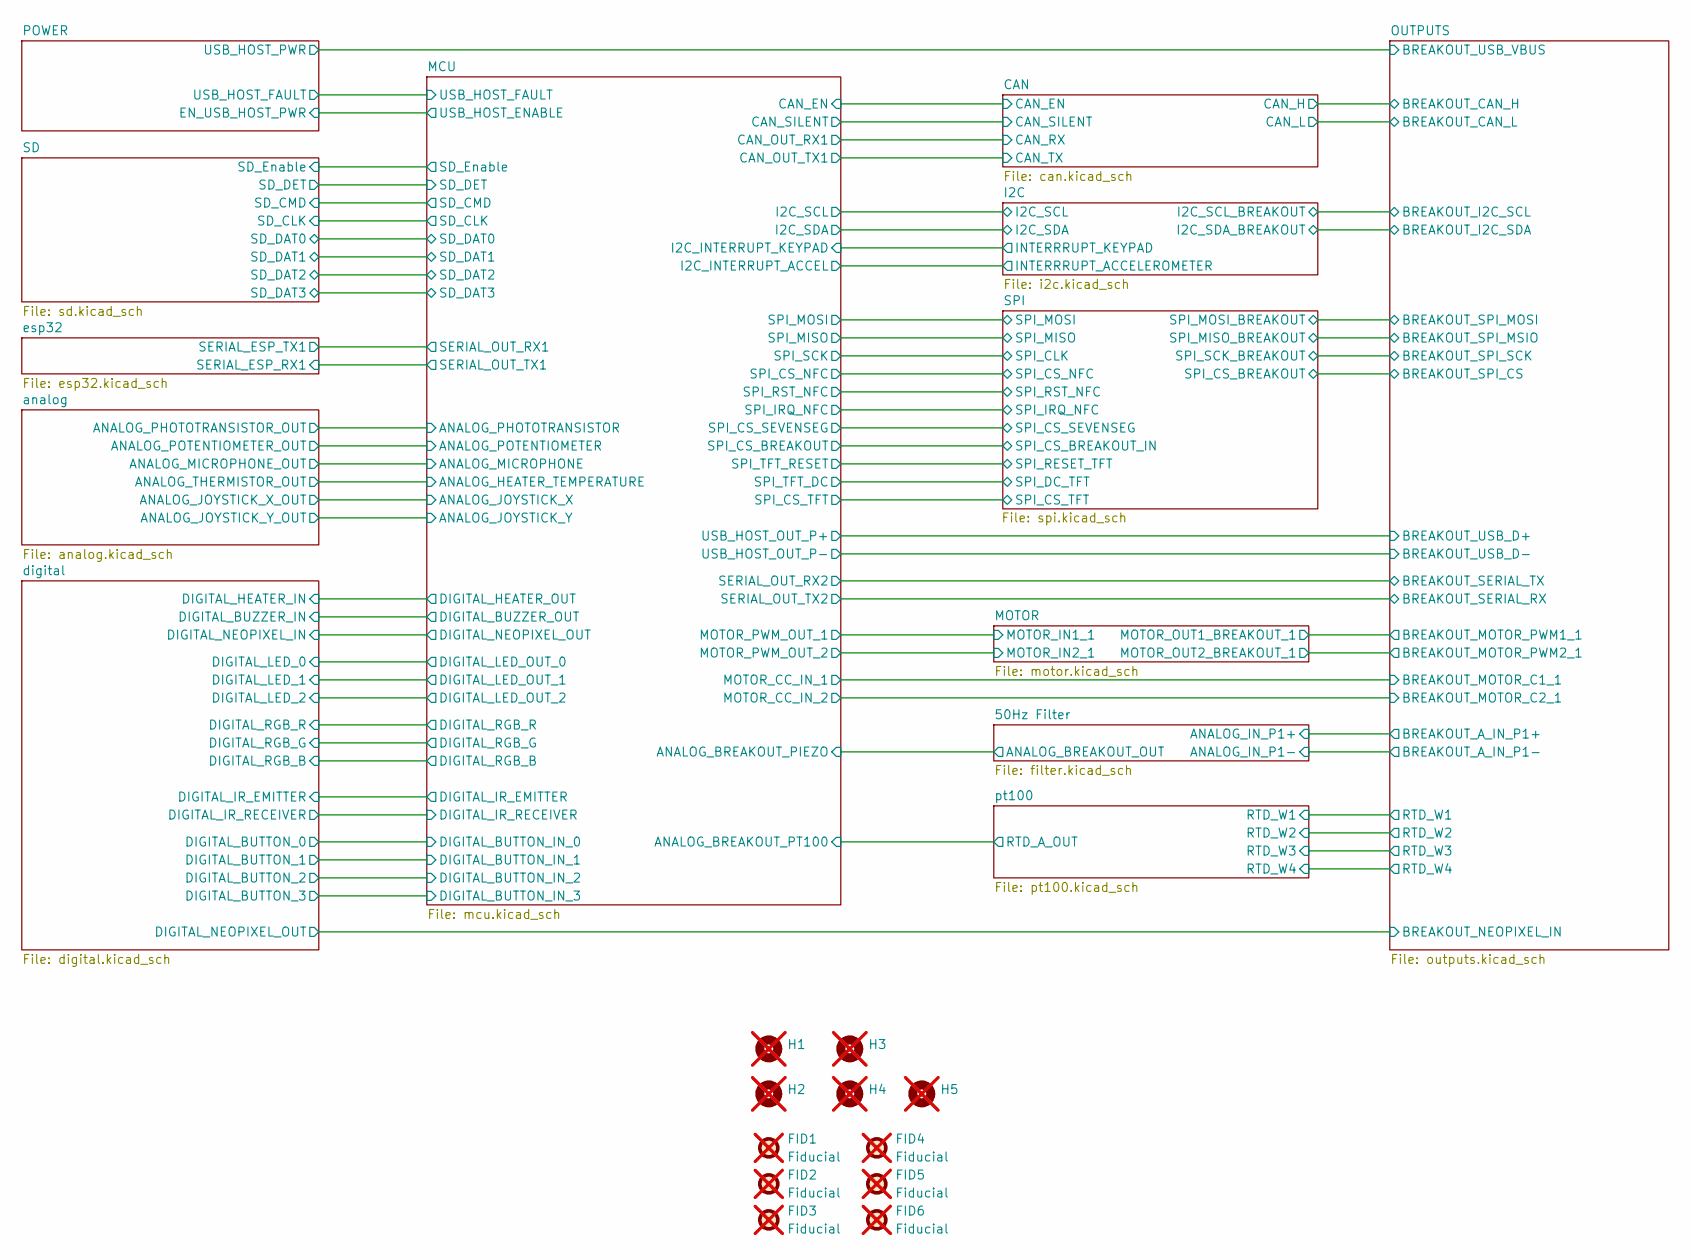
[picture p125: schematic PRODIGY-MOTHERBOARD.kicad_sch]

Parts:
FID1, FID2, FID3, FID4, FID5, FID6: Fiducial; Fiducial_1mm_Mask3mm; not fitted
H1, H2, H3, H4, H5: MountingHole; MountingHole_3.2mm_M3_ISO7380_Pad_TopBottom; not fitted

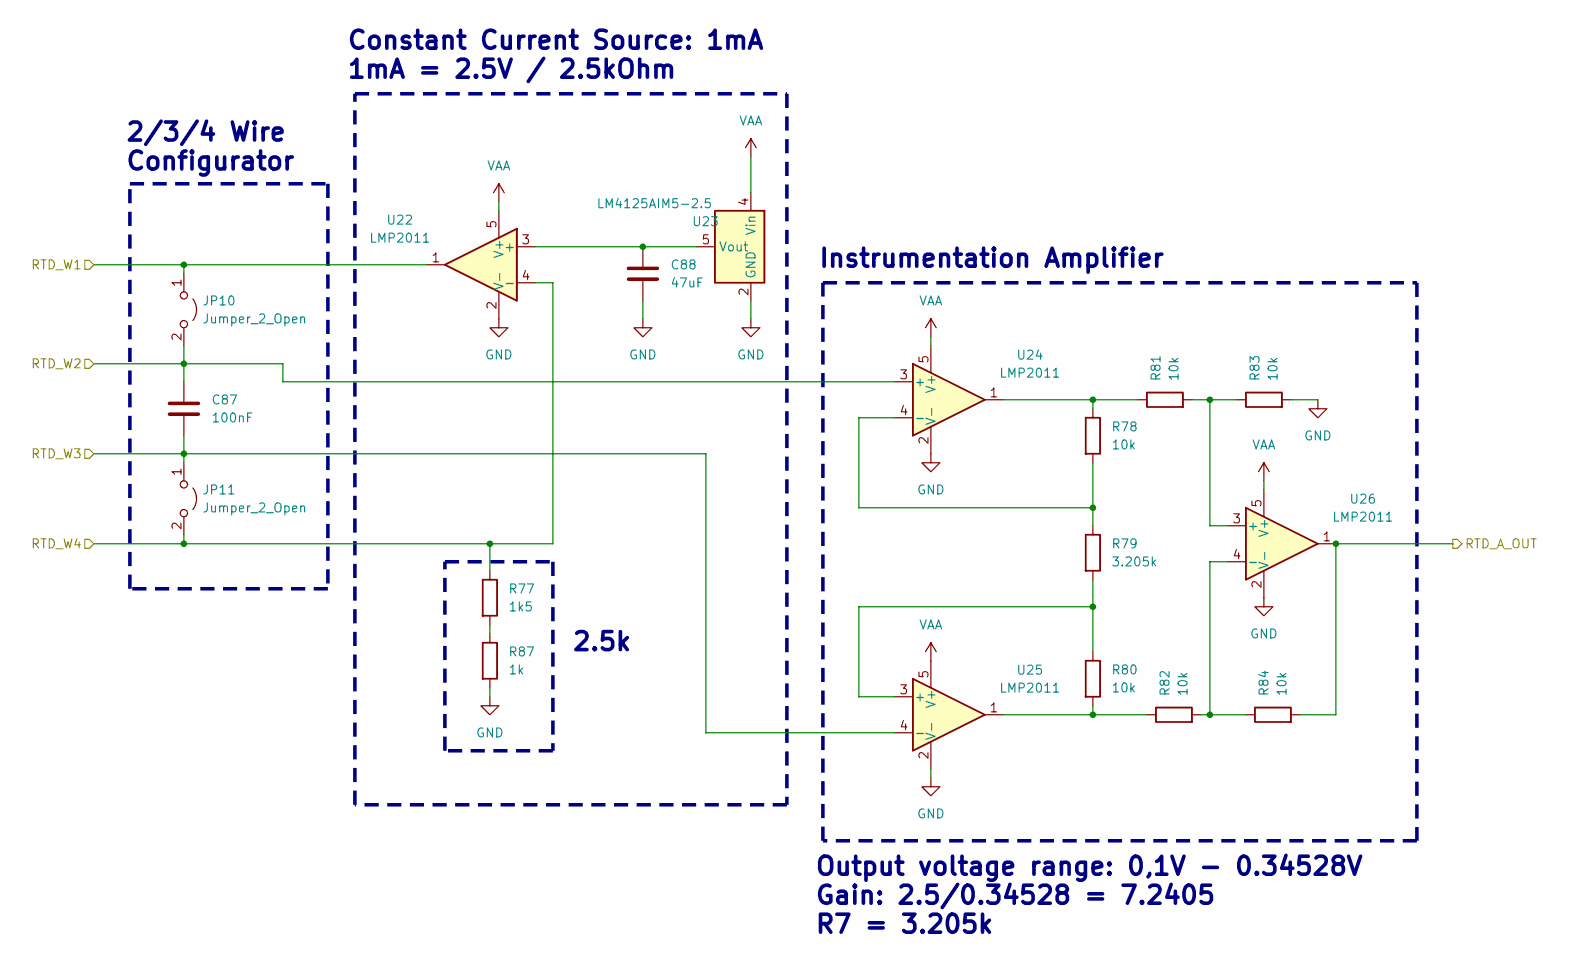
[picture p126: schematic pt100.kicad_sch]

Parts:
C87: 100nF; C_0603_1608Metric
C88: 47uF; C_1210_3225Metric
JP10, JP11: Jumper_2_Open; PinHeader_1x02_P2.54mm_Vertical
R77: 1k5; R_0603_1608Metric
R78, R80, R81, R82, R83, R84: 10k; R_0603_1608Metric
R79: 3.205k; R_0603_1608Metric
R87: 1k; R_0603_1608Metric
U22, U24, U25, U26: LMP2011; TSOT-23-5; MOUSER 926-LMP2011MFX/NOPB
U23: LM4125AIM5-2.5; SOT-23-5; MOUSER 926-LM4125IM525NOPB

Connections:
/MCU/ANALOG_BREAKOUT_PT100: R84.2, U26.1; also elsewhere on the board
/OUTPUTS/RTD_W1: JP10.1 (A), U22.1; also elsewhere on the board
/OUTPUTS/RTD_W2: C87.1, JP10.2 (B), U24.3 (+); also elsewhere on the board
/OUTPUTS/RTD_W3: C87.2, JP11.1 (A), U25.4 (-); also elsewhere on the board
/OUTPUTS/RTD_W4: JP11.2 (B), R77.1, U22.4 (-); also elsewhere on the board
GND: C88.2, R83.2, R87.2, U22.2 (V-), U23.2 (GND), U24.2 (V-), U25.2 (V-), U26.2 (V-); also elsewhere on the board
unnamed: R77.2, R87.1
unnamed: R78.1, R81.1, U24.1
unnamed: R80.2, R82.1, U25.1
unnamed: C88.1, U22.3 (+), U23.5 (Vout)
unnamed: R78.2, R79.1, U24.4 (-)
unnamed: R79.2, R80.1, U25.3 (+)
unnamed: R81.2, R83.1, U26.3 (+)
unnamed: R82.2, R84.1, U26.4 (-)
VAA: U22.5 (V+), U23.4 (Vin), U24.5 (V+), U25.5 (V+), U26.5 (V+); also elsewhere on the board

Notes on the sheet:
Output voltage range: 0,1V - 0.34528V Gain: 2.5/0.34528 = 7.2405 R7 = 3.205k
Constant Current Source: 1mA 1mA = 2.5V / 2.5kOhm
2/3/4 Wire Configurator
Instrumentation Amplifier
2.5k

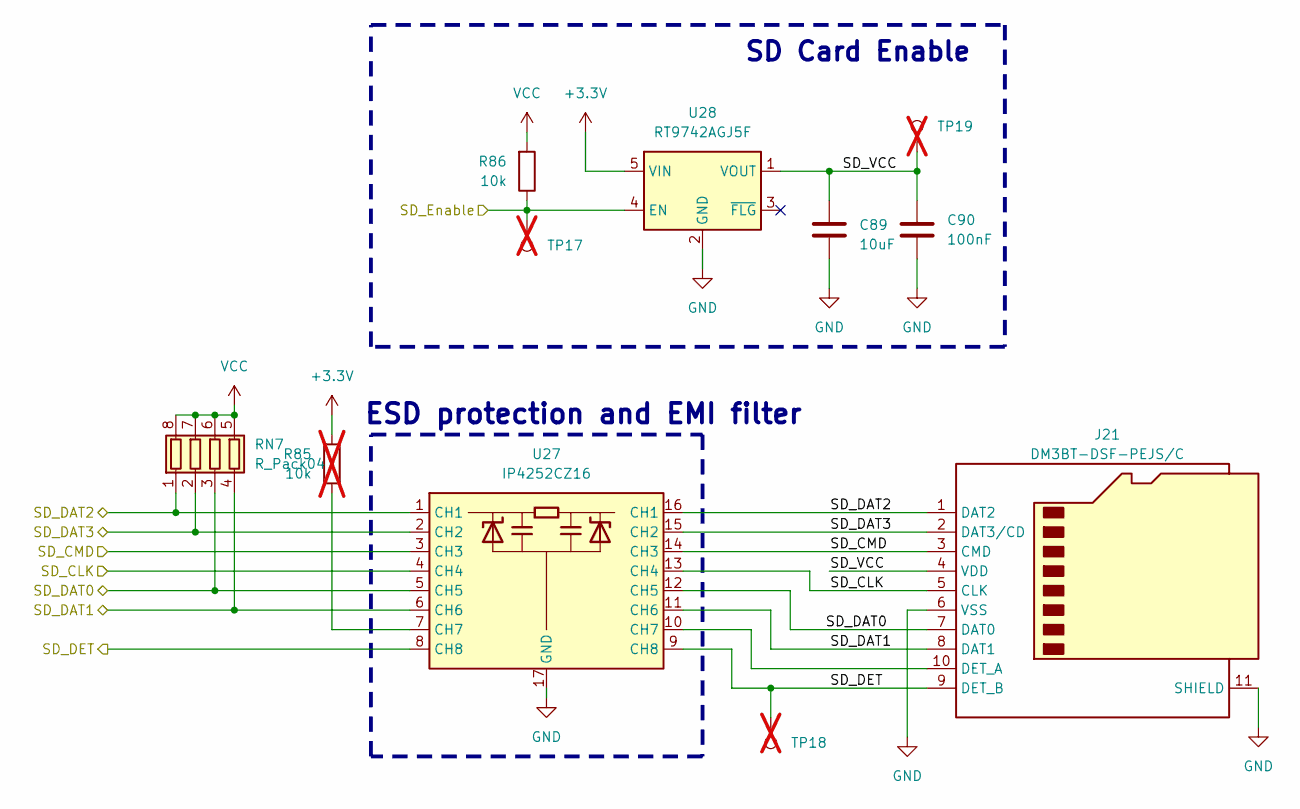
[picture p127: schematic sd.kicad_sch]

Parts:
C89: 10uF; C_0805_2012Metric
C90: 100nF; C_0603_1608Metric
J21: DM3BT-DSF-PEJS/C; microSD_HC_Hirose_DM3BT-DSF-PEJS
R85: 10k; R_0603_1608Metric; not fitted
R86: 10k; R_0603_1608Metric
RN7: R_Pack04; R_Array_Convex_4x0603
TP17, TP18, TP19: TestPoint_Pad_D3.0mm; not fitted
U27: IP4252CZ16; Nexperia_HUSON-16_USON-16-1EP_1.35x3.3mm_P0.4mm_EP0.4x2.8mm; MOUSER 771-IP4252CZ168TTL1
U28: RT9742AGJ5F; TSOT-23-5; MOUSER 835-RT9742AGJ5F

Connections:
+3.3V: R85.2, U28.5 (VIN); also elsewhere on the board
/MCU/SD_Enable: R86.1, TP17.1, U28.4 (EN); also elsewhere on the board
/SD/SD_CLK: J21.5 (CLK), U27.4 (CH4), U27.13 (CH4); also elsewhere on the board
/SD/SD_CMD: J21.3 (CMD), U27.3 (CH3), U27.14 (CH3); also elsewhere on the board
/SD/SD_DAT0: J21.7 (DAT0), RN7.3 (R3.1), U27.5 (CH5), U27.12 (CH5); also elsewhere on the board
/SD/SD_DAT1: J21.8 (DAT1), RN7.4 (R4.1), U27.6 (CH6), U27.11 (CH6); also elsewhere on the board
/SD/SD_DAT2: J21.1 (DAT2), RN7.1 (R1.1), U27.1 (CH1), U27.16 (CH1); also elsewhere on the board
/SD/SD_DAT3: J21.2 (DAT3/CD), RN7.2 (R2.1), U27.2 (CH2), U27.15 (CH2); also elsewhere on the board
/SD/SD_DET: J21.9 (DET_B), TP18.1, U27.8 (CH8), U27.9 (CH8); also elsewhere on the board
/SD/SD_VCC: C89.1, C90.1, J21.4 (VDD), TP19.1, U28.1 (VOUT)
GND: C89.2, C90.2, J21.6 (VSS), J21.11 (SHIELD), U27.17 (GND), U28.2 (GND); also elsewhere on the board
unnamed: J21.10 (DET_A), U27.10 (CH7)
unnamed: R85.1, U27.7 (CH7)
VCC: R86.2, RN7.5 (R4.2), RN7.6 (R3.2), RN7.7 (R2.2), RN7.8 (R1.2); also elsewhere on the board

Notes on the sheet:
SD Card Enable
ESD protection and EMI filter
