mark69163/prodigy/PRODIGY-MOTHERBOARD/PRODIGY-MOTHERBOARD.kicad_pcb

## KiCad design PRODIGY-MOTHERBOARD/PRODIGY-MOTHERBOARD.kicad_pcb (continued)

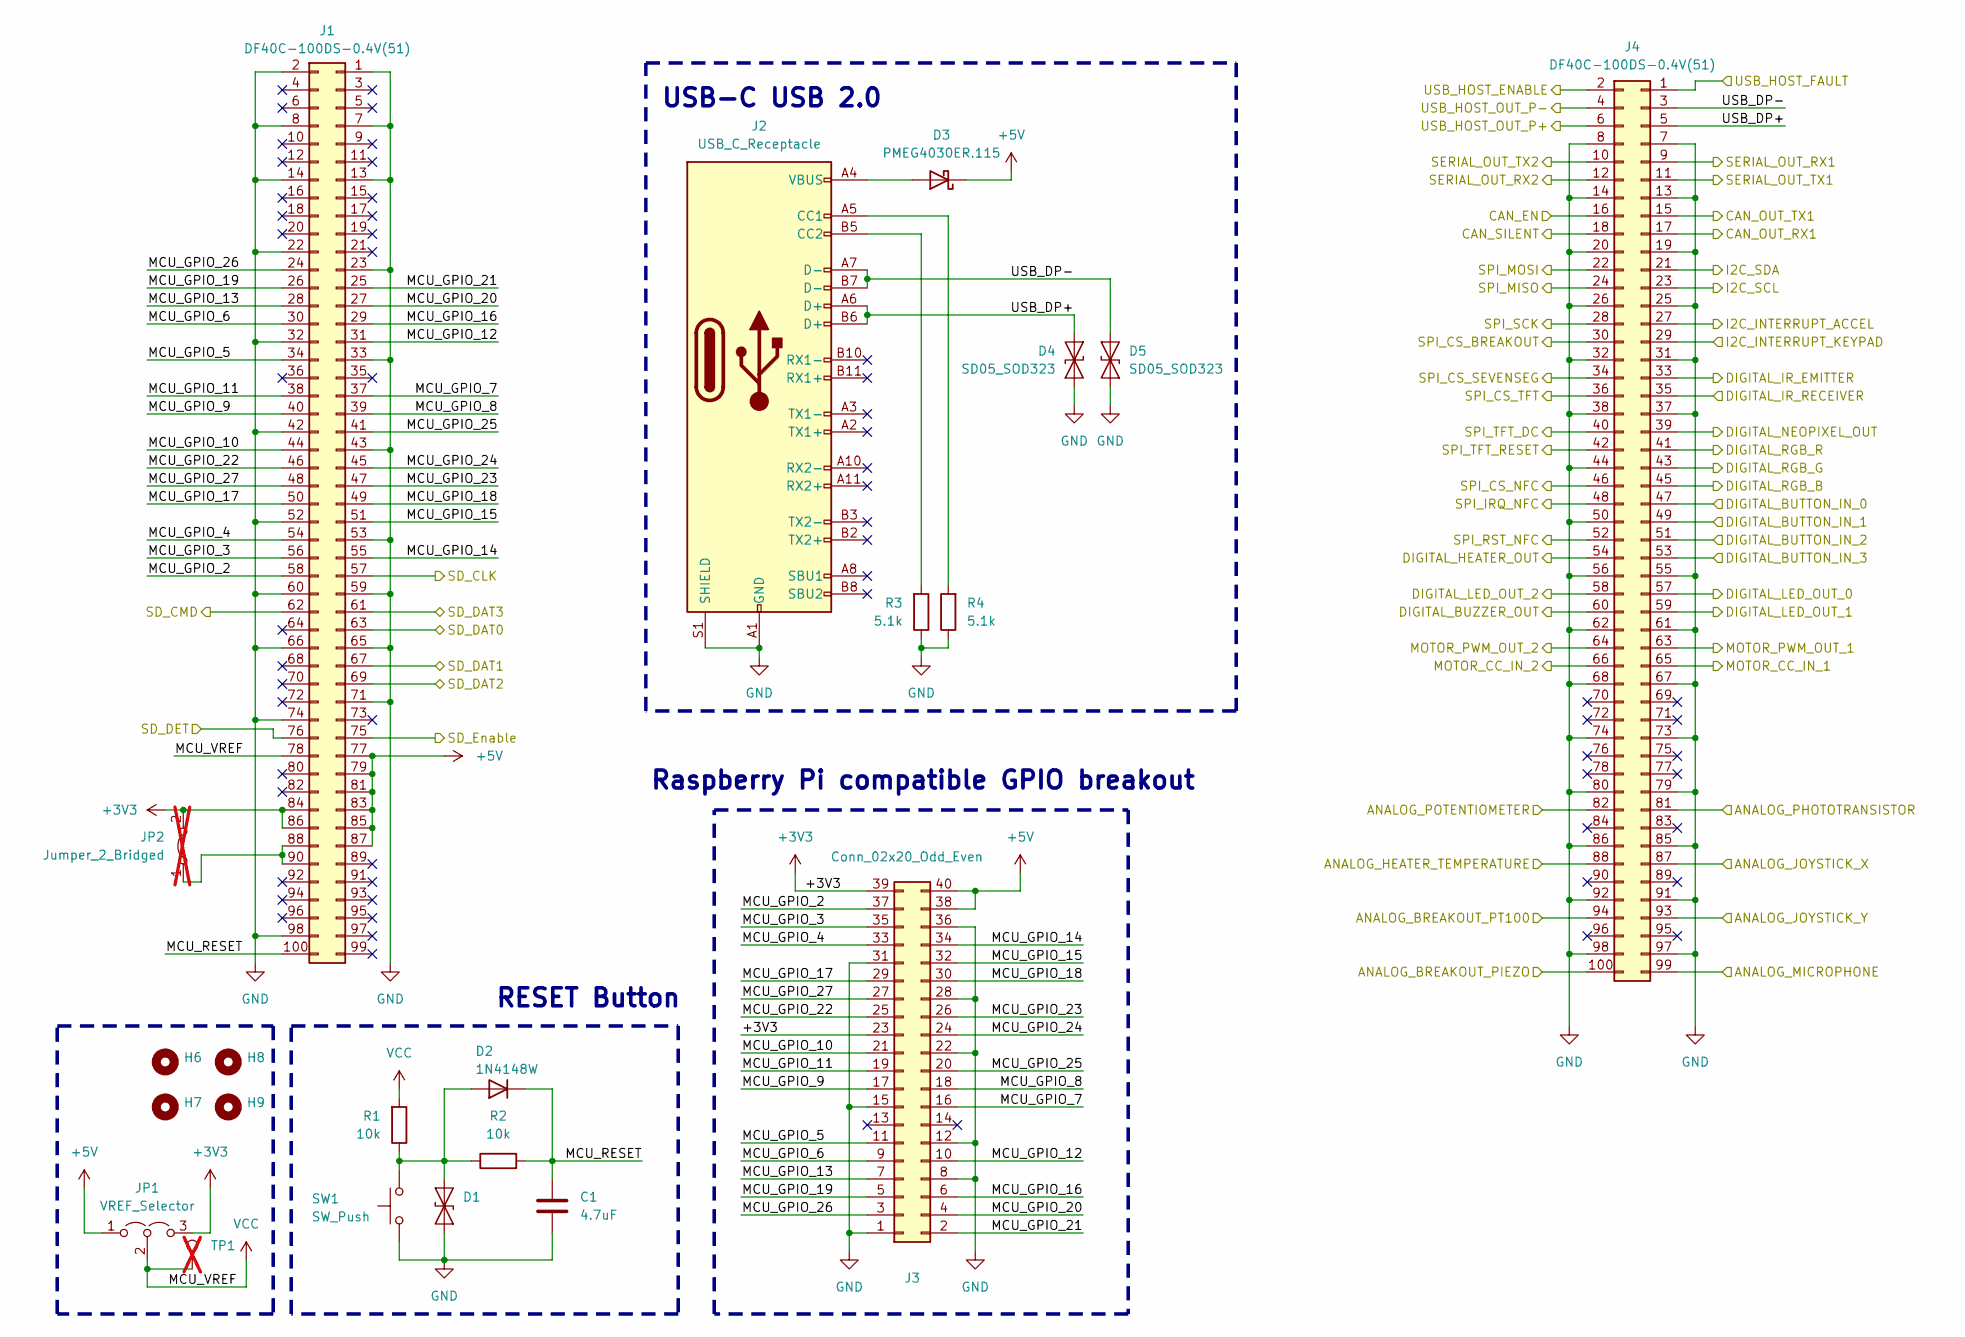
[picture p128: schematic mcu.kicad_sch]

Parts:
C1: 4.7uF; C_0805_2012Metric
D1, D4, D5: SD05_SOD323; D_SOD-323
D2: 1N4148W; D_SOD-323
D3: PMEG4030ER.115; Nexperia_CFP3_SOD-123W
H6, H7, H8, H9: MountingHole; MountingHole_4.3mm_M4_ISO14580_Pad
J1, J4: DF40C-100DS-0.4V(51); HIROSE_DF40C-100DS-0.4V_51_
J2: USB_C_Receptacle; USB_C_Receptacle_XKB_U262-16XN-4BVC11; MOUSER 523-GSB1C411111DS1HR
J3: Conn_02x20_Odd_Even; IDC-Header_2x20_P2.54mm_Horizontal
JP1: VREF_Selector; PinHeader_1x03_P2.54mm_Vertical
JP2: Jumper_2_Bridged; SolderJumper-2_P1.3mm_Open_Pad1.0x1.5mm; not fitted
R1, R2: 10k; R_0603_1608Metric
R3, R4: 5.1k; R_0603_1608Metric
SW1: SW_Push; SW_Push_1P1T_NO_CK_KMR2
TP1: TestPoint_Pad_D3.0mm; not fitted

Connections:
+3V3: J1.84, J1.86, J3.23, J3.39, JP1.3 (B), JP2.2 (B); also elsewhere on the board
+5V: D3.1 (K), J1.77, J1.79, J1.81, J1.83, J1.85, J1.87, J3.38, J3.40, JP1.1 (A); also elsewhere on the board
/50Hz Filter/ANALOG_BREAKOUT_OUT: J4.100; also elsewhere on the board
/CAN/CAN_EN: J4.16; also elsewhere on the board
/CAN/CAN_RX: J4.17; also elsewhere on the board
/CAN/CAN_SILENT: J4.18; also elsewhere on the board
/CAN/CAN_TX: J4.15; also elsewhere on the board
/I2C/I2C_SCL_3V3: J4.23; also elsewhere on the board
/I2C/I2C_SDA_3V3: J4.21; also elsewhere on the board
/I2C/INTERRRUPT_ACCELEROMETER: J4.27; also elsewhere on the board
/I2C/INTERRRUPT_KEYPAD: J4.29; also elsewhere on the board
/MCU/ANALOG_BREAKOUT_PT100: J4.94; also elsewhere on the board
/MCU/ANALOG_HEATER_TEMPERATURE: J4.88; also elsewhere on the board
/MCU/ANALOG_JOYSTICK_X: J4.87; also elsewhere on the board
/MCU/ANALOG_JOYSTICK_Y: J4.93; also elsewhere on the board
/MCU/ANALOG_MICROPHONE: J4.99; also elsewhere on the board
/MCU/ANALOG_PHOTOTRANSISTOR: J4.81; also elsewhere on the board
/MCU/ANALOG_POTENTIOMETER: J4.82; also elsewhere on the board
/MCU/DIGITAL_BUTTON_IN_0: J4.47; also elsewhere on the board
/MCU/DIGITAL_BUTTON_IN_1: J4.49; also elsewhere on the board
/MCU/DIGITAL_BUTTON_IN_2: J4.51; also elsewhere on the board
/MCU/DIGITAL_BUTTON_IN_3: J4.53; also elsewhere on the board
/MCU/DIGITAL_BUZZER_OUT: J4.60; also elsewhere on the board
/MCU/DIGITAL_HEATER_OUT: J4.54; also elsewhere on the board
/MCU/DIGITAL_IR_EMITTER: J4.33; also elsewhere on the board
/MCU/DIGITAL_IR_RECEIVER: J4.35; also elsewhere on the board
/MCU/DIGITAL_LED_OUT_0: J4.57; also elsewhere on the board
/MCU/DIGITAL_LED_OUT_1: J4.59; also elsewhere on the board
/MCU/DIGITAL_LED_OUT_2: J4.58; also elsewhere on the board
/MCU/DIGITAL_NEOPIXEL_OUT: J4.39; also elsewhere on the board
/MCU/DIGITAL_RGB_B: J4.45; also elsewhere on the board
/MCU/DIGITAL_RGB_G: J4.43; also elsewhere on the board
/MCU/DIGITAL_RGB_R: J4.41; also elsewhere on the board
/MCU/MCU_GPIO_2: J1.58, J3.37
/MCU/MCU_GPIO_3: J1.56, J3.35
/MCU/MCU_GPIO_4: J1.54, J3.33
/MCU/MCU_GPIO_5: J1.34, J3.11
/MCU/MCU_GPIO_6: J1.30, J3.9
/MCU/MCU_GPIO_7: J1.37, J3.16
/MCU/MCU_GPIO_8: J1.39, J3.18
/MCU/MCU_GPIO_9: J1.40, J3.17
/MCU/MCU_GPIO_10: J1.44, J3.21
/MCU/MCU_GPIO_11: J1.38, J3.19
/MCU/MCU_GPIO_12: J1.31, J3.10
/MCU/MCU_GPIO_13: J1.28, J3.7
/MCU/MCU_GPIO_14: J1.55, J3.34
/MCU/MCU_GPIO_15: J1.51, J3.32
/MCU/MCU_GPIO_16: J1.29, J3.6
/MCU/MCU_GPIO_17: J1.50, J3.29
/MCU/MCU_GPIO_18: J1.49, J3.30
/MCU/MCU_GPIO_19: J1.26, J3.5
/MCU/MCU_GPIO_20: J1.27, J3.4
/MCU/MCU_GPIO_21: J1.25, J3.2
/MCU/MCU_GPIO_22: J1.46, J3.25
/MCU/MCU_GPIO_23: J1.47, J3.26
/MCU/MCU_GPIO_24: J1.45, J3.24
/MCU/MCU_GPIO_25: J1.41, J3.20
/MCU/MCU_GPIO_26: J1.24, J3.3
/MCU/MCU_GPIO_27: J1.48, J3.27
/MCU/MCU_RESET: C1.1, D2.1 (K), J1.100, R2.2
/MCU/MOTOR_CC_IN_1: J4.65; also elsewhere on the board
/MCU/MOTOR_CC_IN_2: J4.66; also elsewhere on the board
/MCU/MOTOR_PWM_OUT_1: J4.63; also elsewhere on the board
/MCU/MOTOR_PWM_OUT_2: J4.64; also elsewhere on the board
/MCU/SD_Enable: J1.75; also elsewhere on the board
/MCU/SERIAL_OUT_RX1: J4.9; also elsewhere on the board
/MCU/SERIAL_OUT_RX2: J4.12; also elsewhere on the board
/MCU/SERIAL_OUT_TX1: J4.11; also elsewhere on the board
/MCU/SERIAL_OUT_TX2: J4.10; also elsewhere on the board
/MCU/SPI_CS_BREAKOUT: J4.30; also elsewhere on the board
/MCU/SPI_CS_NFC: J4.46; also elsewhere on the board
/MCU/SPI_CS_SEVENSEG: J4.34; also elsewhere on the board
/MCU/SPI_CS_TFT: J4.36; also elsewhere on the board
/MCU/SPI_IRQ_NFC: J4.48; also elsewhere on the board
/MCU/SPI_MISO: J4.24; also elsewhere on the board
/MCU/SPI_MOSI: J4.22; also elsewhere on the board
/MCU/SPI_RST_NFC: J4.52; also elsewhere on the board
/MCU/SPI_SCK: J4.28; also elsewhere on the board
/MCU/SPI_TFT_DC: J4.40; also elsewhere on the board
/MCU/SPI_TFT_RESET: J4.42; also elsewhere on the board
/MCU/USB_DP+: D4.2 (A2), J2.A6 (D+), J2.B6 (D+), J4.5
/MCU/USB_DP-: D5.2 (A2), J2.A7 (D-), J2.B7 (D-), J4.3
/MCU/USB_HOST_ENABLE: J4.2; also elsewhere on the board
/MCU/USB_HOST_FAULT: J4.1; also elsewhere on the board
/MCU/USB_HOST_OUT_P+: J4.6; also elsewhere on the board
/MCU/USB_HOST_OUT_P-: J4.4; also elsewhere on the board
/SD/SD_CLK: J1.57; also elsewhere on the board
/SD/SD_CMD: J1.62; also elsewhere on the board
/SD/SD_DAT0: J1.63; also elsewhere on the board
/SD/SD_DAT1: J1.67; also elsewhere on the board
/SD/SD_DAT2: J1.69; also elsewhere on the board
/SD/SD_DAT3: J1.61; also elsewhere on the board
/SD/SD_DET: J1.76; also elsewhere on the board
GND: C1.2, D1.1 (A1), D4.1 (A1), D5.1 (A1), J1.1, J1.2, J1.7, J1.8, J1.13, J1.14, J1.22, J1.23, J1.32, J1.33, J1.42, J1.43, J1.52, J1.53, J1.59, J1.60, J1.65, J1.66, J1.71, J1.74, J1.98, J2.A1 (GND), J2.A12 (GND), J2.B1 (GND), J2.B12 (GND), J2.S1 (SHIELD), J3.1, J3.8, J3.12, J3.15, J3.22, J3.28, J3.31, J3.36, J4.7, J4.8, J4.13, J4.14, J4.19, J4.20, J4.25, J4.26, J4.31, J4.32, J4.37, J4.38, J4.44, J4.50, J4.55, J4.56, J4.61, J4.62, J4.67, J4.68, J4.73, J4.74, J4.79, J4.80, J4.85, J4.86, J4.91, J4.92, J4.97, J4.98, R3.1, R4.1, SW1.1; also elsewhere on the board
unnamed: D1.2 (A2), D2.2 (A), R1.1, R2.1, SW1.2
unnamed: D3.2 (A), J2.A4 (VBUS), J2.A9 (VBUS), J2.B4 (VBUS), J2.B9 (VBUS)
unnamed: J2.A5 (CC1), R4.2
unnamed: J2.B5 (CC2), R3.2
unnamed: J1.88, J1.90, JP2.1 (A)
VCC: J1.78, JP1.2 (C), R1.2, TP1.1; also elsewhere on the board

Notes on the sheet:
Raspberry Pi compatible GPIO breakout
USB-C USB 2.0
RESET Button

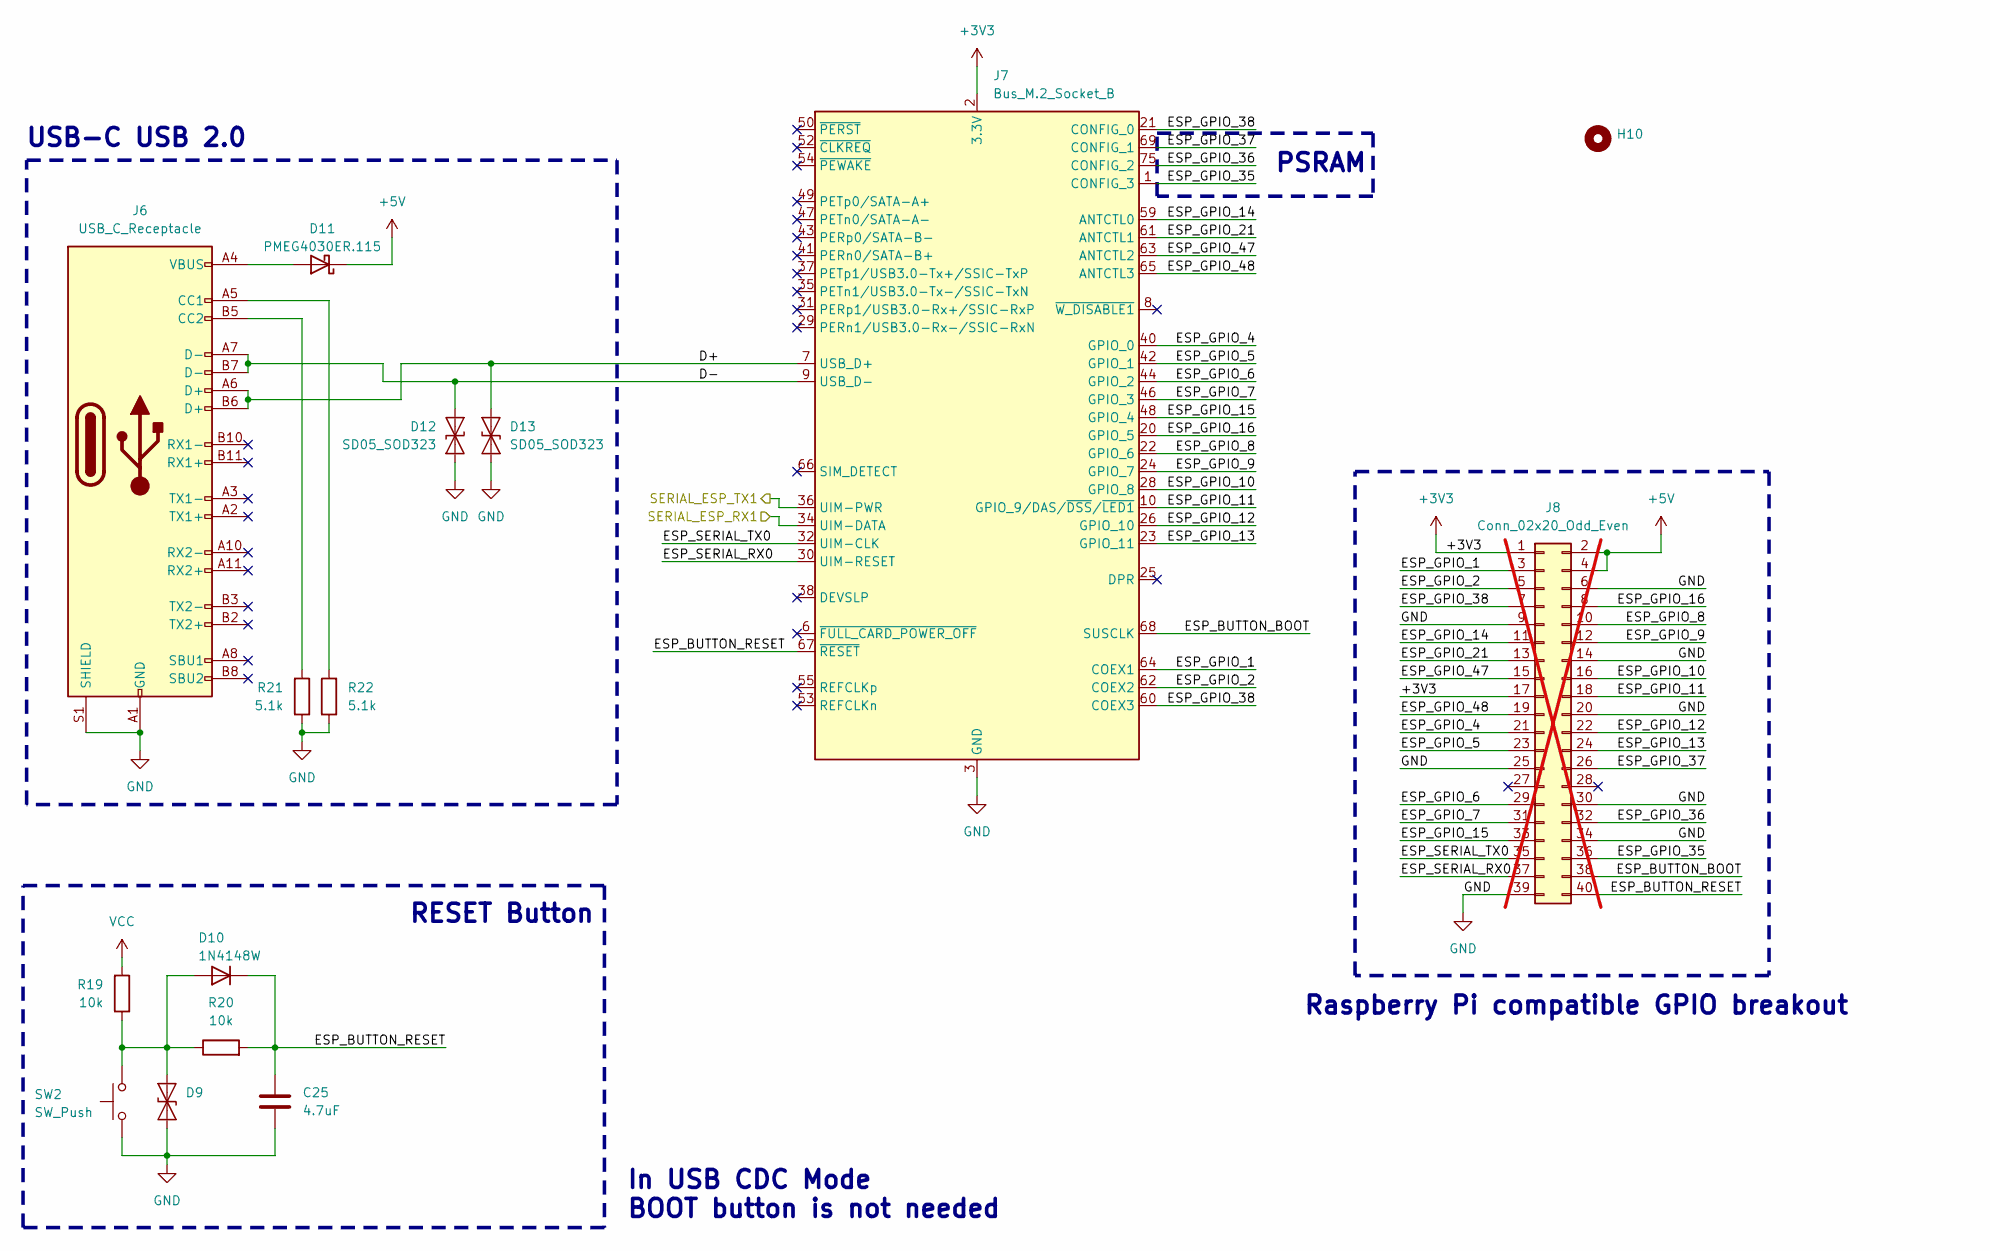
[picture p129: schematic esp32.kicad_sch]

Parts:
C25: 4.7uF; C_0805_2012Metric
D9, D12, D13: SD05_SOD323; D_SOD-323
D10: 1N4148W; D_SOD-323
D11: PMEG4030ER.115; Nexperia_CFP3_SOD-123W
H10: MountingHole; MountingHole_4.3mm_M4_ISO14580_Pad; MOUSER 710-9774040360R
J6: USB_C_Receptacle; USB_C_Receptacle_XKB_U262-16XN-4BVC11; MOUSER 523-GSB1C411111DS1HR
J7: Bus_M.2_Socket_B; 121992304
J8: Conn_02x20_Odd_Even; IDC-Header_2x20_P2.54mm_Horizontal; not fitted
R19, R20: 10k; R_0603_1608Metric
R21, R22: 5.1k; R_0603_1608Metric
SW2: SW_Push; SW_Push_1P1T_NO_CK_KMR2

Connections:
+3V3: J7.2 (3.3V), J7.4 (3.3V), J7.70 (3.3V), J7.72 (3.3V), J7.74 (3.3V), J8.1, J8.17; also elsewhere on the board
+5V: D11.1 (K), J8.2, J8.4; also elsewhere on the board
/MCU/SERIAL_OUT_RX1: J7.36 (UIM-PWR); also elsewhere on the board
/MCU/SERIAL_OUT_TX1: J7.34 (UIM-DATA); also elsewhere on the board
/esp32/D+: D13.2 (A2), J6.A6 (D+), J6.B6 (D+), J7.7 (USB_D+)
/esp32/D-: D12.2 (A2), J6.A7 (D-), J6.B7 (D-), J7.9 (USB_D-)
/esp32/ESP_BUTTON_BOOT: J7.68 (SUSCLK), J8.38
/esp32/ESP_BUTTON_RESET: C25.1, D10.1 (K), J7.67 (~RESET), J8.40, R20.2
/esp32/ESP_GPIO_4: J7.40 (GPIO_0), J8.21
/esp32/ESP_GPIO_5: J7.42 (GPIO_1), J8.23
/esp32/ESP_GPIO_6: J7.44 (GPIO_2), J8.29
/esp32/ESP_GPIO_7: J7.46 (GPIO_3), J8.31
/esp32/ESP_GPIO_8: J7.22 (GPIO_6), J8.10
/esp32/ESP_GPIO_9: J7.24 (GPIO_7), J8.12
/esp32/ESP_GPIO_10: J7.28 (GPIO_8), J8.16
/esp32/ESP_GPIO_11: J7.10 (GPIO_9/DAS/~DSS/~LED1), J8.18
/esp32/ESP_GPIO_12: J7.26 (GPIO_10), J8.22
/esp32/ESP_GPIO_13: J7.23 (GPIO_11), J8.24
/esp32/ESP_GPIO_15: J7.48 (GPIO_4), J8.33
/esp32/ESP_GPIO_16: J7.20 (GPIO_5), J8.8
/esp32/ESP_GPIO_35: J7.1 (CONFIG_3), J8.36
/esp32/ESP_GPIO_36: J7.75 (CONFIG_2), J8.32
/esp32/ESP_GPIO_37: J7.69 (CONFIG_1), J8.26
/esp32/ESP_GPIO_38: J7.21 (CONFIG_0), J7.60 (COEX3), J8.7
/esp32/ESP_SERIAL_RX0: J7.30 (UIM-RESET), J8.37
/esp32/ESP_SERIAL_TX0: J7.32 (UIM-CLK), J8.35
GND: C25.2, D9.1 (A1), D12.1 (A1), D13.1 (A1), J6.A1 (GND), J6.A12 (GND), J6.B1 (GND), J6.B12 (GND), J6.S1 (SHIELD), J7.3 (GND), J7.5 (GND), J7.11 (GND), J7.27 (GND), J7.33 (GND), J7.39 (GND), J7.45 (GND), J7.51 (GND), J7.57 (GND), J7.71 (GND), J7.73 (GND), J8.6, J8.9, J8.14, J8.20, J8.25, J8.30, J8.34, J8.39, R21.1, R22.1, SW2.1; also elsewhere on the board
unnamed: D9.2 (A2), D10.2 (A), R19.1, R20.1, SW2.2
unnamed: D11.2 (A), J6.A4 (VBUS), J6.A9 (VBUS), J6.B4 (VBUS), J6.B9 (VBUS)
unnamed: J6.A5 (CC1), R22.2
unnamed: J6.B5 (CC2), R21.2
unnamed: J7.64 (COEX1), J8.3
unnamed: J7.62 (COEX2), J8.5
unnamed: J7.59 (ANTCTL0), J8.11
unnamed: J7.61 (ANTCTL1), J8.13
unnamed: J7.63 (ANTCTL2), J8.15
unnamed: J7.65 (ANTCTL3), J8.19
VCC: R19.2; also elsewhere on the board

Notes on the sheet:
In USB CDC Mode BOOT button is not needed
USB-C USB 2.0
RESET Button
Raspberry Pi compatible GPIO breakout
PSRAM

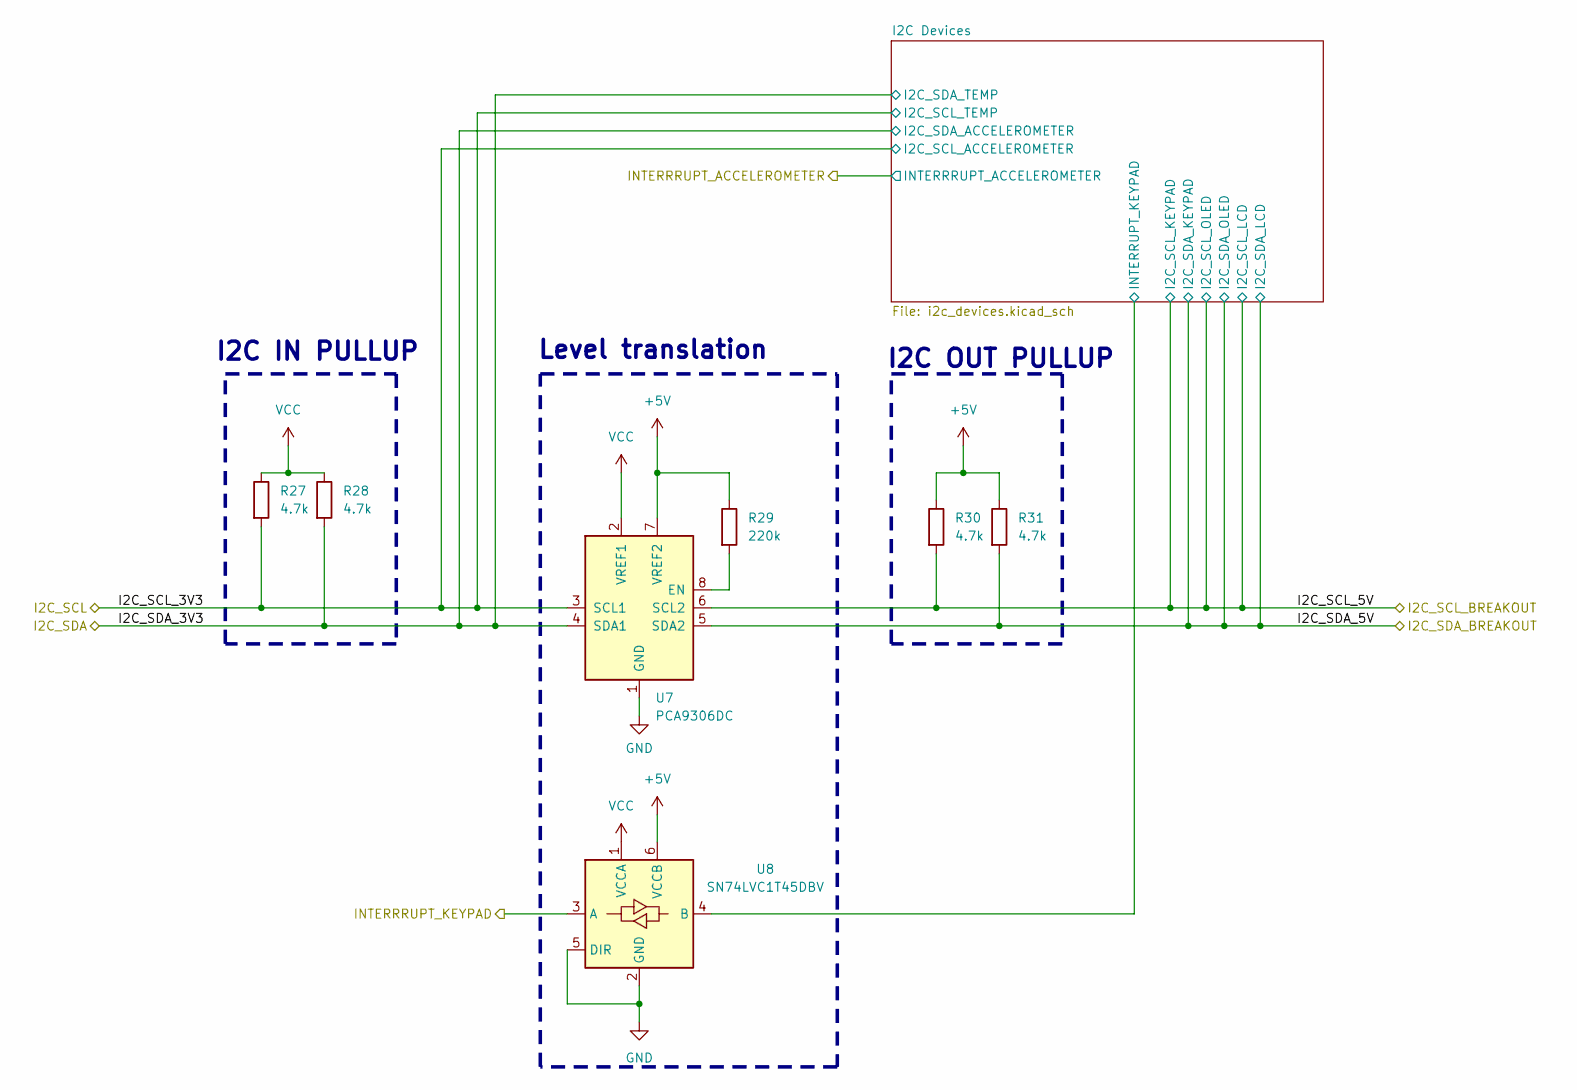
[picture p130: schematic i2c.kicad_sch]

Parts:
R27, R28, R30, R31: 4.7k; R_0603_1608Metric
R29: 220k; R_0603_1608Metric
U7: PCA9306DC; VSSOP-8_2.3x2mm_P0.5mm
U8: SN74LVC1T45DBV; SOT-23-6

Connections:
+5V: R29.1, R30.1, R31.1, U7.7 (VREF2), U8.6 (VCCB); also elsewhere on the board
/I2C/I2C Devices/INTERRUPT_KEYPAD: U8.4 (B); also elsewhere on the board
/I2C/I2C_SCL_3V3: R27.2, U7.3 (SCL1); also elsewhere on the board
/I2C/I2C_SCL_5V: R30.2, U7.6 (SCL2); also elsewhere on the board
/I2C/I2C_SDA_3V3: R28.2, U7.4 (SDA1); also elsewhere on the board
/I2C/I2C_SDA_5V: R31.2, U7.5 (SDA2); also elsewhere on the board
/I2C/INTERRRUPT_KEYPAD: U8.3 (A); also elsewhere on the board
GND: U7.1 (GND), U8.2 (GND), U8.5 (DIR); also elsewhere on the board
unnamed: R29.2, U7.8 (EN)
VCC: R27.1, R28.1, U7.2 (VREF1), U8.1 (VCCA); also elsewhere on the board

Notes on the sheet:
I2C IN PULLUP
Level translation
I2C OUT PULLUP

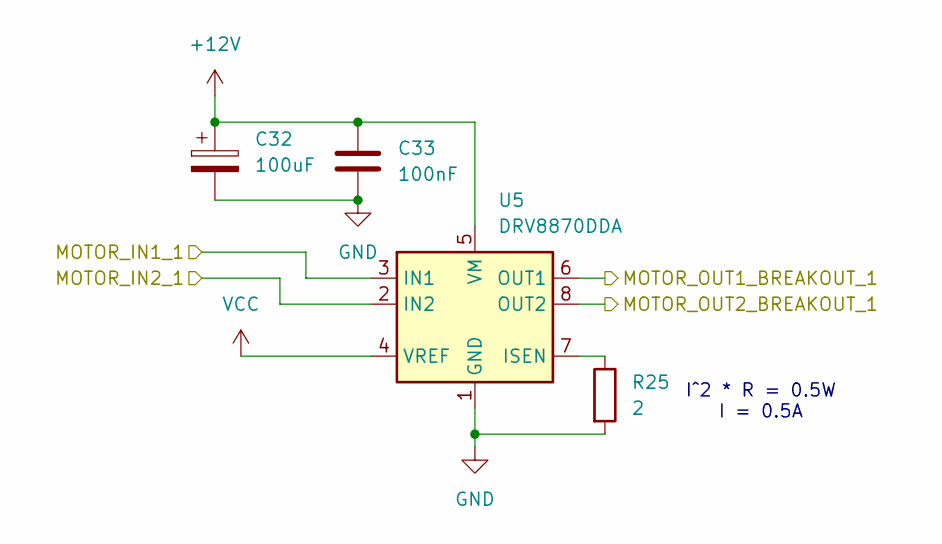
[picture p131: schematic motor.kicad_sch]

Parts:
C32: 100uF; CP_Elec_6.3x7.7
C33: 100nF; C_0603_1608Metric
R25: 2; R_2512_6332Metric
U5: DRV8870DDA; Texas_HTSOP-8-1EP_3.9x4.9mm_P1.27mm_EP2.95x4.9mm_Mask2.4x3.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

Connections:
+12V: C32.1, C33.1, U5.5 (VM); also elsewhere on the board
/MCU/MOTOR_PWM_OUT_1: U5.3 (IN1); also elsewhere on the board
/MCU/MOTOR_PWM_OUT_2: U5.2 (IN2); also elsewhere on the board
/MOTOR/MOTOR_OUT1_BREAKOUT_1: U5.6 (OUT1); also elsewhere on the board
/MOTOR/MOTOR_OUT2_BREAKOUT_1: U5.8 (OUT2); also elsewhere on the board
GND: C32.2, C33.2, R25.2, U5.1 (GND), U5.9 (GND); also elsewhere on the board
unnamed: R25.1, U5.7 (ISEN)
VCC: U5.4 (VREF); also elsewhere on the board

Notes on the sheet:
I^2 * R = 0.5W I = 0.5A

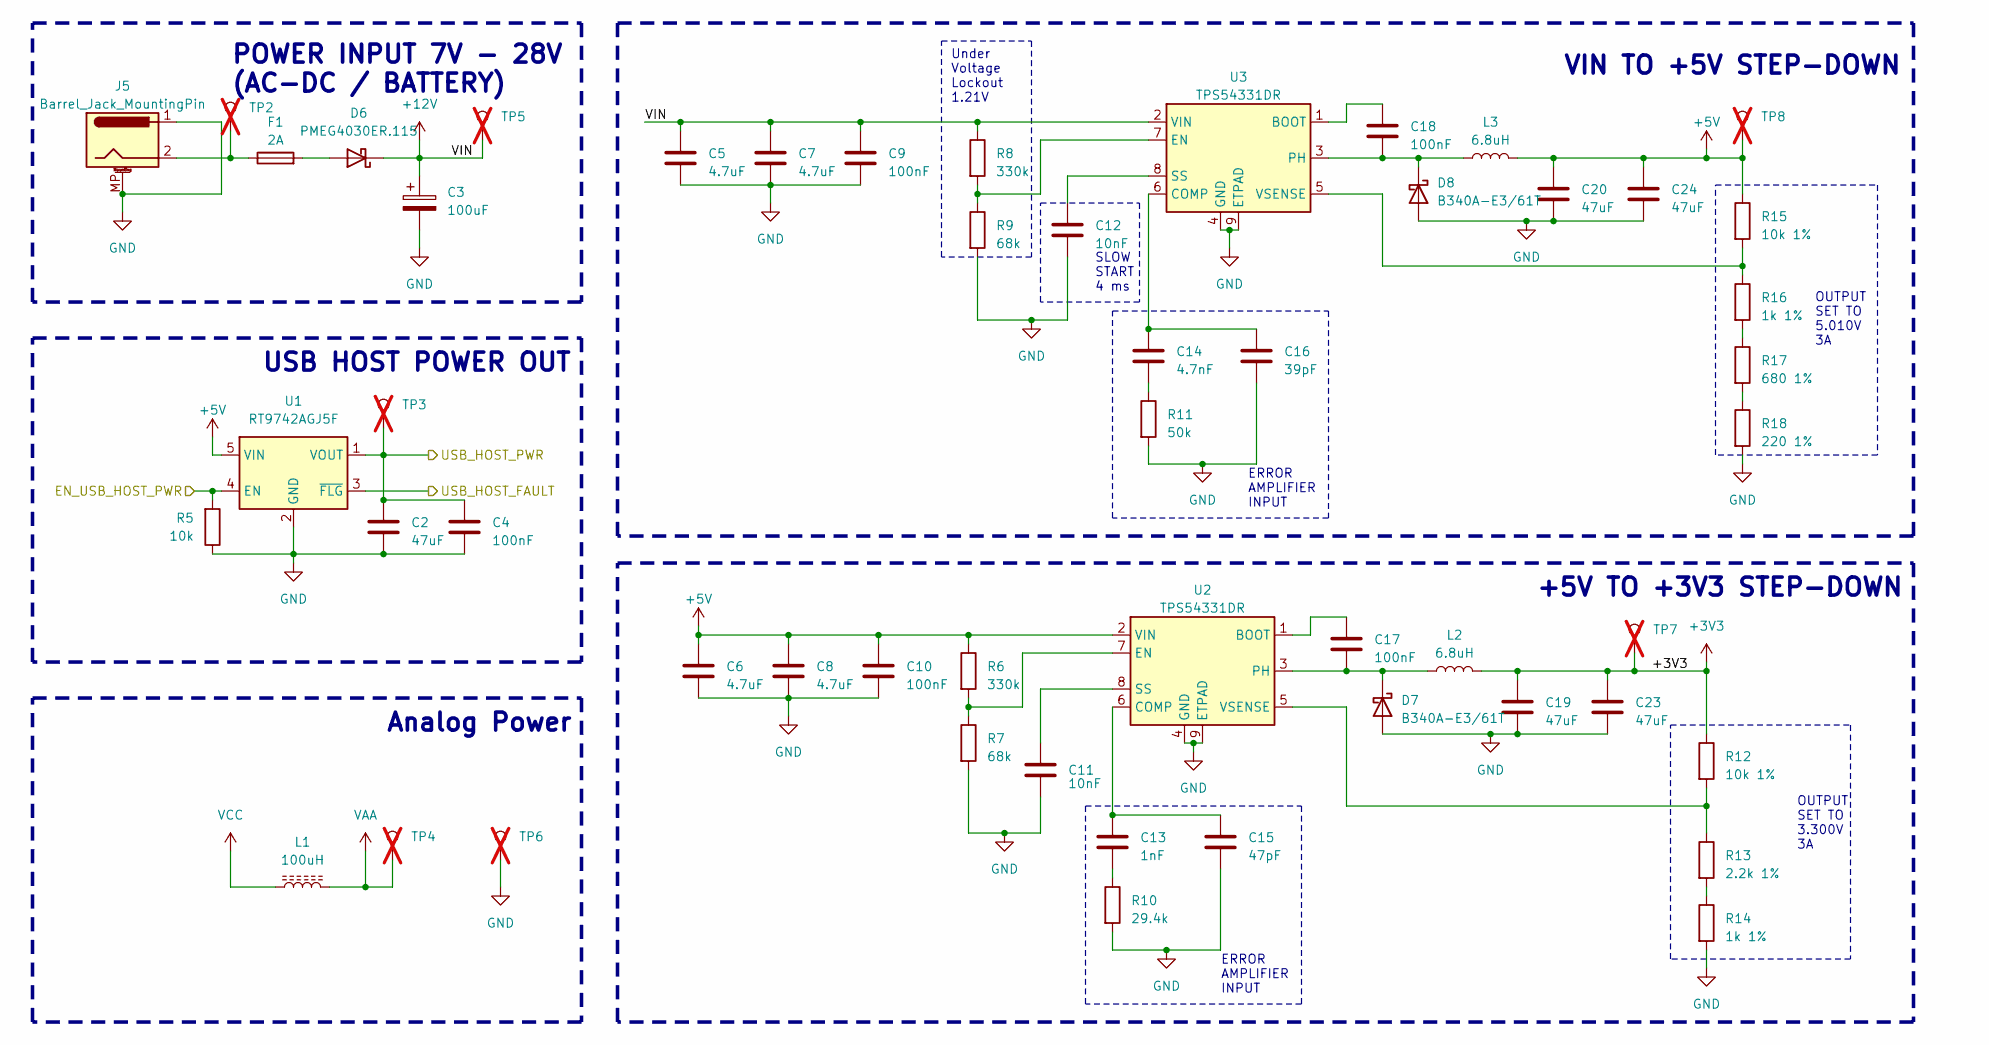
[picture p132: schematic power.kicad_sch, Power Supply]

Parts:
C2, C19, C20, C23, C24: 47uF; C_1210_3225Metric
C3: 100uF; CP_Elec_6.3x7.7
C4, C9, C10, C17, C18: 100nF; C_0603_1608Metric
C5, C6, C7, C8: 4.7uF; C_0805_2012Metric
C11, C12: 10nF; C_0603_1608Metric
C13: 1nF; C_0603_1608Metric
C14: 4.7nF; C_0603_1608Metric
C15: 47pF; C_0603_1608Metric
C16: 39pF; C_0603_1608Metric
D6: PMEG4030ER.115; Nexperia_CFP3_SOD-123W
D7, D8: B340A-E3/61T; D_SMA
F1: 2A; Fuse_1812_4532Metric
J5: Barrel_Jack_MountingPin; BarrelJack_Horizontal
L1: 100uH; L_1210_3225Metric
L2, L3: 6.8uH; L_Chilisin_BMRB00060624
R5: 10k; R_0603_1608Metric
R6, R8: 330k; R_0603_1608Metric
R7, R9: 68k; R_0603_1608Metric
R10: 29.4k; R_0603_1608Metric
R11: 50k; R_0603_1608Metric
R12, R15: 10k 1%; R_0603_1608Metric
R13: 2.2k 1%; R_0603_1608Metric
R14, R16: 1k 1%; R_0603_1608Metric
R17: 680 1%; R_0603_1608Metric
R18: 220 1%; R_0603_1608Metric
TP2, TP3, TP4, TP5, TP6, TP7, TP8: TestPoint_Pad_D3.0mm; not fitted
U1: RT9742AGJ5F; TSOT-23-5; MOUSER 835-RT9742AGJ5F
U2, U3: TPS54331DR; TI_SO-PowerPAD-8_ThermalVias

Connections:
+3V3: C19.1, C23.1, L2.2, R12.1, TP7.1; also elsewhere on the board
+5V: C6.1, C8.1, C10.1, C20.1, C24.1, L3.2, R6.1, R15.1, TP8.1, U1.5 (VIN), U2.2 (VIN); also elsewhere on the board
+12V: C3.1, C5.1, C7.1, C9.1, D6.1 (K), R8.1, TP5.1, U3.2 (VIN); also elsewhere on the board
/MCU/USB_HOST_ENABLE: R5.2, U1.4 (EN); also elsewhere on the board
/MCU/USB_HOST_FAULT: U1.3 (~FLG); also elsewhere on the board
/OUTPUTS/BREAKOUT_USB_VBUS: C2.1, C4.1, TP3.1, U1.1 (VOUT); also elsewhere on the board
GND: C2.2, C3.2, C4.2, C5.2, C6.2, C7.2, C8.2, C9.2, C10.2, C11.2, C12.2, C15.2, C16.2, C19.2, C20.2, C23.2, C24.2, D7.2 (A), D8.2 (A), J5.1, J5.MP (MountPin), R5.1, R7.2, R9.2, R10.2, R11.2, R14.2, R18.2, TP6.1, U1.2 (GND), U2.4 (GND), U2.9 (ETPAD), U3.4 (GND), U3.9 (ETPAD); also elsewhere on the board
unnamed: C13.2, R10.1
unnamed: C14.2, R11.1
unnamed: D6.2 (A), F1.2
unnamed: C17.2, D7.1 (K), L2.1, U2.3 (PH)
unnamed: C18.2, D8.1 (K), L3.1, U3.3 (PH)
unnamed: F1.1, J5.2, TP2.1
unnamed: R13.2, R14.1
unnamed: R16.2, R17.1
unnamed: R17.2, R18.1
unnamed: C17.1, U2.1 (BOOT)
unnamed: C13.1, C15.1, U2.6 (COMP)
unnamed: R6.2, R7.1, U2.7 (EN)
unnamed: C11.1, U2.8 (SS)
unnamed: R12.2, R13.1, U2.5 (VSENSE)
unnamed: C18.1, U3.1 (BOOT)
unnamed: C14.1, C16.1, U3.6 (COMP)
unnamed: R8.2, R9.1, U3.7 (EN)
unnamed: C12.1, U3.8 (SS)
unnamed: R15.2, R16.1, U3.5 (VSENSE)
VAA: L1.2, TP4.1; also elsewhere on the board
VCC: L1.1; also elsewhere on the board

Notes on the sheet:
+5V TO +3V3 STEP-DOWN
Analog Power
VIN TO +5V STEP-DOWN
SLOW START 4 ms
Under Voltage Lockout 1.21V
USB HOST POWER OUT
POWER INPUT 7V - 28V (AC-DC / BATTERY)
OUTPUT SET TO 5.010V 3A
ERROR AMPLIFIER INPUT
OUTPUT SET TO 3.300V 3A

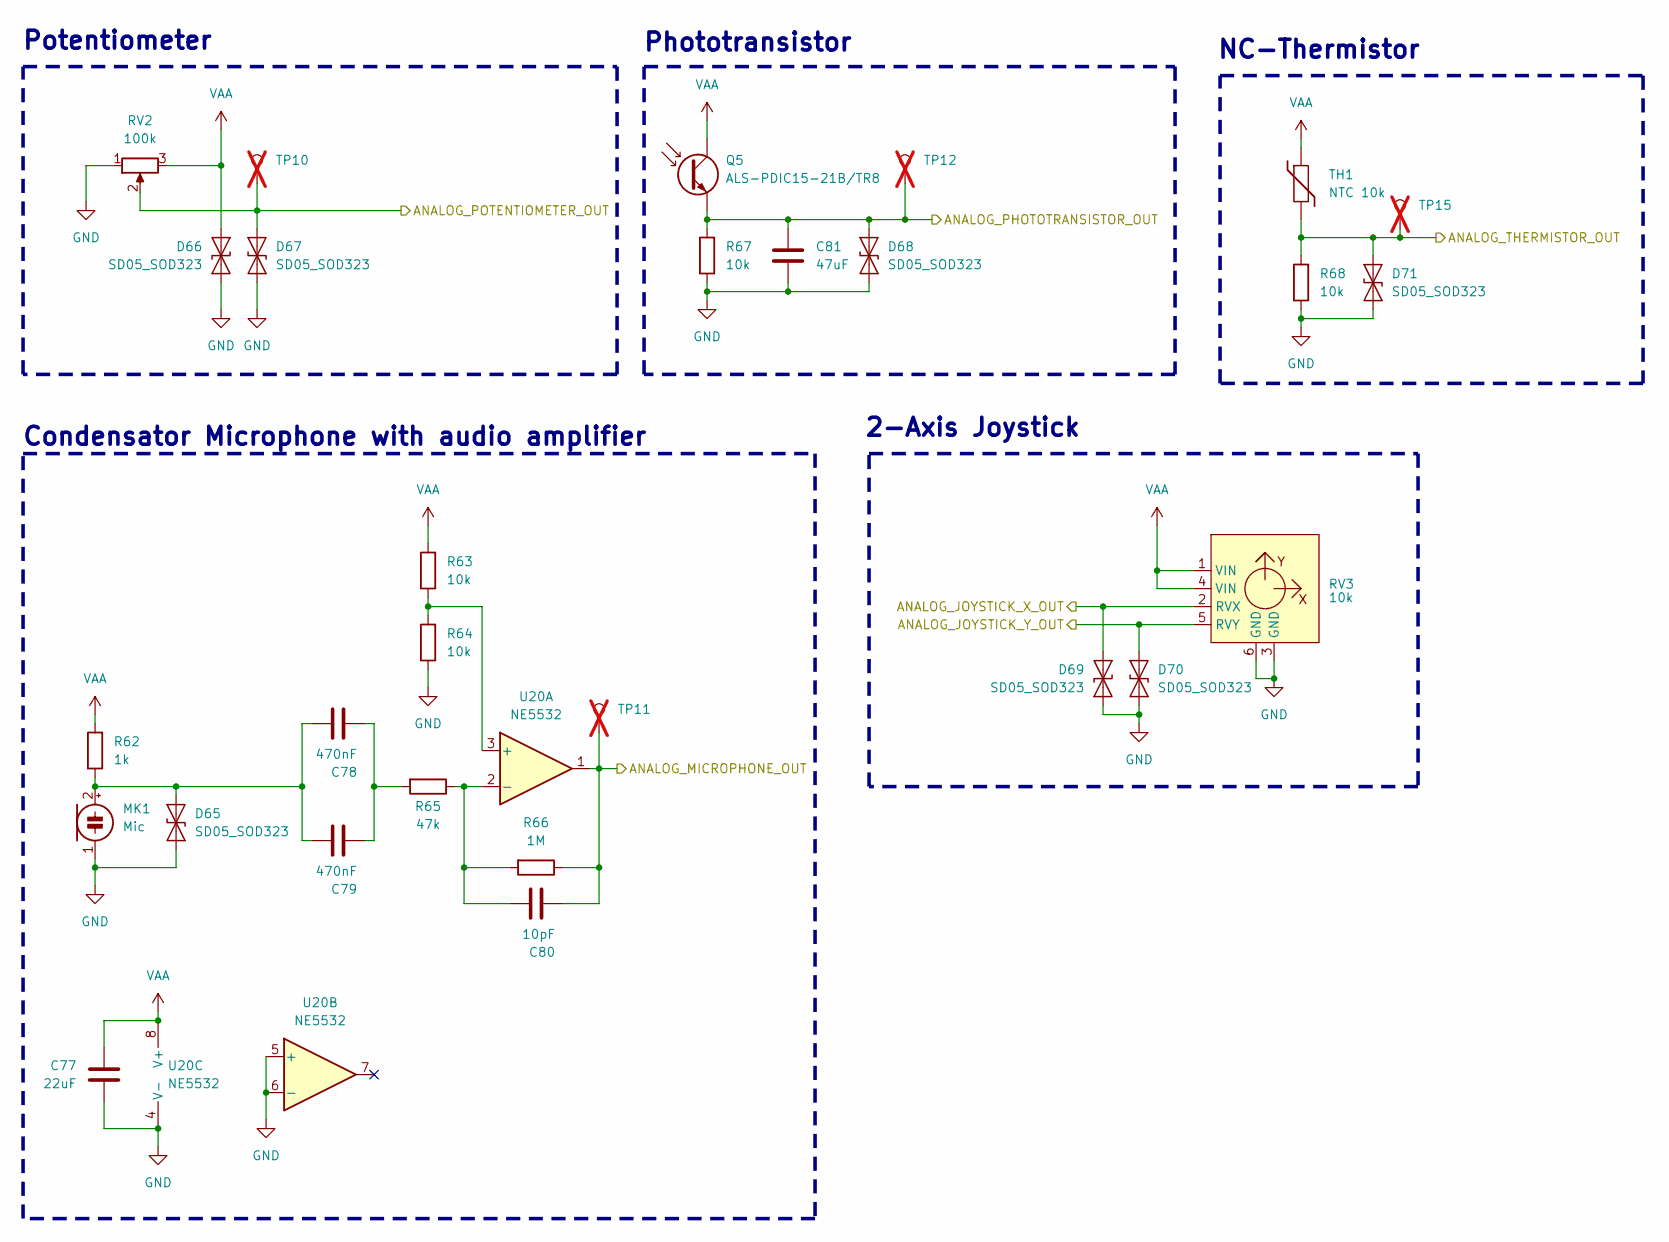
[picture p133: schematic analog.kicad_sch]

Parts:
C77: 22uF; C_0805_2012Metric
C78, C79: 470nF; C_0603_1608Metric
C80: 10pF; C_0603_1608Metric
C81: 47uF; C_1210_3225Metric
D65, D66, D67, D68, D69, D70, D71: SD05_SOD323; D_SOD-323
MK1: Mic; POM-2244P-C3310-2-R; MOUSER 497-MO093803-1
Q5: ALS-PDIC15-21B/TR8; Kingbright_KPS-3227
R62: 1k; R_0603_1608Metric
R63, R64, R67, R68: 10k; R_0603_1608Metric
R65: 47k; R_0603_1608Metric
R66: 1M; R_0805_2012Metric
RV2: 100k; Potentiometer_Alpha_RD901F-40-00D_Single_Vertical
RV3: 10k; 2-Axis-Joystick; MOUSER 485-2765
TH1: NTC 10k; R_0805_2012Metric
TP10, TP11, TP12, TP15: TestPoint_Pad_D3.0mm; not fitted
U20: NE5532; SOIC-8_3.9x4.9mm_P1.27mm

Connections:
/MCU/ANALOG_HEATER_TEMPERATURE: D71.2 (A2), R68.2, TH1.2, TP15.1; also elsewhere on the board
/MCU/ANALOG_JOYSTICK_X: D69.2 (A2), RV3.2 (RVX); also elsewhere on the board
/MCU/ANALOG_JOYSTICK_Y: D70.2 (A2), RV3.5 (RVY); also elsewhere on the board
/MCU/ANALOG_MICROPHONE: C80.2, R66.1, TP11.1, U20.1; also elsewhere on the board
/MCU/ANALOG_PHOTOTRANSISTOR: C81.1, D68.2 (A2), Q5.2, Q5.4, R67.2, TP12.1; also elsewhere on the board
/MCU/ANALOG_POTENTIOMETER: D67.2 (A2), RV2.2, TP10.1; also elsewhere on the board
GND: C77.2, C81.2, D65.1 (A1), D66.1 (A1), D67.1 (A1), D68.1 (A1), D69.1 (A1), D70.1 (A1), D71.1 (A1), MK1.1 (-), R64.1, R67.1, R68.1, RV2.1, RV3.3 (GND), RV3.6 (GND), U20.4 (V-), U20.5 (+), U20.6 (-); also elsewhere on the board
unnamed: C78.2, C79.2, R65.2
unnamed: C78.1, C79.1, D65.2 (A2), MK1.2 (+), R62.1
unnamed: R63.1, R64.2, U20.3 (+)
unnamed: C80.1, R65.1, R66.2, U20.2 (-)
VAA: C77.1, D66.2 (A2), Q5.1, Q5.3, R62.2, R63.2, RV2.3, RV3.1 (VIN), RV3.4 (VIN), TH1.1, U20.8 (V+); also elsewhere on the board

Notes on the sheet:
Potentiometer
Condensator Microphone with audio amplifier
NC-Thermistor
Phototransistor
2-Axis Joystick
