mark69163/prodigy/PRODIGY-MOTHERBOARD/PRODIGY-MOTHERBOARD.kicad_pcb

## KiCad design PRODIGY-MOTHERBOARD/PRODIGY-MOTHERBOARD.kicad_pcb (continued)

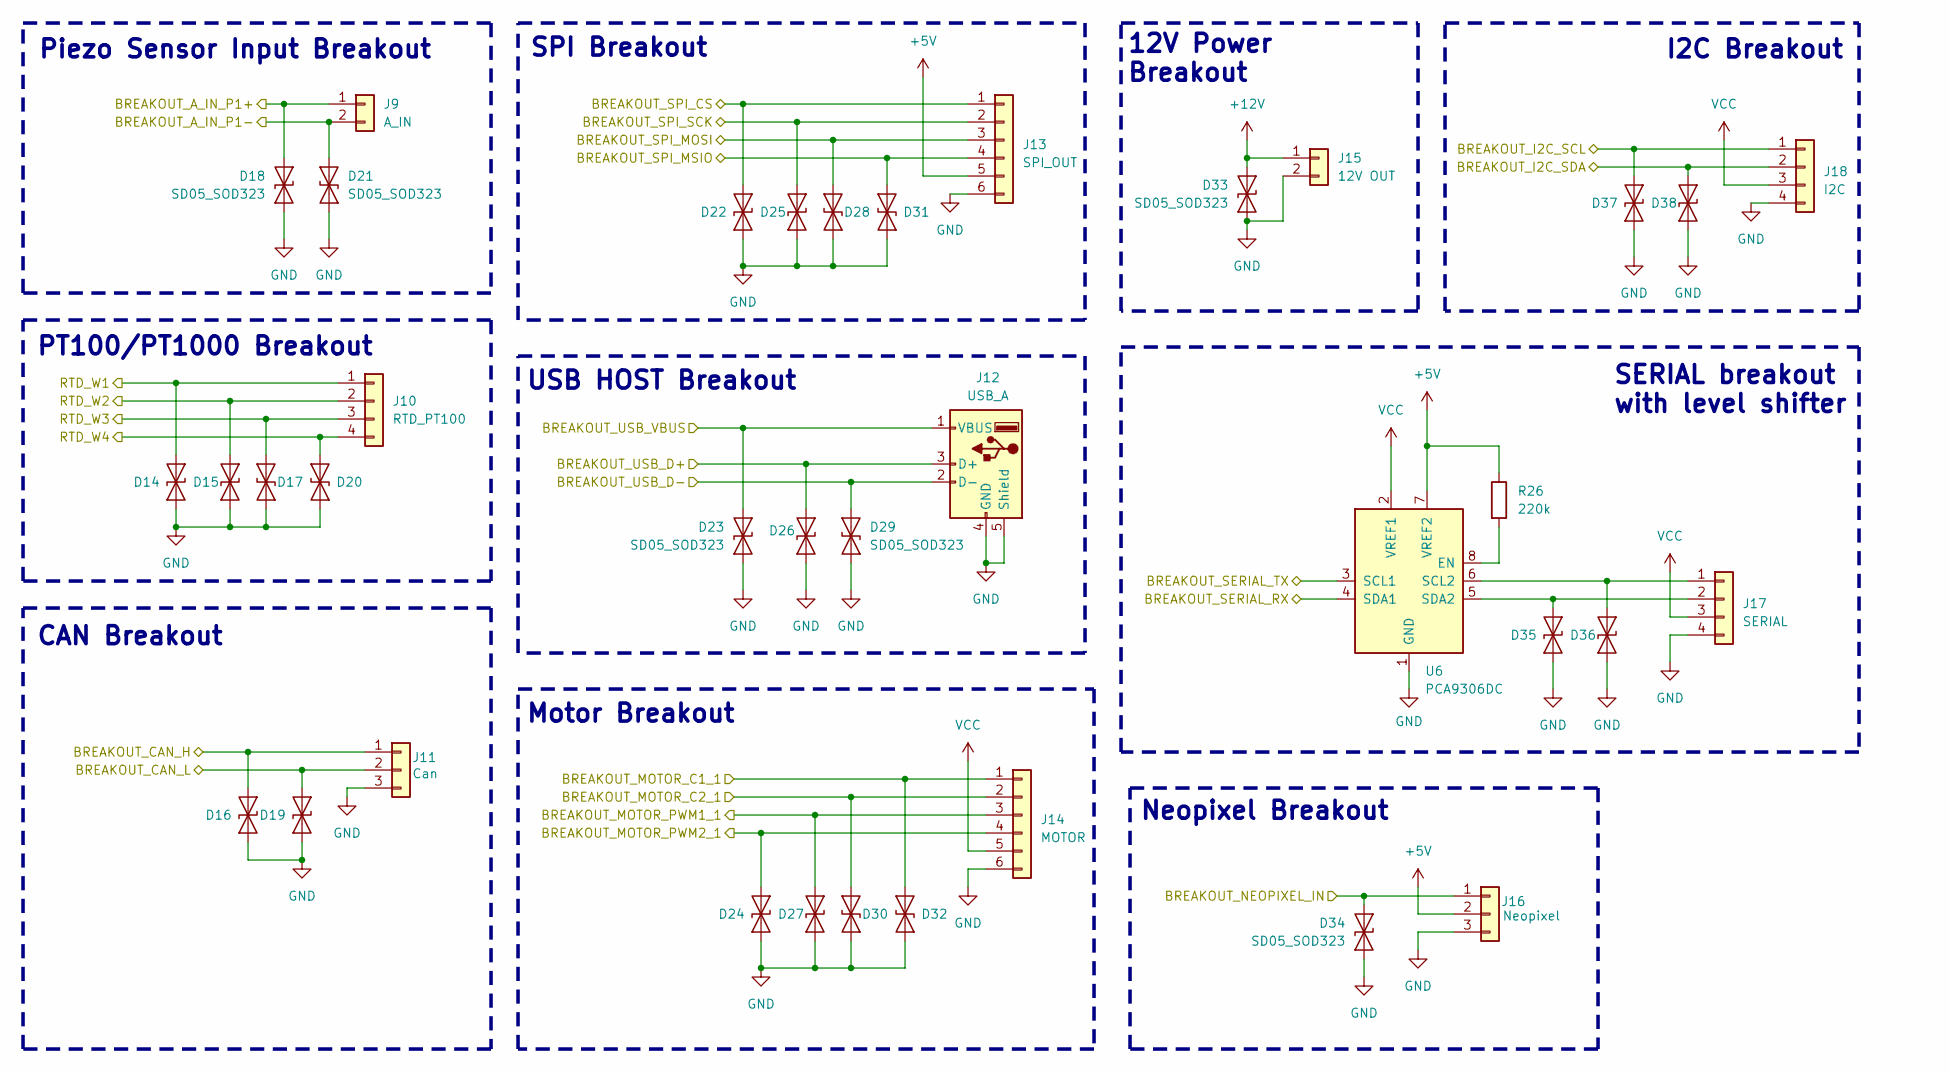
[picture p134: schematic outputs.kicad_sch]

Parts:
D14, D15, D16, D17, D18, D19, D20, D21, D22, D23, D24, D25, D26, D27, D28, D29, D30, D31, D32, D33, D34, D35, D36, D37, D38: SD05_SOD323; D_SOD-323
J9: A_IN; TerminalBlock_Phoenix_MKDS-1,5-2-5.08_1x02_P5.08mm_Horizont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
J10: RTD_PT100; TerminalBlock_Phoenix_MKDS-1,5-4-5.08_1x04_P5.08mm_Horizont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
J11: Can; TerminalBlock_Phoenix_MKDS-1,5-3-5.08_1x03_P5.08mm_Horizont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
J12: USB_A; USB_A_TE_292303-7_Horizontal; MOUSER 649-87583-0010RHLF
J13: SPI_OUT; TerminalBlock_Phoenix_MKDS-1,5-6-5.08_1x06_P5.08mm_Horizont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
J14: MOTOR; TerminalBlock_Phoenix_MKDS-1,5-6-5.08_1x06_P5.08mm_Horizont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
J15: 12V OUT; TerminalBlock_Phoenix_MKDS-1,5-2-5.08_1x02_P5.08mm_Horizont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
J16: Neopixel; TerminalBlock_Phoenix_MKDS-1,5-3-5.08_1x03_P5.08mm_Horizont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
J17: SERIAL; TerminalBlock_Phoenix_MKDS-1,5-4-5.08_1x04_P5.08mm_Horizont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
J18: I2C; TerminalBlock_Phoenix_MKDS-1,5-4-5.08_1x04_P5.08mm_Horizont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
R26: 220k; R_0603_1608Metric
U6: PCA9306DC; VSSOP-8_2.3x2mm_P0.5mm

Connections:
+5V: J13.5, J16.2, R26.1, U6.7 (VREF2); also elsewhere on the board
+12V: D33.2 (A2), J15.1; also elsewhere on the board
/50Hz Filter/IN_P1+: D18.2 (A2), J9.1; also elsewhere on the board
/50Hz Filter/IN_P1-: D21.2 (A2), J9.2; also elsewhere on the board
/CAN/CAN_H: D16.2 (A2), J11.1; also elsewhere on the board
/CAN/CAN_L: D19.2 (A2), J11.2; also elsewhere on the board
/I2C/I2C_SCL_5V: D37.2 (A2), J18.1; also elsewhere on the board
/I2C/I2C_SDA_5V: D38.2 (A2), J18.2; also elsewhere on the board
/MCU/MOTOR_CC_IN_1: D32.2 (A2), J14.1; also elsewhere on the board
/MCU/MOTOR_CC_IN_2: D30.2 (A2), J14.2; also elsewhere on the board
/MCU/SERIAL_OUT_RX2: U6.3 (SCL1); also elsewhere on the board
/MCU/SERIAL_OUT_TX2: U6.4 (SDA1); also elsewhere on the board
/MCU/USB_HOST_OUT_P+: D26.2 (A2), J12.3 (D+); also elsewhere on the board
/MCU/USB_HOST_OUT_P-: D29.2 (A2), J12.2 (D-); also elsewhere on the board
/MOTOR/MOTOR_OUT1_BREAKOUT_1: D27.2 (A2), J14.3; also elsewhere on the board
/MOTOR/MOTOR_OUT2_BREAKOUT_1: D24.2 (A2), J14.4; also elsewhere on the board
/OUTPUTS/BREAKOUT_NEOPIXEL_IN: D34.2 (A2), J16.1; also elsewhere on the board
/OUTPUTS/BREAKOUT_USB_VBUS: D23.2 (A2), J12.1 (VBUS); also elsewhere on the board
/OUTPUTS/RTD_W1: D14.2 (A2), J10.1; also elsewhere on the board
/OUTPUTS/RTD_W2: D15.2 (A2), J10.2; also elsewhere on the board
/OUTPUTS/RTD_W3: D17.2 (A2), J10.3; also elsewhere on the board
/OUTPUTS/RTD_W4: D20.2 (A2), J10.4; also elsewhere on the board
/SPI/CLK: D25.2 (A2), J13.2; also elsewhere on the board
/SPI/CS_BREAKOUT: D22.2 (A2), J13.1; also elsewhere on the board
/SPI/MISO: D31.2 (A2), J13.4; also elsewhere on the board
/SPI/MOSI: D28.2 (A2), J13.3; also elsewhere on the board
GND: D14.1 (A1), D15.1 (A1), D16.1 (A1), D17.1 (A1), D18.1 (A1), D19.1 (A1), D20.1 (A1), D21.1 (A1), D22.1 (A1), D23.1 (A1), D24.1 (A1), D25.1 (A1), D26.1 (A1), D27.1 (A1), D28.1 (A1), D29.1 (A1), D30.1 (A1), D31.1 (A1), D32.1 (A1), D33.1 (A1), D34.1 (A1), D35.1 (A1), D36.1 (A1), D37.1 (A1), D38.1 (A1), J11.3, J12.4 (GND), J12.5 (Shield), J13.6, J14.6, J15.2, J16.3, J17.4, J18.4, U6.1 (GND); also elsewhere on the board
unnamed: D35.2 (A2), J17.2, U6.5 (SDA2)
unnamed: D36.2 (A2), J17.1, U6.6 (SCL2)
unnamed: R26.2, U6.8 (EN)
VCC: J14.5, J17.3, J18.3, U6.2 (VREF1); also elsewhere on the board

Notes on the sheet:
I2C Breakout
12V Power Breakout
SPI Breakout
PT100/PT1000 Breakout
CAN Breakout
Piezo Sensor Input Breakout
Motor Breakout
Neopixel Breakout
USB HOST Breakout
SERIAL breakout with level shifter

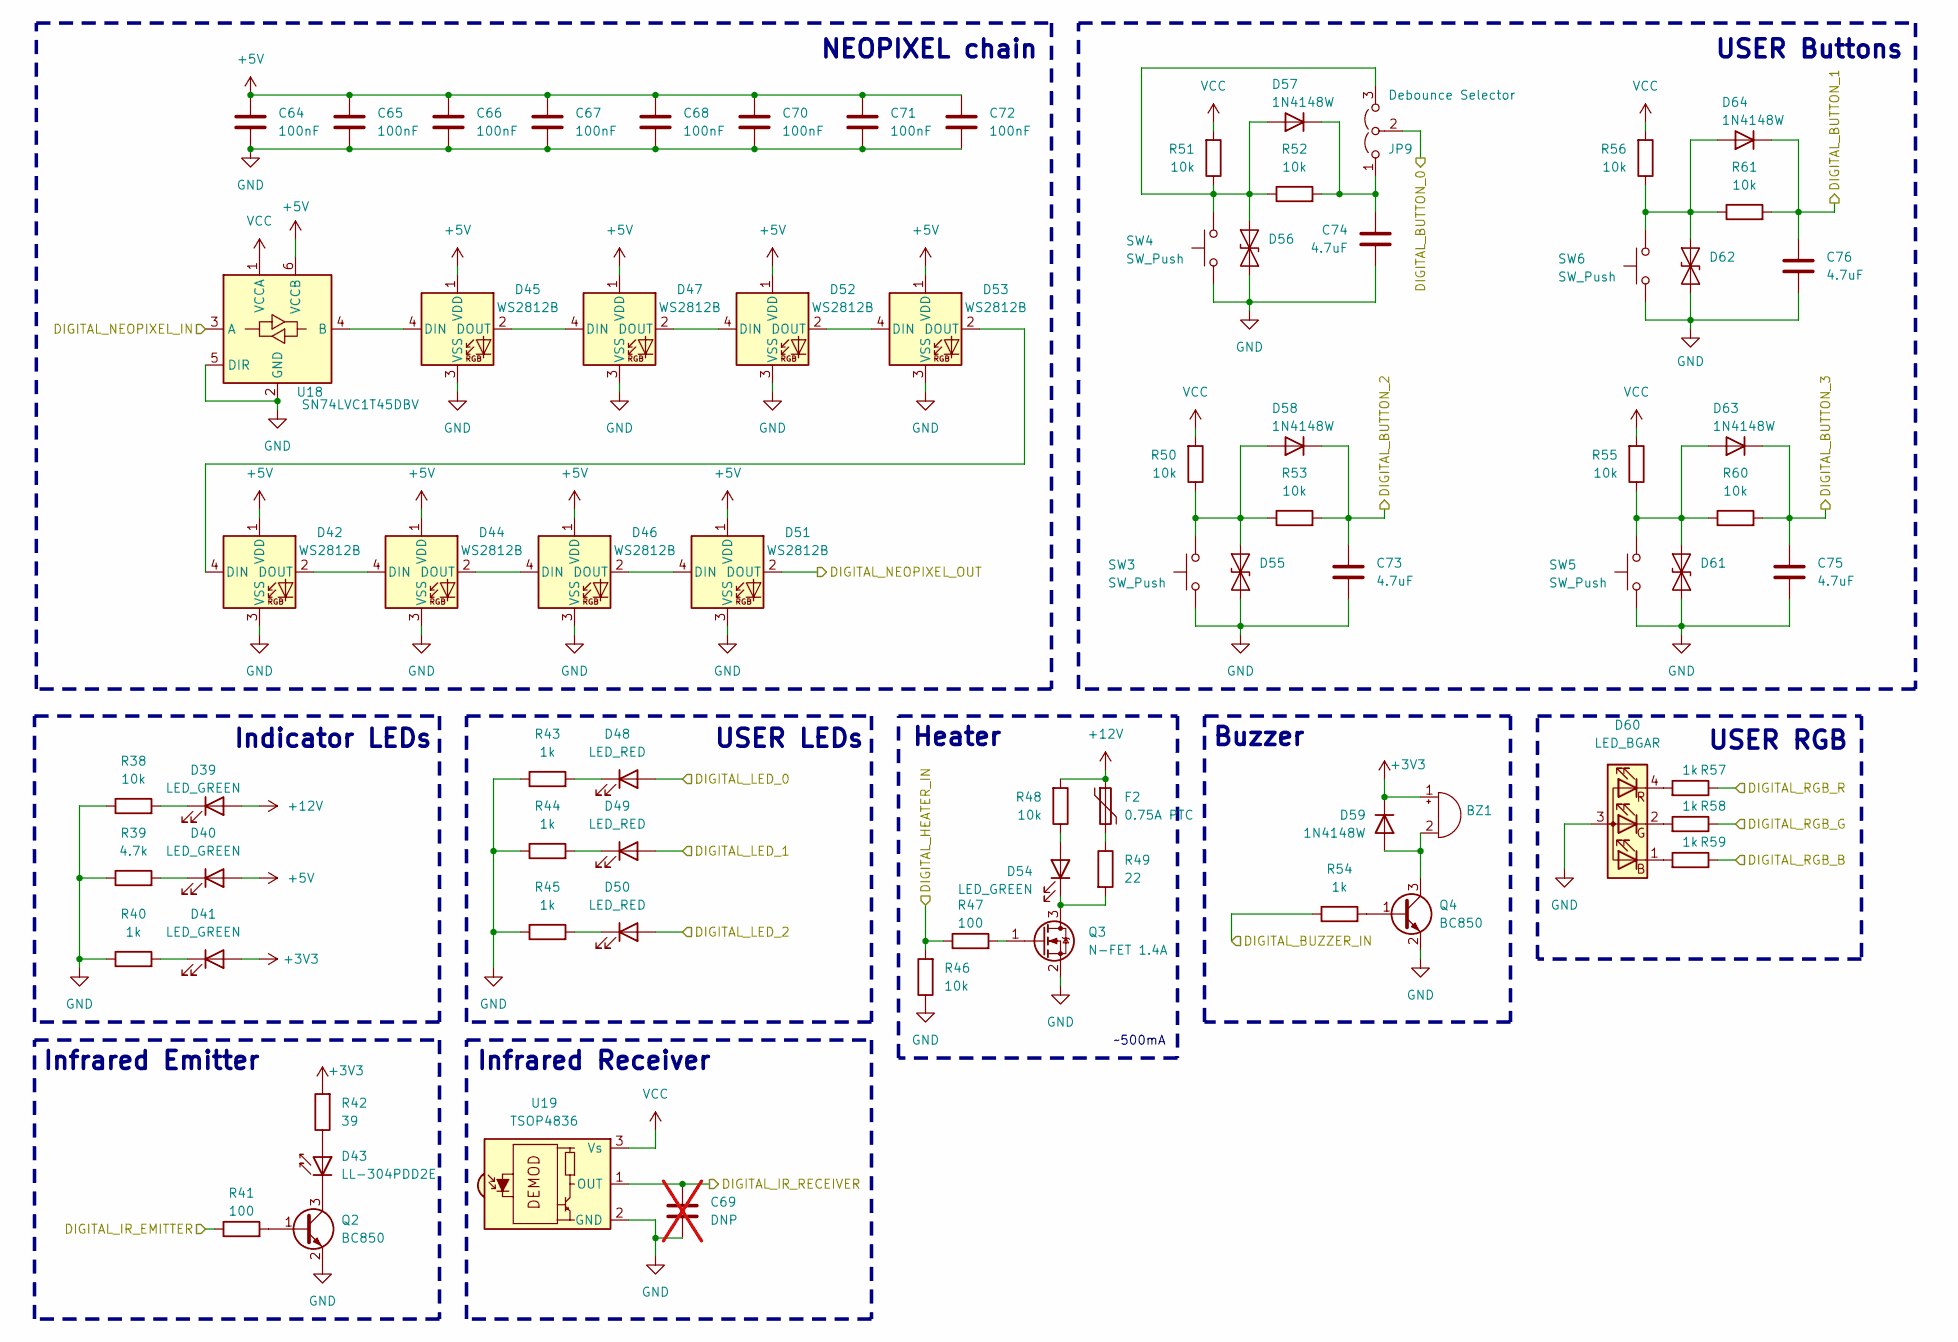
[picture p135: schematic digital.kicad_sch]

Parts:
BZ1: Buzzer; MagneticBuzzer_Kobitone_254-EMB84Q-RO; MOUSER 490-CMT-9504-87SMTTR
C64, C65, C66, C67, C68, C70, C71, C72: 100nF; C_0603_1608Metric
C69: DNP; R_0603_1608Metric; not fitted
C73, C74, C75, C76: 4.7uF; C_0805_2012Metric
D39, D40, D41, D54: LED_GREEN; LED_D3.0mm
D42, D44, D45, D46, D47, D51, D52, D53: WS2812B; LED_WS2812B_PLCC4_5.0x5.0mm_P3.2mm
D43: LL-304PDD2E; LED_D3.0mm_Horizontal_O1.27mm_Z2.0mm_IRBlack
D48, D49, D50: LED_RED; LED_D3.0mm
D55, D56, D61, D62: SD05_SOD323; D_SOD-323
D57, D58, D59, D63, D64: 1N4148W; D_SOD-323
D60: LED_BGAR; LED_D5.0mm-4_RGB
F2: 0.75A PTC; Fuse_1812_4532Metric
JP9: Debounce Selector; PinHeader_1x03_P2.54mm_Vertical
Q2, Q4: BC850; SOT-23
Q3: N-FET 1.4A; SOT-23
R38, R46, R48, R50, R51, R52, R53, R55, R56, R60, R61: 10k; R_0603_1608Metric
R39: 4.7k; R_0603_1608Metric
R40, R43, R44, R45, R54, R57, R58, R59: 1k; R_0603_1608Metric
R41, R47: 100; R_0603_1608Metric
R42: 39; R_0805_2012Metric
R49: 22; R_2512_6332Metric
SW3, SW4, SW5, SW6: SW_Push; SW_SPST_Omron_B3FS-105xP
U18: SN74LVC1T45DBV; SOT-23-6
U19: TSOP4836; Vishay_MOLD-3Pin

Connections:
+3V3: BZ1.1 (-), D41.2 (A), D59.1 (K), R42.2; also elsewhere on the board
+5V: C64.1, C65.1, C66.1, C67.1, C68.1, C70.1, C71.1, C72.1, D40.2 (A), D42.1 (VDD), D44.1 (VDD), D45.1 (VDD), D46.1 (VDD), D47.1 (VDD), D51.1 (VDD), D52.1 (VDD), D53.1 (VDD), U18.6 (VCCB); also elsewhere on the board
+12V: D39.2 (A), F2.1, R48.2; also elsewhere on the board
/MCU/DIGITAL_BUTTON_IN_0: JP9.2 (C); also elsewhere on the board
/MCU/DIGITAL_BUTTON_IN_1: C76.1, D64.1 (K), R61.2; also elsewhere on the board
/MCU/DIGITAL_BUTTON_IN_2: C73.1, D58.1 (K), R53.2; also elsewhere on the board
/MCU/DIGITAL_BUTTON_IN_3: C75.1, D63.1 (K), R60.2; also elsewhere on the board
/MCU/DIGITAL_BUZZER_OUT: R54.1; also elsewhere on the board
/MCU/DIGITAL_HEATER_OUT: R46.2, R47.1; also elsewhere on the board
/MCU/DIGITAL_IR_EMITTER: R41.1; also elsewhere on the board
/MCU/DIGITAL_IR_RECEIVER: C69.1, U19.1 (OUT); also elsewhere on the board
/MCU/DIGITAL_LED_OUT_0: D48.2 (A); also elsewhere on the board
/MCU/DIGITAL_LED_OUT_1: D49.2 (A); also elsewhere on the board
/MCU/DIGITAL_LED_OUT_2: D50.2 (A); also elsewhere on the board
/MCU/DIGITAL_NEOPIXEL_OUT: U18.3 (A); also elsewhere on the board
/MCU/DIGITAL_RGB_B: R59.1; also elsewhere on the board
/MCU/DIGITAL_RGB_G: R58.1; also elsewhere on the board
/MCU/DIGITAL_RGB_R: R57.1; also elsewhere on the board
/OUTPUTS/BREAKOUT_NEOPIXEL_IN: D51.2 (DOUT); also elsewhere on the board
GND: C64.2, C65.2, C66.2, C67.2, C68.2, C69.2, C70.2, C71.2, C72.2, C73.2, C74.2, C75.2, C76.2, D42.3 (VSS), D44.3 (VSS), D45.3 (VSS), D46.3 (VSS), D47.3 (VSS), D51.3 (VSS), D52.3 (VSS), D53.3 (VSS), D55.1 (A1), D56.1 (A1), D60.3 (A), D61.1 (A1), D62.1 (A1), Q2.2 (E), Q3.2 (S), Q4.2 (E), R38.1, R39.1, R40.1, R43.1, R44.1, R45.1, R46.1, SW3.1, SW4.1, SW5.1, SW6.1, U18.2 (GND), U18.5 (DIR), U19.2 (GND); also elsewhere on the board
unnamed: BZ1.2 (+), D59.2 (A), Q4.3 (C)
unnamed: D39.1 (K), R38.2
unnamed: D40.1 (K), R39.2
unnamed: D41.1 (K), R40.2
unnamed: D42.4 (DIN), D53.2 (DOUT)
unnamed: D42.2 (DOUT), D44.4 (DIN)
unnamed: D43.2 (A), R42.1
unnamed: D43.1 (K), Q2.3 (C)
unnamed: D44.2 (DOUT), D46.4 (DIN)
unnamed: D45.4 (DIN), U18.4 (B)
unnamed: D45.2 (DOUT), D47.4 (DIN)
unnamed: D46.2 (DOUT), D51.4 (DIN)
unnamed: D47.2 (DOUT), D52.4 (DIN)
unnamed: D48.1 (K), R43.2
unnamed: D49.1 (K), R44.2
unnamed: D50.1 (K), R45.2
unnamed: D52.2 (DOUT), D53.4 (DIN)
unnamed: D54.2 (A), R48.1
unnamed: D54.1 (K), Q3.3 (D), R49.2
unnamed: D55.2 (A2), D58.2 (A), R50.1, R53.1, SW3.2
unnamed: D56.2 (A2), D57.2 (A), JP9.3 (B), R51.1, R52.1, SW4.2
unnamed: C74.1, D57.1 (K), JP9.1 (A), R52.2
unnamed: D60.1 (BK), R59.2
unnamed: D60.2 (GK), R58.2
unnamed: D60.4 (RK), R57.2
unnamed: D61.2 (A2), D63.2 (A), R55.1, R60.1, SW5.2
unnamed: D62.2 (A2), D64.2 (A), R56.1, R61.1, SW6.2
unnamed: F2.2, R49.1
unnamed: Q2.1 (B), R41.2
unnamed: Q3.1 (G), R47.2
unnamed: Q4.1 (B), R54.2
VCC: R50.2, R51.2, R55.2, R56.2, U18.1 (VCCA), U19.3 (Vs); also elsewhere on the board

Notes on the sheet:
~500mA
Infrared Emitter
NEOPIXEL chain
Buzzer
USER RGB
Indicator LEDs
Infrared Receiver
USER Buttons
USER LEDs
Heater

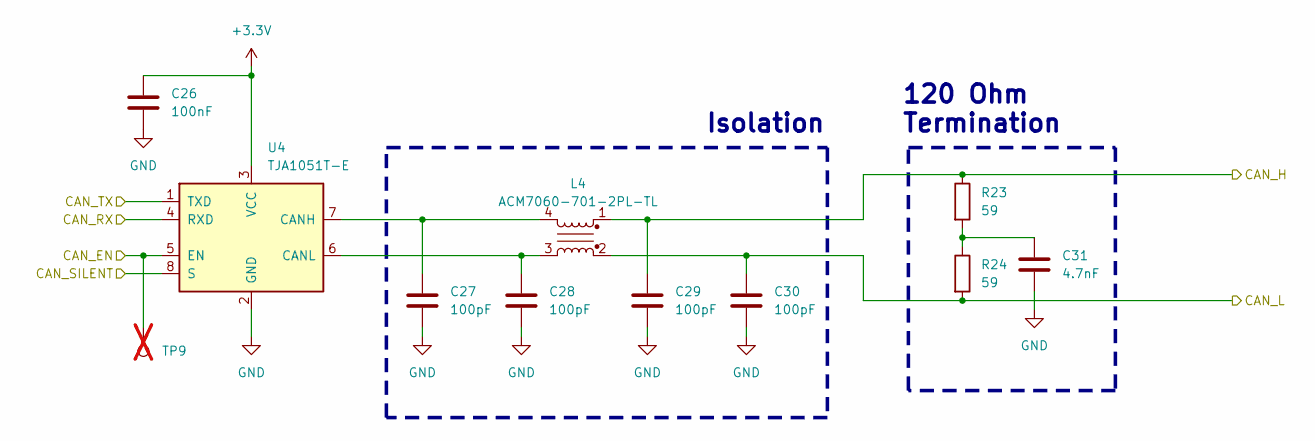
[picture p136: schematic can.kicad_sch]

Parts:
C26: 100nF; C_0603_1608Metric
C27, C28, C29, C30: 100pF; C_0603_1608Metric
C31: 4.7nF; C_0603_1608Metric
L4: ACM7060-701-2PL-TL; L_CommonModeChoke_TDK_ACM7060
R23, R24: 59; R_0603_1608Metric
TP9: TestPoint_Pad_D3.0mm; not fitted
U4: TJA1051T-E; SOIC-8_3.9x4.9mm_P1.27mm

Connections:
+3.3V: C26.1, U4.3 (VCC); also elsewhere on the board
/CAN/CAN_EN: TP9.1, U4.5 (EN); also elsewhere on the board
/CAN/CAN_H: C29.1, L4.1, R23.1; also elsewhere on the board
/CAN/CAN_L: C30.1, L4.2, R24.2; also elsewhere on the board
/CAN/CAN_RX: U4.4 (RXD); also elsewhere on the board
/CAN/CAN_SILENT: U4.8 (S); also elsewhere on the board
/CAN/CAN_TX: U4.1 (TXD); also elsewhere on the board
GND: C26.2, C27.2, C28.2, C29.2, C30.2, C31.2, U4.2 (GND); also elsewhere on the board
unnamed: C31.1, R23.2, R24.1
unnamed: C27.1, L4.4, U4.7 (CANH)
unnamed: C28.1, L4.3, U4.6 (CANL)

Notes on the sheet:
Isolation
120 Ohm Termination

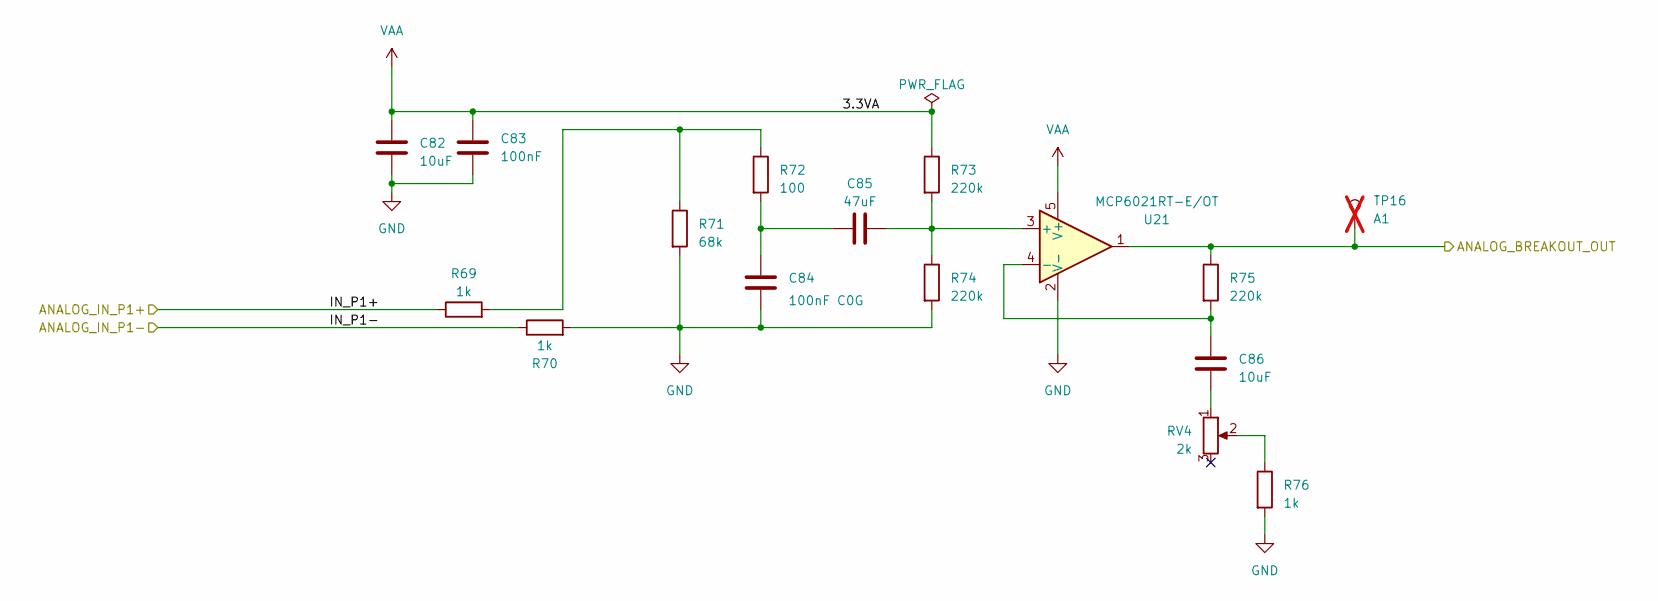
[picture p137: schematic filter.kicad_sch]

Parts:
C82, C86: 10uF; C_0805_2012Metric
C83: 100nF; C_0603_1608Metric
C84: 100nF C0G; C_1206_3216Metric
C85: 47uF; C_1210_3225Metric
R69, R70, R76: 1k; R_0603_1608Metric
R71: 68k; R_0603_1608Metric
R72: 100; R_0603_1608Metric
R73, R74, R75: 220k; R_0603_1608Metric
RV4: 2k; Potentiometer_Bourns_3314J_Vertical
TP16: A1; TestPoint_Pad_D3.0mm; not fitted
U21: MCP6021RT-E/OT; SOT-23-5

Connections:
/50Hz Filter/ANALOG_BREAKOUT_OUT: R75.1, TP16.1, U21.1; also elsewhere on the board
/50Hz Filter/IN_P1+: R69.1; also elsewhere on the board
/50Hz Filter/IN_P1-: R70.1; also elsewhere on the board
GND: C82.2, C83.2, C84.2, R70.2, R71.2, R74.2, R76.2, U21.2 (V-); also elsewhere on the board
unnamed: C84.1, C85.1, R72.2
unnamed: C86.2, RV4.1
unnamed: R69.2, R71.1, R72.1
unnamed: R76.1, RV4.2
unnamed: C85.2, R73.2, R74.1, U21.3 (+)
unnamed: C86.1, R75.2, U21.4 (-)
VAA: C82.1, C83.1, R73.1, U21.5 (V+); also elsewhere on the board

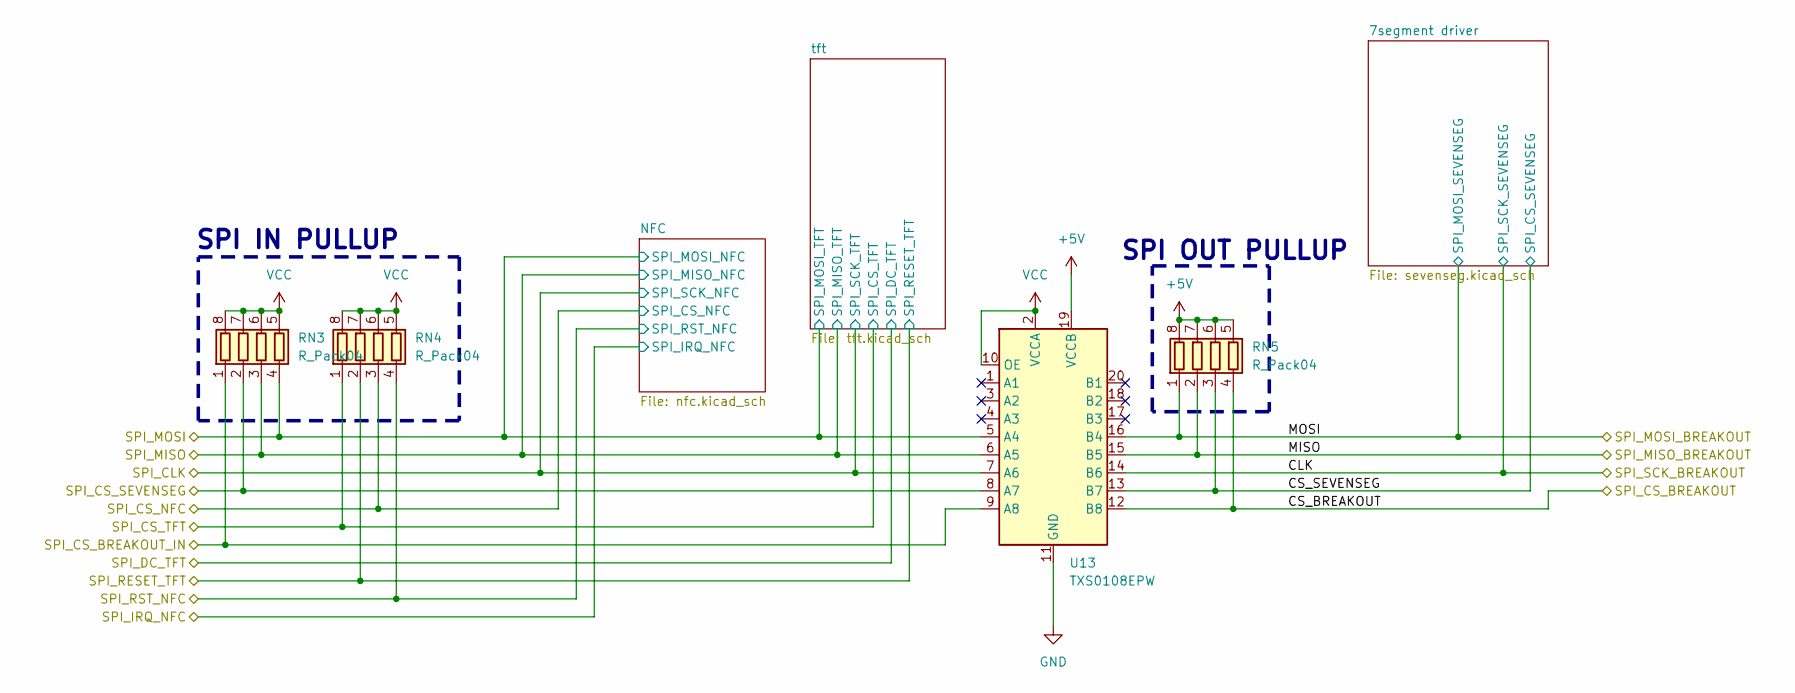
[picture p138: schematic spi.kicad_sch]

Parts:
RN3, RN4, RN5: R_Pack04; R_Array_Convex_4x0603
U13: TXS0108EPW; TSSOP-20_4.4x6.5mm_P0.65mm

Connections:
+5V: RN5.5 (R4.2), RN5.6 (R3.2), RN5.7 (R2.2), RN5.8 (R1.2), U13.19 (VCCB); also elsewhere on the board
/MCU/SPI_CS_BREAKOUT: RN3.1 (R1.1), U13.9 (A8); also elsewhere on the board
/MCU/SPI_CS_NFC: RN4.3 (R3.1); also elsewhere on the board
/MCU/SPI_CS_SEVENSEG: RN3.2 (R2.1), U13.8 (A7); also elsewhere on the board
/MCU/SPI_CS_TFT: RN4.1 (R1.1); also elsewhere on the board
/MCU/SPI_MISO: RN3.3 (R3.1), U13.6 (A5); also elsewhere on the board
/MCU/SPI_MOSI: RN3.4 (R4.1), U13.5 (A4); also elsewhere on the board
/MCU/SPI_RST_NFC: RN4.4 (R4.1); also elsewhere on the board
/MCU/SPI_SCK: U13.7 (A6); also elsewhere on the board
/MCU/SPI_TFT_RESET: RN4.2 (R2.1); also elsewhere on the board
/SPI/CLK: U13.14 (B6); also elsewhere on the board
/SPI/CS_BREAKOUT: RN5.4 (R4.1), U13.12 (B8); also elsewhere on the board
/SPI/CS_SEVENSEG: RN5.3 (R3.1), U13.13 (B7); also elsewhere on the board
/SPI/MISO: RN5.2 (R2.1), U13.15 (B5); also elsewhere on the board
/SPI/MOSI: RN5.1 (R1.1), U13.16 (B4); also elsewhere on the board
GND: U13.11 (GND); also elsewhere on the board
VCC: RN3.5 (R4.2), RN3.6 (R3.2), RN3.7 (R2.2), RN3.8 (R1.2), RN4.5 (R4.2), RN4.6 (R3.2), RN4.7 (R2.2), RN4.8 (R1.2), U13.2 (VCCA), U13.10 (OE); also elsewhere on the board

Notes on the sheet:
SPI OUT PULLUP
SPI IN PULLUP

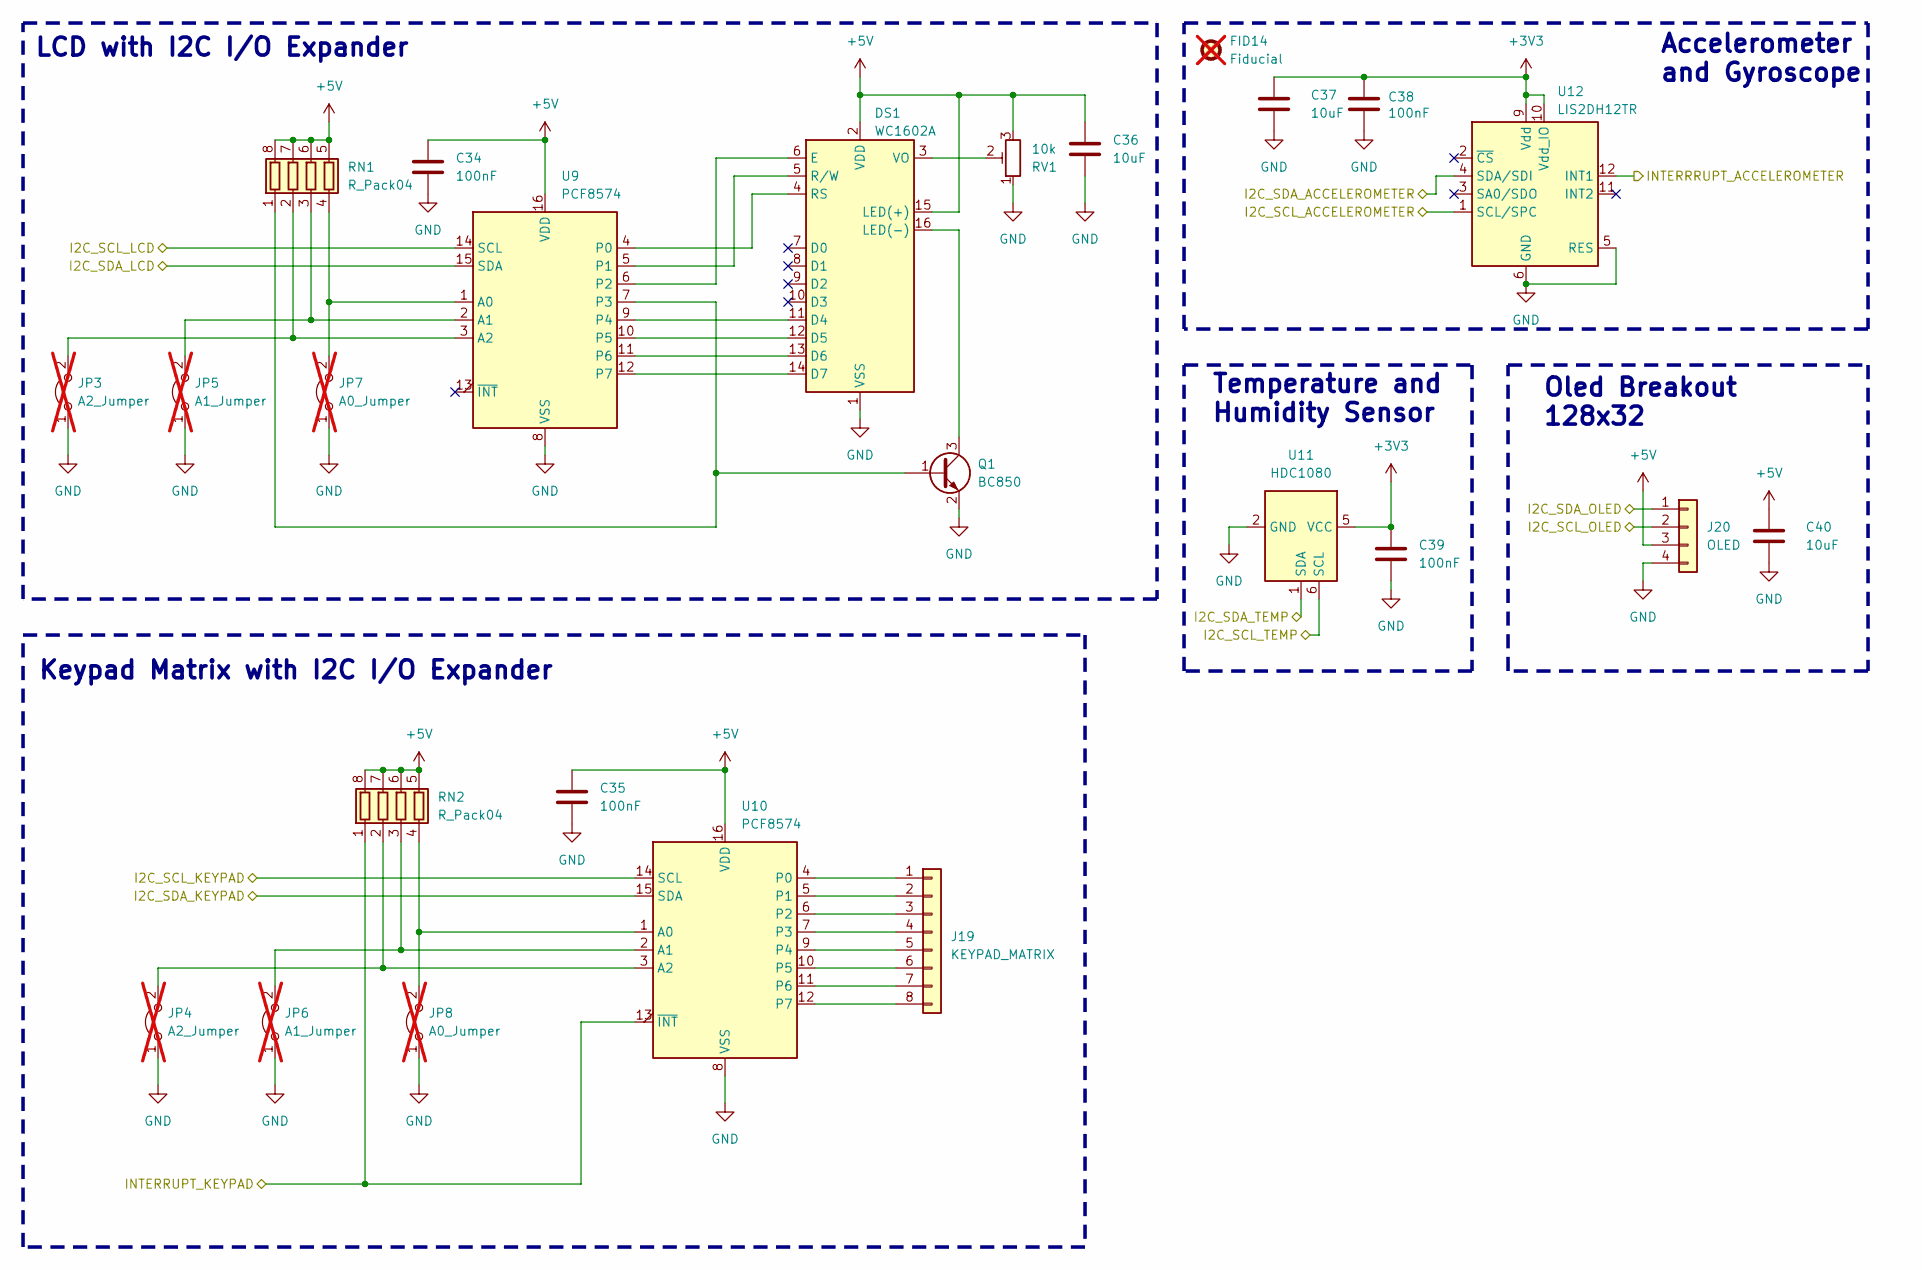
[picture p139: schematic i2c_devices.kicad_sch]

Parts:
C34, C35, C38, C39: 100nF; C_0603_1608Metric
C36, C37, C40: 10uF; C_0805_2012Metric
DS1: WC1602A
FID14: Fiducial; Fiducial_1mm_Mask3mm; not fitted
J19: KEYPAD_MATRIX; PinHeader_1x08_P2.54mm_Vertical_SMD_Pin1Left
J20: OLED; PinSocket_1x04_P2.54mm_Vertical
JP3, JP4: A2_Jumper; SolderJumper-2_P1.3mm_Open_Pad1.0x1.5mm; not fitted
JP5, JP6: A1_Jumper; SolderJumper-2_P1.3mm_Open_Pad1.0x1.5mm; not fitted
JP7, JP8: A0_Jumper; SolderJumper-2_P1.3mm_Open_Pad1.0x1.5mm; not fitted
Q1: BC850; SOT-23
RN1, RN2: R_Pack04; R_Array_Convex_4x0603
RV1: 10k; Potentiometer_Bourns_3314J_Vertical
U9, U10: PCF8574; SSOP-20_4.4x6.5mm_P0.65mm
U11: HDC1080; Texas_PWSON-N6; MOUSER 595-HDC1080DMBR
U12: LIS2DH12TR; LGA-12_2x2mm_P0.5mm; MOUSER 511-LIS2DH12TR

Connections:
+3V3: C37.1, C38.1, C39.1, U11.5 (VCC), U12.9 (Vdd), U12.10 (Vdd_IO); also elsewhere on the board
+5V: C34.1, C35.1, C36.1, C40.1, DS1.2 (VDD), DS1.15 (LED(+)), J20.3, RN1.5 (R4.2), RN1.6 (R3.2), RN1.7 (R2.2), RN1.8 (R1.2), RN2.5 (R4.2), RN2.6 (R3.2), RN2.7 (R2.2), RN2.8 (R1.2), RV1.3, U9.16 (VDD), U10.16 (VDD); also elsewhere on the board
/I2C/I2C Devices/INTERRUPT_KEYPAD: RN2.1 (R1.1), U10.13 (~INT); also elsewhere on the board
/I2C/I2C_SCL_3V3: U11.6 (SCL), U12.1 (SCL/SPC); also elsewhere on the board
/I2C/I2C_SCL_5V: J20.2, U9.14 (SCL), U10.14 (SCL); also elsewhere on the board
/I2C/I2C_SDA_3V3: U11.1 (SDA), U12.4 (SDA/SDI); also elsewhere on the board
/I2C/I2C_SDA_5V: J20.1, U9.15 (SDA), U10.15 (SDA); also elsewhere on the board
/I2C/INTERRRUPT_ACCELEROMETER: U12.12 (INT1); also elsewhere on the board
GND: C34.2, C35.2, C36.2, C37.2, C38.2, C39.2, C40.2, DS1.1 (VSS), J20.4, JP3.1 (A), JP4.1 (A), JP5.1 (A), JP6.1 (A), JP7.1 (A), JP8.1 (A), Q1.2 (E), RV1.1, U9.8 (VSS), U10.8 (VSS), U11.2 (GND), U12.5 (RES), U12.6 (GND), U12.7 (GND), U12.8 (GND); also elsewhere on the board
unnamed: DS1.11 (D4), U9.9 (P4)
unnamed: DS1.12 (D5), U9.10 (P5)
unnamed: DS1.13 (D6), U9.11 (P6)
unnamed: DS1.14 (D7), U9.12 (P7)
unnamed: DS1.6 (E), U9.6 (P2)
unnamed: DS1.16 (LED(-)), Q1.3 (C)
unnamed: DS1.4 (RS), U9.4 (P0)
unnamed: DS1.5 (R/W), U9.5 (P1)
unnamed: DS1.3 (VO), RV1.2
unnamed: J19.1, U10.4 (P0)
unnamed: J19.2, U10.5 (P1)
unnamed: J19.3, U10.6 (P2)
unnamed: J19.4, U10.7 (P3)
unnamed: J19.5, U10.9 (P4)
unnamed: J19.6, U10.10 (P5)
unnamed: J19.7, U10.11 (P6)
unnamed: J19.8, U10.12 (P7)
unnamed: JP3.2 (B), RN1.2 (R2.1), U9.3 (A2)
unnamed: JP4.2 (B), RN2.2 (R2.1), U10.3 (A2)
unnamed: JP5.2 (B), RN1.3 (R3.1), U9.2 (A1)
unnamed: JP6.2 (B), RN2.3 (R3.1), U10.2 (A1)
unnamed: JP7.2 (B), RN1.4 (R4.1), U9.1 (A0)
unnamed: JP8.2 (B), RN2.4 (R4.1), U10.1 (A0)
unnamed: Q1.1 (B), RN1.1 (R1.1), U9.7 (P3)

Notes on the sheet:
LCD with I2C I/O Expander
Keypad Matrix with I2C I/O Expander
Accelerometer and Gyroscope
Temperature and Humidity Sensor
Oled Breakout 128x32

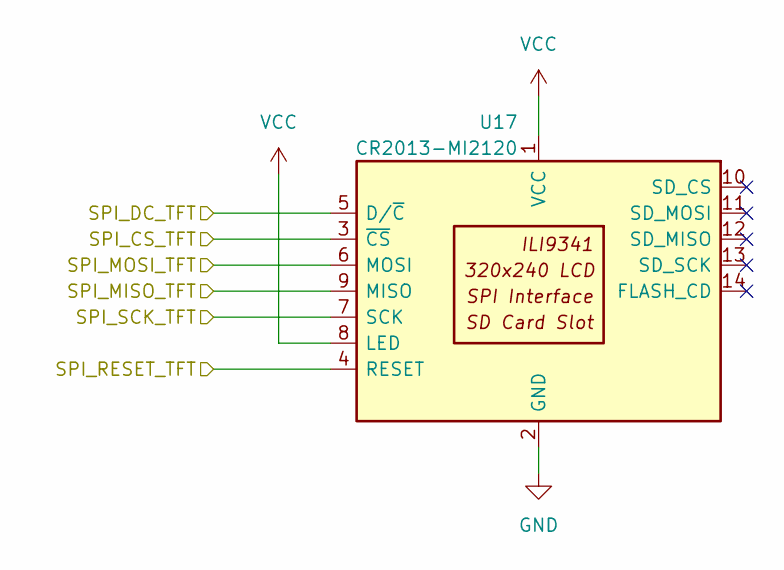
[picture p140: schematic tft.kicad_sch]

Parts:
U17: CR2013-MI2120

Connections:
/MCU/SPI_CS_TFT: U17.3 (~CS); also elsewhere on the board
/MCU/SPI_MISO: U17.9 (MISO); also elsewhere on the board
/MCU/SPI_MOSI: U17.6 (MOSI); also elsewhere on the board
/MCU/SPI_SCK: U17.7 (SCK); also elsewhere on the board
/MCU/SPI_TFT_DC: U17.5 (D/~C); also elsewhere on the board
/MCU/SPI_TFT_RESET: U17.4 (RESET); also elsewhere on the board
GND: U17.2 (GND); also elsewhere on the board
VCC: U17.1 (VCC), U17.8 (LED); also elsewhere on the board

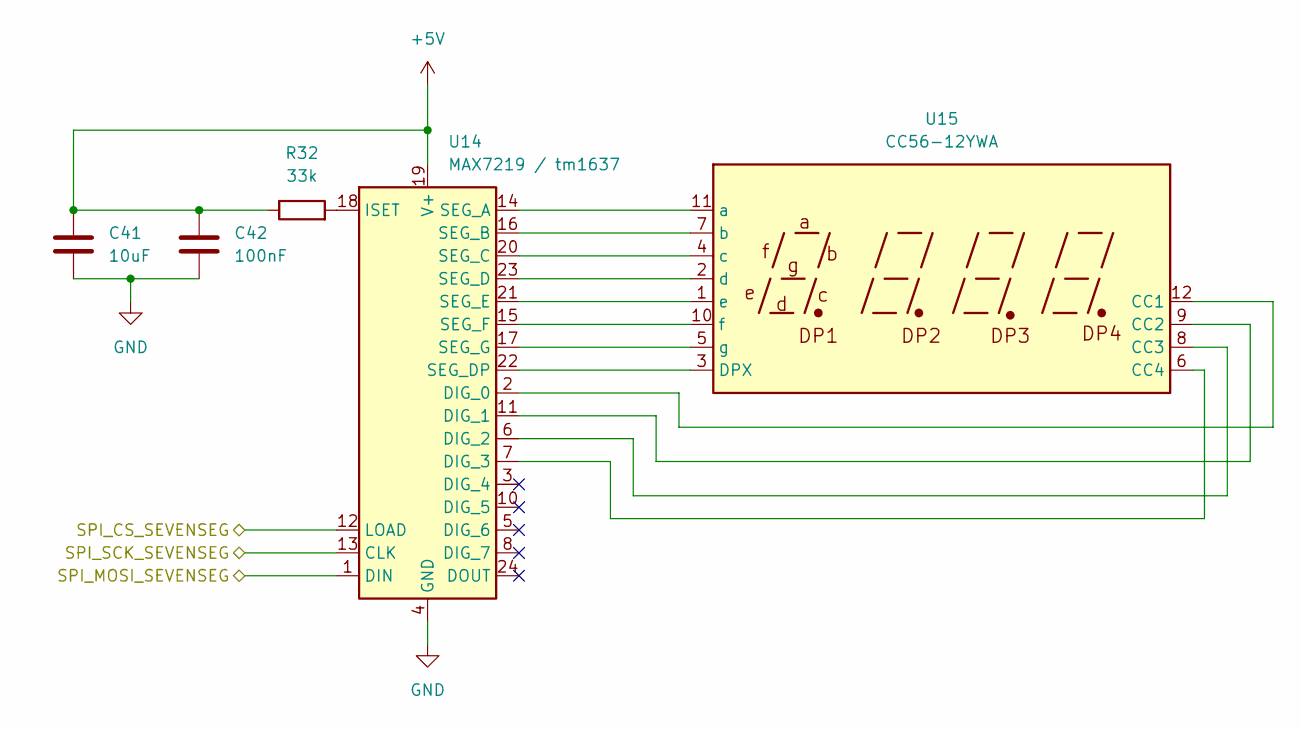
[picture p141: schematic sevenseg.kicad_sch]

Parts:
C41: 10uF; C_0805_2012Metric
C42: 100nF; C_0603_1608Metric
R32: 33k; R_0603_1608Metric
U14: MAX7219 / tm1637; SOIC-24W_7.5x15.4mm_P1.27mm
U15: CC56-12YWA; 4_digit_7_segment_display

Connections:
+5V: C41.1, C42.1, R32.1, U14.19 (V+); also elsewhere on the board
/SPI/CLK: U14.13 (CLK); also elsewhere on the board
/SPI/CS_SEVENSEG: U14.12 (LOAD); also elsewhere on the board
/SPI/MOSI: U14.1 (DIN); also elsewhere on the board
GND: C41.2, C42.2, U14.4 (GND), U14.9 (GND); also elsewhere on the board
unnamed: U14.2 (DIG_0), U15.12 (CC1)
unnamed: U14.11 (DIG_1), U15.9 (CC2)
unnamed: U14.6 (DIG_2), U15.8 (CC3)
unnamed: U14.7 (DIG_3), U15.6 (CC4)
unnamed: R32.2, U14.18 (ISET)
unnamed: U14.14 (SEG_A), U15.11 (a)
unnamed: U14.16 (SEG_B), U15.7 (b)
unnamed: U14.20 (SEG_C), U15.4 (c)
unnamed: U14.23 (SEG_D), U15.2 (d)
unnamed: U14.22 (SEG_DP), U15.3 (DPX)
unnamed: U14.21 (SEG_E), U15.1 (e)
unnamed: U14.15 (SEG_F), U15.10 (f)
unnamed: U14.17 (SEG_G), U15.5 (g)
