mark69163/prodigy/PRODIGY-MOTHERBOARD/PRODIGY-MOTHERBOARD.kicad_pcb

## KiCad design PRODIGY-MOTHERBOARD/PRODIGY-MOTHERBOARD.kicad_pcb (continued)

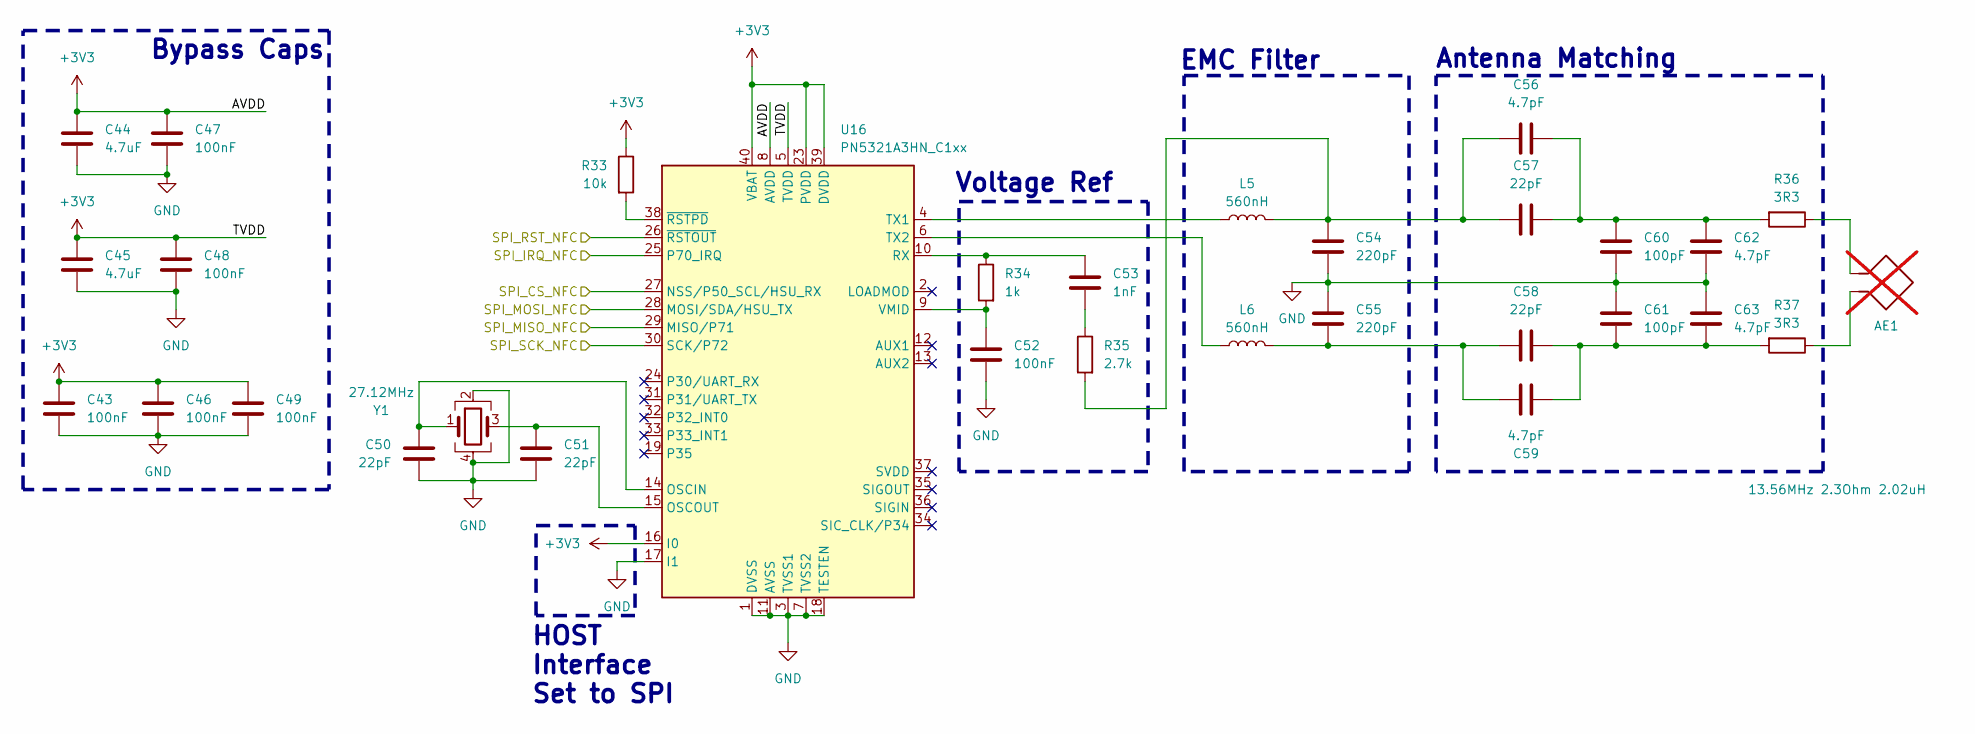
[picture p142: schematic nfc.kicad_sch]

Parts:
AE1: 13.56MHz 2.3Ohm 2.02uH; 40x40 antenna; not fitted
C43, C46, C47, C48, C49, C52: 100nF; C_0603_1608Metric
C44, C45: 4.7uF; C_0805_2012Metric
C50, C51, C57, C58: 22pF; C_0603_1608Metric
C53: 1nF; C_0603_1608Metric
C54, C55: 220pF; C_0603_1608Metric
C56, C59, C62, C63: 4.7pF; C_0603_1608Metric
C60, C61: 100pF; C_0603_1608Metric
L5, L6: 560nH; L_0603_1608Metric
R33: 10k; R_0603_1608Metric
R34: 1k; R_0603_1608Metric
R35: 2.7k; R_0603_1608Metric
R36, R37: 3R3; R_0603_1608Metric
U16: PN5321A3HN_C1xx; HVQFN-40-1EP_6x6mm_P0.5mm_EP4.1x4.1mm; MOUSER 771-PN5321A3HNC10
Y1: 27.12MHz; Crystal_SMD_SeikoEpson_FA128-4Pin_2.0x1.6mm

Connections:
+3V3: C43.1, C44.1, C45.1, C46.1, C47.1, C48.1, C49.1, R33.1, U16.5 (TVDD), U16.8 (AVDD), U16.16 (I0), U16.23 (PVDD), U16.39 (DVDD), U16.40 (VBAT); also elsewhere on the board
/MCU/SPI_CS_NFC: U16.27 (NSS/P50_SCL/HSU_RX); also elsewhere on the board
/MCU/SPI_IRQ_NFC: U16.25 (P70_IRQ); also elsewhere on the board
/MCU/SPI_MISO: U16.29 (MISO/P71); also elsewhere on the board
/MCU/SPI_MOSI: U16.28 (MOSI/SDA/HSU_TX); also elsewhere on the board
/MCU/SPI_RST_NFC: U16.26 (~RSTOUT); also elsewhere on the board
/MCU/SPI_SCK: U16.30 (SCK/P72); also elsewhere on the board
GND: C43.2, C44.2, C45.2, C46.2, C47.2, C48.2, C49.2, C50.2, C51.2, C52.2, C54.2, C55.1, C60.2, C61.1, C62.2, C63.1, U16.1 (DVSS), U16.3 (TVSS1), U16.7 (TVSS2), U16.11 (AVSS), U16.17 (I1), U16.18 (TESTEN), U16.41 (AVSS), Y1.2, Y1.4; also elsewhere on the board
unnamed: AE1.1, AE1.2, R36.1, R37.1
unnamed: C53.2, R35.1
unnamed: C54.1, C56.1, C57.1, L5.2, R35.2
unnamed: C55.2, C58.1, C59.1, L6.2
unnamed: C56.2, C57.2, C60.1, C62.1, R36.2
unnamed: C58.2, C59.2, C61.2, C63.2, R37.2
unnamed: C50.1, U16.14 (OSCIN), Y1.1
unnamed: C51.1, U16.15 (OSCOUT), Y1.3
unnamed: C53.1, R34.1, U16.10 (RX)
unnamed: L5.1, U16.4 (TX1)
unnamed: L6.1, U16.6 (TX2)
unnamed: C52.1, R34.2, U16.9 (VMID)
unnamed: R33.2, U16.38 (~RSTPD)

Notes on the sheet:
EMC Filter
HOST Interface Set to SPI
Bypass Caps
Voltage Ref
Antenna Matching

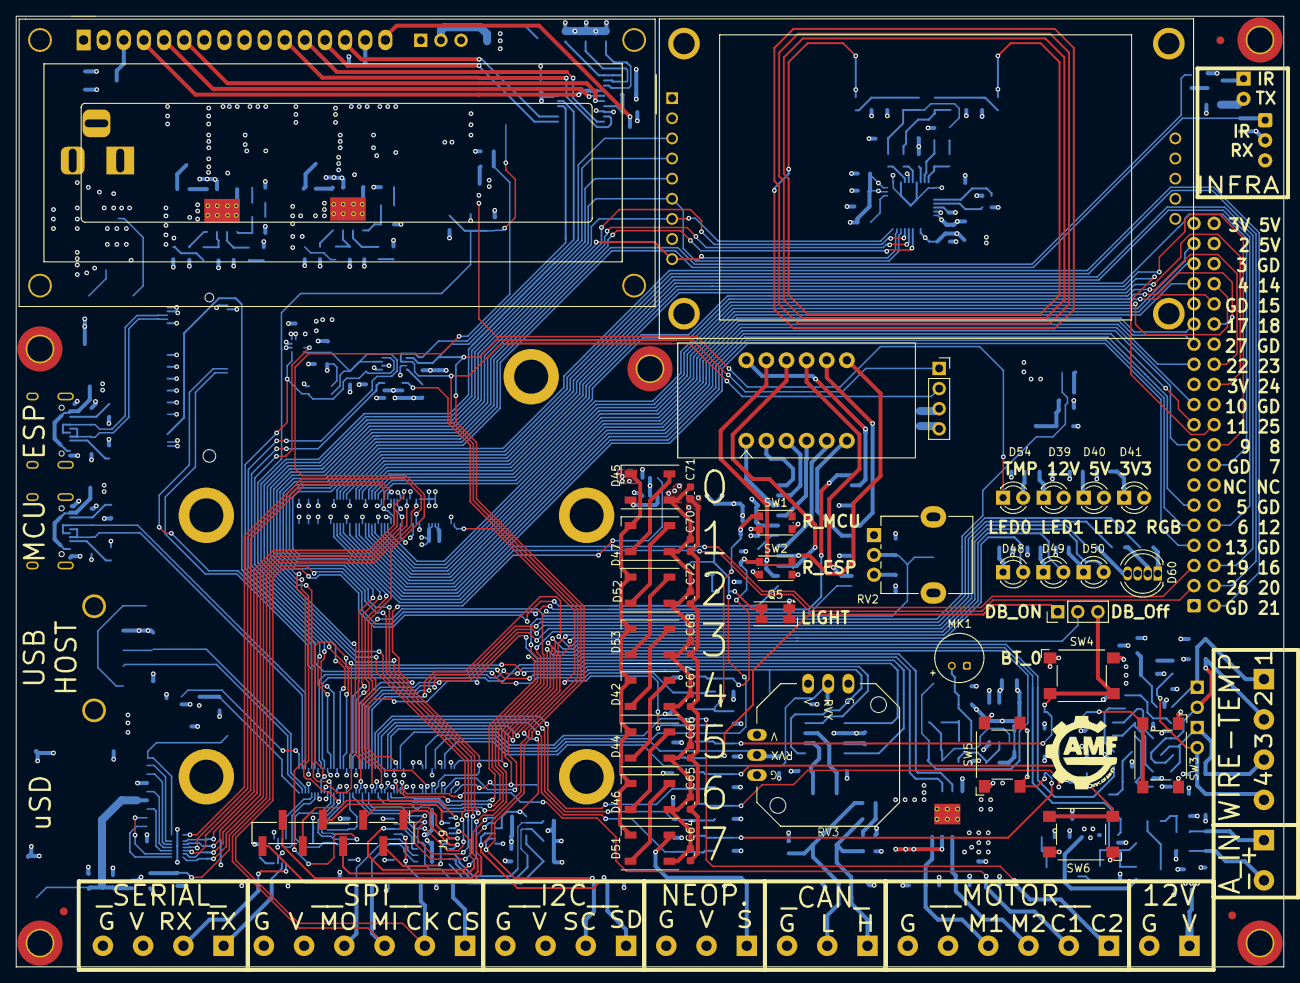
[picture p143: board PRODIGY-MOTHERBOARD.kicad_pcb from above]

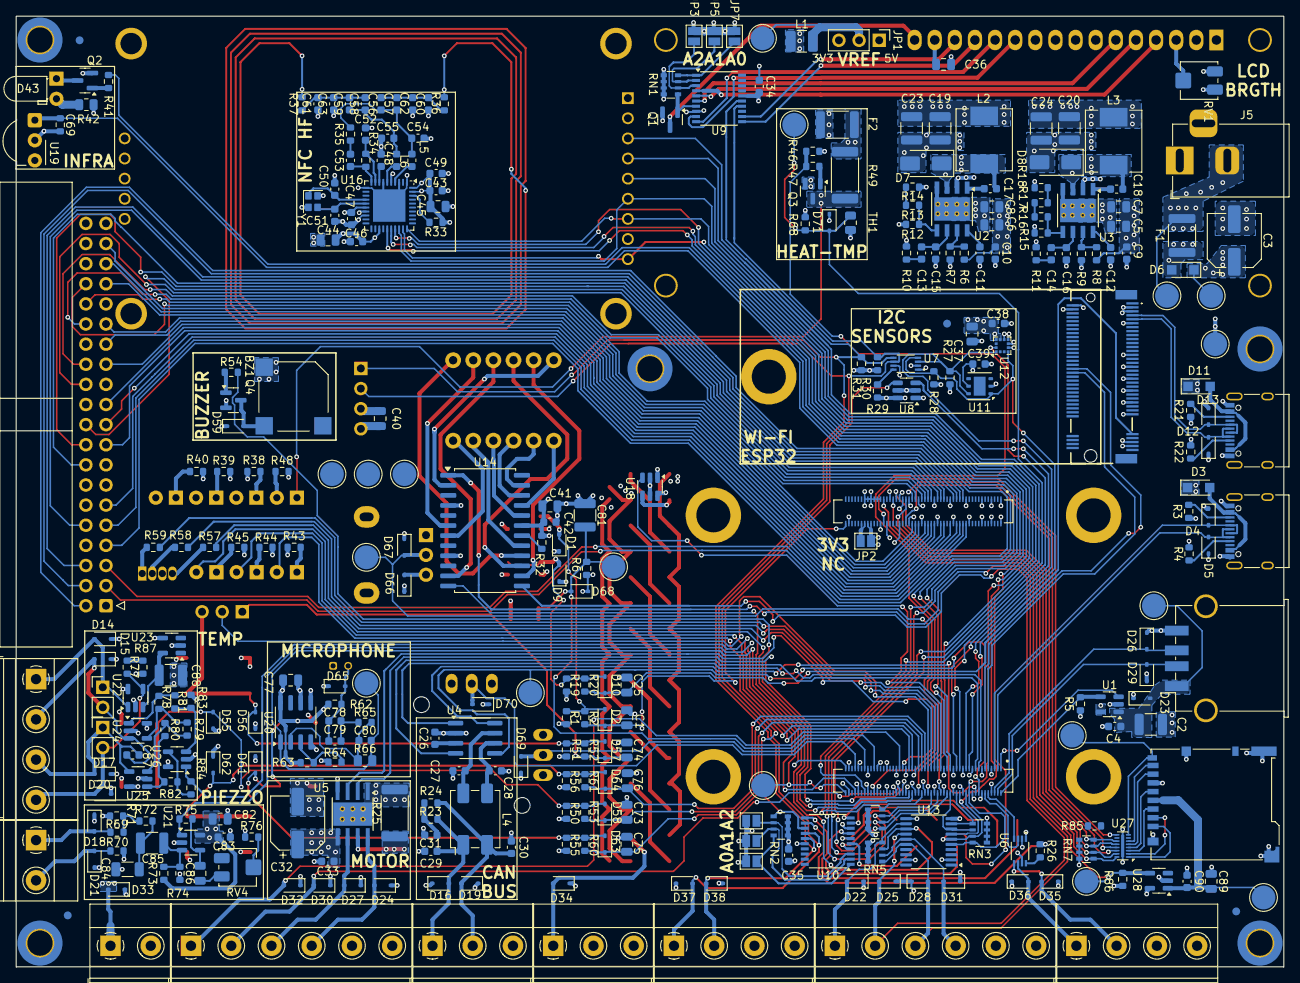
[picture p144: board PRODIGY-MOTHERBOARD.kicad_pcb from below]

Board: 4 copper layers, 160.0 x 120.0 mm, 373 parts (320 on the bottom side), 259 nets.
