mark69163/prodigy/PRODIGY-ESP32/PRODIGY-ESP32/PRODIGY-ESP32.kicad_pcb

## KiCad design PRODIGY-ESP32/PRODIGY-ESP32/PRODIGY-ESP32.kicad_pcb (2024-07-10)

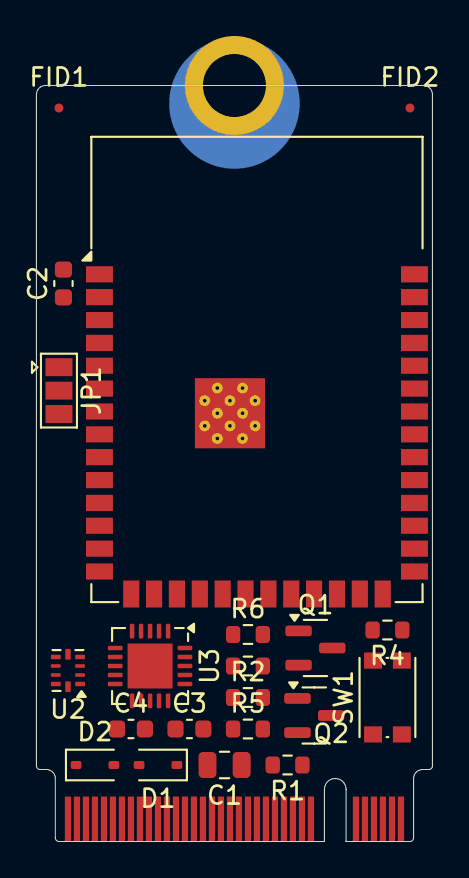
[picture p145: board PRODIGY-ESP32.kicad_pcb from above]

Board: 2 copper layers, 22.0 x 42.0 mm, 22 parts (0 on the bottom side), 20 nets, no tracks yet.

Parts:
C1: 10uF; C_0805_2012Metric
C2, C3, C4: 100nF; C_0603_1608Metric
D1, D2: SD05_SOD323; D_SOD-323
FID1, FID2: Fiducial; Fiducial_0.5mm_Mask1.5mm
J1: Bus_M.2_Socket_B; M.2-B-KEY
JP1: Jumper_3_Bridged12; SolderJumper-3_P1.3mm_Open_Pad1.0x1.5mm
Q1, Q2: BC850; SOT-23
R1, R2, R3: 10k; R_0603_1608Metric
R4: 1k; R_0603_1608Metric
R5, R6: 0R; R_0603_1608Metric
SW1: SW_Push; SW_Push_1P1T_NO_CK_KMR2
U1: ESP32-S3-WROOM-1
U2: TS3USB221AQRSERQ1; Texas_UQFN-10_1.5x2mm_P0.5mm
U3: FT231XQ; QFN-20-1EP_4x4mm_P0.5mm_EP2.5x2.5mm

Connections:
+3V3: C1.1, C2.1, C3.1, C4.1, JP1.1 (A), R1.2, U1.2 (3V3), U2.10 (VCC), U3.10 (3V3OUT), U3.12 (VCC), U3.20 (VCCIO)
/DTR: Q2.2 (E), R2.1, U3.18 (~DTR)
/ESP_BUTTON_BOOT: Q2.3 (C), R4.2, U1.27 (IO0)
/ESP_BUTTON_RESET: Q1.3 (C), U1.3 (EN)
/ESP_SERIAL_RX0: R6.2, U1.36 (RXD0)
/ESP_SERIAL_TX0: R5.2, U1.37 (TXD0)
/RTS: Q1.2 (E), R3.1, U3.19 (~RTS)
/USB_D1+: U2.1 (D1+), U3.8 (USBDP)
/USB_D1-: U2.2 (D1-), U3.9 (USBDM)
/USB_D2+: U1.14 (IO20), U2.3 (D2+)
/USB_D2-: U1.13 (IO19), U2.4 (D2-)
/USB_D+: D1.2 (A2), U2.8 (D+)
/USB_D-: D2.2 (A2), U2.7 (D-)
GND: C1.2, C2.2, C3.2, C4.2, D1.1 (A1), D2.1 (A1), JP1.3 (B), SW1.1, U1.1 (GND), U1.40 (GND), U1.41 (GND), U2.5 (GND), U2.6 (~OE), U3.3 (GND), U3.13 (GND), U3.21 (GND)
unnamed: JP1.2 (C), U2.9 (S)
unnamed: Q1.1 (B), R2.2
unnamed: Q2.1 (B), R3.2
unnamed: R1.1, R4.1, SW1.2
unnamed: R6.1, U3.1 (RXD)
unnamed: R5.1, U3.17 (TXD)
