mark69163/prodigy/(commit log)

2024-05-21 project restructure done. Hierarchical sheet done. Outputs/breakouts sheet done
    [PRODIGY-MOTHERBOARD.kicad_pcb, PRODIGY-MOTHERBOARD.kicad_sch, accelerometer.kicad_sch, analog.kicad_sch, arduino_mega.kicad_sch, audio.kicad_sch, can.kicad_sch, digital.kicad_sch]
2024-05-22 Finished I2C device and bus schematics. Added logic level translation.
    [PRODIGY-MOTHERBOARD.kicad_pcb, PRODIGY-MOTHERBOARD.kicad_sch, accelerometer.kicad_sch, filter.kicad_sch, i2c.kicad_sch, i2c_devices.kicad_sch, lcd.kicad_sch, lcdAndKeypad.kicad_sch]
2024-05-23 SPI SD CARD circuit added.
    [PRODIGY-MOTHERBOARD.kicad_pcb, PRODIGY-MOTHERBOARD.kicad_sch, digital.kicad_sch, filter.kicad_sch, mcu.kicad_sch, outputs.kicad_sch, sd.kicad_sch, spi.kicad_sch]
2024-05-23 Finished neopixel and button's schematic.
    [PRODIGY-MOTHERBOARD.kicad_sch, audio.kicad_sch, digital.kicad_sch, mcu.kicad_sch, sd.kicad_sch, spi.kicad_sch, tft.kicad_sch]
2024-05-23 LEDs schematic done.
    [PRODIGY-MOTHERBOARD.kicad_pcb, PRODIGY-MOTHERBOARD.kicad_sch, digital.kicad_sch]
2024-05-25 Digital section done.
    [PRODIGY-MOTHERBOARD.kicad_pcb, PRODIGY-MOTHERBOARD.kicad_sch, digital.kicad_sch, power.kicad_sch]
2024-05-25 CAN schematic done
    [PRODIGY-MOTHERBOARD.kicad_pcb, PRODIGY-MOTHERBOARD.kicad_sch, analog.kicad_sch, audio.kicad_sch, can.kicad_sch, digital.kicad_sch, esp32.kicad_sch, filter.kicad_sch]
2024-05-26 SPI NFC schematic done.
    [analog.kicad_sch, audio.kicad_sch, can.kicad_sch, digital.kicad_sch, esp32.kicad_sch, filter.kicad_sch, i2c.kicad_sch, i2c_devices.kicad_sch]
2024-05-26 Analog schematic finished, except the joystick part.
    [PRODIGY-MOTHERBOARD.kicad_pcb, PRODIGY-MOTHERBOARD.kicad_sch, analog.kicad_sch, audio.kicad_sch, can.kicad_sch, filter.kicad_sch, i2c.kicad_sch, outputs.kicad_sch]
2024-05-28 2-axis joystick footprint and sybmbol created. Analog-side done.
    [PRODIGY-MOTHERBOARD.kicad_pcb, PRODIGY-MOTHERBOARD.kicad_sch, analog.kicad_sch]
2024-05-29 Added pins to MCU. Added Decoder for SPI SS-Multiplexing.
    [CMA-4544.step, PRODIGY-MOTHERBOARD.kicad_pcb, PRODIGY-MOTHERBOARD.kicad_sch, analog.kicad_sch, can.kicad_sch, digital.kicad_sch, esp32.kicad_sch, filter.kicad_sch]
2024-06-03 Added proper debounce filter elements to buttons.
    [PRODIGY-MOTHERBOARD.kicad_pcb, PRODIGY-MOTHERBOARD.kicad_sch, analog.kicad_sch, audio.kicad_sch, can.kicad_sch, digital.kicad_sch, esp32.kicad_sch, filter.kicad_sch]
2024-06-04 Esp32 motherboard schematic done.
    [PRODIGY-MOTHERBOARD.kicad_pcb, PRODIGY-MOTHERBOARD.kicad_sch, esp32.kicad_sch]
2024-06-04 Submitted V0 for evaluation. Avaiting feedback.
    [PRODIGY-MOTHERBOARD.kicad_sch, analog.kicad_sch, audio.kicad_sch, can.kicad_sch, digital.kicad_sch, esp32.kicad_sch, filter.kicad_sch, i2c.kicad_sch]
2024-06-19 MCU schematic done. Started Analog design.
    [PRODIGY-MOTHERBOARD.kicad_sch, PRODIGY_v0_BOM.xlsx, esp32.kicad_sch, filter.kicad_sch, mcu.kicad_sch, nfc.kicad_sch, outputs.kicad_sch, pt100.kicad_sch]
2024-06-20 Finished v0.1 schematic.
    [PRODIGY-MOTHERBOARD.kicad_pcb, PRODIGY-MOTHERBOARD.kicad_sch, analog.kicad_sch, can.kicad_sch, digital.kicad_sch, esp32.kicad_sch, filter.kicad_sch, i2c.kicad_sch]
2024-06-22 MBT Schematic improved
    [7 segment1.STEP, PRODIGY-MOTHERBOARD.kicad_pcb, PRODIGY-MOTHERBOARD.kicad_sch, analog.kicad_sch, can.kicad_sch, digital.kicad_sch, esp32.kicad_sch, i2c_devices.kicad_sch]
2024-06-23 schematic v0.2 finalized
    [PRODIGY-MOTHERBOARD.kicad_pcb, PRODIGY-MOTHERBOARD.kicad_sch, analog.kicad_sch, can.kicad_sch, digital.kicad_sch, esp32.kicad_sch, filter.kicad_sch, i2c.kicad_sch]
2024-06-24 changed breakout connectors and bpc size
    [PRODIGY-MOTHERBOARD.kicad_pcb, digital.kicad_sch, outputs.kicad_sch]
2024-06-25 ESP32 schematic complete.
    [PRODIGY-ESP32.kicad_pcb, PRODIGY-ESP32.kicad_sch, PRODIGY-ESP32.step, PRODIGY-MOTHERBOARD.kicad_pcb, esp32.kicad_sch, mcu.kicad_sch]
2024-06-26 Started STM32. Finished connectors and ST-LINK V2 schematic.
    [PRODIGY-MOTHERBOARD.kicad_pcb, PRODIGY-STM32.kicad_pcb, PRODIGY-STM32.kicad_sch, connector2.kicad_sch, connectors.kicad_sch, mcu.kicad_sch, st_link.kicad_sch]
2024-06-29 stm32 schematic finished
    [PRODIGY-STM32.kicad_pcb, PRODIGY-STM32.kicad_sch, connector2.kicad_sch, connectors.kicad_sch, mcu.kicad_sch, st_link.kicad_sch]
2024-07-02 ATMEGA2560 schematic finished
    [PRODIGY-ATMEGA2560.kicad_pcb, PRODIGY-ATMEGA2560.kicad_sch, atmega2560.kicad_sch, conLeft.kicad_sch, conRight.kicad_sch, usbBridge.kicad_sch]
2024-07-03 Motherboard footprints assigned.
    [PRODIGY-MOTHERBOARD.kicad_pcb, PRODIGY-MOTHERBOARD.kicad_sch, analog.kicad_sch, can.kicad_sch, digital.kicad_sch, esp32.kicad_sch, filter.kicad_sch, i2c.kicad_sch]
2024-07-04 All footprint assosiations have been made across all schematics.
    [PRODIGY-ATMEGA2560.kicad_pcb, PRODIGY-ATMEGA2560.kicad_sch, PRODIGY-ESP32.kicad_pcb, PRODIGY-ESP32.kicad_sch, PRODIGY-STM32.kicad_pcb, PRODIGY-STM32.kicad_sch, analog.kicad_sch, atmega2560.kicad_sch]
2024-07-06 STM32 bom done.
    [DF40C-100DP.stp, PRODIGY-STM32.csv, PRODIGY-STM32.kicad_pcb, PRODIGY-STM32.kicad_sch, connector2.kicad_sch, connectors.kicad_sch, mcu.kicad_sch, st_link.kicad_sch]
2024-07-06 ESP32 and ATMEGA bom done.
    [PRODIGY-ATMEGA2560.csv, PRODIGY-ATMEGA2560.kicad_pcb, PRODIGY-ATMEGA2560.kicad_sch, PRODIGY-ESP32.csv, PRODIGY-ESP32.kicad_pcb, PRODIGY-ESP32.kicad_sch, PRODIGY-STM32.csv, PRODIGY-STM32.kicad_sch]
2024-07-06 Shcematic fixes to ESP32
    [PRODIGY-ESP32.kicad_pcb, PRODIGY-ESP32.kicad_sch]
2024-07-10 finished motherboard bom and updated footprints
    [BOM.xlsx, PRODIGY-ESP32.kicad_pcb, PRODIGY-MOTHERBOARD.kicad_pcb, PRODIGY-MOTHERBOARD.kicad_sch, analog.kicad_sch, can.kicad_sch, digital.kicad_sch, esp32.kicad_sch]
2024-07-11 TOTAL BOM finalized.
    [BOM.xlsx, PRODIGY-MOTHERBOARD.csv, PRODIGY-MOTHERBOARD.kicad_pcb, PRODIGY_BOM_V0.2.xlsx, PRODIGY_v0_BOM.xlsx]
2024-08-01 Motherboard PCB layout started.
    [PRODIGY-MOTHERBOARD.kicad_pcb]
2024-08-07 Motherboard PCB layout started
    [PRODIGY-MOTHERBOARD.kicad_pcb, PRODIGY-MOTHERBOARD.kicad_sch, analog.kicad_sch, can.kicad_sch, digital.kicad_sch, esp32.kicad_sch, filter.kicad_sch, i2c.kicad_sch]
2024-08-09 Analog lazout done
    [PRODIGY-MOTHERBOARD.kicad_pcb, esp32.kicad_sch, i2c.kicad_sch, mcu.kicad_sch, sd.kicad_sch, spi.kicad_sch]
2024-08-14 Motherboard layout done, testpoints still remain
    [PRODIGY-MOTHERBOARD.kicad_pcb, outputs.kicad_sch]
2024-08-21 motherboard layout and labeling done
    [PRODIGY-MOTHERBOARD.kicad_pcb, mcu.kicad_sch]
2024-08-23 Resistor array fixed, layout main components locked, high speed routing done
    [PRODIGY-MOTHERBOARD.kicad_pcb, analog.kicad_sch, esp32.kicad_sch, i2c_devices.kicad_sch, outputs.kicad_sch, sd.kicad_sch, spi.kicad_sch]
2024-08-26 did some routing
    [PRODIGY-MOTHERBOARD.kicad_pcb]
2024-08-29 lot more routing on the motherboard
    [PRODIGY-MOTHERBOARD.kicad_pcb, i2c_devices.kicad_sch]
2024-09-06 motherboard bulk routing mostly done, loads of vias placed, should be done with one days work
    [PRODIGY-MOTHERBOARD.kicad_pcb, sd.kicad_sch]
2024-09-10 Main routing on motherboard is done.
    [PRODIGY-MOTHERBOARD.kicad_pcb]
2024-09-12 nice routing done. nfc antenna close to done
    [PRODIGY-MOTHERBOARD.kicad_pcb, nfc.kicad_sch]
2024-09-15 Fixed postion error on carrier, created nfc antenna
    [PRODIGY-MOTHERBOARD.kicad_pcb]
2024-09-15 Laberls fixed
    [PRODIGY-MOTHERBOARD.kicad_pcb]
2024-09-15 Power routing done...not nicely tho
    [can.kicad_sch, sd.kicad_sch]
2024-09-19 Atmega layout done. orientation and alignment testing done. routing started.
    [PRODIGY-ATMEGA2560.kicad_pcb, PRODIGY-ATMEGA2560.kicad_sch, atmega2560.kicad_sch, conLeft.kicad_sch, conRight.kicad_sch, usbBridge.kicad_sch]
2024-09-22 vias done, some routing done. analog routing done
    [PRODIGY-ATMEGA2560.kicad_pcb, atmega2560.kicad_sch]
2024-09-27 major routing done on atmega board.
    [PRODIGY-ATMEGA2560.kicad_pcb, atmega2560.kicad_sch]
2024-09-29 Atmega board routing and power planes done. via stitching and labeling is needed
    [PRODIGY-ATMEGA2560.kicad_pcb, atmega2560.kicad_sch]
2024-09-30 DRC ran with 0 errors
    [PRODIGY-ATMEGA2560.kicad_pcb, atmega2560.kicad_sch]
2024-09-30 atmega board done, labeling done, gerber export done,
    [PRODIGY-ATMEGA2560.kicad_pcb, bom.csv, designators.csv, positions.csv]
2024-10-01 stm32 started, footprints updated, lazout started
    [PRODIGY-STM32.kicad_pcb, PRODIGY-STM32.kicad_sch, connector2.kicad_sch, connectors.kicad_sch, mcu.kicad_sch, st_link.kicad_sch]
2024-10-09 stm32 layout done, schematic swd coinnector updated
    [PRODIGY-STM32.kicad_pcb, st_link.kicad_sch]
2024-10-14 stlink wiring done, power vias placed, anlog routing almost done
    [PRODIGY-STM32.kicad_pcb, st_link.kicad_sch]
2025-03-09 v0.1.1 schematic and pcb updated. gerbers exported, ready for production
    [PRODIGY-MOTHERBOARD.kicad_sch, analog.kicad_sch, bom.csv, can.kicad_sch, designators.csv, digital.kicad_sch, esp32.kicad_sch, filter.kicad_sch]
